fernandosegrr/fsi_proyect/docs/imagenes/foto_04_carro_perspectiva.jpg

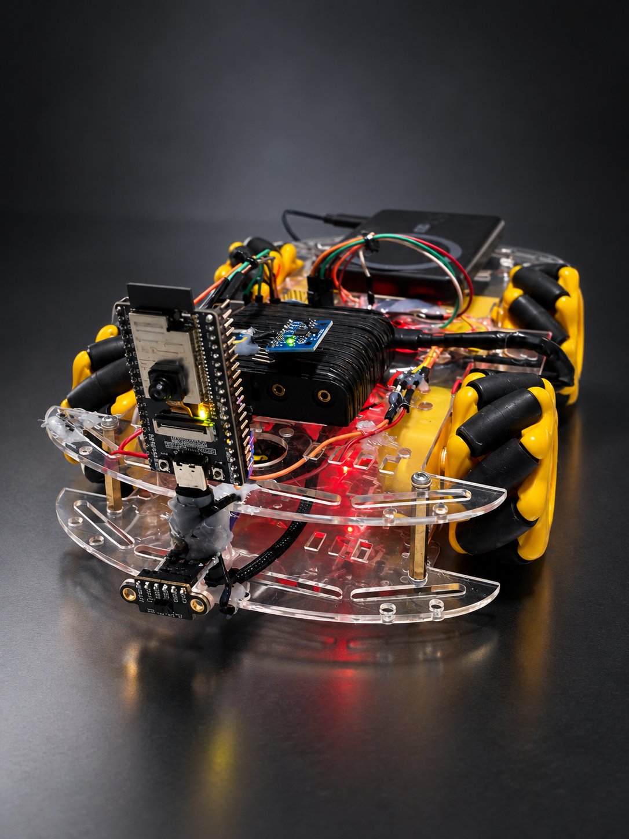
docs/imagenes/foto_04_carro_perspectiva.jpg
