fernandosegrr/fsi_proyect/docs/imagenes/foto_02_carro_lateral.jpg

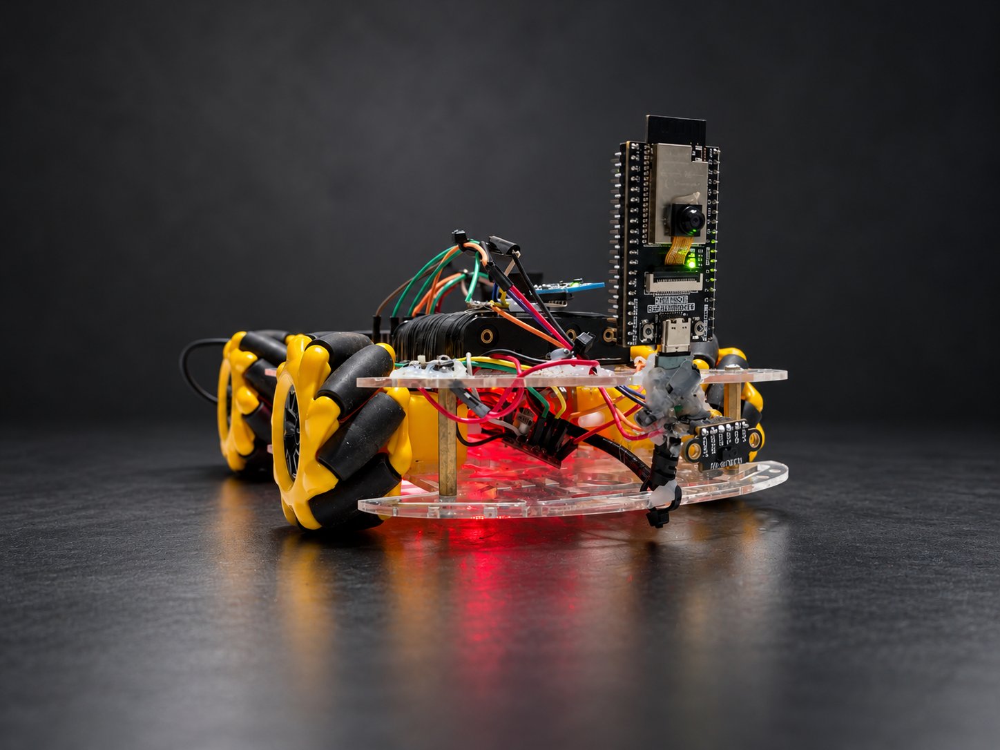
docs/imagenes/foto_02_carro_lateral.jpg
