fernandosegrr/fsi_proyect/docs/estado_20261113.md

# Estado al 14-nov-2026 — rama `feat/autonomo-v2`

**SIMULADO / NO MEDIDO en el carro.** El carro no se movió. No se instaló la APK ni se grabó firmware. `main` y el tag `v1.1` (`bd1727b`) no se tocaron. No es v1.2. (El archivo conserva el nombre del 13-nov, día en que se abrió; se actualizó el 14 con la revisión independiente.)

## Qué hay en la rama

| Commit | Contenido | Evidencia |
|---|---|---|
| `af3737b` | Banco con mundo sintético y compuertas | Pruebas en PC |
| `f959742` | Navegador v2: rodeo medido, mirada, vistazo, coincidencia con consenso | SIMULADO |
| `7323905` | Firmware del carro `SEG=2` | Compilado; pruebas en PC; **no grabado** |
| `afcc499` | Caja negra, telemetría numérica de visión, salud del detector | Compilado (APK); **no instalado** |
| `af786c7` | Firmware de la cámara `cam-v2` | Compilado; **no grabado** |
| `5d009e0` | Documentos, manual y protocolo de prueba física | — |
| `3bd9100` | Correcciones de la revisión independiente (2 altas, 3 medias, 3 bajas), dos escenarios nuevos y pruebas | SIMULADO (1000 corridas × 23 escenarios × 3 versiones) |
| siguiente | Estos documentos, tablas del banco y manual en PDF | — |

Documentos: [auditoría](auditoria_autonomo_v2.md), [diseño](autonomo_v2_diseno.md), [límites](limites_conocidos.md), [protocolo de prueba física](protocolo_prueba_fisica_autonomo_v2.md), [plantilla CSV](pruebas_fisicas_plantilla.csv).

## Verificación de software

| Comando | Resultado |
|---|---|
| `make -C nucleo_c test` | 24 ejecutables, 1884 casos, 0 fallos |
| `make -C pruebas_firmware test` | 564 casos, 0 fallos |
| `python probar_servidor_falso.py` (desde `pruebas_firmware/`) | 60 casos, 0 fallos |
| `python scripts/probar_version.py` | OK |
| `scripts/compilar_app.ps1` | COMPILACION OK |
| `arduino-cli compile --fqbn esp32:esp32:esp32 firmware_carro` | 1 034 526 bytes (78 %) |
| `arduino-cli compile --fqbn esp32:esp32:esp32wrover camara_prueba` | 1 084 349 bytes (82 %) |
| `python scripts/compuertas_autonomo.py --corridas 1000` | **19 compuertas en rojo** (abajo) |
| `python scripts/comparar_esquives.py --corridas 1000` | **4 de 6 en rojo** por 1 mm de media |

## Banco: antes y después (SIMULADO)

Tabla completa por escenario en el [diseño](autonomo_v2_diseno.md#5-resultados-riesgos-y-límites) y en [precision/autonomo_v2_comparacion.txt](precision/autonomo_v2_comparacion.txt).

- **Pasan con 1000 de 1000 y cero contactos (16 escenarios):** piso limpio, juntas, cambio de exposición y cajas inventadas por la red (sin una sola parada); manchas de sol, sombras y reflejos (sin esquives ni ayudas, con paradas momentáneas); caja 20 × 20, objeto de 90 cm, pared tras el final, **dos obstáculos**, pasillo, objeto que aparece, caja con sol, batería baja y **caja antes de una esquina**. Además, pared al frente: se detiene y pide ayuda con causa 16 en las 1000.
- **Mejoran pero no pasan:** caja corrida de lado (998, 2 contactos; partida 663 y 337), objeto bajo (997, 1 contacto; partida 990 y 4), banquito (765; partida 17), silla (316; partida 39).
- **Peor que la partida en algo:** contactos de la silla (34 contra 12); ayudas del banquito y de la silla (58 y 64 contra 0); caja con pared pegada a un lado (615 ok y 385 ayudas contra 632 y 210, pero 2 contactos contra 216); error lateral final del Monte Carlo heredado (18/44 contra 17/40 mm).

## Qué falta

- **VALIDAR EN EL CARRO**: todo. Empezar por el bloque A y B1 del protocolo.
- **PENDIENTE de diseño a código**: bloqueo de exposición de la cámara, aprendizaje continuo del piso, calibración fila–distancia, odometría fusionada, acelerómetro, giro fino por pulsos, mapa local. Razones en el diseño.
- **PENDIENTE en la app**: exponer las banderas de precaución y de vistazo; avisar cuando el umbral o las celdas de Visión dejan ciego al detector de color; mostrar el motivo cuando una ruta se cancela a mitad.
- **APAGADO tras probarlo**: deshacer el giro y rodear por el otro lado cuando el láser descubre una pared al empezar a girar (`NAV_DESHACER_GIRO_MAX`).
- **NO MEDIDO**: pivote izquierdo; campo, altura e inclinación de la cámara; alcance del láser contra una pared de lado; respuesta del control de rumbo a un cambio de 10–16°; si el láser ve el banquito y la silla reales; recall del detector con muebles vistos desde 11 cm de altura; deriva de la exposición de la cámara; si la cámara distingue una pared del piso; cuánto tarda en detenerse un giro cuando la guardia lo corta.
