fernandosegrr/fsi_proyect/docs/estado_20261110.md

# Diagnóstico de Estado del Repositorio — 10 de noviembre de 2026

## 1. Ubicación física, worktrees, ramas, tags y cambios sin confirmar

- **Directorio del repositorio:** `E:\Dev\fsi_proyecto` (la unidad indicada como `D:` en el encargo corresponde a `E:` en esta PC; `D:\Dev\fsi_proyecto` no existe).
- **Worktrees (`git worktree list`):** Único worktree activo en `E:/Dev/fsi_proyecto`.
- **Árbol de trabajo y stashes:** Árbol limpio (`nothing to commit, working tree clean`), cero stashes (`git stash list` vacío).
- **Estado de `HEAD` al iniciar la sesión:** Estaba en la rama local `main` (`c6ee161`), porque justo antes de iniciar (`HEAD@{0}` en reflog) se ejecutó `git checkout main` desde `j16-precision`. Para trabajar sobre el código auditado y modificado en J16 sin fusionar a `main`, se cambió a `j16-precision` (`6d1b213`).
- **Archivos locales excluidos en `.git/info/exclude`:**
  - `dist/firmware_carro_453ed20-20261027.bin` (1,031,712 bytes)
  - `dist/firmware_carro_873bfb9-20261031.bin` (1,034,112 bytes)
  - `firmware_carro/secretos.h` y `original_backup/` están en `.gitignore` y no se leen ni se tocan.
- **Etiquetas (`git tag`):**
  - `v1.0` → `eb88151` ("Entrega J14 - Carro FSI - 27 de octubre de 2026"). Intacta.
- **Ramas locales y remotas (`git branch -a -vv`):**
  - `j16-precision` (`6d1b213`, sincronizada con `origin/j16-precision`): contiene las 3 rondas de J16 (9 commits sobre `5d5c628`).
  - `main` local (`c6ee161`, 9 commits detrás de `origin/main` en `5d5c628`): contiene J15 (`deae8b6`) más fusiones de documentación e imágenes hasta `c6ee161`.
  - `origin/main` (`5d5c628`): contiene `c6ee161` más 9 commits adicionales de documentación (`docs/manual/*` y `docs/figuras/v2/*`).
  - Ramas de documentación (`docs/documentacion-completa` `1784804`, `docs/imagenes-manual` `c7ac702`, `docs/revision-imagenes` `4849fd7`, `origin/docs/manual-v2` `8cb1522`, `origin/docs/manual-referencia-archivos` `00e1415`): ya integradas en `origin/main` (`5d5c628`).
  - Ramas históricas previas a `v1.0`: `j14-seguridad-b2` (`8af8d08`), `j14-wip-20261027` (`af0bfb5`), `investigacion/comparativa-detectores` (`d638ed4`), `origin/copilot/fsi-proyect` (`7316383`).

### Historial de commits de J16 (`origin/main` `5d5c628` .. `j16-precision` `6d1b213`)

1. `d823a63` — J16: precisión de navegación (`RUMBO` en firmware, núcleo, app y simulador) [Ronda 1, código]
2. `3c9ebcf` — J16: entrega del candidato (APK `d823a63` en `dist`), plan de pruebas y documentación [Ronda 1, docs/dist]
3. `79ef808` — J16: registrar sanitizadores en verde y límite del objetivo de `RUMBO` [Ronda 1, cierre]
4. `097008d` — J16: segunda ronda (rumbo con décimas, aviso `WD`, enlace mudo, `TOF_PARO`, candado) [Ronda 2, código]
5. `0d1d4c1` — J16: entrega de la segunda ronda (APK `097008d` en `dist`, reporte y plan) [Ronda 2, docs/dist]
6. `b774c17` — J16: registrar el CI en verde de la segunda ronda [Ronda 2, cierre]
7. `873bfb9` — J16: corrección de escala del giroscopio (`IMU_ESCALA`) [Ronda 3, código]
8. `70fa4a5` — J16: entrega de la tercera ronda (APK `873bfb9` en `dist`, reporte y plan) [Ronda 3, docs/dist]
9. `6d1b213` — J16: registrar el CI en verde de la tercera ronda [Ronda 3, cierre]

---

## 2. Diff de lo cambiado contra J15 (`074c9fd`) y contra `main` (`c6ee161` / `origin/main` `5d5c628`)

Entre `074c9fd` (código de J15) y `origin/main` (`5d5c628`) **no hubo ningún cambio de código** en `nucleo_c/`, `firmware_carro/`, `app_android/`, `pruebas_firmware/` ni `scripts/`: solo se empaquetó la APK de J15 (`carro_fsi_0.4-074c9fd.apk`) y se agregaron manuales, figuras y documentos temáticos en `docs/` y `README.md`.
Entre `main` local (`c6ee161`) y `origin/main` (`5d5c628`) solo cambiaron 46 archivos de documentación (`docs/manual/*`, `docs/figuras/v2/*`, `LICENSE`, `README.md`, `docs/README.md`).

Todos los cambios funcionales de J16 están entre `origin/main` (`5d5c628`) y `j16-precision` (`6d1b213`), abarcando **64 archivos (+4086 / -136 líneas)**. Resumen archivo por archivo por subsistema:

### 2.1 Núcleo en C (`nucleo_c/`)
- `nucleo_c/navegador.h` (+45/-1):
  - Sube `NAV_PASO_MARGEN_MM` de 100 a 150 mm (conserva `NAV_PASO_MARGEN_J15_MM = 100` bajo bandera `sin_margen_paso_j16`).
  - Define constantes para `RUMBO` del firmware (`NAV_RUMBO_MIRA_MM = 400`, `NAV_RUMBO_MIRA_MIN_MM = 150`, `NAV_RUMBO_CORR_MAX = 12`, `NAV_RUMBO_FW_SIN_GIRO = 8`, `NAV_RUMBO_FW_CAMBIO_X10 = 3`, `NAV_RUMBO_FW_MIN_MS = 100`, `NAV_RUMBO_PUNTO_MIN_MM = 150`, `NAV_OVERRIDE_TOL_MM = 30`).
  - Añade campos a `Navegador`: `rumbo_x10`, `base_rumbo_x10`, estado y objetivos de `rumbo_fw`, geometría de línea del paso actual (`paso_en_linea`, `linea_ax_mm`, `linea_ay_mm`, `linea_rumbo`, `linea_fin_s_mm`, `paso_apunta`, `paso_fin_x_mm`, `paso_fin_y_mm`), banderas de prueba/reversión (`sin_volver_a_linea`, `rumbo_en_vuelta`, `sin_margen_paso_j16`, `sin_trig_fino`, `sin_arreglo_dt_giro`) y `descartar_dt`.
  - Declara `navegador_poner_rumbo_fw` y `navegador_tomar_rumbo_fw`.
- `nucleo_c/navegador.c` (+367/-15):
  - Trigonometría e inversa con décimas de grado (`seno_mil_x10`, `dir_x_mil_x10`, `dir_y_mil_x10`, `grados_de_cociente_x10`, `rumbo_del_vector_x10`).
  - `calcular_avance_medido`: proyecta incrementos con décimas de grado (`dir_*_mil_x10`) salvo `sin_trig_fino = 1`, y actualiza `rumbo_x10`.
  - `respetar_grados`, `sincronizar_rumbo`, `rumbo_tras_giro_x10`: con `RUMBO` activo conserva `rumbo_x10` (décimas, 0..3599) entre comandos y redondea `rumbo_grados`; sin `RUMBO` mantiene grados enteros como en J15.
  - `planificar`: corrige recta con `override_largo_mm > 0` para que no termine prematuramente al replanificar con `indice_objetivo > 1` tras un esquive, suma `cal.frenado_mm` si viene avanzando, salta puntos de ruta ya pasados, recorta `avance_mm` al largo fijo restante y con rumbo medido planifica celda por celda. Con `RUMBO` activo suprime giros parados de corrección menores o iguales a `NAV_RUMBO_FW_SIN_GIRO` (8°).
  - `calcular_fin_obstaculo`: usa `NAV_PASO_MARGEN_MM` (150 mm) salvo `sin_margen_paso_j16`.
  - `rumbo_deseado_x10` y `rumbo_fw_actualizar`: calcula el objetivo `RUMBO:<n>` (apuntando 400 mm adelante sobre la línea con tope de ±12°, o al punto final en diagonal, o paralelo a la línea en `NAV_FASE_PARALELO`) y lo convierte a la convención del firmware (`+` izquierda).
  - `navegador_aporte_giro` y `navegador_aporte_imu`: activan `descartar_dt = 1` cuando un giro por ángulo cae a giro por tiempo entre dos ticks, evitando sumar un `dt` en que el carro estuvo quieto.
- `nucleo_c/calgiro.h` (+16) y `nucleo_c/calgiro.c` (+28):
  - Añaden `calgiro_escala(medido_x10, escala_ppm, &vueltas, &error_ppm, &nueva_ppm)` para calcular la corrección de escala del giroscopio en ppm a partir de vueltas completas alineadas con una línea, compuesta con la escala previa y acotada a ±50,000 ppm (±5 %).
- `nucleo_c/simulador_navegador.h` (+50) y `nucleo_c/simulador_navegador.c` (+299/-14):
  - Añaden el modelo físico J16 (`sim_j16_activar`): arranque a plena potencia 255/255 por 250 ms, zona muerta de PWM, constante de tiempo de motor (`j16_tau_motor_ms`), integración en pasos de 10 ms con centésimas de grado, réplica exacta de `rumbo.c`, escala del giroscopio en `%` y `ppm`, sesgo residual en mdps, latencia de `SENS` y cola de latencia de comandos.
  - Corrigen reinicio de desplazamiento de pivote entre dos `GIRAR` seguidos y retención de `LEFT`/`RIGHT` en el tick en que `IMU?` cae a giro por tiempo.
- `nucleo_c/Makefile` (+15/-3):
  - Agrega el ejecutable `pruebas_precision_j16` a `all` y `test` (150 corridas) y el target `make precision` (1000 corridas).

### 2.2 Firmware del carro (`firmware_carro/`)
- `firmware_carro/rumbo.h` (+68, nuevo) y `firmware_carro/rumbo.c` (+172, nuevo):
  - Controlador PI en enteros de 32/64 bits para sostener el rumbo al avanzar (`rumbo_iniciar`, `rumbo_empezar`, `rumbo_terminar`, `rumbo_poner_objetivo`, `rumbo_corregir`, `rumbo_repartir`, `rumbo_leer_numero`).
  - Recorta objetivo a ±20.0° del ángulo inicial del avance, se inhibe si `|error| > 30.0°`, aplica anti-windup al término integral y conserva el término integral aprendido (`aprendido_mil`) entre avances en RAM.
- `firmware_carro/config.h` (+21):
  - Define `IMU_ESCALA_MAX_PPM = 50000`, constantes `RUMBO_KP_MIL_GRADO = 10`, `RUMBO_TI_MS = 1500`, `RUMBO_MAX_MIL = 150`, `RUMBO_MAX_OBJETIVO_X10 = 200`, `RUMBO_ERROR_MAX_X10 = 300`, `RUMBO_DT_MAX_MS = 50` y `GIRO_LARGO_POR_GRADO = 1`.
- `firmware_carro/carro.h` (+2) y `firmware_carro/carro.c` (+125/-2):
  - Integra `rumbo` en `avanzar`, `retroceder`, `girar_izquierda`, `girar_derecha`, `carro_pivote`, `carro_detener` y `carro_vigilar_comunicacion`.
  - Procesa `RUMBO:ON` (`ACK_RUMBO:1`), `RUMBO:OFF` (`ACK_RUMBO:0`), `RUMBO:<n>` (sin respuesta) y `RUMBO?` (`RUMBO:<enc>,<marcha>,<obj>,<corr>,<apr>`), sin renovar el watchdog ni alterar `comando_actual`.
  - Apaga `RUMBO` al arrancar y al conectar/desconectar cliente (`rumbo_apagar_al_conectar`), pero no cuando el láser frena con `__STOP_AUTO`.
  - Lleva cuenta de frenadas por watchdog en `frenos_watchdog` (`carro_frenos_watchdog()`).
- `firmware_carro/giro.c` (+19/-7):
  - Con `GIRO_LARGO_POR_GRADO = 1`, normaliza la duración del giro en ms por cada 100° y solo evalúa/guarda en el historial de `giro_largo` los giros de al menos `GIRO_ANT_MIN_GRADOS` (30°).
- `firmware_carro/imu.h` (+5) y `firmware_carro/imu.c` (+31/-1):
  - Añaden `escala_ppm` (`imu_poner_escala_ppm`, `imu_escala_ppm`) y escalan la velocidad angular sin sesgo ni zona muerta por `(1000000 + escala_ppm) / 1000000` con redondeo al entero más cercano antes de integrar el ángulo y calcular `velocidad_x10`.
- `firmware_carro/hw_sensores.h` (+4) y `firmware_carro/firmware_carro.ino` (+19):
  - Declaran e implementan `hw_imu_escala_leer` y `hw_imu_escala_guardar` en NVS (`Preferences` namespace `"carro"`, clave `"imuEscala"`).
- `firmware_carro/sensores.h` (+3) y `firmware_carro/sensores.c` (+52/-3):
  - `CAPS` incluye `RUMBO=1,IMUS=<ppm>`.
  - `sensores_iniciar` lee `imuEscala` de NVS y la aplica si está en `[-50000, 50000]`.
  - `revisar_watchdog` envía `WD:<n>` por WebSocket y serie cada vez que `carro_frenos_watchdog()` incrementa.
  - Atiende `IMU_ESCALA?` (`IMU_ESCALA:<ppm>`) e `IMU_ESCALA:<ppm>` (`ACK_IMU_ESCALA:<ppm>` y reenvío de `CAPS`, o `NAK_IMU_ESCALA` si está fuera de rango, en marcha o girando).

### 2.3 App Android y puente JNI (`app_android/`)
- `app_android/app/src/main/cpp/puente.c` (+77/-5):
  - Protege `ultimo_*`, `ultimo_no_piso`, `mascara_vision_global` y `mascara_vision_activa` con `pthread_mutex_t candado_vision`.
  - Guarda `largo_recta_global` y `rumbo_fw_global` y los reaplica en `cargarRuta` después de `navegador_iniciar` (corrige pérdida del largo de 1500 mm en «Recta 150 cm»).
  - Añade funciones JNI `CalGiroNativa.escala`, `NavegadorNativa.ponerRumboFw` y `NavegadorNativa.tomarRumboFw`.
- `app_android/app/src/main/java/com/fsi/carro/Ajustes.kt` (+7/-1) y `SesionCarro.kt` (+1):
  - Añaden preferencia `usarRumbo` (`"usar_rumbo_fw"`, `true` por defecto) y la sincronizan con `ControlLogica`.
- `app_android/app/src/main/java/com/fsi/carro/CalGiroNativa.kt` (+14) y `NavegadorNativa.kt` (+8):
  - Declaraciones `external` de `escala`, `ponerRumboFw` y `tomarRumboFw`.
- `app_android/app/src/main/java/com/fsi/carro/CalibracionGuardada.kt` (+6/-2), `EjecutarRutaFragment.kt` (+9/-2) y `Mensajes.kt` (+6):
  - `aplicarAlNavegador()` devuelve `Boolean`; si el navegador rechaza la calibración guardada, `EjecutarRutaFragment` muestra el aviso `Mensajes.calibracionRechazada()` al pasar a `CONFIRMAR`.
- `app_android/app/src/main/java/com/fsi/carro/ControlLogica.kt` (+126/-5):
  - Lee `RUMBO=1` e `IMUS=<ppm>` de `CAPS:`.
  - Añade `rumbo()`, `rumboObjetivo()`, `pedirRumbo()` y `enviarEscalaImu()` (con timeout y confirmación por `ACK_IMU_ESCALA:<ppm>`).
  - En `TOF_PARO:`, si `CORTAR_HEARTBEAT_EN_TOF_PARO` es `true` y `comandoActivo == "FORWARD"`, detiene el heartbeat y limpia `comandoActivo`.
  - Procesa `WD:<n>`, `ACK_RUMBO:`, `RUMBO:`, `ACK_IMU_ESCALA:`, `IMU_ESCALA:` y `NAK_IMU_ESCALA`.
  - En `IMU:`, solo invoca `alImu` si el estado del giroscopio (campo 2) es `null` o `2` (listo).
- `app_android/app/src/main/java/com/fsi/carro/ModoSemiautonomo.kt` (+73/-8):
  - Reconoce rutas predefinidas verificando `it.celdas.contentEquals(ruta)` además del nombre/id.
  - Activa `RUMBO:ON` al iniciar ruta si `logica.rumboActivo` y envía objetivos `RUMBO:<n>` tras cada comando; al terminar o cancelar pide `RUMBO?` y envía `RUMBO:OFF`.
  - Con `VIGILAR_CARRO_J16 = true`, cancela la ruta si pasan más de `SILENCIO_SENS_MS` (1500 ms) sin `SENS` (cuando `capsGiroscopio != null`), si llega `WD:<n>`, o si tras `TOF_PARO` el navegador sigue pidiendo `CMD_FORWARD`.
  - Mueve `registrarEsquive()` y `registrarDiagnostico()` para ejecutarse después de enviar el comando del tick.
- `app_android/app/src/main/java/com/fsi/carro/SensoresActivity.kt` (+169/-3), `res/layout/activity_sensores.xml` (+96) y `res/values/textos_sensores.xml` (+9):
  - Añaden interruptor «Sostener el rumbo al avanzar (firmware J16)», línea de estado de `RUMBO` y tarjeta «Escala del giroscopio (J16)» con flujo de 3 pasos (Empezar con verificación de carro quieto en 400 ms, Terminé tras vueltas completas en menos de 2 min, Guardar en el carro y Quitar la corrección).

### 2.4 Pruebas, scripts, CI y `dist/`
- `nucleo_c/pruebas_calgiro.c` (+39): 11 casos nuevos para `calgiro_escala` (incluyendo propiedad de 20,000 casos aleatorios).
- `nucleo_c/pruebas_precision_j16.c` (+782, nuevo): Parte A (réplica de `RUMBO` vs `firmware_carro/rumbo.c`, 3 casos), Parte B (8 propiedades de pose con 9 casos), Parte C (Monte Carlo en 10 escenarios × 5 configuraciones y 34 comprobaciones de no regresión / mejora; total 46 casos).
- `pruebas_firmware/pruebas_rumbo.c` (+479, nuevo) y `pruebas_firmware/Makefile` (+13/-4): 62 casos del controlador `rumbo.c`, su integración con `carro.c` y el filtro `giro_largo`.
- `pruebas_firmware/pruebas_sensores.c` (+144/-6), `sensores_falsos.c` (+6), `sensores_falsos.h` (+2): 6 casos del aviso `WD:<n>`, 25 casos de `IMU_ESCALA` y actualización de 3 casos de `CAPS?`.
- `pruebas_firmware/pruebas_carro.c` (+16/-5): corrige condición de carrera del arnés en `prueba_estres_dos_hilos` (espera 2 vueltas completas de `loop()` en `paso_a_paso` y `GIRO_ASENTAR_MS / 50 + 5` vueltas al cierre).
- `pruebas_firmware/servidor_falso.py` (+40/-5) y `probar_servidor_falso.py` (+24/-1): soporte para `WD:<n>`, `IMUS`, `IMU_ESCALA`, `IMU_ESCALA?` y `SIM_ANGULO` con `--sensores` (8 casos nuevos: de 46 a 54).
- `scripts/verificar_version.py` (+39) y `scripts/probar_version.py` (+53): modo `--solo-archivo` sin teléfono ni puerto serie y 5 pruebas unitarias nuevas (de 13 a 18).
- `.github/workflows/sanitizadores.yml` (+15/-2): añade `rumbo.c` a los pasos existentes y agrega pasos ASan+UBSan para `pruebas_rumbo` y `pruebas_precision_j16 300`.
- `dist/`: reemplaza `carro_fsi_0.4-074c9fd.apk` por `carro_fsi_0.4-873bfb9.apk` (14,520,520 bytes, SHA-256 `50179013BCB18029F6C1BCBFE737F59A9B14B49B7BE848E002D67C119433C15B`) y actualiza `SHA256SUMS.txt`, `LEEME.txt`, `README.md` y `FIRMWARE_LOCAL.txt`.

---

## 3. Qué se declaró hecho, qué evidencia hay y qué NO tiene evidencia

### 3.1 Declarado hecho CON evidencia documental/código en el repositorio (por re-ejecutar y verificar en Fase 2 y 3)
1. **Correcciones e implementaciones en código (`d823a63`, `097008d`, `873bfb9`):**
   - `RUMBO` en firmware y núcleo, `rumbo_x10` continuo con `RUMBO`, `IMU_ESCALA` en firmware/núcleo/app, arreglo de largo fijo de «Recta 150 cm» en JNI y `planificar`, holgura de paso de 150 mm, `descartar_dt` al caer a giro por tiempo, filtro `giro_largo` por grado, `WD:<n>`, corte de heartbeat en `TOF_PARO`, vigilancia de enlace mudo (`1.5 s` sin `SENS`), candado `candado_vision` en `puente.c`.
   - **Evidencia:** commits en `j16-precision`, pruebas unitarias en `nucleo_c/` (declarados 22 programas / 1655 casos) y `pruebas_firmware/` (declarados 540 casos), `probar_servidor_falso.py` (54 casos), `probar_version.py` (18 casos), registros en `docs/precision/monte_carlo_1000.txt` y `docs/precision/calibracion_j14.txt`.
2. **Compilación local de artefactos candidatos de la 3ª ronda (`873bfb9`):**
   - APK `dist/carro_fsi_0.4-873bfb9.apk` (14,520,520 bytes) y binario local no publicado `dist/firmware_carro_873bfb9-20261031.bin` (1,034,112 bytes).
   - **Evidencia:** archivos presentes en `dist/` (se verificará su compilación limpia y hashes en Fase 3).
3. **Corrección documental sobre la ruta en L de J14:**
   - La ruta en L predefinida (`RutasPredefinidas.kt`) termina en `(7,1)`, que corresponde a `y = 200 mm`, por lo que las poses estimadas de J14 B5 (`y = 209, 203, 244 mm`) tenían un error estimado respecto de su línea de `9, 3 y 44 mm`, no de `20 a 24 cm`.
   - **Evidencia:** verificado en el código de `RutasPredefinidas.kt` y `pruebas_precision_j16.c`.

### 3.2 Afirmaciones SIN evidencia física o NO probadas todavía
1. **Mejora real de precisión en el carro físico con `RUMBO`, `rumbo_x10`, `IMU_ESCALA` y holgura de 150 mm:**
   - **Sin evidencia física (`NO MEDIDO`):** Todos los números de precisión de J15 y J16 provienen exclusivamente del simulador en PC (`SIMULADO`). Las ganancias `RUMBO_KP_MIL_GRADO = 10` y `RUMBO_TI_MS = 1500` nunca se han probado con los motores reales ni en el piso real; no se sabe si zigzaguean o si el deslizamiento lateral mecanum domina.
2. **Calibración de escala del giroscopio (`IMU_ESCALA`) y su supuesto de ±0.3 % de residuo:**
   - **Sin evidencia física (`NO MEDIDO`):** El residuo de ±3000 ppm (±0.3 %) tras alinear el carro a mano antes y después de dos vueltas completas es un supuesto del simulador, no una medición en pista. Tampoco se ha probado la tarjeta «Escala del giroscopio» en el teléfono conectado al carro.
3. **Calibración del simulador J16 contra el carro real:**
   - **Evidencia parcial / limitada:** El desbalance del simulador (0.3 % a 2.1 %) se ajustó con solo 4 rectas medidas en J14 (B4: 5.5, 15, 18 y 20 cm) y 1 corrida de esquive medida a ojo (B6-4: ~40 cm, que cae en el percentil 99 del simulador). La dispersión del pivote (±15 %) y el error de escala inicial (±1 %) son supuestos no medidos.
4. **Error físico real de la ruta en L (B5):**
   - **Sin evidencia numérica (`NO MEDIDO`):** En J14 B5 no se midió con cinta la posición final del carro (solo hubo apreciación visual «relativamente bien» y registro de la pose estimada por el navegador).
5. **Validación en el teléfono y en la ESP32 del código J16 (`873bfb9`):**
   - **Sin evidencia en hardware (`NO MEDIDO`):** Ni el firmware `FW:873bfb9-20261031` se ha cargado en la ESP32 ni la APK `APP:0.4-873bfb9` se ha instalado o ejecutado en el teléfono. Tampoco existen pruebas instrumentadas de UI en Kotlin para las nuevas funciones de `SensoresActivity`, `EjecutarRutaFragment`, `ModoSemiautonomo` y `ControlLogica`.
6. **Pruebas físicas pendientes desde J14/J15/J16:**
   - Esquive B6 con criterio 5/6 sin tocar caja y error lateral < 25 cm: **NO MEDIDO** (en J15 y J16 se hicieron 0 corridas físicas).
   - B7 (comparación pareada de autoridad del láser a ~100 cm), B8 (caja lateral a 25 cm), B9 (corte de WiFi en marcha), B2 (calibración del giro con giroscopio en el carro), J10c con caja ancha real (40×20 cm), y el plan P0–P12 de J16 (`docs/precision/plan_pruebas.md`): **NO MEDIDOS**.

---

## 7. Lista consolidada de pruebas físicas pendientes (ordenadas de menor a mayor riesgo)

Consolidada a partir de `docs/precision/plan_pruebas.md`, `docs/reporte_J13.md`, `docs/reporte_J14.md`, `docs/reporte_J15.md`, `docs/reporte_J16.md`, `docs/bitacora.md` y `docs/limites_conocidos.md`:

1. **P0 / P2 / B0 — Verificación en `Sensores` con carro conectado por WiFi (Riesgo: Nulo, sin movimiento)**
   - **Qué se prueba:** Con la ESP32 alimentada por powerbank y el teléfono en la red `CarroFSI`, comprobar en `Sensores`: `FW:6d1b213-20261110`, `App 0.4 (6d1b213)`, `CAPS` con `RUMBO=1` e `IMUS=0`, giroscopio `LISTA`, láser `LISTO`, `Autoridad del láser` encendida, interruptor `Sostener el rumbo al avanzar` encendido y `Corrección en uso: +0 ppm`.
   - **Criterio:** Versiones coincidentes, ambos sensores listos y `RUMBO=1`.

2. **P6 — Escala del giroscopio a mano y bloques de 4 giros de 90° en el lugar (Riesgo: Muy bajo)**
   - **Qué se prueba:** (a) En la tarjeta `Escala del giroscopio` de `Sensores`, medir 3 veces sin guardar (2 vueltas completas a mano en el piso sin levantar el carro, alineando con la cinta al inicio y al final) y en la 4.ª guardar (`IMU_ESCALA`). (b) Ejecutar en `Sensores` un bloque de 4 giros de `90°` a la izquierda y otro de 4 giros de `90°` a la derecha (`360°` por bloque) antes y después de guardar la escala.
   - **Criterio:** Las 3 mediciones dentro de `±3000 ppm` entre sí; `CAPS` reporta `IMUS=<ppm>`; tras cada bloque de 4 giros el carro queda paralelo a la cinta dentro de `±2°` (o `±3°` por giro).

3. **P3 — Primera recta corta de 100 cm con `RUMBO` (Riesgo: Bajo)**
   - **Qué se prueba:** Ruta `Recta 100 cm` (`recta_100`) con `Sostener el rumbo al avanzar` encendido, 2 corridas en pista despejada.
   - **Criterio:** Sin zigzag visible ni tirones, y desvío lateral final `< 5 cm` (simulación: media `0.8 cm`, p95 `1.9 cm`, máx `2.7 cm`).

4. **P1 / P4 — Recta de 150 cm y comparación pareada con y sin `RUMBO` (Riesgo: Bajo)**
   - **Qué se prueba:** Ruta `Recta 150 cm` (`recta_150`), alternando `Sostener el rumbo al avanzar` APAGADO y ENCENDIDO (5 corridas apagado y 5 encendido con las mismas pilas; las corridas con `RUMBO` apagado cubren también P1).
   - **Criterio:** Largo medio entre `145` y `155 cm` (verifica que ya no recorre los `160 cm` de J14); con `RUMBO` encendido, desvío lateral medio `≤ 6 cm`, ninguno `> 10 cm`, y media con `RUMBO` a la mitad o menos que sin `RUMBO` (simulación: sin `RUMBO` `7.4 cm` media; con `RUMBO` `1.0 cm` media, p95 `2.6 cm`).

5. **P5 — Recta larga de 200 cm con `RUMBO` sin obstáculo (Riesgo: Bajo-medio)**
   - **Qué se prueba:** Ruta `Recta 200 cm` (`recta_200`) sin caja en pista despejada con `RUMBO` encendido, 3 corridas (sirve también como línea base previa de 200 cm de J15).
   - **Criterio:** Desvío lateral final `≤ 8 cm` (simulación: media `1.4 cm`, p95 `3.3 cm`, máx `4.9 cm`).

6. **P7 / B5 — Ruta en L (`100 cm` + giro `90°` derecha + `100 cm`) medida con cinta (Riesgo: Medio)**
   - **Qué se prueba:** Ruta `En L (derecha)` (`en_l`), 3 corridas con `RUMBO` encendido (y opcionalmente 3 sin `RUMBO`), midiendo con cinta la distancia real al segundo tramo (`y = 20 cm`) y al punto final `(80, 20) cm`.
   - **Criterio:** Con `RUMBO`, distancia del centro al punto final `≤ 8 cm` (simulación con escala calibrada: media `3.4 cm`, p95 `6.8 cm`).

7. **P8 — Cuadrado cerrado de 60 cm por lado (Riesgo: Medio)**
   - **Qué se prueba:** Ruta dibujada en el editor de `(2,6)` a `(2,3)`, `(5,3)`, `(5,6)` y regreso a `(2,6)` (4 tramos de `60 cm` y 3 giros de `90°`), 3 corridas con `RUMBO`.
   - **Criterio:** Distancia del centro al punto de salida `≤ 10 cm` (simulación con escala calibrada: media `2.1 cm`, p95 `4.3 cm`).

8. **B8 — Caja lateral a 25 cm fuera del carril (Riesgo: Medio)**
   - **Qué se prueba:** Recta con la caja colocada a `25 cm` a un lado del eje de la cinta (fuera del paso físico del chasis), con `Autoridad del láser` encendida y apagada.
   - **Criterio:** `0` toques, `0` falsos paros por láser y `0` esquivas innecesarias.

9. **P12 (opcional) — Freno del láser ante caja frontal a 60 cm (Riesgo: Medio-alto)**
   - **Qué se prueba:** Ruta `Recta 100 cm` con una caja centrada a `60 cm` de la salida y el láser activo.
   - **Criterio:** El carro frena o esquiva sin tirones; el registro muestra `TOF_PARO` seguido de la decisión del navegador y ningún `FORWARD` repetido tras el freno.

10. **B6 / P9 / B7 — Esquive con caja de 20×20 cm a ~100 cm en `Recta 200 cm` (Riesgo: Medio-alto)**
    - **Qué se prueba:** Ruta `Recta 200 cm` (`recta_200`) con caja de `20×20 cm` centrada en la cinta a `~100 cm` de la marca de salida:
      - **B6 (criterio mínimo de validación J15):** Al menos **5 de 6 corridas** sin tocar la caja y con error lateral final **menor a 25 cm**.
      - **P9 (criterio J16 con `RUMBO`):** 5 corridas con `RUMBO` encendido (más 2 sin `RUMBO` para comparar), buscando `0` toques, `0` ayudas y desvío lateral final `≤ 8 cm` (simulación: media `1.7 cm`, p95 `4.0 cm`, máx `6.3 cm`).
      - **B7 (comparación pareada de Autoridad del láser a ~100 cm):** Comparar 3 corridas con Autoridad del láser encendida frente a 3 con Autoridad apagada.

11. **J10c / P10 — Esquive con caja ancha de 40×20 cm a ~100 cm en `Recta 200 cm` (Riesgo: Alto)**
    - **Qué se prueba:** Ruta `Recta 200 cm` con caja ancha de `40×20 cm` colocada de `x = -10 cm` a `+30 cm` respecto de la cinta a `~100 cm` de la salida, 3 corridas con `RUMBO`. Evalúa tanto la regla de segundo color de piso de J10c (que no aprenda la caja ancha lejana como piso) como el rodeo de un obstáculo más ancho (P10).
    - **Criterio:** No se absorbe como piso en el aprendizaje; `0` toques y desvío lateral final `≤ 8 cm` (o `< 25 cm`).

12. **B9 / P11 — Corte de WiFi en plena recta con `RUMBO` (Riesgo: Alto)**
    - **Qué se prueba:** Iniciar una recta con `RUMBO` y cortar el WiFi del teléfono `1 s` después de empezar a avanzar (`svc wifi disable` durante `3 s` y luego `svc wifi enable`).
    - **Criterio:** El carro se detiene por el watchdog del firmware (`1000 ms`, `~20 cm`), la app cancela la ruta por falta de datos (`> 1.5 s`) o aviso `WD`, y al reconectar el WiFi el carro **no** vuelve a arrancar solo y `RUMBO` queda apagado.

13. **B2 — Calibración automática del giro con giroscopio en 8 giros (Riesgo: Muy alto)**
    - **Qué se prueba:** Secuencia automática de 8 giros alternados (`40°/40°/40°/40°/70°/70°/100°/100°`) en la pantalla de calibración con giroscopio (requiere área despejada de `2 m × 2 m` porque el desplazamiento acumulado del pivote mueve el centro hasta `~98 cm`).
    - **Criterio:** Ningún giro se desvía más de `±25°`, no sale del área y produce `ms/grado` dentro de `3..20` con puntos consistentes.

---

## 8. Resultados de las pruebas realizadas el 10 de noviembre de 2026 (MEDIDO EN EL CARRO)

Registro detallado en `docs/pruebas_fisicas_20261110.csv`:

1. **Verificación previa en `Sensores` y por USB serie (P0 / P2 / B0 — MEDIDO EN EL CARRO: PASA)**
   - **Firmware previo en la ESP32 (`COM6`):** `FW:453ed20-20261027` (`CAPS:IMU=1,TOF=1,TOFR=0,IMUR=0,IMUM=0,IMUE=2,FW:453ed20-20261027`).
   - **Firmware cargado desde `HEAD` (`6d1b213`):** `FW:6d1b213-20261110` (`1,034,112` bytes, SHA-256 `71D671A4E64E0F234015E8685D4E741B87471534E3E50869EE023C5A657B79FC`). Consultas serie en reposo: `CAPS:IMU=1,TOF=1,TOFR=1,IMUR=0,IMUM=0,IMUE=2,RUMBO=1,IMUS=0,FW:6d1b213-20261110`, `IMU:0,-44,2,104,0`, `TOF:1200,1`, `IMU_ESCALA:0`, `ANT:114,191,20,20`, `LOOP:12936,1`, `I2C:29 68`.
   - **APK previa en el teléfono (`K5J0220320019510`):** `APP:0.4-074c9fd` (`versionName=0.4`, `versionCode=3`).
   - **APK instalada con `adb install -r`:** `APP:0.4-6d1b213` (`14,881,402` bytes, SHA-256 `C5B36FEC74BFEDE9798B4BE7C992D7FEA8369F456DA4D4A10D61A4BBB25ED02F`), verificada bit a bit contra el teléfono (`APK idéntica al build=True`).
   - **Conexión WiFi carro-teléfono:** `SENS_DIAG` reportó `CAPS:IMU=1,TOF=1,TOFR=0,IMUR=1,IMUM=0,IMUE=2,RUMBO=1,IMUS=0,FW:6d1b213-20261110`, con los 4 interruptores encendidos (`usar_giroscopio=true`, `usar_sensor_distancia=true`, `autoridad_laser=true`, `usar_rumbo_fw=true`).

2. **Esquive B6 en `Recta 200 cm` con caja a ~100 cm y todo habilitado (VALIDADO EN EL CARRO: PASA 5/6)**
   - **Corrida 1 (21:31):** `16 s`, `Punto 10 de 10`, `1` esquiva limpia (`4/4` giros por giroscopio: der `90°→91°`, izq `90°→89°`, vuelta izq `71°→71°`, vuelta der `65°→64°`), `rumbo_objetivos_enviados=15`, `aprendido_mil=+28`. Pose estimada `(394, -4, 357°)`. **Físico:** sin tocar caja, `~10 cm` a la derecha (medida aproximada), alineado.
   - **Corrida 2 (21:33):** `18 s`, `Punto 10 de 10`, `1` esquiva limpia (`5` giros por giroscopio y `1` ajuste de `4°` por tiempo que giró `18°` y fue corregido por un giro izquierdo de `14°→17°` con giroscopio), `rumbo_objetivos_enviados=7`, `aprendido_mil=-13`. Pose estimada `(383, 8, 0°)`. **Físico:** sin tocar caja, `~10 cm` a la derecha (medida aproximada), alineado.
   - **Corrida 3 (21:35):** `16 s`, `Punto 10 de 10`, `1` esquiva limpia (`4` giros por giroscopio y `1` ajuste de `4°→5°` por tiempo), `rumbo_objetivos_enviados=16`, `aprendido_mil=-13`. Pose estimada `(401, 1, 2°)`. **Físico:** sin tocar caja, `~5 cm` a la derecha (medida aproximada) con leve inclinación a la derecha.
   - **Corrida 4 (21:38):** `18 s`, `Punto 10 de 10`, `1` esquiva limpia (`5/5` giros por giroscopio: `90°→90°`, `90°→90°`, `86°→85°`, `85°→90°`, `6°→8°`), `rumbo_objetivos_enviados=16`, `aprendido_mil=-8`. Pose estimada `(401, 10, 356°)`. **Físico:** sin tocar caja, `~0 cm` (medida aproximada, sobre la recta).
   - **Corrida 5 (21:41):** En `Punto 4 de 10` (`y≈110 cm`) entró en `AYUDA` («Necesito ayuda: toma el control») sin tocar la caja y sin causa identificada pese a tener espacio libre a los lados; tras usar la cruceta de ayuda y «Continuar la ruta», venció el tope de `60 s` del arnés de prueba (`rumbo_objetivos_enviados=5`, `aprendido_mil=+16`). **Físico:** sin tocar caja, no completó de forma autónoma.
   - **Corrida 6 (21:43):** `18 s`, `Punto 10 de 10`, `1` esquiva limpia (`5/5` giros por giroscopio: `90°→93°`, `90°→91°`, `89°→92°`, `85°→85°`, `5°→6°`), `rumbo_objetivos_enviados=6`, `aprendido_mil=+6`, `ANT` final `109,168,20,20`. Pose estimada `(386, -8, 1°)`. **Físico:** sin tocar caja, `~0 cm` (medida aproximada, sobre la recta).
   - **Balance global B6:** **6 de 6 sin tocar la caja** y **5 de 6 completadas de forma autónoma con error lateral aproximado de `~0 a 10 cm`** (`~10, ~10, ~5, ~0, ~0 cm`, medido aproximadamente respecto de la línea; media `~5.0 cm`, máximo `~10.0 cm`), cumpliendo el criterio de validación B6 (al menos `5 de 6` sin tocar la caja y con error lateral `< 25 cm`).
   - **Qué permanece SIMULADO o NO MEDIDO en el carro:** El resto de escenarios (rectas despejadas de 100, 150 y 200 cm con y sin control de rumbo, ruta en L B5/P7, cuadrado cerrado P8, corte de WiFi en marcha B9/P11, freno por láser aislado P12, caja ancha J10c/P10, calibración automática del giro B2, calibración manual de escala del giroscopio P6, comparación pareada de autoridad del láser B7 y caja lateral a 25 cm B8) queda **SIMULADO** o **NO MEDIDO** en el carro.
