fernandosegrr/fsi_proyect/docs/sensores.md

# Sensores: giroscopio MPU6050 y láser VL53L0X (J11)

## Estado (17 oct 2026)

- **Código y pruebas de PC: hechos** (Fase A). `imu.c`, `tof.c`, `giro.c`, `sensores.c` son C puro; el `.ino` solo pone el bus I2C.
- **Hardware: los dos módulos funcionan** (comprobado por USB con el DevKit en COM6, tras corregir el cableado):
  - Escaneo del bus: `0x29` (láser) y `0x68` (giroscopio).
  - **MPU6050:** WHO_AM_I = `0x68` (original, no clon), sesgo medido −0.44 a −0.46 °/s (igual en 5 arranques), deriva del ángulo con el carro quieto 60 s: **0.0°** (repetida sin tocar nada; dos medidas anteriores, 0.8° y 25°, eran manos moviendo el carro: el ángulo se quedaba en -0.1° y saltaba de golpe).
  - **VL53L0X:** 8 de 8 arranques iniciaron bien (con 5 reintentos de `init()`; sin reintentos fallaba 1 de cada 3 aunque aparecía en el escaneo). Lecturas con algo delante: 66 a 77 mm, estables (sin comparar todavía con una regla).
  - **Tiempo de `loop()`: cumple.** En arranques limpios `LOOP?` informa un máximo de **1.8 ms** y 0 vueltas sobre 5 ms (también durante 60 s transmitiendo `SENS` por USB: 1.7 ms). El 92 ms que se vio una vez fue en un arranque donde se había corrido `PRUEBAI2C?`, un comando de diagnóstico que escanea 4 veces las 126 direcciones (nunca se usa en una ruta).
- Causas del problema de cableado que hubo: el cable SCL del GY-521 no llegaba al DevKit (con el láser desconectado, SCL no subía). Sirvió el comando `PINES?` (nivel eléctrico de SDA/SCL) y `PRUEBAI2C?` (escaneo cruzado y a 100/400 kHz).

## Cableado y pines

| Señal | GPIO del DevKit | GY-521 (MPU6050) | VL53LXX-V2 |
|---|---|---|---|
| SDA | 21 | SDA | SDA |
| SCL | 22 | SCL | SCL |
| 3V3 | 3V3 | VCC | VIN |
| GND | GND | GND | GND |

Direcciones: MPU6050 = 0x68 (AD0 a GND; si AD0 va a 3V3 sería 0x69), VL53L0X = 0x29. Los dos módulos traen sus pull-ups. Pines ya usados: 27, 26, 25, 33 (motores) y 2 (keep-alive); 21 y 22 estaban libres.

## Montaje

Giroscopio plano sobre la caja de pilas, flecha X al frente, eje Z hacia arriba; **girar a la izquierda = ángulo positivo**. Si la prueba física da el signo contrario: `IMU_SIGNO` en `config.h`. Láser al frente, a 6-8 cm del piso, inclinado 5-8° hacia arriba.

## Parámetros (todos en `firmware_carro/config.h`)

MPU6050: ±500 °/s (65.5 cuentas por °/s), filtro de ~44 Hz, 100 muestras/s, solo el eje Z; zona muerta 0.15 °/s; sesgo = promedio de 250 muestras, aceptado con desviación ≤ 12 cuentas y sesgo ≤ 1000 cuentas, 3 intentos; corrección lenta del sesgo (ZUPT) con el carro quieto más de 400 ms. Acepta WHO_AM_I 0x68, 0x70 y 0x72 y registra cuál leyó.
Giro: `GIRAR:<grados>` de 5 a 200, tiempo máximo propio 500 ms + 15 ms por grado. Desde J13, AUTO sin historial inicia con 100 ms por sentido; MANUAL con 20 ms. Tope 250 ms; mediana de los últimos cinco giros y NVS conservados. Se esperan 750 ms con motores apagados para medir el ángulo final: 200 ms truncaban la cola de inercia y sesgaban el aprendizaje.
Láser: una lectura cada ~33 ms sin bloquear `loop()`; 8190, 65535 o más de 1200 mm = libre; parada de emergencia con 2 lecturas válidas seguidas menores de 120 mm, solo en perfil AUTO y solo avanzando.

## Mensajes (WebSocket y, los de consulta, también por USB)

`CAPS?`, `IMU?`, `TOF?`, `SENS:<ángulo x10>,<mm>,<banderas>` (cada 100 ms con cliente y perfil AUTO), `GIRAR:<grados>` → `GIRO_OK` / `GIRO_TIMEOUT` / `GIRO_ERROR`, `IMU_CAL`, `IMU_CERO`, `TOF_PARO:<mm>`, `LOOP?`, `ANT?`. Solo por USB: `SENS_SERIE:1`, `I2C?` (escaneo del bus), `REG:<dir>:<reg>` (lee un registro), `PINES?` y `PRUEBAI2C?` (diagnóstico de cableado). **Por USB nunca se mueven los motores** (`GIRAR` se rechaza con `NAK_SERIE`). Detalle de cada mensaje en `firmware_carro/sensores.h` y `giro.h`.

## Pruebas de PC (Fase A)

`pruebas_firmware`: `make test` = `pruebas_carro` 152 (149 de antes + 3 del estrés con GIRAR), `pruebas_escalonado` 15, `pruebas_camara` 34 y `pruebas_sensores` 187. Resultados con sensores y motor SIMULADOS (no son medidas del carro real):
- 90 °/s durante 1 s → 90° ±0.5; 60 s quieto con ruido → deriva menor de 1°; un sesgo mal estimado dentro de la zona muerta no deriva, uno de 0.46 °/s sin ZUPT sí (~27° en 60 s: por eso existe `IMU_CAL`).
- Giro por ángulo contra un modelo de motor (160 °/s, inercia 50 ms): el primer giro de 90° pasa unos 6°; con la anticipación aprendida queda a ±3° en 9 de 10 giros (carro que varía ±10 % velocidad y ±25 % inercia).
- Láser: pico suelto no frena, 2 lecturas seguidas menores de 120 mm frenan en ~50 ms, no frena en MANUAL, en reversa, parado ni en giro; con el sensor caído el carro sigue como antes.
- Una vuelta de `loop()` hace como mucho 3 transacciones del bus.
- Estrés de 100 000 comandos con 2 hilos y `GIRAR` mezclado con STOP: 0 STOP perdidos (cuenta exacta de paradas: STOP + giros terminados solos + watchdogs).
- **ThreadSanitizer**: esta PC (Windows, MinGW) no tiene `libtsan` ni WSL, así que se corre en Linux con GitHub Actions (`.github/workflows/sanitizadores.yml`): ThreadSanitizer sobre el estrés de 2 hilos con `GIRAR` mezclado con STOP (`carro.c` + `imu.c` + `tof.c` + `giro.c` + `sensores.c`) y AddressSanitizer + UBSan sobre `pruebas_sensores`, `pruebas_carro` y `pruebas_navegador`. Resultado del 18 oct: **sin errores en los tres** (https://github.com/fernandosegrr/fsi_proyect/actions/runs/39150275890).

## Errores típicos

- `0x68` no aparece: GY-521 sin VCC/GND, SDA/SCL cruzados o sin soldar; AD0 a 3V3 lo mueve a 0x69.
- El láser aparece a ratos: cable flojo, soldadura fría, o el otro módulo arrastrando el bus.
- `WHO_AM_I=0x00` en el arranque: el bus no contestó (ver arriba). Otro valor distinto de 0x68/0x70/0x72: chip distinto.
- `IMU: MAL (motivo 3)`: el clon no guarda los registros de configuración.
- `IMU: MAL (motivo 4)`: el carro se movió durante los 2.5 s de calibración del sesgo.
- Ángulo que crece solo con el carro quieto: recalibrar con `IMU_CAL` (carro quieto).

## Licencia

Láser: librería VL53L0X de Pololu 1.3.1 (MIT), copia de la licencia en `docs/licencias/VL53L0X-Pololu-MIT.txt`. El MPU6050 va con registros directos, sin librería.

## Fase B: app y navegador (J11, 18 oct)

- **Mensajes en la app** (`ControlLogica.kt`): al conectar manda `CAPS?` y `TOF_USO:<0|1>`; lee `CAPS`, `SENS`, `GIRO_OK / GIRO_TIMEOUT / GIRO_ERROR`, `TOF_PARO`, `IMU_CAL_OK / FALLO` e `IMU:` (J16: también `WD:<n>` del watchdog, `ACK_RUMBO`, la respuesta a `RUMBO?`, `IMUS=<ppm>` en CAPS y `ACK_IMU_ESCALA` / `NAK_IMU_ESCALA`). Un firmware viejo no contesta `CAPS?`: la app lo toma como «sin sensores» y todo queda como antes. `girar(grados)` manda `GIRAR` una sola vez (no hay heartbeat; el watchdog de 1 s no corre durante el giro).
- **Pantalla Sensores** (Calibración → «Sensores (giroscopio y láser)»): interruptores «Usar giroscopio» y «Usar sensor de distancia» (guardados en `Ajustes`), estado en vivo, «Recalibrar giroscopio», «Poner el ángulo en cero» y prueba de giro de 90° por ángulo o por tiempo que registra en el log `SENS_DIAG prueba_giro ... medido_x10 ... ms`.
- **Navegador** (`nucleo_c/navegador.c`): giros por ángulo, `TOF_PARO` y confirmación de la cámara, con respaldos; ver `docs/navegador.md` («Giroscopio y sensor láser»).
- **Firmware:** se agregó `TOF_USO:<0|1>` (apaga/enciende el freno de emergencia con el interruptor de la app).
- **Servidor falso de la app:** `pruebas_firmware/servidor_falso.py` entiende `CAPS?`, `SENS`, `GIRAR`, `GIRO_*`, `TOF_PARO`, `IMU_CAL`, `IMU_CERO` y `TOF_USO` para probar las pantallas sin el carro.
- **Instalada y revisada en el Huawei (18 oct, con el servidor falso `--sensores` por `adb reverse`; sin cámara ni carro real):** `probar_pantallas.py` abre todas las pantallas sin errores (incluida `sensores`). En la pantalla Sensores se comprobó: chip «Los dos funcionan», giroscopio y láser en vivo, interruptores, y la prueba de giro de 90° (por ángulo: `GIRAR:90` → `GIRO_OK:90:909:735` → «medido 90.9° en 735 ms» en pantalla y en el log `SENS_DIAG prueba_giro`; por tiempo: 918 ms de LEFT y STOP). Se corrigieron dos textos que se cortaban (título y botones). El servidor falso no mueve el ángulo con LEFT, así que la prueba por tiempo muestra 0° ahí (con el carro real sí lo mide). Lo que falta es probarla con el carro.
- **Monte Carlo (simulación, no el carro real):** 400 rutas en L, sin giroscopio error medio 153 mm / p95 378 mm; con giroscopio 45 mm / p95 116 mm. Detalle y límites en `docs/limites_conocidos.md` §11.

## J12: ajustes después de la primera prueba real (18 oct)

Después de probar los giros con el carro real salieron cuatro ajustes. Aquí van por fase.

### 1. Anticipación del giro: por sentido, por perfil, con mediana y en memoria

- **Problema:** el giro a la derecha se pasaba ~2.7° y la anticipación no convergía (una sola, corregida a medias con cada giro y con ruido).
- **Ahora** (`firmware_carro/giro.c`): hay **4 anticipaciones**, una por sentido (izquierda/derecha) y por perfil (AUTO/MANUAL). Cada una es la **mediana de las últimas 5 lecturas** de «cuántos ms de anticipación habrían dado justo el ángulo»: la que se usó en ese giro más el error final (con signo) dividido entre la velocidad. Solo aprenden los giros bien terminados (`GIRO_OK`) de **30° o más** (con uno chico la velocidad no llega a su valor normal) y con más de 15 °/s. El primer giro ya corrige casi todo (con 1 lectura la mediana es esa lectura) y un giro raro (un resbalón) no la mueve (mediana).
- **Memoria no volátil:** se guardan cuando cambian **3 ms o más** y se leen al arrancar. J13 amplía el tope a 250 ms y conserva los valores existentes; no se borra el aprendizaje al cargar.
- **Mensajes:** `ANT?` → `ANT:<AUTO izq>,<AUTO der>,<MANUAL izq>,<MANUAL der>` en ms; `ANT_BORRAR` → `ACK_ANT_BORRAR` (AUTO vuelve a 100 ms por lado, MANUAL a 20 ms; se borra solo esa memoria).
- **Pruebas** (`pruebas_sensores.c`, modelo de motor ASIMÉTRICO: izquierda 160 °/s con inercia de 50 ms; derecha 130 °/s con inercia de 95 ms, y ruido de ±5 % en la velocidad y ±15 % en la inercia): tras 4 giros por lado aprende 52 ms a la izquierda y 91 ms a la derecha; después **10 de 10 giros a ±3° a la izquierda y 9 de 10 a la derecha** (objetivo: 9 de 10 por sentido). También: MANUAL no se toca con giros en AUTO y al revés, sobrevive a un reinicio, `ANT_BORRAR` deja todo en 20 ms y vacía la memoria, un giro disparatado casi no la mueve, y un giro de menos de 30° no la cambia.
- **Límite honesto:** el giroscopio informa el ángulo 200 ms después de frenar; si el carro todavía sigue girando después de eso (mucha inercia) esa parte final no se ve y el ángulo real queda un poco por encima (≈1.5° en la simulación con inercia de 95 ms). Con el carro real la prueba del dueño no vio diferencia entre el giroscopio y la cinta.

### 2. Giro duplicado: qué hace el navegador si se pierde el mensaje de un giro

- **Problema (J11):** si el firmware giraba pero su `GIRO_OK` no llegaba, el navegador repetía el giro por tiempo y el carro giraba dos veces.
- **Ahora** (`nucleo_c/navegador.c`): al empezar un giro por ángulo guarda el ángulo del giroscopio (lo último que dijo `SENS`, que ahora también lleva el ángulo al navegador). Si pasa la espera máxima (500 ms + 15 ms por grado + 1.5 s) sin `GIRO_OK` ni `GIRO_TIMEOUT`, **pide `IMU?`** (la app lo manda con `navegador_tomar_consulta_imu`) y compara el ángulo actual con el del inicio:
  - si ya giró **al menos el 80 %** de lo pedido, **NO repite**: usa lo medido como ángulo real (`SENS_DIAG giro mensaje_perdido fuente=IMU? ... NO se repite`);
  - si giró menos, la pose parte de lo que ya giró y repite **por tiempo solo lo que falta**;
  - si `IMU?` no contesta en 1 s se usa el último `SENS` si es reciente (`fuente=ultimo_SENS`);
  - si no hay ángulo del inicio (no llegaba `SENS`) o no hay ninguna respuesta, cae al método por tiempo como antes (`motivo=sin_respuesta_ni_angulo_inicial` o `sin_respuesta_ni_IMU`); esa es la única forma de que se duplique, y solo cuando no hay ningún dato del giroscopio.
- **Arreglo de un fallo mío de J11 que apareció al revisarlo:** al caer a tiempo en medio de una esquivada se ponía en cero el contador del paso de la ruta interrumpido (`ms_paso`). Ahora solo se toca el contador del movimiento en curso.
- **Pruebas del simulador** (`pruebas_navegador.c`, mensaje perdido): (a) el carro giró completo y el mensaje se perdió: pregunta `IMU?`, no repite, el cuadrado termina a 9 mm del inicio (19 mm sin perder el mensaje); (b) el carro giró solo el 40 %: repite solo lo que falta y termina a 71 mm; (c) `IMU?` sin respuesta pero con `SENS`: usa el último `SENS`; (d) sin `SENS` ni `IMU?`: cae a tiempo y la ruta termina.

### 3. Láser: reintentos cada 5 s, contados y recordados

- **Antes (J11):** si el láser no iniciaba al encender (pasaba 1 de cada 3 veces), quedaba sin funcionar hasta reiniciar el carro, y si se caía a mitad de camino tampoco volvía.
- **Ahora** (`firmware_carro/tof.c`):
  - **Al arrancar:** hasta 5 intentos con 100 ms entre uno y otro; los reintentos (el primer intento no cuenta) se **cuentan**.
  - **Después, cada `TOF_REINTENTO_MS` = 5 s** mientras no esté vivo (no inició o se cayó): se pregunta si contesta en 0x29 (una sola transacción del bus; si no contesta no pasa nada más) y solo si contesta se llama a la inicialización de la librería. **Esa inicialización espera al sensor unas decenas de ms, así que se hace solo con el carro detenido** (300 ms sin motores y sin giro); con el carro en marcha se pospone medio segundo. Es la única parte que puede tardar más de 5 ms en `loop()` y solo ocurre con el láser roto y el carro quieto. **El tiempo real de esa inicialización en el carro todavía no se ha medido** (necesita cargar el firmware por USB y mirar `LOOP?`).
  - **CAPS:** `CAPS:IMU=<0|1>,TOF=<0|1>,TOFR=<reintentos de inicio desde el arranque>`; la app lo muestra en la pantalla Sensores («Láser: N reintento(s) de inicio…»).
  - **Historial:** se recuerdan los reintentos de los **últimos 5 arranques** en la memoria no volátil. `ARR?` → `ARR:<anotados>,<con reintentos>,<reintentos de cada uno en hexadecimal, el más nuevo a la derecha>,<de este arranque>`. La pantalla Sensores muestra «Últimos arranques con reintentos del láser: k de n» y, si **más de 1 de cada 5 arranques necesita reintentos** (con al menos 3 anotados), un aviso con las causas probables.
- **Causas probables de que el láser necesite reintentos:** (1) cableado o soldadura floja en SDA, SCL, VIN o GND (el 18 oct un contacto flojo daba exactamente este síntoma); (2) pin **XSHUT** del módulo sin definir (flotando) o tocando otra señal: debe quedar libre con su resistencia o a 3V3, y si se controla desde un GPIO el sensor arranca en reinicio hasta que se sube; (3) **pull-ups** de SDA/SCL débiles o ausentes en el bus compartido con el GY-521 (cada módulo trae las suyas; con cables largos o varios módulos a veces hacen falta 4.7 kΩ); (4) alimentación que se levanta lenta al encender (el sensor necesita unos ms estable antes del primer intento); (5) el cable de SDA/SCL largo o junto a los de los motores.
- **Pruebas** (`pruebas_sensores.c`, láser falso): arranque limpio = 0 reintentos; un arranque con 2 fallos de inicio vive con `TOFR=2`; con los 5 intentos fallando queda caído (4 reintentos) y NO reintenta antes de 5 s, y al repararse se recupera solo y avisa `TOFR=5`; con el carro avanzando no intenta nada que espere y al detenerse lo hace; si el cable no contesta solo se pregunta (nunca se inicializa); se cae a mitad de ruta y se recupera a los 5 s; el historial (`02010`), `ARR?`, el 6.º arranque desplaza al más viejo.

### 4. Calibración del giro con el giroscopio (botón que inicia el usuario)

- **Para qué:** medir los ms por grado y el frenado de cada lado sin cinta ni transportador: el ángulo REAL lo da el giroscopio. Es la calibración «de respaldo» por tiempo (la que se usa cuando el giroscopio falla o está apagado), pero medida con el giroscopio. El desplazamiento del pivote **sigue siendo manual**.
- **Dónde:** Calibración → tarjeta «Calibrar el giro con el giroscopio» → pantalla propia (`CalibrarGiroActivity.kt`). **El carro nunca se mueve solo:** solo empieza cuando el usuario toca «Empezar los 6 giros», con el carro quieto y ~1 m libre. Necesita el giroscopio funcionando (`CAPS`) y el perfil AUTO confirmado.
- **Qué hace** (`nucleo_c/calgiro.c`, todo en C con pruebas de PC): 6 giros alternados (izquierda, derecha, ...) de unos 40°, 70° y 100° **por tiempo** (como los giros normales; los tiempos salen de la calibración guardada y el primer giro de cada lado reescala los siguientes). Para cada uno: espera 800 ms con el ángulo quieto, manda `LEFT` o `RIGHT` el tiempo planeado, frena, espera 1.5 s (y 400 ms quieto) y anota el ángulo REAL que giró. Con los 3 puntos de cada lado ajusta una recta (el mismo `cal_ajustar_giro` de la calibración manual): ms por grado y frenado.
- **Seguridad:** `PARO`, salir de la pantalla, perder la conexión o cualquier error mandan `STOP` y **no guardan nada**. Errores: el giroscopio deja de dar el ángulo (1.5 s), el carro no gira (menos de 8°; ¿sin pilas de motores?), gira al revés, un giro pasa de 190°, tarda más de 90 s en total, los puntos de un lado no siguen una recta (patinó o lo movieron) o el ajuste da un valor fuera de rango.
- **Al terminar bien:** guarda antes una copia (el botón «Deshacer» vuelve a lo de antes), guarda la calibración nueva (solo ms por grado y frenado de los giros; arranque, avance y desplazamiento no cambian), anota la fecha de giro izquierda y derecha y vuelve a 1000 el ajuste fino del giro de 90° de esos lados (ya no aplica). Muestra por lado «ms por grado antes → después (cambio %)», frenado antes → después y los 3 ángulos medidos. **Si un valor cambió más de 10 % contra lo guardado se avisa** (se guarda de todos modos; «Deshacer» lo revierte).
- **Pruebas de PC** (`nucleo_c/pruebas_calgiro.c`, 32 casos): carro con el ms por grado 20 % desajustado (queda a menos de 5 %); alternancia; ruido y error de escala del giroscopio; carro movido a mano al inicio; giroscopio mudo; carro que no gira; signo invertido; carro 3 veces más rápido (se adapta) y 6 veces (error por exceso de grados); cancelar; giro que patina (inconsistente); y **Monte Carlo de 200 carros distintos: 200 terminan, ms por grado a menos de 6 % de lo real y frenado a menos de 3°**. El carro simulado es un modelo mío, no el carro real.
- **App:** compila (APK debug) con la parte nativa nueva. **Límite honesto:** el giroscopio informa el ángulo unos ms después de frenar; si el carro siguiera girando más de 1.5 s (nunca visto) la medida saldría corta. Con 3 puntos por lado el frenado sale con menos precisión que los ms por grado. **Falta probarlo con el carro real** (`docs/validacion_sensores.md`, paso 9).
# J13: recuperación del sesgo

Si el arranque falla por motivo 4 (movimiento o ruido durante el promedio), el firmware reintenta cada 5 s de estado fallido, solo con motores detenidos al menos 300 ms. Reinicia el promedio del chip ya configurado, sin espera de I2C. Otros motivos requieren diagnóstico; no se ocultan reiniciando indefinidamente el chip.

CAPS agrega IMUR (reintentos desde encender), IMUM (motivo) e IMUE (estado). IMU? agrega el motivo como quinto campo. ARR? conserva sus cuatro campos TOF y agrega: arranques IMU anotados, arranques con reintentos, cinco dígitos hex con los reintentos (nuevo a la derecha, saturados a 15), contador actual. Los últimos cinco arranques viven en NVS, clave imuHist.

Mientras falta el sesgo, GIRAR responde GIRO_ERROR:sin_sesgo, sin energizar motores. La app muestra el motivo y el navegador pasa al giro por tiempo con su aviso SENS_DIAG. Reintento automático, arranque quieto/movido, bloqueo con motores activos y respaldo por tiempo están probados en PC; falta validar encendiendo el carro real.

# J13: versiones verificables

cargar.ps1 nuevo compila una copia temporal y genera FW:<hash de 7 caracteres>-<aaaammdd>. La cadena sale al arrancar y dentro de CAPS. Sensores muestra esa cadena y App 0.4 (hash). El APK contiene assets/version_app.txt; no depende de un log de una sesión anterior para identificarse.

Verificar sin instalar ni modificar preferencias:
pruebas_firmware\.venv\Scripts\python.exe scripts\verificar_version.py --puerto COM6 --apk app_android\app\build\outputs\apk\debug\app-debug.apk

Solo consulta CAPS? y lee el paquete com.fsi.carro. Compara hashes con HEAD, versión declarada y opcionalmente SHA-256 del APK instalado contra el build. Tolera commits posteriores exclusivamente de docs/ para poder guardar el reporte después de cargar; no tolera cambios de producto. No envía movimiento ni escribe NVS.

El extra video_url ya no se guarda en preferencias. Mientras existe hay aviso CÁMARA DE PRUEBA. Una apertura normal vuelve a http://192.168.4.2/stream y limpia la dirección antigua de pruebas.

# J16: escala del giroscopio

El MPU6050 promete la escala con ±3 %: un giroscopio que lee 1 % de más deja cada giro de 180° 1.8° corto y el rumbo estimado mal en lo que sigue. El firmware J16 multiplica la velocidad medida por una corrección en partes por millón (`IMU_ESCALA:<ppm>`, guardada en la memoria no volátil; `IMUS=<ppm>` en CAPS). La mide la tarjeta «Escala del giroscopio» de la pantalla Sensores: con el carro alineado con una línea del piso se toca Empezar, se gira dos vueltas completas al mismo lado (a mano y sin levantarlo, o con los botones de 90°), se vuelve a alinear y se toca Terminé; nucleo_c/calgiro.c (calgiro_escala) calcula la corrección compuesta con la que ya había y «Guardar en el carro» la manda. Un error de alineación de 1° en dos vueltas son 0.14 %. NO MEDIDO en el carro: la simulación supone que queda un residuo de ±0.3 %.
