fernandosegrr/fsi_proyect/docs/progreso_J13.md

J13 — Progreso del trabajo desatendido

Inicio: 20 de octubre de 2026 (hora de Ciudad de México). Base: c6b4fc5.
Repositorio limpio; identidad Git noreply ya configurada.

Condiciones: el dueño declara motores sin pilas ni powerbank y autoriza carga e instalación. No se enviarán movimientos al hardware. Solo se instalará con adb install -r y se cargará con cargar.ps1 nuevo conservando NVS. No se consultan imágenes de cámara ni otras apps.

Fase 1: terminada. Ocho giros alternados, calentamiento excluido del ajuste y de la adaptación de tiempos, descarte del peor válido con comprobación física del par restante. CALGIRO registra todos los pares (planeado, real, grados o sin medida) al terminar, fallar o cancelar; pantalla identifica calentamiento, descarte y pares ante error. Commit: J13 fase 1, el que contiene esta entrada.
Pruebas fase 1: núcleo 20 programas / 1545 casos (calgiro 37, antes 32), firmware 152 + 224 + 15 + 34, estrés de 100000 comandos sin STOP perdido, hash de página y servidor falso 42. App y firmware compilan. Estado: verde, sin tocar dispositivos.
Commit fase 1: b0d118b.
Fase 2: terminada. Tope 250 ms; AUTO sin historial 100 por lado, MANUAL conserva 20. Mediana de cinco, NVS, ANT? y ANT_BORRAR conservados. Asentamiento ampliado a 750 ms para medir la inercia completa (motores ya apagados). Pruebas: núcleo 1545; firmware 152+229+15+34, estrés sin STOP perdido. Inercia simulada de 200 ms aprende más de 150 y queda a ±3°. Ruido asimétrico: izquierda 10/10, derecha 9/10. Firmware compilado. Estado verde. Commit: J13 fase 2.
Commit fase 2: 7be39df.
Fase 3: terminada. Reintento del sesgo tras motivo 4 cada 5 s mientras falla, solo con motores detenidos y asentados. Reinicia el promedio sin resetear el chip ni esperar al bus. IMUR, IMUM e IMUE en CAPS; historial NVS de cinco arranques agregado a ARR; estado y motivo en Sensores. Sin sesgo, GIRAR se niega y las rutas caen al tiempo. Pruebas: núcleo 1546 (navegador +1); firmware 152+239+15+34, estrés sin STOP perdido. App y firmware compilan. Commit: J13 fase 3. Estado verde.
Commit fase 3: 5085c6d.
Fase 4: terminada. Firmware imprime FW:<git>-<aaaammdd> al arrancar y en CAPS; cargar.ps1 genera la versión en copia temporal. App 0.4 (versionCode 3) incluye hash en BuildConfig y metadatos verificables del APK; Sensores muestra ambas versiones. verificar_version.py consulta USB y APK instalado y compara con Git, opcionalmente bytes del build. URL de adb solo en memoria, aviso CÁMARA DE PRUEBA en pantallas de video, apertura normal limpia la URL antigua y usa la real. cargar.ps1 nuevo exige una sola placa serie y MAC conocida de DevKit; no usa sonda. Pruebas: núcleo 1546, firmware 152+240+15+34, hash/estrés, siete pruebas del verificador. Firmware y APK compilan; APK contiene APP:0.4-5085c6d en este build de desarrollo. Commit: J13 fase 4. Estado verde.
Commit fase 4: e60ec35.
Fase 5: terminada solo en PC. Interruptor Autoridad del láser, apagado por defecto. Con el interruptor de distancia activo y lectura válida/fresca, decide presencia a 400 mm en columnas 3..6; conserva obstáculos fuera del carril y datos laterales de la cámara. Cámara elige el lado. Caído, inválido o más viejo de 400 ms devuelve la decisión a la cámara. Log CONTRADICCION_LASER_CAMARA. Se conserva la opción al reiniciar el navegador por JNI para cada ruta. Pruebas: núcleo 20 programas / 1570 casos (calgiro 37; navegador 375); firmware 152+241+15+34 = 442, estrés 100000 sin STOP perdido, hash, servidor falso 42 y verificador siete pruebas; app compila. Firmware lógico idéntico al compilado en fase 4. Commit: J13 fase 5. Estado verde.
Nota: el freno de emergencia del firmware es 120 mm (no 400); se conserva para no modificar el comportamiento con el interruptor nuevo apagado. Los 400 mm son la decisión opcional de navegación. Pendiente de validar físicamente por el dueño.
Commit fase 5 y revisión compilada/cargada: 4233201, push correcto a origin/main. Sanitizadores de GitHub Actions: success, ejecución 39548476207 (https://github.com/fernandosegrr/fsi_proyect/actions/runs/39548476207).

Fase 6, primer intento: parcial por bloqueo externo del teléfono. 21 oct 2026, 07:28 a 07:38, hora de Ciudad de México. Ver reanudación al final para el estado actual.
- Estado del teléfono guardado antes de tocarlo: stay_on_while_plugged_in=2, pantalla encendida. Se mantuvo despierto con svc power stayon usb.
- HEAD 4233201 compilado: FW:4233201-20261021 y APP:0.4-4233201. Se verificó el metadato del APK; FW y APK compilado corresponden a esa revisión. Los commits posteriores de cierre solo contienen documentación.
- Una sola placa serie, COM6; la identidad conocida del DevKit se comprobó con esptool y cargar.ps1. Carga por cargar.ps1 nuevo a 921600, sin borrar flash completa ni NVS. verify-flash pasó para bootloader, particiones, boot_app0 y aplicación.
- ANT antes/después: 121,150,20,20. No se ejecutó ANT_BORRAR ni calibración. USB a las 07:35:11: CAPS:IMU=1,TOF=1,TOFR=1,IMUR=0,IMUM=0,IMUE=2,FW:4233201-20261021; IMU:0,-48,2,104,0; TOF:253,3; ARR:5,4,11101,1,3,0,00000,0; LOOP:12858,1. Sensores ok; sesgo -0.48 grados/s. Pico del loop 12.858 ms supera 5 ms: causa no determinada, pendiente repetir la medida en reposo y en marcha por el dueño. El historial TOF cambió durante los reinicios de diagnóstico/carga; no equivale a cinco arranques normales con powerbank.
- Se lanzó solo adb install -r. El teléfono quedó detrás de un bloqueo por PIN y no hubo un botón de instalación accesible. No se introdujo ningún código ni se intentó resolverlo. Se canceló el cliente de instalación por PID exacto 17368. Sigue instalada la app 0.3, versionCode 2; la APK 0.4 nueva está compilada pero NO instalada. La excepción expresa de no resolver contraseñas/PIN impide continuar los cinco intentos de toques; no se hicieron toques ciegos.
- No se pudo verificar la pantalla Sensores de la app nueva ni tomar capturas de ella. No se vio ni guardó video. Verificación del paquete instalado contra HEAD: pendiente; el paquete anterior no corresponde a la versión nueva.

Cierre anterior (sustituido por la nueva solicitud de reactivación):
- Teléfono: am force-stop com.fsi.carro; stay-on restaurado y comprobado en 2; archivo temporal de UI retirado; reboot -p aceptado. Después no aparece ningún teléfono en adb devices. Servidor adb cerrado. No se crearon wake-locks adicionales.
- DevKit: NO se pudo cortar VBUS. uhubctl no está disponible y su documentación declara la limitación de Windows; el DevKit está en el puerto 2 del concentrador raíz. pnputil dirigido solo al DevKit devolvió Acceso denegado (sin cambios). No se deshabilitó el concentrador ni otros dispositivos.
- Alternativa comprobada: reset sostenido por RTS afirmada (bajo físico), DTR desactivada. Primero silencio al consultar CAPS, después arranque FW:4233201-20261021 al soltar RTS, y silencio final al afirmarla de nuevo. Proceso Python PID 19532, lanzador PID 14244; ambos pertenecen al único helper de reset. Estado en %TEMP%\j13_reset_estado.json, script %TEMP%\j13_mantener_reset.py. El USB conserva tensión, pero el chip queda detenido en reset mientras el helper mantiene la línea.
- Para reanimar: Stop-Process -Id 19532,14244 -ErrorAction SilentlyContinue; desconectar y reconectar USB. Hacerlo antes de cargar/consultar COM6. Gradle detenido; no quedaron servidores de prueba.

Reanudación, 21 oct 2026, 07:49 a 08:05; fase 6 terminada sin movimiento:
- El dueño autorizó reactivar, recargar, desbloquear e instalar. El dato de desbloqueo no se registra en archivos. La nueva solicitud sustituye el cierre previo: DevKit encendido y disponible, sin helper de reset.
- Se verificaron los procesos exactos 14244/19532; detener el lanzador terminó ambos. RTS liberada, CAPS respondió. Estado temporal del helper marcado como detenido.
- Firmware y APK compilados desde HEAD adbdd13: FW:adbdd13-20261021 y APP:0.4-adbdd13 (0.4/código 3). Solo había COM6; DevKit conocida, cargar.ps1 nuevo a 921600 y verify-flash de los cuatro archivos pasan. Sin borrar NVS. ANT permanece 121,150,20,20.
- USB 07:52:46: CAPS:IMU=1,TOF=1,TOFR=1,IMUR=0,IMUM=0,IMUE=2,FW:adbdd13-20261021; IMU:0,-47,2,104,0; TOF:254,3; ARR:5,5,11111,1,5,0,00000,0. Sin movimientos ni imágenes de cámara.
- LOOP inicial 12935,1. Tras LOOP_CERO, 60 s en reposo: máximo 1690 us, cero excesos de 5 ms. Dos pasadas de consultas individuales CAPS/IMU/TOF/ANT/ARR dieron 1401 a 1764 us, cero excesos. No se reprodujo el pico inicial; su causa sigue pendiente.
- APK instalada con adb install -r: Success, de 0.3/código 2 a 0.4/código 3, sin borrar datos. SHA-256 D8C0577D0E744B173220709B8A526C4F086B4FE01BA2D54FD041DC6576495903. El dueño encendió/desbloqueó el teléfono y habilitó USB; ADB disponible a las 08:01. No hizo falta introducir ni guardar el PIN. Estado inicial guardado: stay-on 2, pantalla encendida. No se requirieron toques de instalación.
- verificar_version.py --puerto COM6 --apk app_android/app/build/outputs/apk/debug/app-debug.apk: PASA, FW/APK adbdd13 iguales a la revisión compilada, versionName=0.4, APK instalada idéntica al build y fuentes limpias. Solo se agregan documentos después de esa revisión.
- Sensores revisada con capturas autorizadas: FW y app correctos, giroscopio ok (0.2 grados, sesgo -0.47 grados/s, IMUR=0 e historial 0 de 5), láser ok (254 mm, TOFR=1 e historial 5 de 5); aviso de reintentos visible. Historial afectado por carga/verificación, no prueba de arranque con powerbank. Uso de ambos sensores encendido y Autoridad del láser apagada. Teléfono 192.168.4.10 alcanza DevKit, ping 3.607 ms; PC fuera de esa red. Sin cámara.
- USB con la app conectada 08:03:43: CAPS:IMU=1,TOF=1,TOFR=1,IMUR=0,IMUM=0,IMUE=2,FW:adbdd13-20261021; IMU:2,-47,2,104,0; TOF:253,3; ANT:121,150,20,20; ARR:5,5,11111,1,5,0,00000,0; LOOP:8000,4. Cuatro excesos de 5 ms, máximo 8 ms: el límite global sigue pendiente aunque la ventana previa en reposo pasó.
- Cierre: app force-stop, stay-on restaurado y comprobado en 2, pantalla encendida como al inicio; UI temporal retirada. Gradle, pruebas y helper de reset terminados. Ambos dispositivos quedan encendidos por la solicitud nueva. Mantener Autoridad del láser apagada; quedan las validaciones físicas y los picos del loop, detallados en reporte_J13.md.

Decisiones: cuatro giros por lado significan ocho mediciones totales, dos de calentamiento y seis válidas. Se conservarán y registrarán las ocho, identificando las seis usadas para el ajuste. Un par de puntos siempre define una recta: se exigirá además pendiente y frenado físicamente admisibles para aceptar el descarte.
