fernandosegrr/fsi_proyect/docs/trabajos/ajustes_1.md

AJUSTES 1 DE 3 - REGLAS Y REINCORPORACION. Reglas de siempre: no tocar original_backup/; sin secretos ni archivos de más de 15 MB en git; push sin --force; identidad noreply; no tocar Python/PATH/JAVA_HOME globales; no matar procesos por búsqueda amplia; no ver ni guardar imágenes reales de la cámara (solo números); una placa por USB a la vez; pruebas del PC antes de cada commit; sin pruebas con el carro (el usuario las hace al final). Trabaja sin preguntar y al final da un resumen corto. Código C simple con comentarios en español, sin hardware nuevo, sin encoders ni IMU.

Contexto: prueba real en loseta con tijeras de obstáculo y mucho espacio libre. Hallazgos: (a) tras esquivar no vuelve a la línea de la ruta: gira y se va derecho hacia ese lado; (b) aborta con "otro obstáculo muy cerca mientras esquivaba" sin necesidad; (c) giros de ~110° por 90°; (d) en recta se va ~6 cm a la derecha en 2000 ms; (e) demasiados pasos para lanzar una ruta; (f) en el simulador, un obstáculo de una celda en una recta suele terminar en "No llegó". Los puntos b, c, d, e están en ajustes_2 y ajustes_3.

1. REINCORPORACION A LA LINEA (log REINC_DIAG). Lleva una pose estimada (x, y, rumbo) por cálculo de tiempos de la calibración, actualizada con cada avance y giro, incluido el esquive. Al terminar el esquive: calcula el punto de la línea original ~30 cm por delante del punto de salida, gira hacia él con el giro mínimo, avanza la distancia estimada y al llegar gira al rumbo original. Si el obstáculo bloquea ese tramo, repite el esquive con el reintento ya definido. Nunca avanza recto sin reorientarse. Si la desviación estimada es menor a 8 cm, solo corrige el rumbo y sigue. Usa el perfil AUTO y las pausas de 300 ms de siempre. Log: pose antes y después, punto objetivo, distancia y ángulos calculados. Pruebas en C: obstáculo a la izquierda, a la derecha, al centro, en curva y con reintento; la pose final debe quedar a 10 cm o menos de la línea.

2. SIMULADOR. Investiga si el "No llegó" con obstáculo de una celda es el modelo de la cámara virtual o el navegador. El obstáculo virtual por defecto debe ser una caja de ~20 cm (varias celdas). Los casos simples (obstáculo de 20 a 30 cm en una recta con espacio a los lados) deben llegar en la simulación; si no, es un bug del navegador: corrígelo con prueba. Cuando no llegue, la pantalla debe decir por qué (ej: "el obstáculo bloqueó el camino y se agotaron los reintentos"). Documenta en docs/navegador.md.
