fernandosegrr/fsi_proyect/docs/trabajos/ajustes_3.md

AJUSTES 3 DE 3 - RECTA Y FLUJO RAPIDO. Mismas reglas que ajustes_1.md.

5. EQUILIBRIO DE LADOS (RECTA). Medido: en AUTO (210) en recta el carro se desvía a la derecha ~6 cm en 2000 ms (~38 cm recorridos), una diferencia de ~5-10 % entre lados; la tabla actual (207 izq / 210 der) corrige solo ~1.5 %. Haz el equilibrio un parámetro (factor del lado izquierdo en por mil, de 800 a 1000) guardado por perfil (AUTO y MANUAL) en memoria no volátil del carro. La app lo envía al conectar o al cambiarlo con un mensaje nuevo con ACK, sin romper el protocolo actual (actualiza el test de hash de pagina.h si hace falta). El factor reduce el PWM del lado más rápido; nunca sube el otro por encima del tope del perfil. En Calibración agrega "Recta" (una prueba por pantalla): carro sobre una línea de cinta, "Avanzar 2 s", el usuario indica hacia dónde se desvió (izq, der, recto) y cuántos cm (stepper de 1 cm). La app calcula el factor con la geometría (ángulo ≈ 2·desvío/recorrido, ancho de ejes configurable, por defecto 12 cm), lo aplica y repite hasta 1 cm o menos de desvío, máximo 4 iteraciones, con "Restaurar valor por defecto". El simulador usa el mismo factor; prueba: con factor equivocado se desvía, con el calibrado llega. Documenta en docs/perfiles_velocidad.md. Aviso en pantalla: "recalibra con las pilas que usarás en la demo". Agrega ARRANQUE_ESCALONADO_MS en config.h (por defecto 0 = apagado): si es mayor que 0, arranca primero un lado y el otro ese tiempo después, para repartir el pico de corriente; con prueba de firmware.

6. FLUJO RAPIDO. Cuenta los toques desde abrir la app hasta que el carro arranca una ruta. Meta: máximo 3 (elegir ruta, Iniciar, confirmar). Iniciar hace solo: comprobar conexión y modo AUTO, aprender el piso con la franja de referencia (si hay mucha variación, avisar "despeja el frente del carro" en vez de aprender mal), cuenta 3-2-1 y salir. "Aprender piso" manual queda en Avanzado. Agrega 3 rutas plantilla (recta de 1 m, L, ida y vuelta) y "Repetir la última ruta". Usa el sistema de diseño de docs/diseno.md. Revisa lo que ya existe en Ejecutar ruta y Prueba final y complétalo en vez de duplicarlo.
