fernandosegrr/fsi_proyect/docs/figuras/v2/camara_modos.pdf

Cámara Freenove
ESP32-WROVER
Sensor GC0308
- HQVGA 240×176
- RGB565 @ 20 MHz
- Buzón de último
cuadro (sin cola)
- IP 192.168.4.2

Modo 1 — MJPEG (/stream en puerto 81 y /capture en puerto 80) JPEG por software (JPEGENC calidad 50) · 12.4 fps · Edad media 137 ms · Vista humana y TFLite.

Modo 2 — Cuadro crudo RGB565 (/raw en puerto 80) 84,480 bytes por cuadro sin compresión JPEG · Verificación cromática exacta en laboratorio.

Modo 3 — Rejilla compacta de celdas (UDP puerto 4210) Paquete CEL1 de 1,244 bytes (cabecera 20 B + 24×17 celdas RGB) · Mínima latencia para piso.
