fernandosegrr/fsi_proyect/docs/figuras/v2/desarrollo.pdf

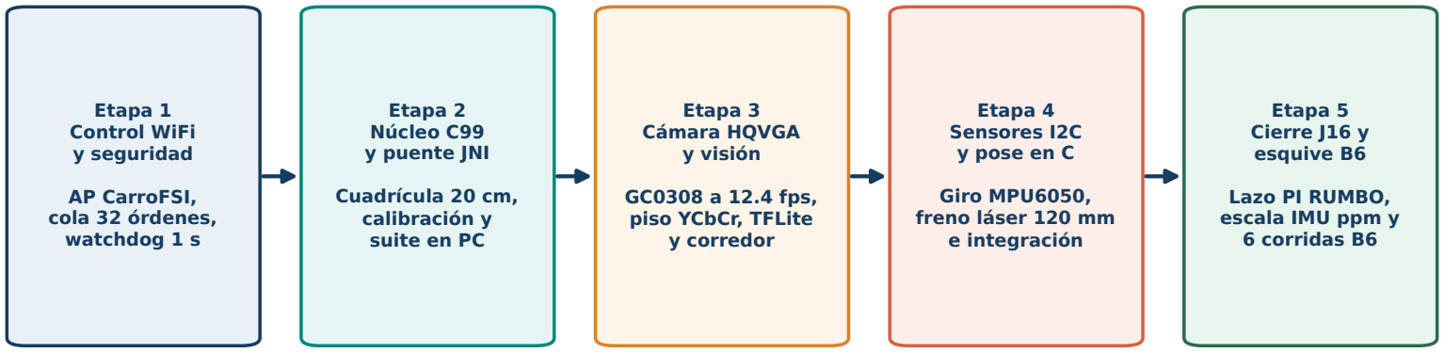
[picture p5: figure]
Etapa 1 Control WiFi y seguridad; AP CarroFSI, cola 32 órdenes, watchdog 1 s; Etapa 2 Núcleo C99 y puente JNI; Cuadrícula 20 cm, calibración y suite en PC; Etapa 3 Cámara HQVGA y visión; GC0308 a 12.4 fps, piso YCbCr, TFLite y corredor; Etapa 4 Sensores I2C y pose en C; Giro MPU6050, freno láser 120 mm e integración; Etapa 5 Cierre J16 y esquive B6; Lazo PI RUMBO, escala IMU ppm y 6 corridas B6

Resultado acumulado en v1.1: 22 programas / 1,655 casos en nucleo_c + 5 programas / 540 casos en pruebas_firmware + 50,000 corridas Monte Carlo + validación física en el carro del esquive B6 (5/6 autónomas, 0/6 toques).
