fernandosegrr/fsi_proyect/docs/figuras/v2/esquive.pdf

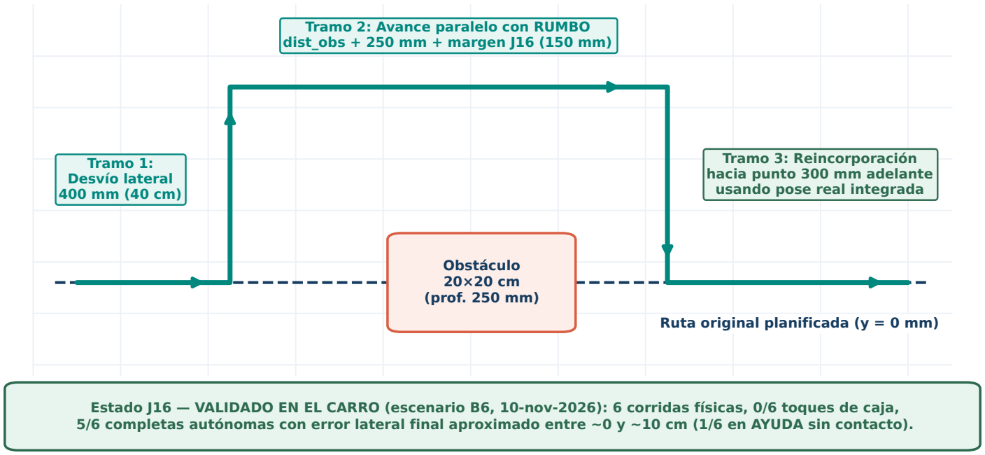
[picture p6: figure]
Obstáculo 20×20 cm (prof. 250 mm); Ruta original planificada (y = 0 mm); Tramo 1: Desvío lateral 400 mm (40 cm); Tramo 2: Avance paralelo con RUMBO dist_obs + 250 mm + margen J16 (150 mm); Tramo 3: Reincorporación hacia punto 300 mm adelante usando pose real integrada

Estado J16 — VALIDADO EN EL CARRO (escenario B6, 10-nov-2026): 6 corridas físicas, 0/6 toques de caja, 5/6 completas autónomas con error lateral final aproximado entre ~0 y ~10 cm (1/6 en AYUDA sin contacto).
