fernandosegrr/fsi_proyect/docs/figuras/v2/pantallas.pdf

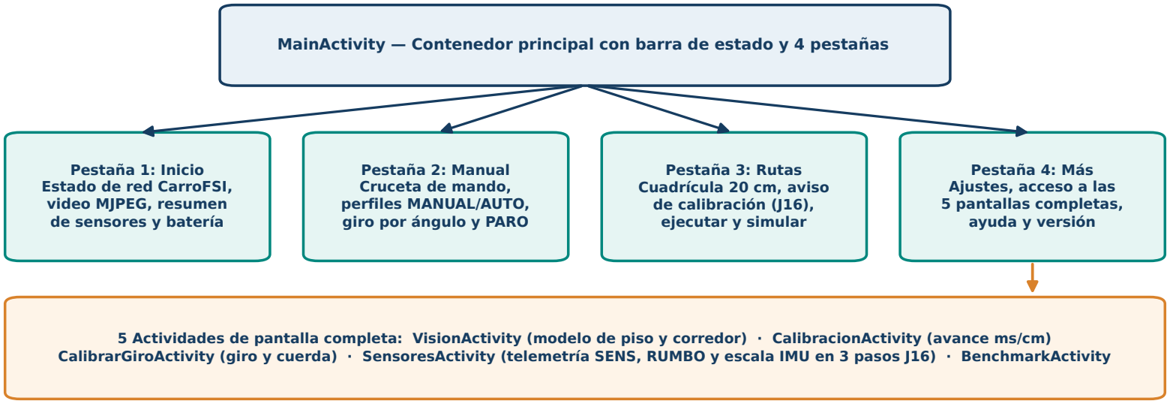
[picture p8: figure]
Pestaña 1: Inicio Estado de red CarroFSI, video MJPEG, resumen de sensores y batería; Pestaña 2: Manual Cruceta de mando, perfiles MANUAL/AUTO, giro por ángulo y PARO; Pestaña 3: Rutas Cuadrícula 20 cm, aviso de calibración (J16), ejecutar y simular; Pestaña 4: Más Ajustes, acceso a las 5 pantallas completas, ayuda y versión

MainActivity — Contenedor principal con barra de estado y 4 pestañas

5 Actividades de pantalla completa: VisionActivity (modelo de piso y corredor) · CalibracionActivity (avance ms/cm) CalibrarGiroActivity (giro y cuerda) · SensoresActivity (telemetría SENS, RUMBO y escala IMU en 3 pasos J16) · BenchmarkActivity

Sesiones únicas compartidas (SesionCarro y SesionVideo): conservan vivo el WebSocket /ws y el flujo de cámara entre pantallas.
