fernandosegrr/fsi_proyect/docs/figuras/fig_01_sistema.png

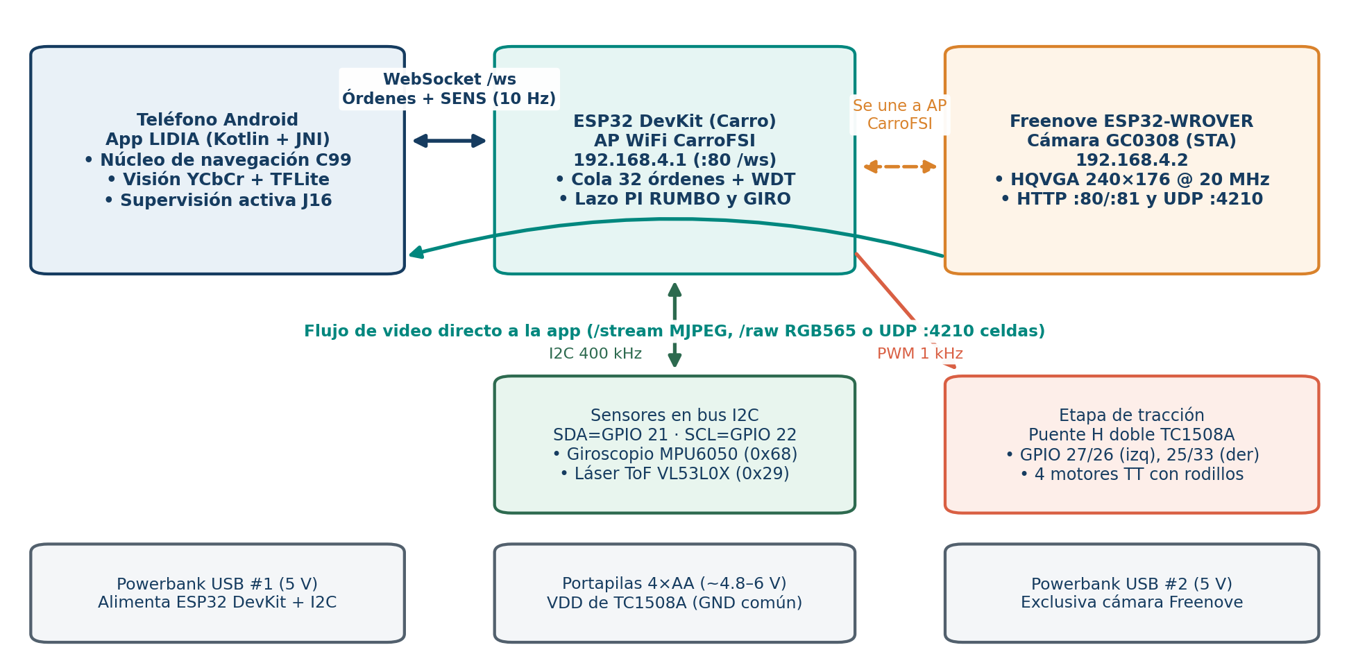
docs/figuras/fig_01_sistema.png
