fernandosegrr/fsi_proyect/docs/figuras/fig_02_capas_firmware.png

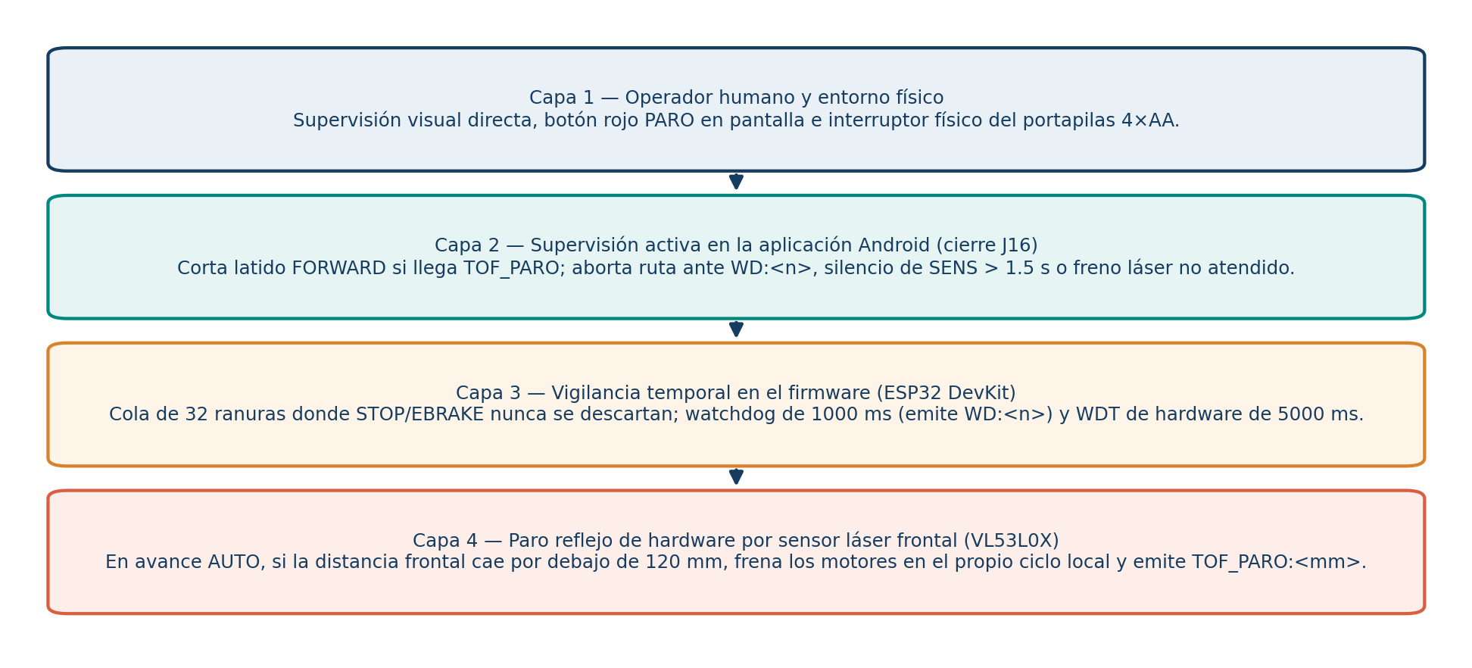
docs/figuras/fig_02_capas_firmware.png
