fernandosegrr/fsi_proyect/docs/figuras/fig_03_flujo_comando.png

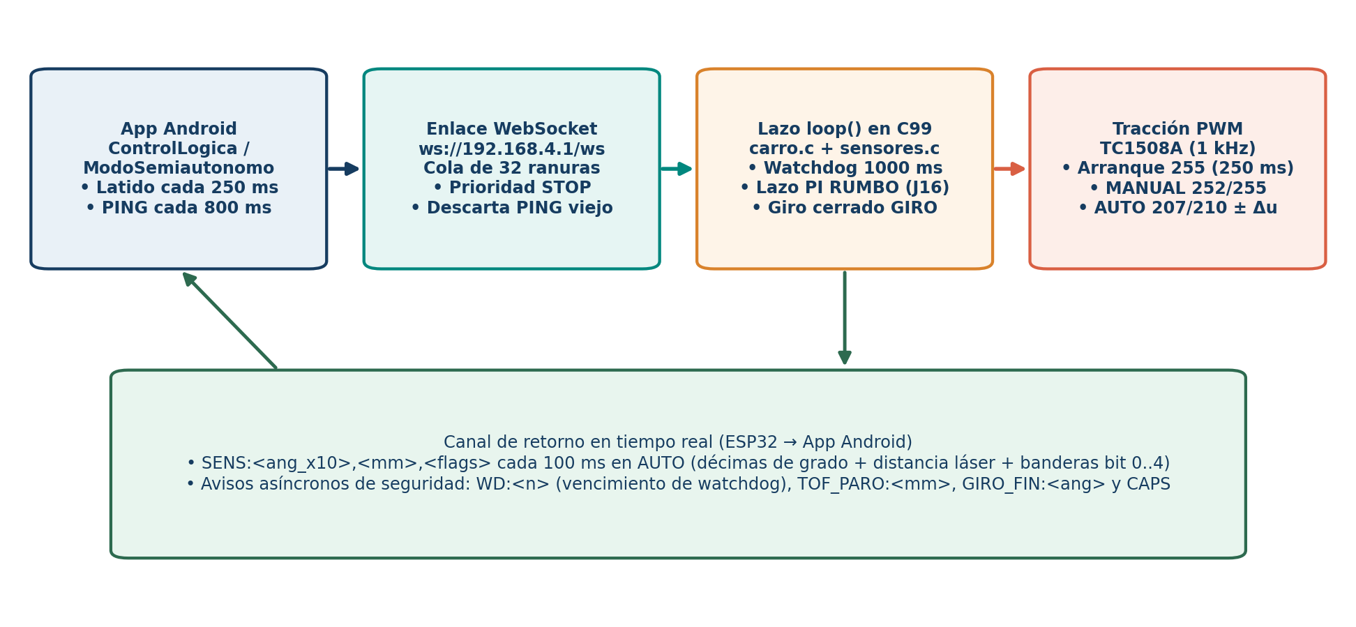
docs/figuras/fig_03_flujo_comando.png
