fernandosegrr/fsi_proyect/docs/figuras/fig_04_estados_navegador.png

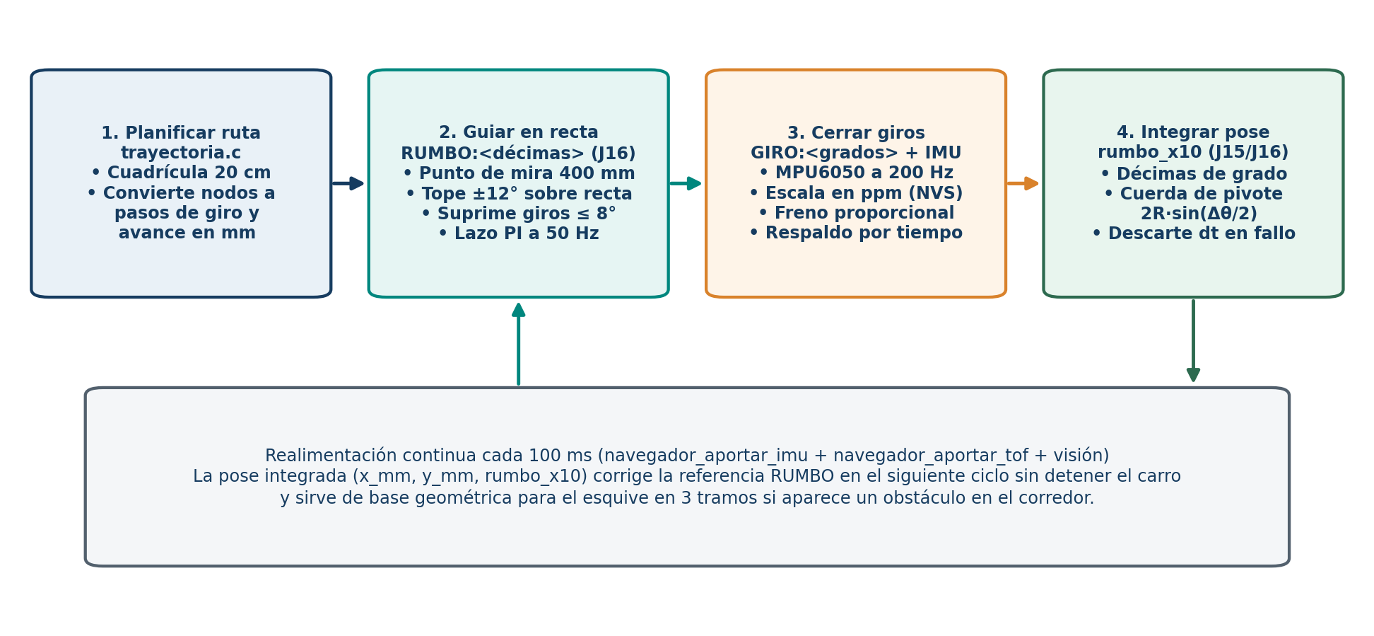
docs/figuras/fig_04_estados_navegador.png
