fernandosegrr/fsi_proyect/docs/figuras/fig_06_esquive.png

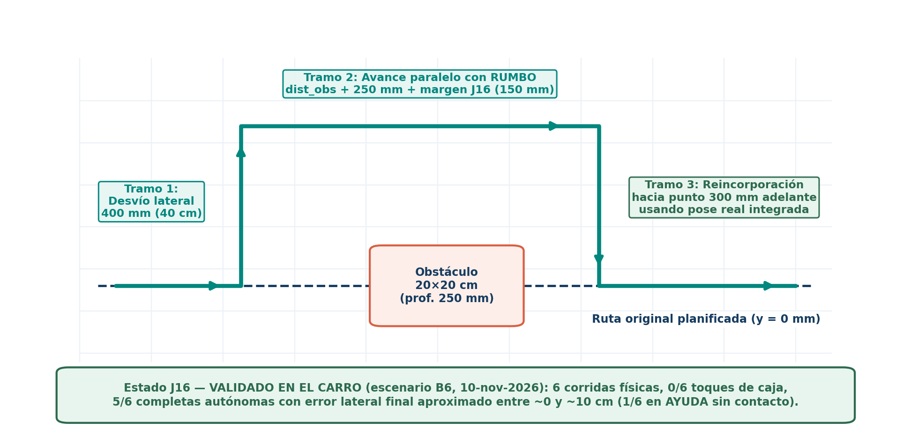
docs/figuras/fig_06_esquive.png
