fernandosegrr/fsi_proyect/docs/figuras/fig_07_corredor.png

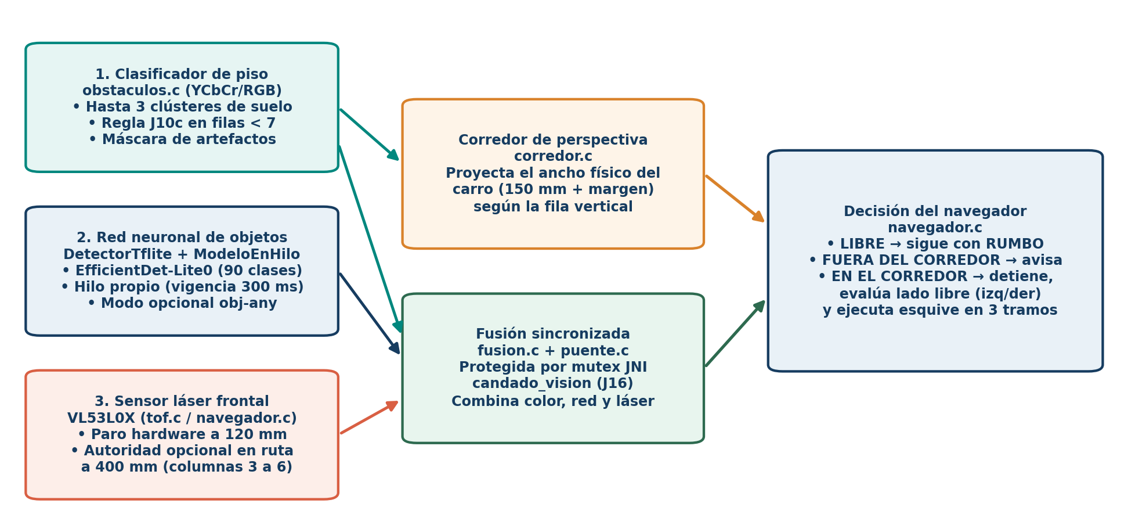
docs/figuras/fig_07_corredor.png
