fernandosegrr/fsi_proyect/docs/figuras/fig_08_pantallas_app.png

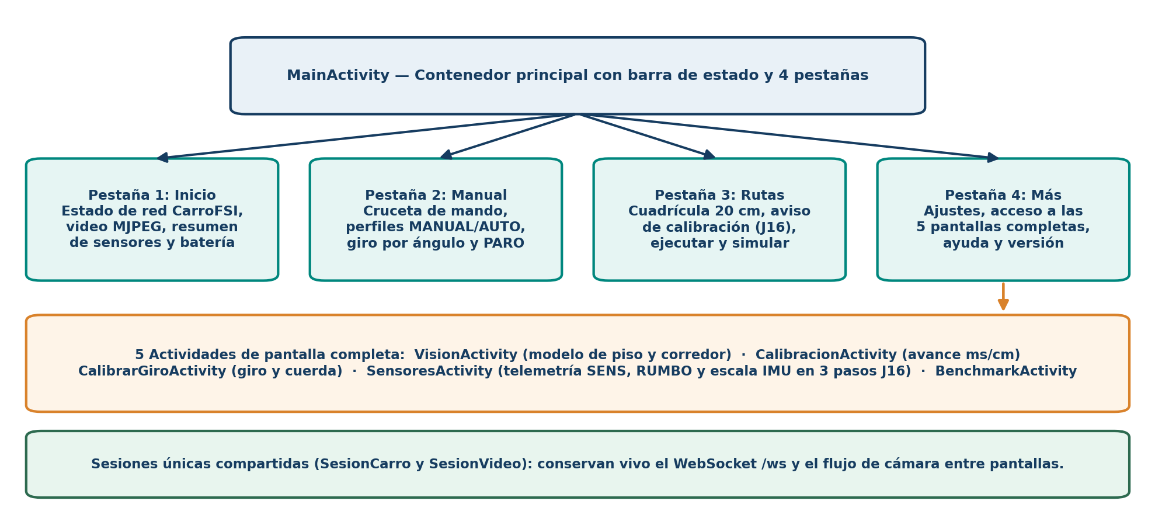
docs/figuras/fig_08_pantallas_app.png
