fernandosegrr/fsi_proyect/docs/figuras/fig_09_camara_modos.png

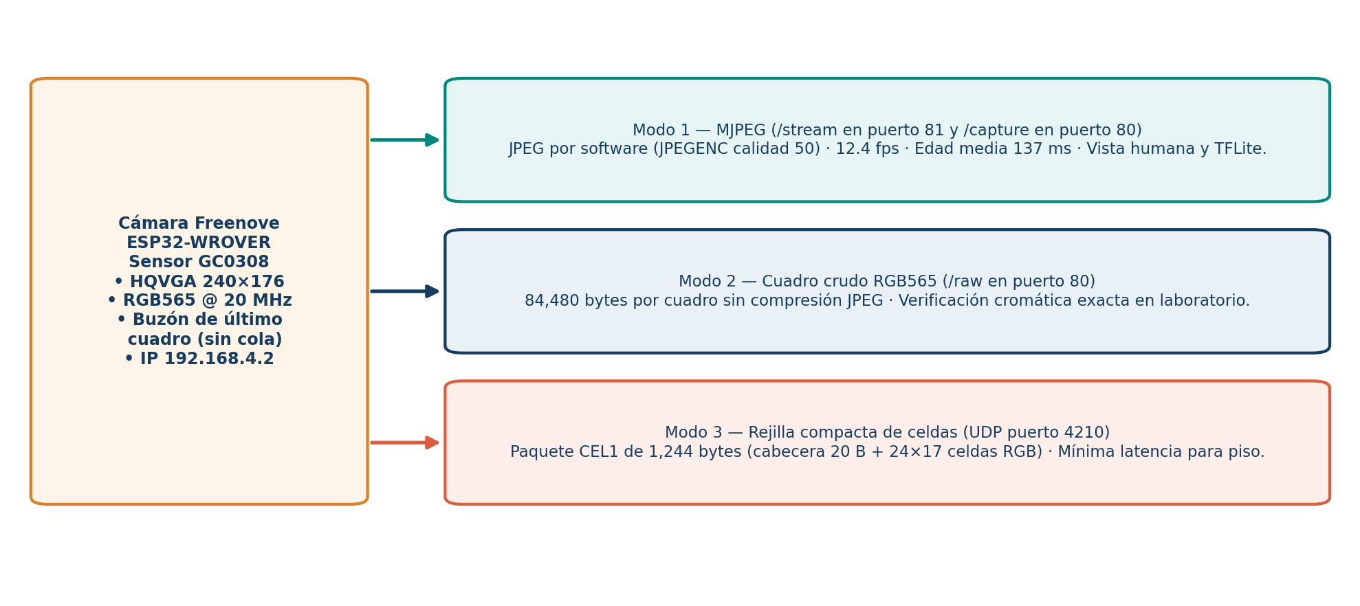
docs/figuras/fig_09_camara_modos.png
