fernandosegrr/fsi_proyect/docs/figuras/fig_10_alimentacion.png

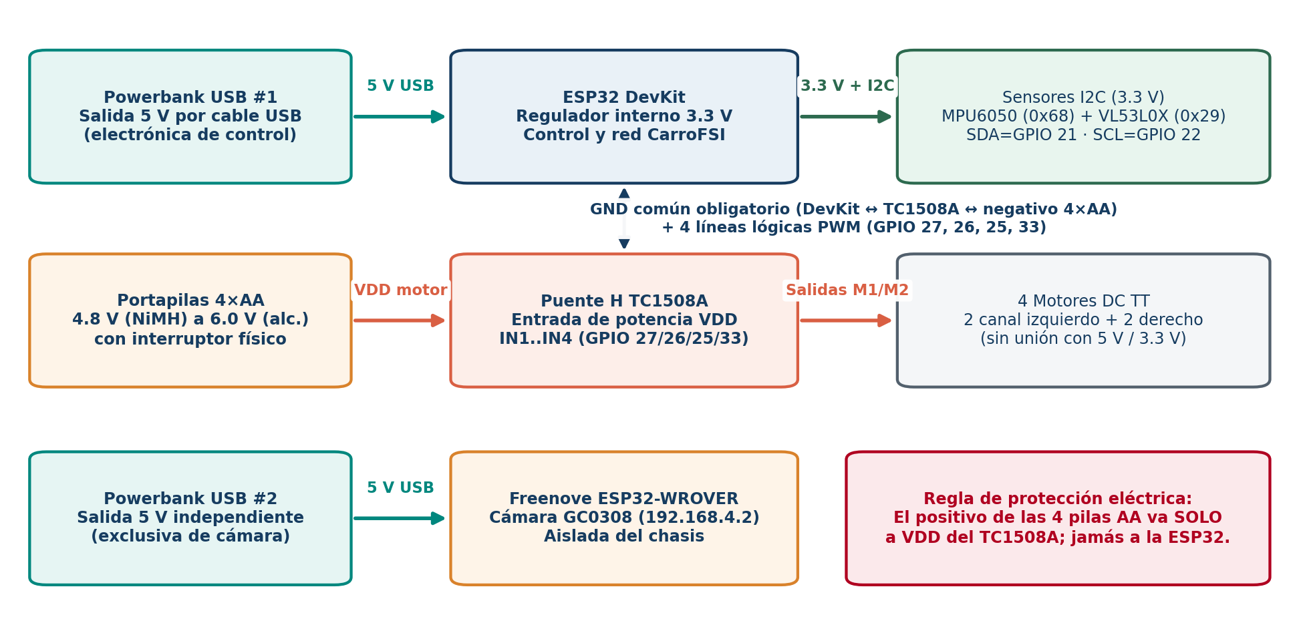
docs/figuras/fig_10_alimentacion.png
