fernandosegrr/fsi_proyect/docs/figuras/v2/desarrollo.png

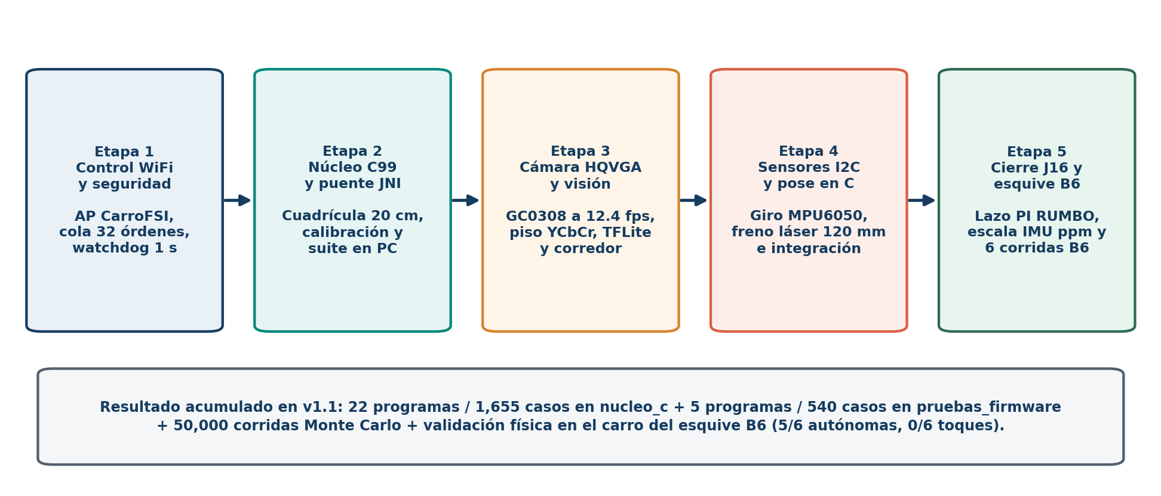
docs/figuras/v2/desarrollo.png
