fernandosegrr/fsi_proyect/docs/figuras/v2/lamina_app.png

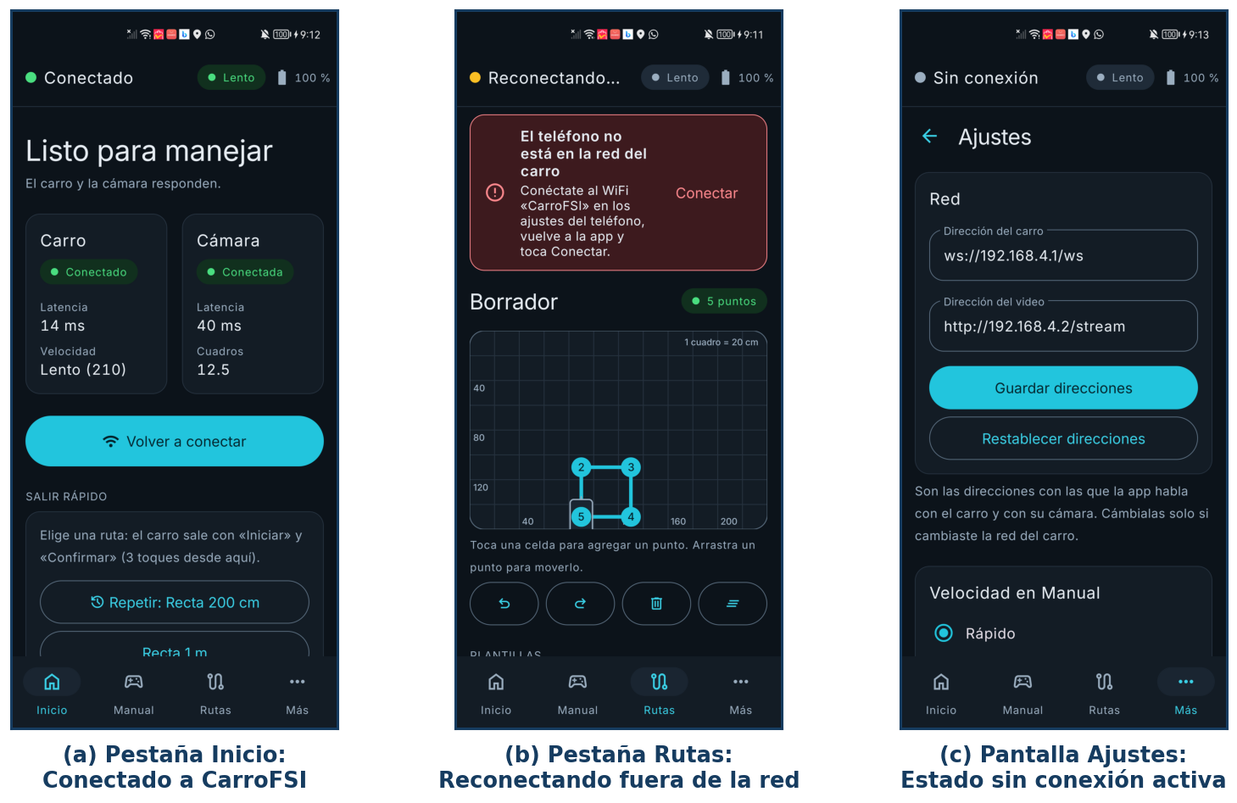
docs/figuras/v2/lamina_app.png
