fernandosegrr/fsi_proyect/docs/figuras/v2/lamina_carro.png

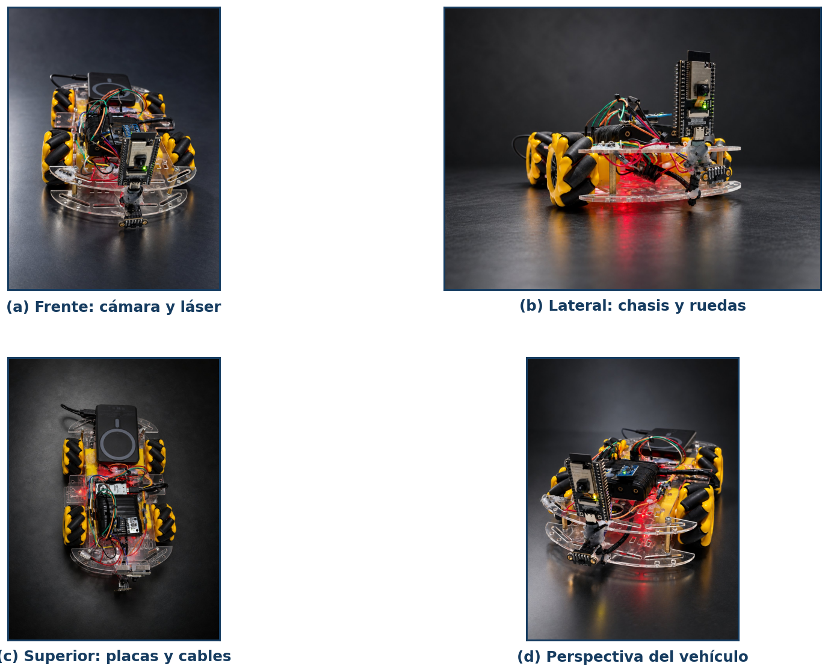
docs/figuras/v2/lamina_carro.png
