fernandosegrr/fsi_proyect/docs/imagenes/foto_01_carro_frontal.jpg

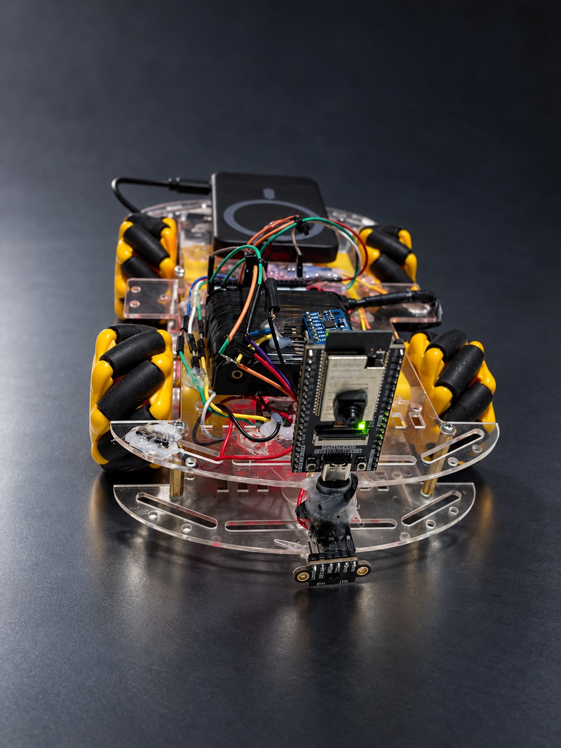
docs/imagenes/foto_01_carro_frontal.jpg
