fernandosegrr/fsi_proyect/docs/imagenes/foto_03_carro_superior.jpg

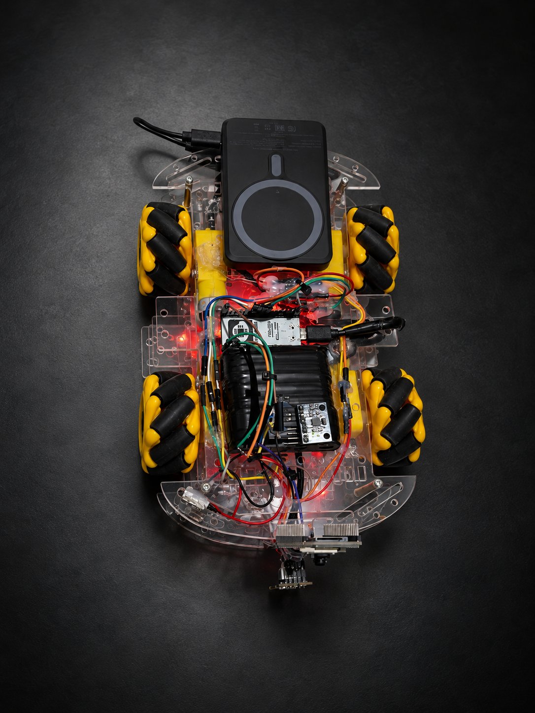
docs/imagenes/foto_03_carro_superior.jpg
