fernandosegrr/fsi_proyect/docs/imagenes/foto_10_app_conexion.png

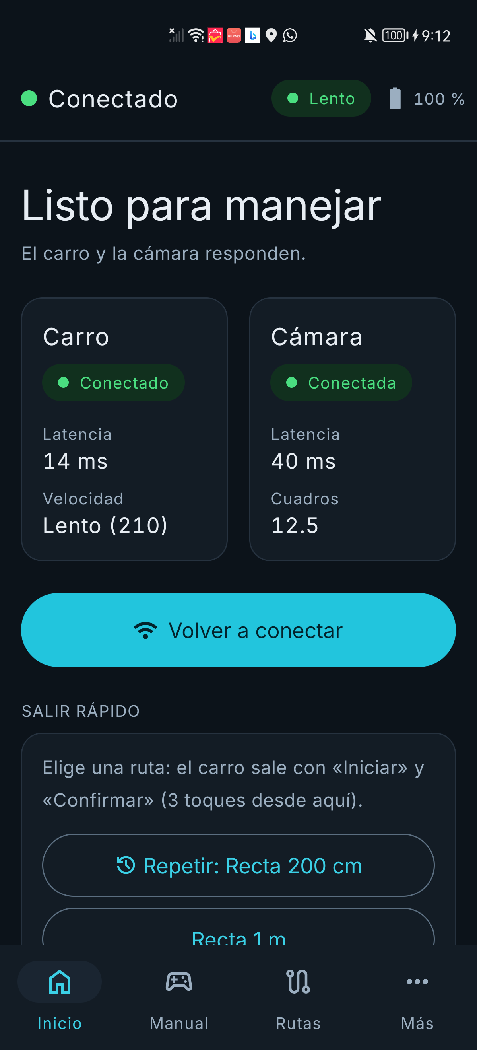
docs/imagenes/foto_10_app_conexion.png
