fernandosegrr/fsi_proyect/docs/imagenes/foto_12_app_editor_rutas.png

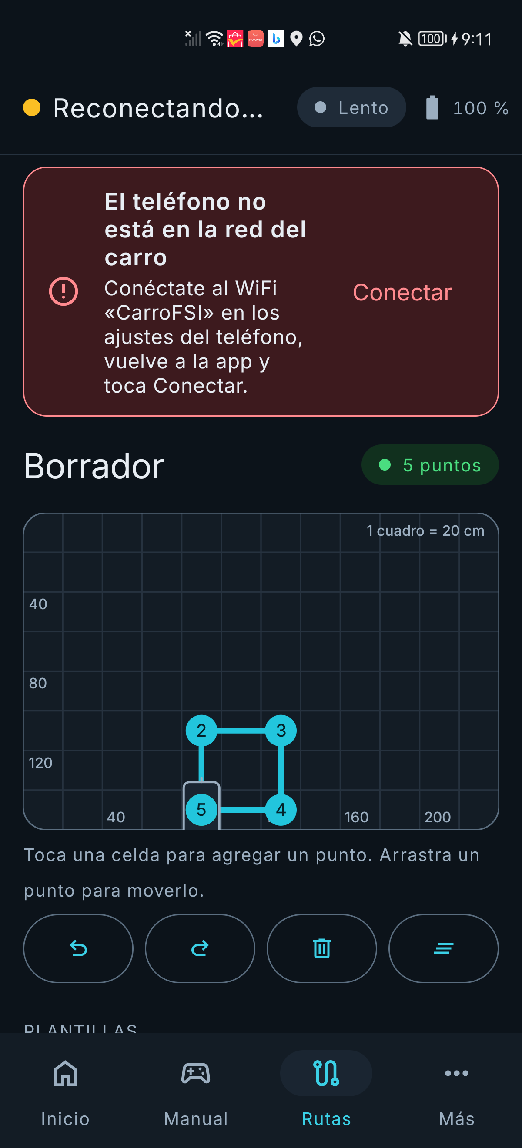
docs/imagenes/foto_12_app_editor_rutas.png
