fernandosegrr/fsi_proyect/docs/imagenes/foto_17_app_ajustes_red.png

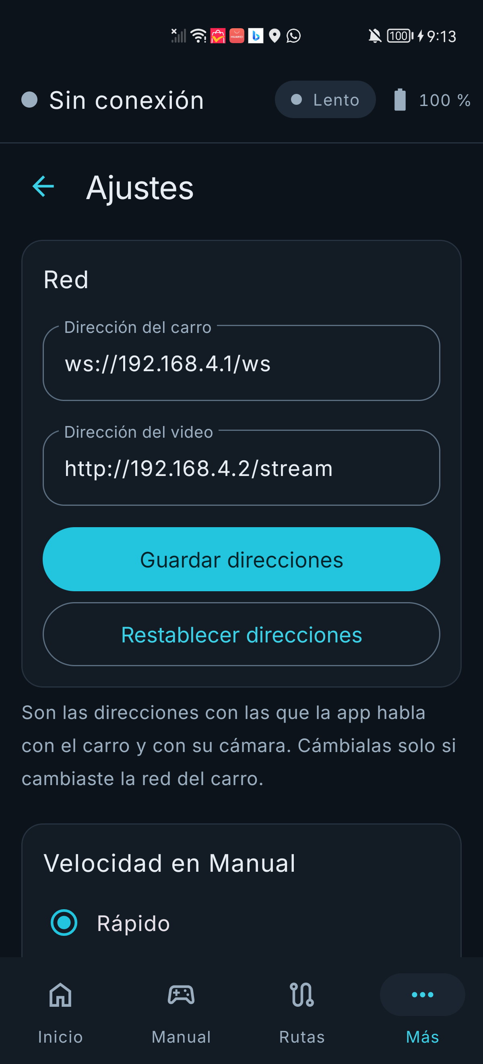
docs/imagenes/foto_17_app_ajustes_red.png
