fernandosegrr/fsi_proyect/docs/manual/plan_final.md

# Plan editorial y estructural del Manual Técnico — Versión final 1.1

Fecha: `2026-11-10`  
Rama: `docs/manual-final`  
Archivo de salida versionado: `docs/manual/Manual_Proyecto_Carro_FSI.pdf`  
Copia de entrega para release: `Manual_Proyecto_Carro_FSI_v1.1.pdf` (no versionada en Git)  
Extensión objetivo: **40 a 60 páginas** (tamaño A4, márgenes de ~2.2 cm, fuente `DejaVu` incrustada de 10 pt, cada capítulo en página nueva y ninguna página intermedia con más de la mitad en blanco).

---

## 1. Principios rectores de la Versión final 1.1

1. **Trazabilidad y honestidad experimental:**
   - En el Capítulo 1 se define **una sola vez** la convención de cuatro etiquetas de estado de evidencia que rige todo el documento:
     - **`VALIDADO EN EL CARRO` (o `VERIFICADO`):** comportamiento o cifra comprobada mediante pruebas ejecutadas en el vehículo físico o en las suites de pruebas automatizadas del repositorio, con registro trazable (`docs/pruebas_fisicas_20261110.csv`, `docs/estado_20261110.csv`, `docs/precision/calibracion_j14.txt`). En las pruebas de cierre J16 sobre el carro físico, **únicamente el esquive con reincorporación B6** (6 corridas el 10 de noviembre de 2026: 0 toques, 5 corridas completas autónomas con error lateral aproximado entre `~0` y `~10 cm` [`~10, ~10, ~5, ~0, ~0 cm`] y 1 corrida en `AYUDA` sin contacto y sin causa identificada) está validado en el carro con el firmware `FW:6d1b213-20261110` y la aplicación `APP:0.4-6d1b213`.
     - **`SIMULADO`:** comportamiento evaluado en el simulador físico-matemático del núcleo en C (`simulador_navegador.c`, `docs/precision/monte_carlo_1000.txt`, 1,000 corridas por escenario con semilla fija), sin atribuir esas cifras al desempeño en piso real.
     - **`NO MEDIDO`:** función implementada y probada en software o en banco lógico, pero sin corridas físicas registradas en el carro en este cierre (rectas con y sin control de rumbo `RUMBO`, ruta en L, cuadrado de 60 cm, corte de WiFi en marcha, freno autónomo aislado por láser, caja ancha de 40×20 cm, calibración en piso de `IMU_ESCALA`, pulso de mantenimiento en `GPIO 2`, consumo eléctrico de motores y placas).
     - **`PENDIENTE`:** mejora o trabajo futuro identificado en `docs/limites_conocidos.md` que aún no está implementado o medido.
2. **Integración completa de J16:**
   - Se documentan con detalle algorítmico, ejemplos numéricos y tablas todos los componentes del cierre J16: lazo PI de rumbo en rectas (`RUMBO:ON/OFF`, `RUMBO:<décimas>`, `RUMBO?`, `aprendido_mil`), escala del giroscopio en partes por millón (`IMU_ESCALA:<ppm>`, `IMU_ESCALA?`, persistencia en NVS y campo `IMUS` en `CAPS`), aviso `WD:<n>` del *watchdog* de comunicación, vigilancia activa en Android (`SILENCIO_SENS_MS = 1500 ms`, `WD`, `TOF_PARO` no atendido y corte del latido `FORWARD`), integración de pose en décimas de grado (`rumbo_x10`), margen longitudinal de esquive de `150 mm` (`NAV_PASO_MARGEN_MM`), corrección de `override_largo_mm` en `Recta 150 cm`, bandera `descartar_dt`, candado mutex `candado_vision` en JNI, validación de calibración guardada al abrir `Rutas`, resultados Monte Carlo (`1,000` corridas × 5 configuraciones) y resultados físicos B6 (6 corridas).
3. **Separación limpia entre explicación y rutas de código:**
   - En el cuerpo de los capítulos no se escriben rutas de carpetas ni números de línea (`config.h:66-76`).
   - Al final de cada capítulo del 1 al 15 aparece una sola línea `Dónde está en el código:` con los nombres de archivo relevantes (sin ruta ni líneas).
   - El **Anexo 16.3** concentra la tabla de correspondencia completa entre capítulos y rutas del repositorio.
4. **Exclusiones expresas:**
   - Queda fuera del manual el banco de preguntas de defensa oral ante el sínodo (conservado únicamente en `docs/exposicion.md`).
   - Quedan fuera todos los metadatos de proceso interno (`"Rama:"`, `"Estado: documento de referencia"`, `"Fuentes principales"`, `"por indicación del dueño"`, `"deae8b6"`, etc.) y el relleno repetitivo del antiguo Capítulo 17.

---

## 2. Estructura de capítulos y fuentes de información

| Cap. | Título del capítulo | Fuentes principales en `docs/` y código | Contenido clave y elementos visuales |
|---|---|---|---|
| **Portada + Índice** | Portada institucional e Índice general automático (2 pasadas) | Metadatos de Git y proyecto | Universidad de Guanajuato (DICIS), título, subtítulo, **Versión final 1.1**, fecha `10 de noviembre de 2026`, materia FSI, Dr. Horacio Rostro González, 4 integrantes, revisión Git. |
| **1** | **Introducción y cómo leer el manual** | `docs/README.md`, `docs/entrega.md`, `docs/estado_20261110.md` | Propósito del sistema LIDIA, alcance del prototipo, organización del manual y definición única de las etiquetas `VALIDADO EN EL CARRO`, `SIMULADO`, `NO MEDIDO` y `PENDIENTE` (Tabla 1). |
| **2** | **Arquitectura general** | `docs/arquitectura.md`, `docs/seguridad_fisica.md` | Diseño distribuido en 3 nodos (ESP32 DevKit, Freenove ESP32-WROVER, Android), por qué el teléfono ejecuta el cálculo pesado, separación eléctrica con 2 *powerbanks* + 4×AA, y defensa en profundidad de 4 capas. Incluye **Figura 1** (arquitectura), **Figura 2** (alimentación) y **Figura 3** (seguridad), más Tabla 2 (nodos y enlaces). |
| **3** | **Hardware y conexiones** | `docs/hardware.md`, `docs/inventario_hardware.md`, `firmware_carro/config.h` | Chasis omnidireccional de 4 motores TT, puente H TC1508A, ESP32 DevKit, cámara Freenove GC0308, giroscopio MPU6050 y láser VL53L0X en bus I2C (`GPIO 21/22`), tierra común, pulso `GPIO 2` (`NO MEDIDO`). Incluye **Figura 4** (lámina 2×2 de fotos del carro) y Tabla 3 (especificaciones y conexiones). |
| **4** | **Firmware del carro** | `docs/firmware_carro.md`, `docs/reporte_J16.md`, `firmware_carro/*.c/*.h` | Abstracción C99 (`hw_*`), cola de 32 comandos con prioridad `STOP`/`EBRAKE`, perfiles PWM `MANUAL` (`252/255`) y `AUTO` (`207/210`), arranque a potencia plena (`250 ms`), lazo PI de rumbo en rectas J16 (`rumbo.c`), giro cerrado por giroscopio (`giro.c`) y escala en ppm (`imu.c`), freno láser `TOF_PARO` (`120 mm`), *watchdog* de `1000 ms` (`WD:<n>`) y WDT de `5000 ms`, métricas `LOOP?`. Incluye **Figura 5** y Tablas 4 y 5. |
| **5** | **Cámara** | `docs/camara.md`, `camara_prueba/camara_prueba.ino`, `recuperacion.c` | Sensor GC0308 en HQVGA (`240×176`, RGB565 a 20 MHz), por qué HQVGA supera a QVGA en edad de cuadro, compresión JPEG por software (`JPEGENC` calidad 50), buzón de último cuadro, endpoints `/stream`, `/capture`, `/raw`, `/stats`, paquetes UDP `4210` de `1,244 B`, *benchmark* de 100 cuadros y máquina de recuperación (`recuperacion.c`). Incluye **Figura 6** y Tabla 6. |
| **6** | **Protocolo de comunicación** | `docs/protocolo.md`, `docs/reporte_J16.md`, `firmware_carro/carro.c` | Enlace WebSocket `ws://192.168.4.1/ws`, formato de órdenes de tracción, latido de `250 ms`, `PING`/`PONG` cada `800 ms`, telemetría `SENS:<ang_x10>,<mm>,<flags>` cada `100 ms`, cadena `CAPS` ampliada (`RUMBO=1,IMUS=<ppm>,FW:<ver>`), comandos J16 (`RUMBO`, `IMU_ESCALA`, `WD:<n>`) y ejemplo numérico de sesión. Incluye Tabla 7. |
| **7** | **Núcleo de navegación en C** | `docs/nucleo_c.md`, `docs/reporte_J16.md`, `nucleo_c/navegador.c`, `trayectoria.c`, `calibracion.c`, `calgiro.c` | Cuadrícula de `20 cm`, conversión de ruta a pasos, geometría de cuerda $c = 2R\sin(\theta/2)$ y escala `calgiro_escala`, máquina de estados del navegador, por qué se navega por tiempo con giroscopio, integración de pose en décimas de grado (`rumbo_x10`), guía `RUMBO` con punto de mira a `400 mm` y supresión de giros $\le 8^\circ$, esquive en 3 tramos con margen J16 de `150 mm`, corrección `override_largo_mm` y `descartar_dt`. Incluye **Figura 7**, **Figura 8** y Tabla 8. |
| **8** | **Visión y percepción** | `docs/vision_percepcion.md`, `nucleo_c/obstaculos.c`, `corredor.c`, `fusion.c`, `DetectorTflite.kt`, `puente.c` | Modelo de piso multiclúster en YCbCr/RGB, regla J10c de segundo color de piso en filas $<7$, máscara de artefactos fijos (`mascara_vision.c`), red EfficientDet-Lite0 en hilo dedicado (`300 ms`), corredor de perspectiva, reglas de fusión multimodal, autoridad opcional del láser a `400 mm` y candado mutex `candado_vision` en JNI. Incluye **Figura 9** y Tabla 9. |
| **9** | **Aplicación Android** | `docs/app_android.md`, `docs/reporte_J16.md`, `app_android/app/src/main/java/com/example/carro_ilib/*.kt` | Arquitectura de 4 pestañas (`Inicio`, `Manual`, `Rutas`, `Más`) y 5 actividades completas, sesiones compartidas `SesionCarro` y `SesionVideo`, corte de latido `FORWARD` ante `TOF_PARO` en `ControlLogica`, supervisión activa J16 en `ModoSemiautonomo` (`1.5 s` de silencio `SENS`, `WD:<n>`, `TOF_PARO`), validación de calibración al abrir `Rutas` y controles J16 en `SensoresActivity`. Incluye **Figura 10**, **Figura 11** y Tabla 10. |
| **10** | **Compilación, instalación y verificación de versión** | `docs/compilacion_instalacion.md`, `dist/SHA256SUMS.txt`, `dist/FIRMWARE_LOCAL.txt`, `scripts/verificar_version.py` | Herramientas requeridas, compilación del núcleo C y pruebas de firmware, `scripts/cargar.ps1` (`-SoloCompilar` y advertencia sobre sonda de puertos), compilación de APK, uso de `verificar_version.py`, artefactos validados (`APP:0.4-6d1b213` y `FW:6d1b213-20261110` con hashes SHA-256) y por qué no se publica el `.bin`. Incluye Tabla 11. |
| **11** | **Operación y seguridad física** | `docs/operacion.md`, `docs/seguridad_fisica.md` | Lista de verificación previa al encendido, secuencia de energización de las 3 fuentes, comprobación de sensores en `Sensores`, conducción manual, aprendizaje de piso y ejecución supervisada de rutas, jerarquía de paro de emergencia y regla operativa de cambio/recarga de pilas AA cada 20 corridas o 90 minutos. Incluye Tabla 12. |
| **12** | **Pruebas y resultados** | `docs/pruebas_fisicas_20261110.csv`, `docs/estado_20261110.md`, `docs/precision/monte_carlo_1000.txt`, `docs/precision/calibracion_j14.txt`, `docs/pruebas.md` | Separación estricta en 4 bloques: **12.1 Validado en el carro** (las 6 corridas B6 del 10 de noviembre de 2026 con todos sus matices + mediciones físicas J13/J14), **12.2 Pruebas de software en PC** (`1,655` + `540` + `54` + `18` casos y sanitizadores), **12.3 Simulación Monte Carlo J16** (`1,000` corridas × 5 configuraciones), **12.4 Escenarios no medidos en el carro**. Incluye Tablas 13, 14, 15 y 16. |
| **13** | **Límites y trabajo futuro** | `docs/limites_conocidos.md`, `docs/reporte_J16.md` | Límites estructurales del prototipo (avance por tiempo sin odometría de rueda, deslizamiento lateral mecanum invisible al giroscopio, profundidad supuesta de `250 mm`, giros residuales $<5^\circ$ por tiempo observados en la Corrida 2, obstáculos del color del piso, límite de 6 dígitos en `RUMBO`), desglose de elementos `NO MEDIDOS` y hoja de ruta de trabajo futuro (`PENDIENTE`). Incluye Tabla 17. |
| **14** | **Proceso de desarrollo** | `docs/bitacora_desarrollo.md`, `docs/decisiones_diseno.md` | Evolución técnica en 5 etapas (de 2 a 3 páginas, sin códigos de jornada en los títulos): prototipo monolítico, separación del núcleo en C y puente JNI, integración de cámara y visión multimodal, incorporación de giroscopio y láser, y cierre de precisión con control de rumbo y validación física del esquive. Incluye **Figura 12**. |
| **15** | **Solución de problemas** | `docs/solucion_problemas.md`, `docs/operacion.md` | Método sistemático de diagnóstico (aislar una variable por vez con el carro elevado) y guía práctica por síntoma para red WiFi, flujo de cámara, tracción y puente H, sensores I2C (`MPU6050`/`VL53L0X`), desviación en rutas y errores de versión. Incluye Tabla 18. |
| **16** | **Anexos** | Todos los módulos del repositorio | **16.1** Glosario técnico; **16.2** Referencia rápida de comandos del protocolo y mapa completo de pines GPIO (Tablas 19 y 20); **16.3** Correspondencia entre capítulos y rutas de archivos del repositorio (Tabla 21); **16.4** Lista consolidada de mediciones físicas y tareas pendientes (Tabla 22). |

---

## 3. Lista de figuras y láminas (numeradas en orden de aparición)

Todas las figuras se generan mediante `python docs/figuras/generar_figuras.py` con paleta unificada (`#163c60` azul marino, `#00877e` verde azulado, `#e76f51` coral, `#2d6a4f` verde bosque, `#f4f7f9` fondo suave), tipografía `DejaVu Sans` legible ($\ge 8.5$ pt al tamaño impreso) y sin metadatos internos (`"Fuente: docs/..."`) ni nombres de archivo dentro de la imagen:

1. **Figura 1 (`fig_01_arquitectura.png`, Cap. 2):** Arquitectura distribuida de tres nodos (ESP32 DevKit `192.168.4.1`, cámara Freenove `192.168.4.2` y teléfono Android) con sus enlaces WiFi/I2C/PWM y sus tres fuentes de energía independientes.
2. **Figura 2 (`fig_02_alimentacion.png`, Cap. 2):** Esquema de alimentación eléctrica y tierra común (`GND` compartido entre portapilas 4×AA, driver TC1508A y ESP32 DevKit; *powerbank* USB 1 dedicada a la DevKit; *powerbank* USB 2 dedicada a la cámara Freenove).
3. **Figura 3 (`fig_03_seguridad.png`, Cap. 2):** Defensa en profundidad de cuatro capas de seguridad física y lógica (Operador, Supervisión Android J16, *Watchdog* de firmware `1000 ms` + `WD:<n>`, y paro frontal láser `TOF_PARO` a `120 mm`).
4. **Figura 4 (`lamina_carro.png`, Cap. 3):** Lámina 2×2 de cuatro fotografías del vehículo físico (vista frontal con cámara y láser, vista superior de la electrónica, vista tres cuartos y detalle del cableado sobre la protoboard).
5. **Figura 5 (`fig_05_flujo_comandos.png`, Cap. 4):** Flujo de comandos y telemetría entre la aplicación y el firmware (`WebSocket /ws`, cola de 32 ranuras con prioridad `STOP`, lazo `loop()`, controlador PI `RUMBO`, giro `GIRO` y envío de `SENS` / `WD`).
6. **Figura 6 (`fig_06_modos_camara.png`, Cap. 5):** Modos de transmisión de la cámara Freenove (`/stream` MJPEG para vista humana, `/raw` RGB565 y paquetes UDP `:4210` de `1,244` bytes para rejilla `24×17` en tiempo real).
7. **Figura 7 (`fig_07_ciclo_navegacion.png`, Cap. 7):** Ciclo de control del navegador en C (`trayectoria.c` → avance con referencia `RUMBO` y punto de mira a `400 mm` → giro cerrado con `MPU6050` → integración de pose en décimas de grado `rumbo_x10`).
8. **Figura 8 (`fig_08_maniobra_esquive.png`, Cap. 7):** Geometría de la maniobra de esquive y reincorporación en tres tramos (desvío lateral de `40 cm`, avance paralelo con margen J16 de `150 mm` y regreso a la línea original `30 cm` adelante; validada físicamente en el escenario B6 con 5/6 corridas autónomas y 0/6 toques).
9. **Figura 9 (`fig_09_tuberia_vision.png`, Cap. 8):** Tubería multimodal de visión y percepción (clasificador de piso YCbCr/RGB + red neuronal EfficientDet-Lite0 + corredor de perspectiva + láser VL53L0X → fusión bajo `candado_vision`).
10. **Figura 10 (`fig_10_mapa_app.png`, Cap. 9):** Mapa de navegación de la aplicación Android (4 pestañas principales, 5 actividades de pantalla completa y sesiones compartidas `SesionCarro` y `SesionVideo`).
11. **Figura 11 (`lamina_app.png`, Cap. 9):** Lámina comparativa de tres capturas de la aplicación Android ilustrando los tres estados de enlace: (a) conectado a `CarroFSI` en pestaña `Inicio`, (b) reconectando fuera de la red en pestaña `Rutas`, y (c) sin conexión activa en `Ajustes`.
12. **Figura 12 (`fig_12_linea_tiempo.png`, Cap. 14):** Evolución arquitectónica del sistema en cinco etapas técnicas (desde el control básico por WiFi hasta el cierre de precisión J16 y la validación física del esquive).
