fernandosegrr/fsi_proyect/docs/pruebas_fisicas_20261110.csv

corrida | hora | prueba | ruta | rumbo_on | autoridad_laser | escala_ppm | x_medido_cm | y_medido_cm | angulo_medido_grados | toco_caja | ayuda | esquivadas | x_est_mm | y_est_mm | rumbo_est_grados | rumbo_aprendido_fw | observaciones
0 | 21:11 | P0_P2_B0 | Sensores | true | true | 0 | 0 | 0 | 0 | no | no | 0 | 0 | 0 | 0 | 0 | CAPS:IMU=1,TOF=1,TOFR=0,IMUR=1,IMUM=0,IMUE=2,RUMBO=1,IMUS=0,FW:6d1b213-20261110; ANT:114,191,20,20; bateria 78%
1 | 21:31 | B6_P9 | recta_200 | true | true | 0 | 10 | 200 | 0 | no | no | 1 | 394 | -4 | 357 | 28 | 16 s; 1 esquiva limpia (giros 90->91, 90->89, 71->71, 65->64); rumbo_objetivos_enviados=15; ~10 cm a la derecha (medida aproximada), sin tocar caja
2 | 21:33 | B6_P9 | recta_200 | true | true | 0 | 10 | 200 | 0 | no | no | 1 | 383 | 8 | 0 | -13 | 18 s; 1 esquiva limpia (giros 90->87, 90->90, 77->80, 75->73, 4->18 tiempo, 14->17 giro); rumbo_objetivos_enviados=7; ~10 cm a la derecha (medida aproximada), sin tocar caja
3 | 21:35 | B6_P9 | recta_200 | true | true | 0 | 5 | 200 | 5 | no | no | 1 | 401 | 1 | 2 | -13 | 16 s; 1 esquiva limpia (giros 90->88, 90->90, 77->77, 78->83, 4->5 tiempo); rumbo_objetivos_enviados=16; ~5 cm a la derecha (medida aproximada) con leve inclinacion a la derecha, sin tocar caja
4 | 21:38 | B6_P9 | recta_200 | true | true | 0 | 0 | 200 | 0 | no | no | 1 | 401 | 10 | 356 | -8 | 18 s; 1 esquiva limpia (giros 90->90, 90->90, 86->85, 85->90, 6->8 giro); rumbo_objetivos_enviados=16; ~0 cm (medida aproximada, quedo sobre la recta), sin tocar caja
5 | 21:41 | B6_P9 | recta_200 | true | true | 0 | 80 | 100 | 69 | no | si | 0 | 1203 | 876 | 0 | 16 | Entro en AYUDA en punto 4/10 (sin tocar caja y sin causa identificada) pese a tener espacio libre; se uso cruceta de ayuda y Continuar la ruta cuando vencio espera_ruta_s=60s
6 | 21:43 | B6_P9 | recta_200 | true | true | 0 | 0 | 200 | 0 | no | no | 1 | 386 | -8 | 1 | 6 | 18 s; 1 esquiva limpia (giros 90->93, 90->91, 89->92, 85->85, 5->6 giro); rumbo_objetivos_enviados=6; ANT=109,168,20,20; ~0 cm (medida aproximada, quedo sobre la recta), sin tocar caja
