fernandosegrr/fsi_proyect/docs/precision/calibracion_j14.txt

-- Parte C: Monte Carlo (SIMULADO), 1000 corridas por escenario y configuracion --
J16 escenario=recta_100 config="J14 (lo que corrio en B4-B6)" n=1000 error_mm media=55 p50=56 p95=95 max=121 | lateral p95=95 | longitudinal media=21 p95=42 | rumbo_x10 media=60 p95=99 | real_vs_estimado p95=95 | llegan=1000 toques=0 ayuda=0 esquivas=0
J16 escenario=recta_150 config="J14 (lo que corrio en B4-B6)" n=1000 error_mm media=137 p50=137 p95=232 max=279 | lateral p95=232 | longitudinal media=96 p95=160 | rumbo_x10 media=94 p95=157 | real_vs_estimado p95=232 | llegan=1000 toques=0 ayuda=0 esquivas=0
CALIBRACION B4 recta (160 cm en J14): medido 55 mm -> percentil 9 medido 150 mm -> percentil 57 medido 180 mm -> percentil 73 medido 200 mm -> percentil 82
J16 escenario=recta_200 config="J14 (lo que corrio en B4-B6)" n=1000 error_mm media=210 p50=213 p95=347 max=410 | lateral p95=347 | longitudinal media=43 p95=97 | rumbo_x10 media=117 p95=195 | real_vs_estimado p95=347 | llegan=1000 toques=0 ayuda=0 esquivas=0
J16 escenario=giro_45 config="J14 (lo que corrio en B4-B6)" n=1000 error_mm media=91 p50=88 p95=168 max=223 | lateral p95=163 | longitudinal media=28 p95=62 | rumbo_x10 media=68 p95=126 | real_vs_estimado p95=155 | llegan=1000 toques=0 ayuda=0 esquivas=0
J16 escenario=giro_90 config="J14 (lo que corrio en B4-B6)" n=1000 error_mm media=78 p50=78 p95=131 max=168 | lateral p95=128 | longitudinal media=24 p95=59 | rumbo_x10 media=79 p95=130 | real_vs_estimado p95=120 | llegan=1000 toques=0 ayuda=0 esquivas=0
J16 escenario=giro_180 config="J14 (lo que corrio en B4-B6)" n=1000 error_mm media=101 p50=100 p95=180 max=233 | lateral p95=178 | longitudinal media=21 p95=55 | rumbo_x10 media=64 p95=128 | real_vs_estimado p95=168 | llegan=1000 toques=0 ayuda=0 esquivas=0
J16 escenario=ruta_L config="J14 (lo que corrio en B4-B6)" n=1000 error_mm media=146 p50=145 p95=233 max=284 | lateral p95=224 | longitudinal media=48 p95=104 | rumbo_x10 media=112 p95=178 | real_vs_estimado p95=223 | llegan=1000 toques=0 ayuda=0 esquivas=0
J16 escenario=cuadrado config="J14 (lo que corrio en B4-B6)" n=1000 error_mm media=67 p50=65 p95=125 max=195 | lateral p95=102 | longitudinal media=43 p95=82 | rumbo_x10 media=108 p95=194 | real_vs_estimado p95=114 | llegan=1000 toques=0 ayuda=0 esquivas=0
J16 escenario=esquive_20x20 config="J14 (lo que corrio en B4-B6)" n=1000 error_mm media=200 p50=200 p95=324 max=408 | lateral p95=324 | longitudinal media=51 p95=121 | rumbo_x10 media=119 p95=189 | real_vs_estimado p95=307 | llegan=1000 toques=49 ayuda=0 esquivas=1000
CALIBRACION B6-4 esquive: medido 400 mm -> percentil 99
J16 escenario=esquive_ancha config="J14 (lo que corrio en B4-B6)" n=1000 error_mm media=202 p50=203 p95=320 max=797 | lateral p95=320 | longitudinal media=51 p95=120 | rumbo_x10 media=120 p95=189 | real_vs_estimado p95=306 | llegan=998 toques=46 ayuda=2 esquivas=1022
0 casos, 0 fallos
