fernandosegrr/fsi_proyect/docs/pruebas_fisicas_plantilla.csv

corrida | fecha | hora | prueba | ruta | obstaculo | posicion_obstaculo_cm | luz | firmware_carro_caps | firmware_camara | umbral_color | min_celdas | fila_minima_pct | detector_objetos | autoridad_laser | rumbo_on | bateria_carro | resultado | causa_ayuda | contacto | con_que_toco | esquivadas | hizo_vistazo | retrocedio | paradas_sin_motivo | error_largo_cm | error_lateral_cm | angulo_final_grados | duracion_s | caja_negra_archivo | foto_resultado | observaciones
1 | 2026-11- |  | A1 | recta_150 | ninguno |  |  |  |  | 40 | 7 | 44 | si | si | si |  |  |  | no |  | 0 | no | no | 0
2 | 2026-11- |  | A1 | recta_150 | ninguno |  |  |  |  | 40 | 7 | 44 | si | si | si |  |  |  | no |  | 0 | no | no | 0
3 | 2026-11- |  | A1 | recta_150 | ninguno |  |  |  |  | 40 | 7 | 44 | si | si | si |  |  |  | no |  | 0 | no | no | 0
4 | 2026-11- |  | A2 | recta_150 | pared_tras_destino | 60 despues del destino |  |  |  | 40 | 7 | 44 | si | si | si
5 | 2026-11- |  | B1 | recta_150 | caja_20x20 | 90 centrada |  |  |  | 40 | 7 | 44 | si | si | si
6 | 2026-11- |  | B2 | recta_150 | caja_20x20 | 90 corrida 15 a un lado |  |  |  | 40 | 7 | 44 | si | si | si
7 | 2026-11- |  | B3 | recta_200 | banquito_35x45 | 90 centrado |  |  |  | 40 | 7 | 44 | si | si | si
8 | 2026-11- |  | B4 | recta_250 | objeto_largo_90 | 90 centrado |  |  |  | 40 | 7 | 44 | si | si | si
9 | 2026-11- |  | B5 | recta_150 | pared_al_frente | 90 |  |  |  | 40 | 7 | 44 | si | si | si
10 | 2026-11- |  | C1 | recta_150 | sombra | 50 delante del carro |  |  |  | 40 | 7 | 44 | si | si | si
11 | 2026-11- |  | C2 | recta_150 | mancha_de_luz_a_un_lado |  |  |  |  | 40 | 7 | 44 | si | si | si
12 | 2026-11- |  | C3 | recta_150 | mancha_de_luz_en_la_linea |  |  |  |  | 40 | 7 | 44 | si | si | si
13 | 2026-11- |  | C4 | recta_150 | cambio_de_luz_tras_aprender |  |  |  |  | 40 | 7 | 44 | si | si | si
14 | 2026-11- |  | D1 | recta_200 | corte_de_wifi |  |  |  |  | 40 | 7 | 44 | si | si | si
15 | 2026-11- |  | D2 | recta_200 | camara_tapada_2s |  |  |  |  | 40 | 7 | 44 | si | si | si
16 | 2026-11- |  | D3 | recta_150 | detector_apagado |  |  |  |  | 40 | 7 | 44 | no | si | si
17 | 2026-11- |  | D4 | ruta_L | ninguno |  |  |  |  | 40 | 7 | 44 | si | si | si
18 | 2026-11- |  | D5 | cuadrado_100 | ninguno |  |  |  |  | 40 | 7 | 44 | si | si | si
19 | 2026-11- |  | D6 | recta_300 | dos_cajas | 90 y 170 |  |  |  | 40 | 7 | 44 | si | si | si
20 | 2026-11- |  | D7 | ninguna | pared_a_10_cm | 10 |  |  |  | 40 | 7 | 44 | si | si | si
21 | 2026-11- |  | B6 | recta_150 | caja_20x20_y_pared_a_un_lado | 90 centrada; pared a 30-40 de la linea |  |  |  | 40 | 7 | 44 | si | si | si |  |  |  |  |  |  |  |  |  |  |  |  |  |  |  | lado del primer giro:
22 | 2026-11- |  | D8 | ruta_L | caja_20x20 | 50 antes de la esquina |  |  |  | 40 | 7 | 44 | si | si | si
