fernandosegrr/fsi_proyect/docs/imagenes/foto_15_app_calibracion_giro.png

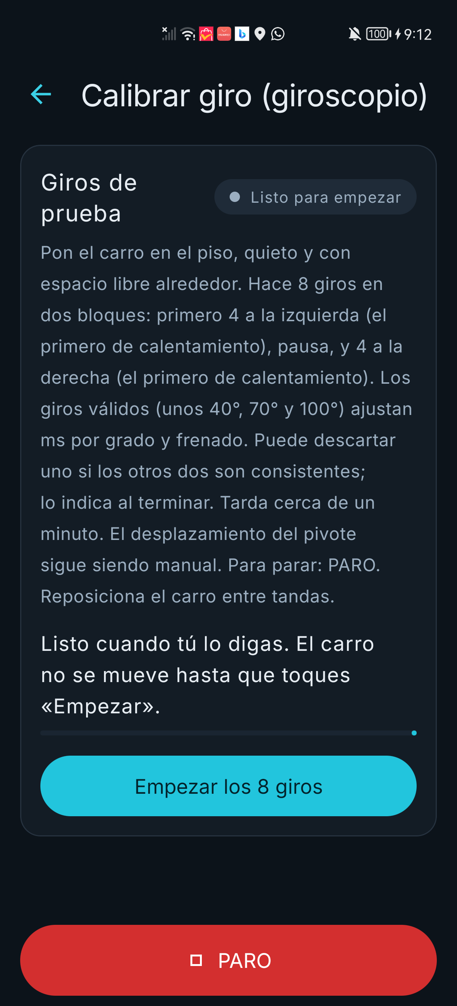
docs/imagenes/foto_15_app_calibracion_giro.png
