fernandosegrr/fsi_proyect/docs/solucion_problemas.md

# Guía de solución de problemas (Troubleshooting)

**Materia:** Fundamentos de los Sistemas de Información (FSI)  
**Propósito:** Matriz de diagnóstico rápido de fallas comunes en hardware, red, firmware y aplicación móvil.  
**Fecha:** 27 de octubre de 2026  

---

## 1. Matriz de síntomas y acciones correctivas

| Síntoma observado | Causa más probable | Procedimiento de comprobación y solución |
|---|---|---|
| **La red WiFi del carro no aparece en el teléfono.** | La placa ESP32 DevKit no recibe energía o se encuentra en bucle de arranque. | 1. Verificar que el LED rojo de la placa DevKit esté encendido.<br>2. Probar con otro cable micro-USB (algunos cables comerciales solo transmiten carga y no datos o tienen hilos partidos).<br>3. Confirmar que la powerbank esté encendida y entregue 5 V.<br>4. Si el LED parpadea erráticamente, conectar el ESP32 a la PC y abrir el monitor serie a 115200 baudios para inspeccionar mensajes de pánico. |
| **La app conecta pero el video de la cámara aparece en negro o no carga.** | La placa de la cámara no logró asociarse al WiFi o tiene asignada otra IP. | 1. Comprobar que la placa Freenove tenga su LED encendido.<br>2. Asegurarse de encender el DevKit antes o casi al mismo tiempo que la cámara.<br>3. Abrir el navegador del teléfono e ingresar a `http://192.168.4.2/stream`. Si abre en el navegador pero no en la app, verificar en `Ajustes → Red` que la URL de video apunte exactamente a esa dirección.<br>4. Si no responde en el navegador, reiniciar la placa de la cámara (el vigilante interno de `recuperacion.c` se reiniciará solo tras 60 s). |
| **Los motores no se mueven aunque la app indique comando activo.** | El portapilas de motores está apagado, las pilas están agotadas o falta la tierra común. | 1. Verificar que el interruptor físico del portapilas esté en **ON**.<br>2. Medir con multímetro el voltaje del portapilas (debe ser $\ge 4.8\text{ V}$). Reemplazar las pilas AA si están descargadas.<br>3. **Verificar el cable de tierra común (GND):** Comprobar con multímetro en modo continuidad que el pin GND del driver TC1508A esté unido al pin GND de la placa ESP32. |
| **El carro gira sobre su propio eje o va hacia atrás al pulsar Adelante.** | Polaridad invertida en los cables de los motores. | Los motores TT se cablean por pares en paralelo. Verificar contra `firmware_carro/config.h`: el motor izquierdo avanza con GPIO 26 (`PIN_MOTOR_IZQ_B`) y el derecho con GPIO 25 (`PIN_MOTOR_DER_A`). Intercambiar los cables rojo y negro del canal invertido en la bornera del driver. |
| **El carro se desvía fuertemente hacia un lado al avanzar en línea recta.** | Asimetría mecánica en las reductoras o balance descalibrado. | 1. Revisar que las ruedas de hule estén bien encajadas en el eje y que ningún cable esté rozando los neumáticos.<br>2. Acceder a `CalibracionActivity` en la app o consultar el factor con `BAL?`.<br>3. Si se desvía a la derecha, reducir el factor de balance izquierdo con `BAL_AUTO:NNN` (ej. bajar de 986 a 920). Si se desvía a la izquierda, aumentarlo hacia 1000. |
| **El carro avanza durante 1 segundo exacto y se frena solo.** | Disparo del Watchdog de comunicación (1000 ms). | Esto es un comportamiento normal de protección cuando se pierde el flujo de comandos. Ocurre si: (a) el usuario soltó el botón de la app, (b) el teléfono saltó automáticamente a otra red WiFi con internet (desactivar «Asistente WiFi» en Android), o (c) hay alta congestión de radio. |
| **El ángulo del giroscopio cambia rápidamente sin que el carro se mueva.** | Sesgo (*bias*) mal calibrado por vibración durante el arranque. | El MPU6050 calibra su sesgo al encender. Si el chasis se movió o vibró durante esos primeros 2.5 segundos, el sesgo queda corrupto. **Solución:** Colocar el carro completamente inmóvil sobre el suelo y pulsar el botón **Calibrar IMU** en la pantalla `SensoresActivity` (comando `IMU_CAL`). |
| **El sensor ToF reporta distancia errática o 0 mm.** | Suciedad en el lente óptico o cable I2C flojo. | 1. Limpiar suavemente con un paño seco la superficie del sensor VL53L0X.<br>2. Enviar el comando `CAPS?` desde la app. Si responde `TOF=0`, el microcontrolador no detectó el sensor en el bus (revisar conexiones físicas de SDA en GPIO 21 y SCL en GPIO 22). |
| **La powerbank se apaga sola cada 30 a 60 segundos.** | El circuito de bajo consumo de la powerbank interpreta que no hay carga. | La electrónica de control consume poca corriente en reposo. Comprobar que el pin keep-alive (GPIO 2) esté configurado y emitiendo pulsos periódicos de 50 ms cada 2 s (`KEEPALIVE_PERIODO_MS`), o utilizar una batería portátil con modo continuo (*low current mode*). |
