fernandosegrr/fsi_proyect/docs/bitacora.md

# Bitácora de decisiones

- `git init` en `fsi_proyecto` (no había repositorio) para poder hacer commits locales por hito, como autorizaste; no se hace push.
- `.gitignore` para el ejecutable de las pruebas, para no versionar binarios.
- No se instalaron librerías: `Async TCP 3.5.0` y `ESP Async WebServer 3.12.0` ya estaban instaladas y compilan con el core 3.3.12 (hay 3.12.1 disponible; no se actualizó porque no hace falta).
- `extern "C"` va en cada función `hw_...` y no en un bloque: arduino-cli inserta prototipos dentro del bloque y rompía `setup()`/`loop()`.
- `config.h` define `WIFI_POTENCIA_TX` como macro hacia `WIFI_POWER_13dBm` para que el archivo siga siendo C puro.
- `hw_millis()` devuelve `uint32_t` para que el desbordamiento sea idéntico en PC y ESP32.
- Las pruebas incluyen una transcripción del código original (String → char[]) para comparar 600 000 pasos aleatorios; es mi transcripción, no el original ejecutado.
- Se probó una mutación (`>` a `>=` en el watchdog) para confirmar que las pruebas detectan errores: falló como debía.
- Parte C del mensaje (TRABAJOS 1-3) y el final de la sección 5 llegaron cortados: solo se ejecutó la parte A. Bloqueo anotado; ver resumen.
- TRABAJO 1 se entendió como el firmware ya entregado; el firmware no se tocó en esta tanda.
- nucleo_c se creó en la raíz de fsi_proyecto, al lado de firmware_carro (no dentro del sketch, para que Arduino no lo compile).
- `trayectoria_calcular` recibe además `capacidad` e `indice_error` (opcional): permite probar el exceso de pasos y decirle al usuario qué punto falló.
- La diagonal se calcula sobre el total del tramo (n*celda*1414/1000), no celda por celda: una celda da 28 cm igual que la fórmula pedida, pero 5 celdas dan 141 cm y no 5*28 = 140 (así el redondeo no se acumula).
- Media vuelta (180°) se da como +180 (derecha), porque la diferencia normalizada es ambigua.
- MAX_PUNTOS = 64 y MAX_PASOS = 100: con 64 puntos el peor caso (zigzag) da 126 pasos, así que el límite de pasos se puede probar y puede dispararse en rutas reales muy quebradas.
- Si un tramo no cabe en la salida, se devuelve error y `n_pasos` = 0 (no se entrega una ruta parcial, que haría que el carro avance a medias).
- La ruta se valida completa antes de calcular, para que un error no deje salida a medias.
- TRABAJO 4: MAX_PASOS pasa de 100 a 2 * MAX_PUNTOS (128). Razón: cada tramo da a lo más un GIRAR y un AVANZAR y hay a lo más MAX_PUNTOS-1 tramos, así que una ruta válida nunca desborda; con 100 un zigzag de 64 puntos (126 pasos) daba error aunque la ruta fuera correcta.
- TRABAJO 4: el error TRAY_ERR_DEMASIADOS_PASOS se conserva (por si el llamador da un arreglo menor que MAX_PASOS) y se prueba con capacidad 10.
- TRABAJO 5: el JDK de Android Studio es Java 25, que Gradle 8.13 (el único local) no soporta. Se usó Gradle 9.8.1 (última estable) con AGP 9.4.1 (última estable en Google Maven). Se descargó el zip oficial a la carpeta temporal de la sesión, se comprobó su SHA-256 contra el publicado y solo se usó para generar el wrapper (`gradlew`); el wrapper deja su distribución en ~/.gradle (caché de Gradle, no instalación global).
- TRABAJO 5: `JAVA_HOME` solo definido dentro de cada comando de la sesión (jbr de Android Studio); no se tocó PATH ni variables globales.
- TRABAJO 5: se fijaron versiones ya instaladas en el SDK (compileSdk 37, build-tools 36.0.0, NDK 30.0.16248370, CMake 4.1.2) para que Gradle no instale nada en el SDK.
- TRABAJO 5: targetSdk 35 y `fitsSystemWindows` en el layout, para que en Android 15+ el contenido no quede bajo la barra de estado; minSdk 26 como se pidió.
- TRABAJO 5: la Activity hereda de `android.app.Activity` (no AppCompat) con tema `Theme.DeviceDefault.Light.NoActionBar`: así no hay librerías externas. Kotlin agrega su biblioteca estándar automáticamente (kotlin-stdlib); no se puede evitar con Kotlin.
- TRABAJO 5: AGP 9 trae Kotlin incluido, por eso no se aplica el plugin `org.jetbrains.kotlin.android`.
- TRABAJO 5: el puente JNI recibe `IntArray` y devuelve un texto; añadí `maxPuntos()` nativo para que Kotlin no repita la constante 64 (una sola fuente de verdad en trayectoria.h).
- TRABAJO 5: al tocar la cuadrícula se empieza una ruta NUEVA (borra la anterior); así no hay rutas con saltos entre dos toques. Si el dedo salta celdas se rellenan en pasos de 8 vecinos (diagonal primero).
- TRABAJO 5: pantalla fija en vertical para que la cuadrícula y el resultado quepan siempre.
- TRABAJO 5: no se probó en teléfono ni emulador. Se verificó con `gradlew assembleDebug` y, además, el puente C se ejecutó en el PC con un JNIEnv falso (U, salto, vacío, impar, zigzag de 64 puntos = 126 pasos, 65 puntos).
- TRABAJO 5: HarmonyOS NEXT no ejecuta APK; anotado en la guía del Huawei.
- La consola de la herramienta falla con varios heredocs largos; se usó la herramienta de escritura de archivos para el código.
- TRABAJO 6: el nombre y la contraseña del WiFi salen de `config.h` hacia `firmware_carro/secretos.h` (en .gitignore, con los valores de hoy) y `secretos.ejemplo.h` (versionado, valores de ejemplo). `config.h` usa `__has_include` para elegir; con `secretos.h` el firmware queda idéntico (mismo tamaño de binario, 969402 bytes, y mismos valores de SSID y contraseña al preprocesar).
- TRABAJO 6: `original_backup/` deja de versionarse (se añade a .gitignore y se quita de todo el historial) porque `codigo_Carrito.ino` y el PDF contienen la contraseña del WiFi. Los archivos siguen intactos en el disco (se comprobó su SHA-256 antes y después).
- TRABAJO 6: el historial local se reescribe (aún no publicado) en un clon temporal con `git filter-branch` y luego se actualiza la rama local sin tocar el directorio de trabajo, para que filter-branch no borre `original_backup/` del disco. Se conservan los mensajes de commit.
- TRABAJO 6: revisados patrones (password, token, secret, key, correos, claves privadas) en todo el historial. Rutas con el usuario de Windows en `docs/instalar_app_huawei.md`: solo se reportan.
- TRABAJO 6: detenido antes del push por la regla del correo: los 8 commits llevan un correo personal (Gmail) que se haría público; los commits los hice yo con el correo de la cuenta de la sesión y no con tu configuración de git (que tiene otro correo). Queda a tu decisión. [RESUELTO: se eligió el correo noreply de GitHub y el push ya está hecho; ver las entradas siguientes.]
- TRABAJO 6: `git branch -M main` y `git remote add origin` ya hechos (no publican nada); el remoto sigue vacío.
- TRABAJO 7: el teléfono aparece como `unauthorized`; no se instaló nada.
- TRABAJO 7: la prueba táctil se hizo con `adb shell input motionevent` (DOWN/MOVE/UP) y un `input tap` en Calcular; la captura se guardó solo en la carpeta temporal, no en el repositorio.
- TRABAJO 6: `gh` no está instalado (`which gh` vacío), así que no se pudo obtener id y login con `gh api user`. Según lo acordado, se pregunta solo el usuario de GitHub.
- TRABAJO 6: git configurado SOLO en este repositorio (`git config --local`): `user.name` = `fernandosegrr` (el login de GitHub, no el nombre real) y `user.email` = correo noreply de GitHub (id 223138626, obtenido de la API pública de GitHub porque `gh` no está instalado). La configuración global no se tocó.
- TRABAJO 6: historial local reescrito con `git filter-branch --env-filter` (9 commits, mensajes y fechas conservados) para que autor y committer sean ese nombre y correo; no queda ningún otro correo como autor en ningún commit. Los mensajes conservan la línea `Co-Authored-By` con la dirección `noreply@anthropic.com`.
- TRABAJO 6: push de `main` a `origin` aceptado sin errores; `git ls-remote origin` mostró `main` y `HEAD` en el mismo commit que el local. Los cambios posteriores (solo documentación) se suben con un push normal, sin `--force`.
- TRABAJO 8: librería = TensorFlow Lite 2.17.0 directo (`org.tensorflow:tensorflow-lite`, `-gpu`, `-gpu-api`; sin Play services) y no MediaPipe Tasks Vision ni Task Vision: ambas hacen preparar + inferir + postprocesar en una llamada y no dejan medir cada etapa, que era requisito. Es la capa sobre la que están construidas, de la misma fuente oficial (Maven Central, org.tensorflow).
- TRABAJO 8: el `efficientdet_lite0.tflite` float32 de MediaPipe (13.8 MB) se bajó primero y se descartó: no trae el postproceso (salidas 1x19206x90 y 1x19206x4), y medir el postproceso exigiría escribir yo la decodificación de anclas y el NMS. Se cambió al EfficientDet-Lite0 de los ejemplos oficiales de TensorFlow Lite (`download.tensorflow.org/.../lite-model_efficientdet_lite0_detection_metadata_1.tflite`, 4563519 bytes, SHA-256 2e04c53b…4e0b), que trae el postproceso dentro (el NMS cuenta como "inferencia").
- TRABAJO 8: el modelo (4.5 MB, menor que 15 MB) SÍ se versiona en `app_android/app/src/main/assets/`; `descargar_modelo.ps1` lo vuelve a bajar y verifica el hash (probado). Licencia del modelo: Apache 2.0 según su origen (TensorFlow); no se comprobó el archivo de licencia dentro del .tflite.
- TRABAJO 8: imagen = foto CC0 de Wikimedia Commons (personas sentadas; no hay botellas), copiada al teléfono con adb; no se sube a git. Búsqueda hecha con la API pública de Commons; las descargas con curl porque Python falla con el certificado SSL de este equipo (no se desactivó la verificación).
- TRABAJO 8: umbral de confianza para contar detecciones = 0.4; JPEG calidad 70 (calidad media); NNAPI con 5 calentamientos y 20 mediciones (solo para anotar si funciona).
- TRABAJO 8: `abiFilters` = solo arm64-v8a para no empaquetar TensorFlow Lite en 4 arquitecturas; el APK pesa 20 MB. Para un equipo no arm64 hay que cambiarlo.
- TRABAJO 8: Git Bash convierte rutas como `/sdcard/...` al llamar a adb; se usó `MSYS_NO_PATHCONV=1` y rutas de Windows para los archivos locales.
- TRABAJO 8: se hicieron dos corridas completas para comprobar la repetición; el reporte usa la corrida 1 y compara con la 2 (datos crudos en `docs/datos_benchmark/`).
- TRABAJO 9: servidor falso con `websockets` 15.0.1 en un venv local (`pruebas_firmware/.venv`, ignorado por git; Python 3.9.13 de la Tienda de Windows); versión fijada en `pruebas_firmware/requirements.txt`. No se tocó Python global. Se añadió `probar_servidor_falso.py` (9 casos) para que el servidor tenga su propia prueba.
- TRABAJO 9: el watchdog del servidor falso imita al firmware: solo corre con motores en marcha y el PING NO renueva el reloj (leída literal, la frase "ningún comando válido" habría hecho que el PING lo renovara y el watchdog nunca saltara). Diferencia deliberada con el firmware: un comando desconocido se ignora sin renovar el watchdog (el firmware sí lo renueva; está anotado como pendiente).
- TRABAJO 9: el PONG solo existe en el servidor falso; el firmware real no contesta. Se anotó en `docs/pendientes_firmware.md`.
- TRABAJO 9: OkHttp 4.12.0 (la última 4.x) y no la 5.5.0: más simple y probada; el WebSocket funciona igual. `readTimeout` = 0 para que el silencio del carro real no cierre la conexión; `connectTimeout` = 3 s para que los reintentos fallen rápido.
- TRABAJO 9: el botón STOP central envía `STOP` (no `EBRAKE`, a diferencia de la página web); en el firmware son idénticos. Si se cae la conexión se deja de repetir el comando (hay que soltar y presionar de nuevo): más seguro que reanudar solo.
- TRABAJO 9: la pantalla de control conecta sola en `onResume` y se cierra en `onPause` (STOP antes de cerrar); el botón "Conectar" aplica una dirección nueva. `ControlActivity` acepta el extra `direccion` solo para pruebas por adb.
- TRABAJO 9: la lógica (`ControlLogica`) no conoce OkHttp: usa la interfaz `Enlace` (implementada por `EnlaceOkHttp`), así se podría probar o cambiar la conexión sin tocarla. Permiso INTERNET y `network_security_config` con tráfico sin cifrar permitido para toda la app (se puede limitar a 192.168.4.1 más adelante).
- TRABAJO 9: toques simulados con `adb shell input swipe x y x y <ms>` (toque largo en el mismo punto). El túnel `adb reverse tcp:8080 tcp:8080` se quitó al terminar.
- TRABAJO 9 (incidente): para detener el servidor falso usé una búsqueda de procesos por texto de la línea de comandos que también encontró a las consolas de mis propios comandos (todas contenían "servidor_falso") y cerró 7 procesos. No eran procesos tuyos que yo sepa; después filtré por nombre `python.exe` y por `servidor_falso.py`. Quedó un comando abortado (código 255) y se repitió.
- TRABAJO 10: umbrales de partida elegidos sobre imágenes sintéticas, no sobre la cámara real: `UMBRAL_COLOR` 60, `UMBRAL_CROMA` 30, `UMBRAL_BRILLO` 150, `SUMA_MIN_CROMA` 90, `MAX_VARIACION_REF` 40, `MIN_CELDAS` 6 (ver `docs/obstaculos.md`). Se nombran como pediste (`UMBRAL_COLOR`, `MIN_CELDAS`); la geometría lleva el prefijo `OBS_`.
- TRABAJO 10: tolerancia a la luz = "piso" si la suma de diferencias por canal es pequeña (A) O si el color normalizado por brillo (cada canal / (R+G+B)) es parecido y el brillo no difiere más de `UMBRAL_BRILLO` (B). El color de referencia sale del mismo cuadro, así un cambio de luz global no afecta; B cubre los degradados dentro del cuadro. Costo: un objeto del mismo tono y brillo similar (±50 por canal) no se detecta.
- TRABAJO 10: cercanía por filas de la mitad inferior: 12-15 = 1, 16-19 = 2, 20-23 = 3; la zona se reparte en tercios con `columna * 3 / 32` (11, 11 y 10 columnas). Con un error el resultado queda en ceros. El resultado incluye la máscara de celdas "no piso" para depurar.
- TRABAJO 10: añadí una prueba de "celdas sueltas dispersas" porque la de "una celda aislada" no demostraba el filtro (1 celda < MIN_CELDAS aunque no hubiera filtro); con una mutación (quitar el filtro) la nueva sí falla.
- TRABAJO 10: JNI: `ObstaculosNativa.analizar(ByteArray, ancho, alto)` devuelve 10 enteros; usa `GetPrimitiveArrayCritical` para no copiar los 230 KB de la imagen. `puente.c` y el CMake existente compilan `../nucleo_c/obstaculos.c` sin copiarlo.
- TRABAJO 10: benchmark de obstáculos dentro de `BenchmarkActivity` (`--es bench_modo obstaculos` o botón nuevo), con 4 imágenes generadas por código (JPEG calidad 70) y la opción de una foto real `bench_pasillo.jpg`. NO busqué ni abrí fotos personales del teléfono para encontrar un pasillo (es información privada y no puedo distinguir "pasillo" sin mirarlas); queda documentado cómo copiar una foto con adb.
- TRABAJO 10: los resultados se agregaron al final de `docs/benchmark_ELS-NX9.md` (sección nueva); no se regeneró el reporte anterior. Datos crudos en `docs/datos_benchmark/ELS-NX9_obstaculos_corrida*.txt`.
- TRABAJO 10: no se mató ningún proceso con búsquedas amplias; solo se cerró la app que yo instalé, con `am force-stop com.fsi.carro`.
- TRABAJO 11: el navegador va punto por punto: para cada punto de la ruta planifica con `trayectoria.c` desde la celda más cercana a la posición ESTIMADA hasta el punto objetivo. Así "reincorporarse" es la misma función que seguir la ruta (solo se vuelve a planificar hacia el mismo punto) y no hace falta saber qué puntos del paso fusionado ya se pasaron.
- TRABAJO 11: para planificar desde el rumbo actual añadí `trayectoria_calcular_desde(orientacion, ...)` a `trayectoria.c/.h` (la función anterior sigue igual y llama a la nueva con `ORIENTACION_INICIAL`); 5 pruebas nuevas.
- TRABAJO 11: la posición se estima integrando el tiempo REAL entre ticks bajo el comando que estaba activo (no el tiempo planeado), calculada desde el total del tramo (sin acumular redondeos). Un paso se da por terminado cuando su tiempo ejecutado, redondeado a medio tick (25 ms), alcanza lo planeado. El rumbo se ajusta al múltiplo de 45° más cercano en cada replanificación. Posición en mm, rumbo en grados.
- TRABAJO 11: `navegador_tick` recibe `obs` = NULL cuando no hay cuadro nuevo (los contadores de cuadros no cambian); los cuadros son los que cuentan para el antirrebote, no los ticks. Constantes de partida: `NAV_FRAMES_ANTIRREBOTE` 3, cercanía mínima 2, pausa 500 ms, timeout 4000 ms, giro de esquivar 90°, tramo 40 cm, máximo 3 esquivadas.
- TRABAJO 11: el navegador solo vigila obstáculos mientras AVANZA (no al girar) y la esquiva es "a ciegas" salvo un obstáculo MUY cerca (cercanía 3) mientras avanza de lado, que da ERROR. Se prefiere esquivar por la izquierda si ambos lados están libres.
- TRABAJO 11: con ambos lados bloqueados espera hasta `NAV_TIMEOUT_ESQUIVAR_MS` antes del ERROR (por si algo se libera) en lugar de fallar de inmediato.
- TRABAJO 11: REINCORPORANDO dura un tick y devuelve STOP (un parón de 50 ms entre el último giro y la nueva ruta), para tener el estado visible y simple.
- TRABAJO 11: el simulador de PC usa una tabla de senos por grado (sin `math.h`) y rumbo continuo: con direcciones de solo 45° ocultaba el error de un giro corto del 5 % (la prueba lo reveló).
- TRABAJO 11: en la app el ciclo de 50 ms está en `ModoSemiautonomo.kt` y le pasa un cuadro NUEVO en cada tick (la cámara es simulada con botones, cercanía fija 3); `ControlLogica.ordenAutomatica` envía el cambio de comando al instante y deja el heartbeat de 250 ms existente. Si se pierde la conexión se cancela la ruta. Los tramos por tiempo viven solo en `navegador.c`.
- TRABAJO 11: el retraso obstáculo → STOP se midió en el teléfono: del registro del botón simulado al registro de `enviado=STOP` (mismo reloj) y, para el servidor, sumando el desfase de relojes estimado con 38 PING (mediana 2,14 s) y la mitad de la latencia (2 ms). 8 repeticiones.
- TRABAJO 11: para detener el servidor falso usé el PID exacto que escucha en el puerto 8080, comprobando que su línea de comandos contiene `servidor_falso.py`; no se tocó ningún otro proceso.
- TRABAJO 12: `ConfigObstaculos` agrupa umbral_color, min_celdas y la franja de referencia (4 números). Las constantes `UMBRAL_COLOR`, `MIN_CELDAS` y `OBS_REF_*` se quedan como valores POR DEFECTO (`obstaculos_config_defecto`); `obstaculos_analizar` se mantiene y llama a `obstaculos_analizar_con`, así las pruebas anteriores no cambiaron. Nuevo código de error `OBS_ERR_CONFIG`. UMBRAL_CROMA, UMBRAL_BRILLO y MAX_VARIACION_REF siguen constantes (no se pidió moverlos). 19 pruebas nuevas; con cambios deliberados (ignorar umbral o min_celdas) fallan como deben. Aviso: bajar UMBRAL_COLOR no genera falsas alarmas en celdas del mismo tono (la condición B del detector las acepta como piso por tono y brillo), solo afecta a diferencias de color sutiles.
- TRABAJO 12: Camera2 directo (sin CameraX): CameraX necesita `LifecycleOwner` (AndroidX) y mis pantallas son `android.app.Activity` sin librerías; Camera2 no necesita servicios de Google ni dependencias. La "vista previa" es el propio cuadro de 320x240 que analiza el detector, dibujado en una vista propia con la superposición: así se ve exactamente lo que ve el detector y no hay que lidiar con la rotación de un TextureView.
- TRABAJO 12: la orientación se supone con el teléfono en HORIZONTAL (el sensor entrega la imagen derecha; se gira 180° si el sensor reporta 270). VisionActivity queda fija en horizontal. En ControlActivity (vertical) la cámara se usa solo como fuente de datos; el teléfono debe sostenerse en horizontal para que el piso quede abajo en la imagen.
- TRABAJO 12: el cuadro se elige 4:3 y ≥ 320x240 (en este teléfono 320x240 directo); si fuera mayor se reduce por muestreo. Conversión YUV→RGB en Kotlin con enteros (2 a 10 ms por cuadro) en el hilo de la cámara; los cuadros que llegan mientras se procesa se descartan (`acquireLatestImage`).
- TRABAJO 12: ante un error del detector (`codigo` ≠ 0, por ejemplo piso de referencia no uniforme) el modo semiautónomo recibe "las tres zonas bloqueadas, cercanía 3": ante la duda se detiene y termina en ERROR (lados bloqueados) en vez de esquivar. Si la cámara no entrega cuadros nuevos durante 1 s, la ruta se cancela; no se inicia una ruta si la cámara aún no entrega imágenes.
- TRABAJO 12: la configuración (umbral, min_celdas) se guarda en SharedPreferences ("vision") y la usan tanto VisionActivity como ControlActivity; la franja de referencia queda con el valor por defecto (no hay control en pantalla). Los valores por defecto salen del C (`ObstaculosNativa.configDefecto`), una sola fuente.
- TRABAJO 12: privacidad: la cámara apuntaba al escritorio, así que NO miré imágenes de la cámara; verifiqué por registro y por los textos de la pantalla, y para comprobar el dibujo de la superposición solo vi una captura muy pixelada (160 px de ancho) de la zona de la cámara. El JPEG de prueba que guardé en el teléfono se borró sin abrirlo. Los archivos `cuadro_*.jpg` quedan en `.gitignore`.
- TRABAJO 12: antes de la prueba noté que UMBRAL_COLOR valía 72 en el teléfono (alguien movió la barra, no fui yo); lo borré al empezar la prueba de barras y al terminar dejé la configuración en blanco (valores por defecto). El registro de Huawei descarta líneas viejas muy rápido, por eso los 60 s se midieron capturando el registro en vivo (`timeout 66 adb logcat`).
- TRABAJO 12: para la prueba de integración puse los umbrales muy sensibles (0 y 1) escribiendo el archivo de preferencias de MI app debug con `run-as`; luego lo borré. Servidor falso detenido por PID exacto (comprobando su línea de comandos).
- TRABAJO 13: `fila_minima` es el último campo de `ConfigObstaculos` (por defecto `OBS_FILA_INICIAL_ZONAS` = 12, así nada cambia). Solo afecta al conteo por zonas: el filtro de celdas aisladas y la máscara `no_piso` siguen usando toda la imagen (así la pantalla puede mostrar en rojo, bajo el gris, lo que hay en las filas ignoradas). Rango válido 0 a 23; fuera de él, `OBS_ERR_CONFIG`.
- TRABAJO 13: la cercanía se sigue calculando con la fila más baja del obstáculo, independiente de `fila_minima` (probado con objetos altos y límites distintos).
- TRABAJO 13: en JNI la configuración pasa de 6 a 7 enteros (`CFG_FILA_MINIMA` = 6); sin configuración se manda `fila_minima` = -1 (no válida). En la pantalla las zonas empiezan en la línea blanca; la etiqueta se limita para no salirse por abajo si la zona es muy baja.
- TRABAJO 13: al empezar la prueba había un `vision.xml` con umbral 97 en el teléfono (no lo puse yo); lo borré para medir con valores por defecto y lo borré de nuevo al terminar. La captura del panel de controles no incluye imagen de cámara; la superposición solo se vio pixelada (160 px). Los 30 s se midieron con el registro en vivo (la primera captura se cortó con "unexpected EOF" a los 18 s y se repitió).
- TRABAJO H1: al empezar no había ninguna placa visible por USB; después apareció una (la DevKit, chip CP2102) con el estado "Error" de Windows por falta de driver. Silicon Labs bloquea la descarga por curl y PowerShell (403), así que bajé el zip oficial `CP210x_Universal_Windows_Driver.zip` desde su página con el navegador integrado y lo pasé a una carpeta temporal por un receptor local de un solo uso (127.0.0.1, PID exacto, cerrado). Comprobé las firmas (silabser.sys firmado por Silicon Laboratories, el .cat por Microsoft) y lo instalé con `pnputil /add-driver silabser.inf /install` elevado (el usuario tuvo que aceptar el aviso de Windows). El driver no se guarda en el repositorio.
- TRABAJO H1: esptool (v5.3.1 del core) no puede ver la PSRAM externa de una WROVER, así que la detección de "Freenove con PSRAM / DevKit sin PSRAM" carga una sonda mínima (`scripts/sonda_placa`) la primera vez que ve una MAC y guarda el resultado en `scripts/placas.local.json` (ignorado por git). Es destructivo una sola vez por placa (sobrescribe su programa); se documenta y se puede evitar con `-Puerto`. Lo más seguro y sencillo que encontré; alternativa descartada: adivinar por el chip USB-serie (CP210x/CH340), que no es fiable.
- TRABAJO H1: el core de ESP32 no ofrece 460800 baudios en su menú de velocidad; el script reintenta a 921600, 512000 y 115200.
- TRABAJO H1: `baseline` compila una copia temporal de `original_backup` en `%TEMP%\fsi_cargar`; `original_backup/` solo se leyó. El script oculta de toda su salida cualquier contraseña conocida (las lee de `secretos.h` y del .ino original solo en memoria).
- TRABAJO H1: pines de motores del firmware original comprobados: 27, 26, 25 y 33 (y keep-alive en 2), iguales a `firmware_carro/config.h`. El firmware original imprime `E (19) task_wdt: esp_task_wdt_init(517): TWDT already initialized` en el core 3.3.12 (el core ya inicia el vigilante); el nuevo tiene la misma llamada. No lo cambié (la DevKit debe quedarse con el original); queda como pendiente a revisar.
- TRABAJO H1: la DevKit quedó con el firmware ORIGINAL (con el nombre de red anterior, IP 192.168.4.1). La Freenove no estaba conectada; `camara` y su detección no se probaron. La carpeta `camara_prueba/` aún no existe (H2).
- TRABAJO H1: el usuario avisó que el proyecto ya no usa su nombre anterior sino "carrito". Los documentos nuevos dicen "carrito". No cambié el nombre de la red: el firmware original sigue con el nombre de red anterior y en el nuevo se cambia en `firmware_carro/secretos.h` (`WIFI_SSID`, archivo local sin versionar). Quedaban menciones del nombre anterior en `README.md`, `docs/pendientes_firmware.md` y `firmware_carro/pagina.h`; no las toqué.
- TRABAJO H1b: la guía `docs/conexiones.md` sale de `config.h`, del firmware original, de su PDF y de la hoja de datos del TC1508A (Fine Made, S&CIC2159 v1.0, leída con el visor de PDF; la descargué de iarduino.ru y no se guarda en el repositorio). Los nombres reales del chip son INA/INB/INC/IND y OUTA..OUTD; el rotulado del módulo (IN1..IN4 o INT1..INT4) y lo que va en GPIO 2 quedan marcados "sin confirmar". Los cálculos de corriente (1.0 a 1.3 A continuos por canal por potencia) son míos y están rotulados así.
- TRABAJO H2: la Freenove apareció en COM8 (CH340, driver ya instalado en Windows); el script la identificó como placa con PSRAM (MAC f0:16:1d:8b:cf:e8) cargando la sonda una vez. Se usó `-Puerto COM8` en las cargas siguientes para no repetir la detección.
- TRABAJO H2: pines: la documentación oficial de Freenove (repositorio Freenove_ESP32_WROVER_Board, Sketch_06.1_CameraWebServer) usa `CAMERA_MODEL_WROVER_KIT`, igual que el core, y ese mapa funcionó; AI_THINKER se probó después y falló (0x106). Solo se prueba cada mapa una vez, sin bucles.
- TRABAJO H2: el sensor es un GC0308 y no soporta JPEG. Como el mapa SÍ funcionaba (el sensor contestó) y el objetivo es ver video, en vez de detenerme usé RGB565 + JPEG por software (`frame2jpg`, calidad 80/100: equivalencia con la "calidad 12" del sensor aproximada, sin medir). Eso cambia lo que significan los fps/tamaños pedidos: se reportan también los fps de captura sola. Para cambiar de tamaño con RGB565 hay que reiniciar la cámara (si no, `cam_hal: FB-SIZE: 153600 != 614400` en bucle: lo comprobé y lo corregí).
- TRABAJO H2: la medida de 100 cuadros por tamaño se hace antes de conectar el WiFi y de arrancar el servidor (sin cliente), así que el arranque tarda unos 90 s hasta que hay video. Se descartan 5 cuadros tras cada cambio de tamaño.
- TRABAJO H2: `/stream` corre en su propia tarea (`httpd_req_async_handler_begin`) para que `/`, `/capture` y `/control` sigan respondiendo; un solo stream a la vez (otro recibe 503) y un candado para que `/control` no cambie el tamaño mientras se toma un cuadro.
- TRABAJO H2: IP fija 192.168.4.2 pedida por el usuario. Riesgo conocido: la DevKit reparte por DHCP desde 192.168.4.2, y un teléfono que entre puede recibir la misma IP (choque). No toqué la DevKit; queda en `docs/camara_prueba.md` el paso para fijar una IP manual en el teléfono.
- TRABAJO H2: el servidor HTTP no se probó con ningún cliente: la PC no se conecta al WiFi del carro (regla). Antes de conectar vi que la DevKit estaba desconectada (la cámara no encontraba la red del carro y reintentó 10 veces); cuando el usuario la volvió a conectar, la cámara conectó sola. Para diagnosticar añadí al programa un escaneo (¿se ve la red? canal y RSSI) y el código de razón de desconexión; no imprimen contraseñas.
- TRABAJO H2: `scripts/cargar.ps1` ahora resume las líneas repetidas del monitor serie (un error en bucle imprimía miles de líneas). `camara_prueba/secretos.h` (copia de la de firmware_carro) está en `.gitignore`; se versiona `secretos.ejemplo.h`.
- TRABAJO H3: tubería en dos núcleos con casilla única. Captura (núcleo 0, prioridad 4) y compresión+envío (núcleo 1, tarea del stream); sin demanda la captura se detiene. Un solo cuadro en la casilla: si llega otro, el viejo se devuelve a la cámara y se cuenta como descartado. Con 3 búferes de cámara (uno comprimiéndose, uno en la casilla, uno llenándose) en modo "latest".
- TRABAJO H3: dos fallos encontrados y corregidos en la tubería: (1) la casilla conservaba el último cuadro al terminar la demanda y el primer cliente recibía un cuadro de hace 7 a 9 s: ahora se vacía al quedar sin demanda y se tiran los cuadros que salen de la cámara con más de 450 ms; (2) los reinicios de la cámara (cambio de tamaño) los hace solo la tarea de captura, con un candado que espera a que nadie tenga un cuadro en la mano (si no, se devolvería un búfer a un driver ya cerrado).
- TRABAJO H3: la "edad del cuadro" usa la marca de tiempo del primer bloque DMA del cuadro, así que incluye la lectura del sensor (~100 ms). Se reporta hasta fin de compresión (barrido) y hasta fin de envío (con cliente).
- TRABAJO H3: barrido de 36 combinaciones (3 relojes, 2 formatos, 3 tamaños, 2 calidades; 100 cuadros por combinación; se descartan 5 al cambiar) con `MODO_BARRIDO 1` (tarda ~7 min); lo dejé en 0 por defecto. Luz medida con el brillo medio Y de un cuadro YUV422 (solo un número): 127 al inicio y 124 al final (luz intermedia; no sé si el usuario la considera "buena").
- TRABAJO H3: elegido por defecto 20 MHz, RGB565, QVGA, calidad 50. RGB565 comprime más rápido que YUV422 (107 contra 125 ms); calidad 50 reduce ~23 % el JPEG y casi no cambia el tiempo; 16 MHz no mejora QVGA. HQVGA mejoraría fps +41 % y edad -46 %, pero el detector de obstáculos usa 320x240 (32x24 celdas de 10 px), así que no se cambió; sigue disponible con /control?size=hqvga.
- TRABAJO H3: no escribí registros del GC0308 (límite de exposición, fps automático): no hay hoja de datos en el proyecto y no es seguro a ciegas. Los fps salieron estables entre bloques de 10 cuadros, sin caída por luz.
- TRABAJO H3: reloj máximo probado 20 MHz (lo pedido). La relación fps/XCLK (5, 8, 10 fps a 10, 16, 20 MHz en QVGA) sugiere que más reloj subiría los fps de captura, pero el ESP32 con LEDC no da 24 MHz y no se probó nada por encima; la compresión (~107 ms) ya es casi igual al periodo del sensor, así que el beneficio sería pequeño.
- TRABAJO H3: autoprueba local (la placa se pide a sí misma /stats, /capture, /control y /stream por 127.0.0.1) porque la PC no puede conectarse a la red de las placas. Es un cliente en la misma placa (comparte procesador), no mide WiFi; se puede quitar con `#define AUTOPRUEBA 0`. Mi primer intento de autoprueba por la IP propia (192.168.4.2) no conectó; por 127.0.0.1 sí.
- TRABAJO H3: para no enviar dos veces por cuadro, `/stream` escribe directo en el socket (`send`) con su propia cabecera HTTP (sin "chunked") y una sola escritura por cuadro; también `TCP_NODELAY`, `SO_SNDBUF` de 2920 bytes (no se comprobó si lwIP lo acepta) y `SO_SNDTIMEO` de 1,5 s.
- TRABAJO H3: no se vio ni guardó ninguna imagen; el script `scripts/cargar.ps1` no cambió. El WiFi real (envío y retraso en el teléfono) queda para la prueba del usuario.
- PARTE 1: la franja de referencia y la fila mínima pasan a ser proporciones en MILÉSIMAS (enteros; 500 = 0.5) porque las reglas piden solo enteros en C. La fila mínima se convierte con `filas * mil / 1000` (500 en 24 filas = fila 12, igual que antes). La franja: ancho 188‰ y alto 84‰ (6x2 celdas en 32x24), centro en 500‰ y borde inferior en 1000‰; mínimo 1 celda; si se sale se corre hacia adentro. Los límites de cercanía también son proporciones (667‰ y 834‰: en 24 filas dan 16 y 20 como antes).
- PARTE 1: tamaños. Rejilla máxima 64x48 celdas (640x480) y mínima 3x3 (30x30); fuera de eso `OBS_ERR_TAMANO` (el límite máximo se comprueba en píxeles para no leer más allá de la imagen: una prueba lo encontró con 641x481). 160x120 (16x12) NO da error: funciona y marca `rejilla_chica` (menos de 20 columnas o 15 filas); decisión mía porque dejar de detectar sería peor que detectar más tosco.
- PARTE 1: pruebas viejas del detector: se conservan 71 casos; 3 se reescribieron (franja fuera de la imagen por la derecha / por abajo / alto cero, ahora con proporciones) y una se adaptó (valores por defecto). Los casos con tamaños 100x100, 200 de alto o 640 de ancho cambiaron a tamaños que siguen siendo inválidos (20x20, 20 de alto, 660 de ancho), porque 100x100 y 640x240 ahora son válidos. Total del detector: 144 casos.
- PARTE 1: antirrebote del navegador en ms. Interpretación mía de una frase ambigua ("cercanía 3, o 2 en la zona central"): solo la zona CENTRO decide detenerse (las laterales siguen sin detener, como antes); dentro del centro, cercanía 2 o 3 confirma con un cuadro y cercanía 1 (lejos) necesita `MS_CONFIRMAR_LEJOS` = 150 ms y al menos 2 cuadros. Para que el parámetro tenga efecto subí `NAV_CERCANIA_MIN_DETENER` de 2 a 1: AHORA un obstáculo lejano en el centro también detiene el carro (antes no); si se prefiere lo anterior, poner 2. Para reanudar elegí `MS_CONFIRMAR_LIBRE` = 250 ms (no estaba pedido).
- PARTE 1: el simulador de PC acepta cuadros cada 80 o 120 ms (no múltiplos del tick de 50 ms): el cuadro llega al primer tick posterior a su hora. Prueba del obstáculo que desaparece: ahora desaparece a los 1700 ms (antes 2000) porque con confirmación inmediata la detención empieza antes y la pausa de 500 ms termina a los 2000.
- PARTE 1: en la app el tamaño del cuadro viaja con cada `CuadroAnalizado` (ancho, alto, columnas, filas) y la máscara usa como ancho de fila las columnas de ese análisis. Por defecto la cámara del teléfono se reduce a 240x176 (nuevo botón para 320x240 y 160x120). La barra de fila mínima ahora es un por ciento del alto; la preferencia nueva es `fila_minima_mil` (la anterior `fila_minima` ya no se lee: vuelve al valor por defecto, 50 %).
- PARTE 1: la cámara Freenove arranca en HQVGA por defecto (calidad 50, 20 MHz, RGB565). Solo se compiló/probó en PC; la carga a la placa queda para el usuario. La app compila (`assembleDebug`) pero no se probó en el teléfono (no estaba conectado).
- PARTE 1: `docs/latencia.md`: la etapa "cámara 320 ms" es del usuario (una medida); el resto sale de medidas anteriores (7 ms, 28 ms de tick+USB) y suposiciones marcadas. Conclusión: con esta cámara la meta de 300 ms no se alcanza, solo la cámara ya son 320 ms.
- PARTE 2: la calibración usa enteros con factor 10 (`_x10`) porque las reglas piden solo enteros: 420 = 42.0 ms por cm. Los mm y los grados por 10 permiten décimas. `calibracion.h` mantiene `MS_POR_CM` y `MS_POR_GRADO` como valores POR DEFECTO, así que las 28 pruebas de trayectoria y las 55 del navegador siguieron pasando sin cambiarlas.
- PARTE 2: cómo se miden el arranque y el frenado sin encoders (ambigüedad del mensaje): el ARRANQUE lo mide el usuario tocando «YA SE MOVIÓ» al ver las ruedas, y se le descuenta su tiempo de reacción medido en un paso previo (3 toques; 180 ms si no se midió). Es una medida humana (±50 ms); queda anotado como límite. El FRENADO no se mide con un botón: sale de la recta de las pruebas de avance (lo que sobra en t = arranque), por eso depende del arranque medido. Los mensajes dicen que el usuario "escribe cuántos cm avanzó" tras cada prueba, como se pidió.
- PARTE 2: en vez de la pendiente entre solo dos tiempos (1000 y 2000 ms) uso 3 tiempos (1000, 2000, 3000 ms; 500, 1000, 1500 ms para giros) con 3 repeticiones cada uno y mínimos cuadrados: con dos puntos y ruido de ±10 % el error de la pendiente llega a ±40 %; con tres tiempos el error medio fue 3 % y el peor 15 % en 400 simulaciones. El promedio por tiempo descarta atípicos (más de 30 % de la mediana).
- PARTE 2: giros por lado: `ms_por_grado` y frenado de giro separados para izquierda y derecha. El arranque se supone igual para avanzar y girar (límite anotado).
- PARTE 2: el navegador planifica de punto en punto de la ruta, y con arranque y frenado eso falló la primera vez (el carro simulado calibrado se pasaba 209 mm del destino en una recta de 1 m): cada tramo de 20 cm volvía a sumar arranque y descontar frenado aunque el carro no se detenía. Corregido: un tramo que continúa el movimiento no suma arranque, y un tramo cuyo siguiente tramo sigue recto no descuenta frenado; la posición estimada suma el frenado solo al soltar un comando y al reanudar tras una detención por obstáculo se compensa (frenado − arranque). Resultado: 6 mm de error contra 185 mm sin calibrar; una detención a mitad de ruta también llega.
- PARTE 2: el simulador de PC ahora puede tener un carro "real" distinto (arranque, frenado y velocidad por lado) con `sim.real`; por defecto es el de ejemplo.
- PARTE 2: la app guarda la calibración como el TEXTO "clave=valor" (SharedPreferences y archivo `calibracion.txt`), que es lo que se exporta; se copia al portapapeles con un botón. `NavegadorNativa.ponerCalibracion` la deja en una variable estática de `puente.c` que se aplica en cada `cargarRuta` (porque `navegador_iniciar` la reinicia). Sin calibración completa, `ControlActivity` muestra un aviso con lo que falta y se usan valores por defecto.
- PARTE 2: la app compila (`assembleDebug`) pero el asistente no se probó con el carro ni en el teléfono (nada estaba conectado): PENDIENTE HARDWARE (ver `docs/calibracion.md`).
- PARTE 3 (revisa una decisión de la PARTE 1): al leer en la parte 3 "escalera lejana (no debe disparar STOP si está lejos)" cambié mi interpretación de la regla de frenado del navegador, porque la anterior (NAV_CERCANIA_MIN_DETENER = 1, el obstáculo lejano frena tras 150 ms) la contradecía. Interpretación final, que explica las dos frases a la vez: frena un obstáculo con cercanía >= 2 en CUALQUIER zona (un obstáculo de cercanía 1, "lejos" de verdad, solo se informa); es inmediato (un cuadro) con cercanía 3 en cualquier zona o cercanía 2 en el centro; un obstáculo de cercanía 2 en una zona de los lados necesita MS_CONFIRMAR_LEJOS (150 ms, 2 cuadros). Efecto: ahora un obstáculo muy cerca a un lado SI frena el carro (antes solo frenaba el centro). Se actualizaron pruebas del navegador (72 casos) y docs/navegador.md y docs/latencia.md. Si se prefiere que los lados no frenen, hay que ajustar `registrar_cuadro`.
- PARTE 3: el modelo del piso vive en `ModeloPiso` (el llamador lo guarda) y `obstaculos_analizar_con` sigue sin memoria; así las 144 pruebas anteriores no cambiaron. K por defecto = 4 porque con un piso liso el k-medias da 1 solo grupo (solo se crea otro grupo si hay una celda a más de 24 de distancia de color), así que el comportamiento anterior se conserva. Colores del modelo en x256 para que el aprendizaje lento (2 % por cuadro) no se pierda en redondeos enteros.
- PARTE 3: "compatible" (para decidir si dos grupos de la franja pueden ser piso o es un objeto encima) = distancia de color <= 150 o el mismo tono (color normalizado, ver UMBRAL_CROMA) con distinta luz. Con ello una caja roja sobre piso café no se aprende como piso y unas baldosas clara/oscura grises sí. Límite conocido: baldosas de tonos muy distintos (azul y blanco) darán error de franja.
- PARTE 3: la franja a 240x176 tiene solo 4 celdas (1 fila), así que k-medias ahí ve poco; es el motivo de que el modelo conserve los grupos entre cuadros y aprenda del resto del piso. Se podría subir `ref_alto_mil` con la cámara real.
- PARTE 3: aprendizaje continuo = solo con el carro avanzando y sin obstáculo en ninguna zona; el modelo no usa celdas candidatas ni sus vecinas ni celdas a más de la mitad del umbral de su grupo ni las de arriba de la fila mínima. Probé una mutación (aprender las dudosas) y una prueba falla; la mutación de "aprender las candidatas" NO la detecta ninguna prueba porque esas celdas ya las descarta la regla de la mitad del umbral (la protección es redundante a propósito).
- PARTE 3: cambio de piso: si en la zona de avance queda como máximo el 2 % de celdas de piso durante 1000 ms seguidos y la franja es válida, se reaprende desde la franja. Aviso: una pared que lo llena todo (franja incluida) también se reaprende como piso (riesgo conocido, probado y documentado); en ese segundo el navegador ya se había detenido. El 2 % es mío (la frase pedía "todas las celdas": con ruido real una sola celda suelta impediría reaprender).
- PARTE 3: señal de bordes: implementada como interruptor (`usar_bordes`) y APAGADA por defecto. Medido: detecta la libreta (24 celdas contra 0) pero produce 115 celdas falsas en 5 escenas sin objetos (sombra suave 10, baldosas de 25 px 105). Decisión según lo pedido: apagada y documentada (docs/obstaculos.md).
- PARTE 3: limpieza: `pruebas_calibracion.exe` se había subido a git por error en la parte 2 (`git add -A`); se quitó del índice y se agregaron `pruebas_calibracion`, `pruebas_piso` y `pruebas_trayectoria` (y sus .exe) a `.gitignore`.
- PARTE 3: JNI: la configuración pasa a 10 enteros (K, aprendizaje, bordes), `analizarConfig` recibe `avanzando` y el reloj, y el detalle pasa a 35 enteros de encabezado (grupos y sus colores, avisos). El modelo es único (variable estática) y solo lo usa el hilo de la cámara; `reiniciarModelo()` (botón "Valores por defecto") se atiende en el siguiente cuadro. `ModoSemiautonomo.avanzando` (volátil) le dice a la cámara si el último comando fue FORWARD. La app compila; no se probó en el teléfono (PENDIENTE HARDWARE).
- PARTE 4: la fusión (`fusion.c`) devuelve zonas en el MISMO formato que el detector (hay y cercanía por zona), así el navegador no cambia: solo recibe las zonas fusionadas. Se agregó la severidad (0 a 3), la fuente (detector, modelo, ambos) y los avisos como salidas aparte.
- PARTE 4: interpretación de "el detector duda": el detector ve algo en el camino pero menos cerca que el modelo, o tiene celdas "no piso" confirmadas que no llegan a `MIN_CELDAS`. Para eso el puente pasa las celdas de cada zona (3 enteros nuevos en el encabezado; el detalle pasa a 38 enteros). Agregué un caso no pedido: si el detector no ve NADA y el modelo ve algo cercano (cercanía 2 o 3) con confianza de 0.6 o más, frena solo por el modelo (el texto pedido solo decía qué hacer con objetos lejanos); con menos confianza, solo avisa.
- PARTE 4: "en el camino" = la caja cruza la zona central al menos 60 milésimas del ancho (6 % de la imagen). La cercanía de la caja usa los mismos límites de borde de abajo que el detector (667 y 834) y sube una si la caja ocupa 20 % o más del cuadro. Son números míos de partida, sin datos reales: a ajustar con el teléfono.
- PARTE 4: la marca de tiempo del resultado del modelo es la hora del CUADRO que analizó (no la de cuando terminó), así la vigencia de 300 ms ya incluye los ~45 ms de inferencia y la espera; es más conservador. El hilo del modelo corre como máximo cada 100 ms (10 por segundo) y toma siempre el cuadro más reciente.
- PARTE 4: el modelo viene APAGADO por defecto en la app (interruptor en la pantalla de visión) porque no se pudo probar en el teléfono (nada conectado); si el hilo fallara al abrir el modelo, solo se anota el error y sigue el detector de color. Las clases de interés se buscan por nombre en las etiquetas del modelo (los números por defecto del C son el id de COCO menos 1: persona 0, gato 16, perro 17, botella 43, silla 61, mesa 66; sin verificar con el modelo real).
- PARTE 4: `DetectorTflite.postprocesarCajas()` es nuevo; las cajas se leen como [ymin, xmin, ymax, xmax] normalizadas (el formato de los modelos de detección de TensorFlow Lite), también sin verificar con el modelo real. El benchmark usa el `postprocesar()` anterior, sin cambios.
- PARTE 5: método: proyección de columnas de la MITAD DE ARRIBA, pasada a "bordes" (diferencia entre columnas vecinas: así un cambio de luz general no importa), búsqueda del corrimiento por suma de diferencias absolutas y subpíxel por parábola. La confianza usa tres pruebas mías (energía de bordes >= 60, el mejor costo < 55 % del costo medio y < 80 % del segundo mínimo lejano) elegidas con imágenes sintéticas: con cámaras y cuartos reales habrá que reajustarlas (PENDIENTE HARDWARE).
- PARTE 5: el rango de búsqueda es de 2/5 del ancho en `mv_procesar` (96 px en 240), no justo 1/3, porque con exactamente un tercio un corrimiento de 80 px quedaba en el borde del rango (`FUERA_DE_RANGO`) y se rechazaba. Con ~12 cuadros por segundo un giro rápido corre unos 30 px por cuadro.
- PARTE 5: la aproximación lineal píxel-ángulo (giro = corrimiento x FOV / ancho) da -9 % al centro y +21 % en el borde con FOV 60, y -0.7 % en promedio sobre todas las columnas (calculado con la geometría de agujero); por eso y por no conocer el FOV real de la cámara, el FOV se calibra (`cal_ajustar_fov`, bit 16, clave opcional `fov_grados_x10` en el texto: los textos viejos de 8 claves se siguen leyendo; si hubiera sido obligatoria, la calibración guardada en el teléfono se habría descartado en silencio).
- PARTE 5: reglas del navegador (mías, a ajustar con datos reales): se fía de la cámara si cubrió al menos 50 % del tiempo de giro y 200 ms; el giro no se corta antes del 50 % del tiempo planeado aunque la cámara diga que ya llegó (protege de una cámara que se equivoca); el respaldo es 150 % del tiempo planeado (la frase pedida era "con el tiempo como respaldo"; lo interpreté como un tope más largo que el planeado para que la cámara pueda alargar un giro corto; sin cámara confiable el tiempo planeado manda).
- PARTE 5: encontré que el RETRASO de la cámara del carro (~0.3 s) arruina el giro con cámara si no se compensa (en PC: pidiendo 90°, un carro 20 % lento llega a 108° sin compensar y a 84° compensando; uno 25 % rápido, 137° contra 100°). Agregué `navegador_poner_latencia_visual(ms)`: los cuadros que llegan antes de arranque + latencia no cuentan y el pedazo que la cámara aún no ve se completa por tiempo. Por defecto es 0 (cámara del teléfono); hay que ponerle ~320 cuando la app reciba el video de la Freenove (la app todavía no lo recibe).
- PARTE 5: `CamaraObstaculos.tomarGiroNuevo()` SUMA los giros de todos los cuadros que llegaron desde la última lectura (la cámara del teléfono da ~25 cuadros por segundo y el ciclo del navegador lee cada 50 ms): la primera versión devolvía solo el último y perdía cuadros (y ángulo).
- PARTE 5: la pantalla de visión muestra el giro visual y un ángulo acumulado con un botón para ponerlo en 0: sirve para probar sin carro girando el teléfono a mano 90°. En `CalibracionActivity` el paso 6 (opcional) usa la cámara del teléfono (CamaraObstaculos); la cámara de la Freenove no se puede usar aún porque la app no recibe su video. Compila; no se probó en el teléfono.
- EXTRA (pedido con las 5 partes): en el firmware NUEVO (`firmware_carro/`, NO el original) se arregló "TWDT already initialized": el núcleo de Arduino-ESP32 3.x ya inicia el vigilante, así que ahora se llama a `esp_task_wdt_reconfigure` y solo si falla con "no iniciado" a `esp_task_wdt_init`; suscribir `loop()` que ya estuviera suscrito no se trata como error. Además esto significa que antes el reinicio por watchdog usaba el tiempo del núcleo y no los 5000 ms de `WATCHDOG_HW_MS`: ahora se aplican. El firmware imprime `Watchdog de hardware: 5000 ms` (o el error). Solo se compiló (`scripts/cargar.ps1 nuevo -SoloCompilar`, 74 % de flash): PENDIENTE HARDWARE comprobar en la placa que el aviso desaparece y que el reinicio por watchdog sigue funcionando.
- EXTRA: el firmware nuevo contesta `PONG` a `PING` (`carro_respuesta` en `carro.c`, C puro con 5 pruebas nuevas: `pruebas_firmware` pasa de 44 a 49 casos; el `.ino` solo manda la respuesta por el WebSocket con `client->text`). PING sigue sin renovar el watchdog ni mover motores (probado). La página web de control ignora los mensajes que recibe (su `onmessage` es nulo), así que el PONG no la afecta.
- PRUEBA EN EL HUAWEI (primera): la pantalla de visión se cerraba al abrirla (`lateinit property botonTamano has not been initialized`): `mostrarValoresDeBarras()` se llamaba antes de buscar los botones nuevos (modelo y tamaño). Corregido moviendo las búsquedas de vistas antes. Con la corrección: 240x176, 15 a 18 cuadros por segundo, 3.5 ms por cuadro (conversión + análisis), sin errores. El teléfono se apagó durante la prueba (sin causa conocida de la app); falta probar el modelo de objetos, el giro visual a mano y la calibración. Las pruebas de PC y la compilación no detectaron el fallo (es de orden de inicialización en Android): por eso hay que probar siempre en el teléfono.
- PRUEBA EN EL HUAWEI (segunda): pantalla de visión con "un color liso, blanco" (la vista previa no mostraba nada y el giro nunca era confiable): las tablas de muestreo del convertidor de cuadros no se rellenaban cuando el tamaño de salida no cambiaba (`tablasListas`), así que el cuadro salía plano. Corregido (bandera `tablasListas`, se pone en falso al cambiar de cámara); es un error de orden de inicialización que las pruebas de PC no pueden ver.
- PRUEBA EN EL HUAWEI (giro visual, datos reales): quieto el ángulo acumulado se queda en 0 ± 0.5°. Girando a mano ~90° de una pared a la pared perpendicular (unos 2 s) el estimador solo sumó 35.6°: a la velocidad pico el contenido se corre ~15 px por cuadro y ~20 % de los cuadros se rechazaban como AMBIGUOS (segundo mínimo casi igual de bueno, la confianza seguía en 500 a 700) y el giro de esos cuadros se perdía. Arreglo en `movimiento_visual.c`: (1) si un cuadro se rechaza se CONSERVA el cuadro de referencia y el siguiente se compara con él (`cuadros` dice cuántos cuadros abarca el corrimiento; la app calcula el tiempo con una cola de marcas de hora para que el `dt` cubra el hueco; después de `MV_MAX_SALTO` = 4 rechazos seguidos se empieza de nuevo); (2) una coincidencia ambigua se acepta si un mínimo local bueno (costo hasta el doble del mejor y que pasa la prueba de coincidencia débil) cae cerca del movimiento que se venía llevando (predicción: 4 px o 40 % de lo esperado); (3) `MV_SEGUNDO_MAX_PCT` pasa de 80 a 88. PC: 66 pruebas (antes 60): con un cuadro tapado ahora se recupera el giro completo (90.0°, antes se perdían 2 intervalos), rayas repetidas sin predicción siguen siendo ambiguas, 40 de 40 escenas sin relación siguen dando "sin confianza". Falta repetir la prueba de 90° en el teléfono con el estimador nuevo.
- PRUEBA EN EL HUAWEI (giro visual, campo de visión): la cámara trasera del ELS-NX9 tiene focal 4.4 mm y sensor de 7.3 mm de ancho (`dumpsys media.camera`): FOV horizontal = 2·atan(7.3/(2·4.4)) = 79°, no los 60° supuestos. Con 60° el giro lento salía 48.7° (sin cuadros rechazados) para un giro que el usuario estimó en ~90°. Ahora `CamaraObstaculos.calcularFovX10` calcula el FOV de la cámara con su focal y su sensor (recortado a la forma de la imagen pedida) y lo usa si la calibración no tiene FOV propio (`CalibracionGuardada.fovCalibradoX10()` devuelve 0 si no se calibró; `fovEfectivoX10` es el que se usa). El paso 6 de la calibración ajusta a partir del FOV con el que se midió. Con 79°: giro rápido −60° y vuelta +52° (neto −8°, consistente), 75 intervalos recuperados por conservar la referencia y 12 aceptados por predicción. El ángulo real de las pruebas a mano es solo una estimación del usuario (marcas a ojo): la escala fina la da el paso 6 de la calibración.
- HERRAMIENTAS: las capturas de logcat desde un proceso del PC mueren a los ~25 s; funciona agrandar el búfer del teléfono (`adb logcat -G 16M`, `logcat -c`) y bajar el log DESPUÉS de la prueba con `logcat -d`.
- PRUEBA EN LA PLACA (DevKit, firmware nuevo, COM6, `cargar.ps1 nuevo`): carga correcta (74 % de flash). El arranque ya NO imprime "TWDT already initialized" y muestra `Watchdog de hardware: 5000 ms`, luego `AP Iniciado. IP: 192.168.4.1` y `Servidor listo`. Falta (necesita el teléfono conectado a la red del carro): comprobar el PONG y su latencia desde la pantalla de control, y que el reinicio por watchdog sigue funcionando.
- PRUEBA EN LA PLACA (Freenove, `cargar.ps1 camara`, COM8, MAC reconocida): carga correcta (80 % de flash). Sensor GC0308 (PID 0x9B, sin JPEG de sensor: JPEG por software), HQVGA 240x176 por defecto: 12.4 fps, JPEG medio 2752 B, compresión 54.7 ms, 0 cuadros descartados, edad hasta fin de compresión 135 ms. En esa prueba el DevKit estaba apagado, así que no encontró la red del carro (esperado). Falta con las dos placas encendidas: que la cámara se una a la red del carro (192.168.4.2), medir el retraso real hasta el teléfono con cronómetro (docs/latencia.md) y fijar `ponerLatenciaVisual`.
- PRUEBA CON EL CARRO (primera calibración real, asistente de la app, Huawei + DevKit, 20:0x): control manual OK (botones mueven los lados correctos y se detiene al soltar) y PING/PONG medido por la app: 30 ms. Calibración guardada (`calibracion.txt`, medidos=15): arranque 0 ms (la reacción descontada lo dejó en 0; error de ±50 ms por medirse con el reflejo), 26.3 ms/cm (≈38 cm/s, el doble de rápido que el valor por defecto de 50), frenado de avance 0.9 cm, giro izquierda 7.8 ms/° y derecha 7.4 ms/° (90° ≈ 700 y 670 ms), frenado de giro 0° en ambos lados. El paso 6 (giro con la cámara) no pudo ajustar el campo de visión porque usa la cámara del teléfono y el teléfono no va montado en el carro: es opcional y queda para cuando la app reciba el video de la Freenove. La distancia de 1.5 m disponible alcanzó (3 s de avance ≈ 1.1 m).
- PRUEBA CON EL CARRO (desvío en línea recta): el usuario observa que el carro NO avanza recto: se va hacia la derecha (a ojo, mucho). Es de hardware (llantas/motores), no de software. Los dos motores van al 100 % (PWM 255), así que solo se puede BAJAR el lado que empuja más. Agregado en el firmware nuevo `VELOCIDAD_IZQ` y `VELOCIDAD_DER` (config.h; por defecto = VELOCIDAD, sin cambio) usados al avanzar y retroceder; los pivotes no se tocan. Si se desvía a la derecha se baja VELOCIDAD_IZQ. Probado en PC: 49 casos con 255/255; compilado con IZQ=235 pasan los casos de avance/retroceso y solo fallan las 2 comparaciones contra el firmware original (suponen 255/255). Falta medir el desvío (cm laterales a una distancia conocida), calcular el ajuste, cargar el firmware y repetir hasta que quede recto. La calibración de ms/cm hecha con el carro desviándose hay que repetirla cuando quede recto.
- PRUEBA CON EL CARRO (cuadrado de 40 cm, 3 corridas): el navegador mandó prácticamente los MISMOS comandos las tres veces (avances de 993 a 1042 ms, giros de 642 a 675 ms), pero el usuario vio que la primera salió bien y las siguientes no formaron un cuadrado: el carro responde distinto cada vez (piso, agarre, batería, pivote de un solo motor). Es el límite de navegar solo por tiempo y el motivo del giro visual. También se midió el desvío en recta: 66.3 cm en 2 s con 1.5 cm a la derecha y 150 cm con 14.5 cm (≈11° de giro acumulado): el desvío crece más que proporcional a la distancia (arco). Se dejó `VELOCIDAD_IZQ`/`DER` en 255/255; si hace falta para tramos largos, bajar IZQ ~2 a 3 % (≈248).
- NUEVO: la app ahora lee el VIDEO DE LA CÁMARA DEL CARRO (`VideoCarro.kt`, MJPEG de `http://192.168.4.2/stream`) y lo mete a la misma cadena que la cámara del teléfono (detector, giro visual, modelo, fusión). Botón «Fuente del video» en la pantalla de visión (`ConfigVision.fuenteCarro`); al abrir pide `/control?size=hqvga` porque la cámara estaba en QVGA (320x240, ~7.5 cuadros/s). Con el video del carro `CamaraObstaculos.latenciaVisualMs` = 320 y `ModoSemiautonomo.iniciar` lo pasa al navegador (`ponerLatenciaVisual`). Primera prueba en el Huawei: llegan cuadros derechos (imagen del carro), a 12 a 13 cuadros/s al inicio pero con tropiezos de 1 a 2 s (bajó a 4.6 y a 1.6): por revisar (WiFi compartido entre el WebSocket del carro y el video, o la cámara).
- PRUEBA CON EL CARRO (giro visual con la cámara del carro): girando el carro A MANO (despacio, 5 s, escena con detalles) el estimador midió +60.3° (la pantalla marcó 61.9°), consistente. Pero con el giro POR MOTOR (paso 6 de la calibración, 3 pruebas de ~90° reales: 92°, 90° y 110°) la cámara vio solo 1.1°, 0.1° y 5.5°: la app rechazó el FOV (fuera de 20° a 150°). Causa (en el registro): el pivote del carro es muy rápido (90° en ~0.67 s ≈ 135°/s) y el video llega a ~12 cuadros por segundo con ~320 ms de retraso: solo caben ~8 cuadros en todo el giro, con mucho desenfoque de movimiento (36 cuadros 'coincidencia débil', 84 'escena uniforme' en la sesión) y el retraso de 320 ms es casi la mitad del giro, así que corregirlo mientras gira no es posible. Opciones: (1) girar más despacio (bajar `VELOCIDAD_GIRO`, hoy 255) para que la cámara alcance a verlo, recalibrando solo los giros; (2) usar la cámara solo para MEDIR el giro ya hecho y corregir la posición estimada, no para cortar el giro; (3) más cuadros por segundo. Además: el campo de visión de la Freenove sigue sin medir (60° por defecto). Agregado en la calibración el botón «Solo calibrar el giro con la cámara» (salta al paso 6 y conserva el resto guardado; antes el resumen partía de valores por defecto).
- PRUEBA CON EL CARRO (cuadrado de 40 cm, 3 corridas seguidas con la calibración guardada): terminaron MUY distinto (la 1.ª ~30° atrasada de rumbo; la 2.ª 15 cm adelante de la 1.ª y con 60° de error; la 3.ª muy atrás de la marca y formó un triángulo). Los giros aislados de la calibración (92°, 90°, 110°) sí eran buenos. Diferencia: en el cuadrado el carro pasa de avanzar a pivotar SIN detenerse (en el registro: FORWARD→RIGHT→FORWARD seguidos), con la inercia de ~38 cm/s, mientras que en la calibración cada giro arranca desde cero. Cambio en `navegador.c`: entre dos movimientos distintos (avanzar↔girar) el navegador manda STOP durante `NAV_PAUSA_ASENTAR_MS` = 300 ms antes del siguiente, para que cada movimiento arranque desde cero como en la calibración; entre tramos rectos seguidos no se detiene. 99 pruebas del navegador (3 nuevas/ajustadas: pausa medida 300 ms exactos, una recta no se detiene a la mitad; la tolerancia del caso de la cámara retrasada con carro 25 % rápido sube de ±12° a ±16° porque la pausa retrasa un poco el giro, 106° contra 131° sin compensar). Falta repetir el cuadrado 3 veces y comparar dónde termina cada una.
- PRUEBA CON EL CARRO (cuadrado con la pausa de 300 ms, 3 corridas): los comandos fueron idénticos (avance ≈1.03 s, pausa ≈0.31 s, giro ≈0.68 s) y el carro terminó prácticamente en el mismo lugar las tres veces: el resultado es repetible. La primera L (avance y giro a la derecha) sale bien; el tercer lado se desvía mucho. El usuario atribuye el desvío al que ya tiene el carro a la derecha al avanzar. Se fija `VELOCIDAD_IZQ` = 248 (≈ −2.7 % al avanzar y retroceder; de la medición: 14.5 cm de lado en 150 cm → radio ≈ 7.8 m → razón de velocidades 1 + ancho_de_vía / radio ≈ 1.022 con ancho de vía ≈ 17 cm). Los giros (pivotes) no cambian. Pruebas del firmware: 49 casos; el modelo del firmware original en las pruebas usa el mismo ajuste (única diferencia deliberada). Falta cargar el firmware (`cargar.ps1 nuevo`), medir otra vez el desvío en 150 cm y afinar (si se pasa a la izquierda, subir el valor).
- PRUEBA CON EL CARRO (recta de 150 cm con `VELOCIDAD_IZQ` = 248): se pasó 16 cm a la IZQUIERDA (muy fuerte al inicio y luego se estabilizó). Con 255 eran 14.5 cm a la derecha. Interpolando linealmente (de +14.5 a −16 cm en 7 puntos de PWM) la recta queda en ≈ 252 (255 − 7 × 14.5/30.5 = 251.7). El "tirón" inicial a la izquierda sugiere que el motor izquierdo con menos potencia arranca más tarde (zona muerta del PWM); si con 252 se nota el tirón, probar un arranque corto a 255 en ambos y luego bajar.
- PRUEBA CON EL CARRO (recta de 150 cm con `VELOCIDAD_IZQ` = 252): se desvió 15 cm a la IZQUIERDA, "igual, fue en el arranque" (con 248: 16 cm; con 255: +14.5 cm a la derecha y creciendo con la distancia). Que 248 y 252 den casi lo mismo y que el desvío ocurra al salir apunta a un tirón de arranque, no a un desvío continuo: el motor izquierdo, con un pelín menos potencia, arranca más tarde que el derecho y el carro gira ≈6° a la izquierda al salir (6° en 150 cm ≈ 15 cm). Cambio en el firmware: al empezar FORWARD o REVERSE los dos motores van al 100 % durante `ARRANQUE_PLENO_MS` = 250 ms y después se aplica `VELOCIDAD_IZQ`/`DER` (`carro.c`, `carro_vigilar_comunicacion`). STOP o un giro dentro de esos 250 ms cancelan el cambio (no revive los motores); un comando desconocido no impide el ajuste. 56 pruebas (7 nuevas) y la comparación con el modelo del original (que ahora incluye el arranque) sin diferencias. Falta cargar y repetir los 150 cm.
- PRUEBA CON EL CARRO (recta de 150 cm con arranque a plena potencia de 250 ms y `VELOCIDAD_IZQ` = 252): desvío de 3 cm a la IZQUIERDA en 150 cm (≈1°, contra 14.5 cm a la derecha sin ajuste). El usuario lo da por bueno ("perfecto"). Quedan fijos `VELOCIDAD_IZQ` = 252, `VELOCIDAD_DER` = 255 y `ARRANQUE_PLENO_MS` = 250. Pendiente: repetir el cuadrado de 40 cm (3 corridas) con este firmware y la pausa de 300 ms del navegador.
- TRABAJO: estabilidad del video del carro y preparación de la prueba de obstáculos con la cámara del carro.
  1a) El DevKit crea su punto de acceso con canal FIJO (`WIFI_CANAL` = 1, el que ya usaba) y ahora con `WiFi.setSleep(false)`; la cámara ya lo tenía y se vuelve a poner una vez conectada (algunas versiones lo reactivan al asociarse). Los dos firmwares compilan (74 % y 80 % de flash); NO se cargaron: PENDIENTE HARDWARE.
  1b) `/stats` de la cámara agrega `reconexiones` (veces que se cayó su WiFi) y `rssi_min_10s` (señal más baja de los últimos 10 s, una muestra por segundo). Con el video abierto la cámara no atiende otra petición, así que la app lee `/stats` justo antes de abrir el video y en cada reintento.
  1c) `nucleo_c/video_stats.c` (14 pruebas): ventana de 10 s con un cubo por segundo (cuadros, hueco más largo, huecos de más de 500 ms) y el hueco que está pasando ahora. `VideoCarro.kt` anota cada cuadro, escribe la línea `VIDEO_STATS` cada 5 s y la pantalla de visión la muestra.
  1d) `VideoCarro` busca entre las redes del teléfono una WiFi en la misma subred que la cámara (192.168.4.x) y abre el video POR ESA red (así no se va por datos móviles aunque Android prefiera esos); anota `red_video=...` y avisa en pantalla (⚠) si no hay una WiFi así. Comprobado en el teléfono: con el carro apagado y el teléfono en otra WiFi (192.168.1.x) sale «NO es la red del carro (red activa: WiFi)». Mismo protocolo (HTTP/MJPEG). Permiso nuevo ACCESS_NETWORK_STATE.
  2) Fail-safe: `navegador_tick` vigila el video: si ya llegaban cuadros y pasan más de `NAV_MAX_HUECO_VIDEO_MS` = 500 ms sin uno, STOP y ERROR (`NAV_MOTIVO_SIN_VIDEO`); ERROR no se sale solo, así que al volver el video el carro NO reanuda. 6 pruebas nuevas: hueco de 300 ms no frena, de ~800 ms sí, 5 s después del regreso del video sigue en STOP y sin moverse, una ruta nueva sí avanza, y sin ningún cuadro (fuente de botones) no se vigila. La app muestra el motivo y conserva su respaldo de 1000 ms.
  3) `OBST_PRUEBA`: `ModoSemiautonomo` toma el PRIMER cuadro de la racha con un obstáculo cerca (cercanía 2 o más) y mide `ms_detectar` (llegada del cuadro → resultado), `ms_stop` (llegada → STOP enviado) y `ms_respuesta` (STOP → PONG de un PING mandado justo después, contando los PING en camino: `ControlLogica.pararConRespuesta`), con cercanía, zona y fuente (detector, modelo o ambos). `nucleo_c/prueba_obstaculo.c` (16 pruebas): retraso = video + ms_stop + ms_respuesta/2; cm = retraso/26.3 + 0.9. Ruta nueva «Prueba de obstáculo (1 m)»: al frenar por un obstáculo la pasada se mide y la ruta se cancela (queda detenido); botón para borrar las cuentas; resumen (`RESUMEN`) al terminar cada ruta.
  4) `docs/latencia.md` reescrito con 38 cm/s y 0.9 cm de frenado: obstáculo cerca 367 ms → 14.9 cm (peor caso del tick 392 ms → 15.8 cm); lado con cuadros cada 80 ms 527 ms → 20.9 cm; cada 120 ms 607 ms → 24.0 cm. La meta de 300 ms sigue sin cumplirse (el video solo son 320 ms).
  5) Modelo de objetos: apagado por defecto (ya lo estaba; en el teléfono de pruebas estaba en SÍ por mis pruebas y se puso en NO). Confianza mínima por defecto de la fusión 400 → 600 milésimas, y las cajas del modelo en la app se filtran a 0.6 (`DetectorTflite.UMBRAL_CAJAS`). Prueba nueva: pared lisa + «refrigerator 43 %» grande y cerca en el camino → se IGNORA aunque todas las clases sean de interés; con 59.9 % también; con 65 % sí cuenta (control). Un caso viejo de la fusión que dependía de 0.4 baja la mínima a propósito.
  Pruebas de PC: calibración 110, trayectoria 28, obstáculos 144, piso 57, fusión 72, movimiento 66, navegador 105, video 14, prueba de obstáculo 16, firmware 56. La app compila y está instalada en el Huawei (modelo en NO). Regla 6: se borraron de la carpeta temporal las capturas de pantalla que mostraban la imagen de la cámara (se tomaron al revisar la pantalla de visión); de aquí en adelante solo se leen logs. Regla 13: lo nuevo dice «la red del carro».
- PRUEBA CON EL CARRO (video y falsos obstáculos, tras cargar los dos firmwares nuevos): el video ya no tropieza: 11 a 12 fps, hueco máximo 92 a 333 ms, ningún hueco de más de 500 ms, la cámara reporta `reconexiones=0`, señal mínima −27 a −31 dBm y envía a 6 a 12 fps. El usuario reportó «sale que hay obstáculos cuando el piso está vacío»: con una línea de diagnóstico nueva (`deteccion|` cada segundo en el log: hay/cercanía/celdas por zona, piso aprendido, grupos, franja y un perfil de brillo central en 8 bandas, solo números) el detector con el carro quieto en el piso vacío da 0 celdas en las tres zonas y piso 133,109,103; en 3 pasadas de la ruta de 1 m sin objeto (≈2.6 s cada una) no frenó ni una vez (0 de 270 muestras con `hay=1`). Antes, el piso aprendido pasó por 89,64,47 y 52,42,35 mientras el carro se movía a mano (el brillo real de la banda de abajo era ~108 de verde, es decir ~133,109,103): mientras el modelo estaba mal, todo lo distinto de ese color se veía como obstáculo. No se reprodujo con el carro en movimiento sobre el piso normal. El usuario pide aproximaciones, no mediciones exactas.
- PRUEBA CON EL CARRO (obstáculos con la cámara del carro: termo parado a ~80 cm; el usuario pidió solo aproximaciones): con la configuración que traía (fila mínima 720–750, 6 celdas mínimas) el termo se marcaba a ~10 cm y el carro, que avanza 14 a 19 cm después del primer cuadro con obstáculo (retraso medido 352 a 482 ms: video 320 + 12 a 134 ms hasta enviar el STOP + mitad del ida y vuelta de 31 a 205 ms), lo golpeaba siempre. La causa principal: la "fila mínima" (qué parte de la imagen cuenta como zona de avance) estaba demasiado abajo; con ella en 500 la cercanía 2 aparecía ~20 cm antes del objeto y aún así chocaba a ~1 cm. Cambios: (1) opción nueva del navegador `navegador_poner_frenar_lejos_centro` (4 pruebas): con el video del carro un obstáculo LEJANO (cercanía 1) en el CENTRO también frena, tras 2 cuadros y 60 ms (los lados siguen igual); la app la activa solo con el video del carro (`ModoSemiautonomo.iniciar`); (2) el diagnóstico `celdas|` en el log (cada cambio de celdas por zona). Navegador: 109 pruebas, todas pasan. Con eso y los controles de la pantalla de visión que el usuario ajustó (fila mínima 440, celdas mínimas 8, umbral de color 40, modelo de objetos encendido) el carro «frena bien» según el usuario (aproximado, sin medir). Notas: un termo angosto crece en el detector de 1 a 8 celdas en un cuadro (~80 ms), y de cercanía 1 a 3 en ~160 ms, así que lo que da margen es la fila mínima baja y el frenado desde lejos, no la sensibilidad. Pendiente: la cartera (plana y baja, probablemente se vea tarde) y repetir en otra escena; el modelo quedó ENCENDIDO en el teléfono de pruebas por decisión del usuario (el valor por defecto del código sigue apagado). Los ajustes viven en las preferencias del teléfono (`vision.xml`), no en el código.
- PRUEBA CON EL CARRO (mochila grande, obstáculos con la cámara): las primeras pasadas «no frenaban» porque la pantalla de control volvía sola a «Obstáculos: botones» al reabrirse (sin obstáculos reales; el registro no tenía ninguna línea de video después de que se salió de la pantalla de visión). Ahora la fuente se RECUERDA (`ConfigVision.obstaculosCamara`) y el panel muestra un ⚠ cuando está en botones. Con la fuente en cámara: la mochila se ve desde ~80 cm desde el primer cuadro (con la opción de frenar desde lejos en el centro): 5 de 6 pasadas ya estaban en ESQUIVANDO 0.5 s después de iniciar (se detiene, espera NAV_PAUSA_MS y gira para rodearla) y terminaron en ERROR a los 1 a 3 s: con un obstáculo tan grande, al girar sigue muy cerca en la imagen y el navegador se rinde («apareció un obstáculo muy cerca mientras esquivaba»), que es lo diseñado. La pasada no se mide si el obstáculo ya está bloqueando al iniciar (no hay un cambio a STOP que medir): para medir el frenado el objeto debe aparecer mientras el carro avanza (por ejemplo, el termo). Resumen de lo medido con el termo: se ve a ~19 cm; el carro avanza 14 a 19 cm después del primer cuadro (retraso 352 a 482 ms): límite físico con 38 cm/s y 320 ms de video; para objetos angostos hace falta bajar la velocidad.
- PRUEBA CON EL CARRO (modelo de objetos con el termo, carro quieto, cámara del carro): se agregó el registro `MODELO` (una línea por segundo: la mejor clase, su porcentaje y su caja aunque no pase el umbral; solo texto). Con el termo parado a ~80 cm el modelo dijo «person» 24 a 39 % con una caja pegada a la esquina izquierda; con el termo más cerca, «refrigerator» 35 a 65 % con una caja que cubre casi toda la imagen (llegó a pasar el 60 % dos veces); NUNCA «bottle». Sin termo, otra vez «person» 24 a 46 % en la esquina. Conclusión: con la cámara del carro (240x176, borrosa, escalada a 320x320) el modelo EfficientDet-Lite0 no reconoce un termo ni es confiable (inventa objetos), así que NO sirve para frenar con objetos angostos; se deja apagado (en el teléfono se puso en NO). Para objetos angostos el límite sigue siendo físico (video 320 ms + 38 cm/s): opciones pendientes: avance a pulsos (potencia siempre al 100 %: bajar la potencia hace que el motor solo zumbe), o aceptar que no se ven objetos de menos de ~15 cm de ancho.
- TRABAJO: esquivar objetos grandes sin rendirse y dejar los ajustes validados como valores por defecto.
  1) Estudio del ERROR con la mochila (`docs/navegador.md`, «Objetos grandes»): dos causas, el cuadro viejo por el retraso del video (llega ~320 ms tarde y todavía muestra el carro girando; con cercanía 3 un solo cuadro bastaba para el ERROR) y el objeto que de verdad sigue al frente tras girar 90° (ancho o muy cerca).
  2) Maniobra de reintento en `navegador.c`: tras cada giro de apartarse el carro queda en STOP y MIRA (espera 300 ms + el retraso del video y usa un cuadro posterior); si el centro sigue en cercanía 3, retrocede 15 cm por tiempo, gira del mismo lado 45° extra (1.er reintento) o 90° extra (2.º) y vuelve a mirar; máximo 2 reintentos, si no, STOP y ERROR (`NAV_MOTIVO_ESQUIVANDO`, como antes). Al terminar deshace el giro acumulado (hasta 180° al lado contrario; con 225° sigue girando los 135° que faltan). Constantes visibles en `navegador.h`: `NAV_MAX_REINTENTOS`, `NAV_ANGULO_REINTENTO_1/2`, `NAV_RETROCESO_CM` (15), `NAV_RETROCESO_MAX_MS` (2000), `NAV_MIRAR_MAX_ESPERA_MS`. RIESGO documentado: el retroceso es ciego (sin cámara ni sensor atrás).
  3) Calibración del retroceso: `CalibracionCarro.ms_por_cm_atras_x10` (bit opcional `CAL_MEDIDO_ATRAS` = 32; texto con la clave opcional `ms_por_cm_atras_x10`), `cal_ajustar_retroceso`, `cal_cm_a_ms_atras`, `cal_ms_a_mm_atras`; paso 6 «Retroceso (opcional)» en `CalibracionActivity` (se mide igual que el avance, con aviso de dejar ~80 cm libres detrás). Sin calibrar usa el valor del avance y la app avisa al iniciar la ruta y en la calibración. La posición estimada usa el retroceso calibrado. La calibración pasó de 9 a 10 enteros en el puente.
  4) Elección del lado: con los dos lados libres, el de menos celdas de obstáculo (`zona_celdas`; la app las manda desde el detector con `NavegadorNativa.ponerCeldas`); empate → izquierda como siempre; un solo lado libre → ese; ninguno → espera y ERROR como antes.
  5) Valores por defecto en el código (`obstaculos.h`): fila mínima 500 → 440, celdas mínimas 6 → 7, umbral de color 60 → 40; modelo de objetos ya estaba en NO; «frenar desde lejos en el centro» ya se activa solo con el video del carro. Documentado en `docs/obstaculos.md` («Valores por defecto validados en el carro real»). Las 5 pruebas de PC que dependían de los defectos viejos usan ahora una configuración explícita (`config_clasica`) y una prueba nueva comprueba los defectos. OJO: el teléfono de pruebas tiene guardados umbral 119 y aprendizaje 100 (las preferencias mandan sobre los defectos); «Restablecer» en la pantalla de visión los vuelve a los del código.
  6) Pruebas de PC: calibración 132, trayectoria 28, obstáculos 144, piso 57, fusión 72, movimiento 66, navegador 134 (25 nuevos: lado, objeto grande, pared, esquina, desaparece tras el giro, 1 y 2 reintentos, reintentos agotados, retroceso calibrado y tope, cuadro viejo por retraso, cancelar al retroceder), video 14, prueba de obstáculo 16, firmware 56. Todas sin fallos. El simulador ahora admite celdas por zona (`sim_agregar_obstaculo_celdas`) y retroceso con otros ms por cm.
  7) App: ruta nueva «Esquivar objeto grande (1.4 m)» (recta de 7 celdas; NO se cancela al frenar pero igual anota `OBST_PRUEBA` en el primer frenado) y registro `NAV esquivar fase=... reintentos=...` en cada cambio de fase. Compila (`gradlew assembleDebug` con `JAVA_HOME` solo en la sesión), instalada por adb y abre sin fallos. PENDIENTE HARDWARE: la prueba con la mochila a mitad de camino (`docs/prueba_obstaculos.md`).
- EXPERIMENTO DE FIRMWARE (pedido por el usuario): velocidad de crucero 210 en vez de 255 (`VELOCIDAD_CRUCERO` en `firmware_carro/config.h`; el lado izquierdo a 252/255 del crucero → 207). El arranque sigue a plena potencia 250 ms y SOLO después baja a 210, para que no vuelva a pasar que desde parado «solo se escucha un pitido» (con menos de 255 desde parado los motores no arrancaban). Los pivotes siguen a 255. Pruebas de PC del firmware: 56 casos sin fallos. Cargado en el DevKit (COM6) con `cargar.ps1 nuevo -Puerto COM6`: arranca, watchdog 5000 ms, AP 192.168.4.1. PENDIENTE HARDWARE: ver si avanza y retrocede sin zumbar ni detenerse tras el arranque y si va recto; si funciona hay que volver a calibrar avance y frenado (ya no valen 26.3 ms/cm ni 0.9 cm) y la latencia de `docs/latencia.md` mejora (menos cm recorridos al frenar); si no, poner `VELOCIDAD_CRUCERO` en 255 y volver a cargar.
- PRUEBA CON EL CARRO (velocidad de crucero 210, un termo): el usuario confirma que SÍ arranca (el arranque a plena potencia de 250 ms funciona), va más lento y frena bien. En el log: el primer cuadro con el termo (cercanía 1 al centro) y el STOP salió ~120 ms después; la ruta terminó en ERROR a los 4 s porque la pasada no se anotó (la racha de `OBST_PRUEBA` solo contaba cercanía 2 o más, y «frenar desde lejos» frena con cercanía 1). Corregido: con el video del carro la racha también cuenta cercanía 1 al centro. PENDIENTE: recalibrar el avance y el frenado a 210 (los 26.3 ms/cm y 0.9 cm eran de 255) y repetir la serie de pasadas para actualizar `docs/latencia.md`.
- LOTE 4, TRABAJO «CALIBRACIÓN A 210» (pedido en EMPIEZA): leído `calibracion.txt` del teléfono por adb (14 oct 09:10): arranque 0 ms, avance 51.7 ms/cm (19.3 cm/s), frenado 1.4 cm, giro izq 12.0 ms/° y der 8.2 ms/°, frenado de giro 38.9° / 0°, retroceso 44.4 ms/cm. `docs/latencia.md` recalculado (obstáculo cerca 367 ms → 8.5 cm; peor tick 9.0 cm; cercanía 2 a un lado 11.6 y 13.1 cm; antes 14.9, 15.8, 20.9 y 24.0 cm a 255) y `docs/calibracion.md` con la tabla 255 contra 210. Los valores de respaldo de la app (si no puede leer la calibración) pasaron de 26.3 ms/cm y 0.9 cm a 51.7 y 1.4. AVISO: los giros no deberían haber cambiado (pivotes a 255) y cambiaron; el giro izquierdo con 38.9° de frenado parece ruido de la medición: se recomienda repetirlo.
- LOTE 4, TRABAJO A (perfiles de velocidad): `config.h` con `PERFIL_MANUAL_*` (252/255, arranque 250 ms, validado a 255) y `PERFIL_AUTO_*` (207/210, arranque 250 ms); `carro.c` con la tabla `PERFILES`, comandos `MODO_MANUAL`/`MODO_AUTO` → `ACK_MANUAL`/`ACK_AUTO`, STOP primero si el perfil cambia en movimiento, perfil AUTO al arrancar, al conectar/desconectar el cliente (`carro_poner_perfil_auto` desde el .ino) y tras el watchdog. Decisiones: el mismo perfil repetido NO frena (la app lo repite cada 3.2 s); MODO_* no se guarda como comando actual y renueva el watchdog como un comando real; la página web del carro (`pagina.h`) pide MODO_MANUAL al abrir y cada 4 PING porque es un control manual. App: `ControlLogica` con `perfilDeseado`/`perfilConfirmado`/`confirmarPerfil`; ControlActivity abre en MANUAL y muestra el perfil, Semiautónomo pide AUTO; las rutas y la prueba de obstáculo esperan `ACK_AUTO` 1 s y si no llega NO arrancan (ERROR claro; con el firmware viejo pasa lo mismo, a propósito); CalibracionActivity siempre en AUTO y no deja probar sin el ACK. Ambigüedad: «EBRAKE disponible» se entendió como que el botón STOP y el comando EBRAKE siguen frenando y que en manual la detección no frena (la cámara ni se usa en manual): documentado en `docs/perfiles_velocidad.md`, sin opción nueva. Pruebas: firmware 87 casos (31 nuevos con la comparación aleatoria al modelo ya con perfiles), servidor falso 14, y el teléfono contra el servidor falso por `adb reverse` (MODO_MANUAL al abrir, ACK, repetición a los 3.2 s). El carro se cargará al final del lote. PENDIENTE HARDWARE: rectas de 150 cm en los dos perfiles anotando el desvío (`docs/perfiles_velocidad.md`).
- LOTE 4, TRABAJO B (corredor de trayectoria): nuevo `nucleo_c/corredor.c/.h` (C puro, enteros, sin math.h): la huella del carro (`ANCHO_CARRO_CM`, `ALTURA_CAMARA_CM`, `INCLINACION_GRADOS`, `FOV_GRADOS`, `MARGEN_LATERAL_CM` configurables) proyectada en la imagen por perspectiva; una caja es DENTRO, BORDE (en la duda frena) o FUERA (solo avisa) según su borde de abajo; interfaz común `CajaImagen` (detector = una caja por celda, modelo de objetos = una por objeto, flujo = una por bloque) y `corredor_aplicar_zonas`. `ZonaObstaculo` ganó `celdas_corredor`, `fuera_corredor` y `cercania_corredor` (en 0 = nada cambia). El navegador distingue `zona_hay` (para elegir lado: un obstáculo fuera del corredor sigue contando como ocupado) de `zona_frena`/`zona_cerc_frena` (lo que frena). App: `CorredorNativa`, `ConfigVision.corredor*`, el cálculo por cuadro en `CamaraObstaculos`, `NavegadorNativa.ponerCorredor` y controles en la pantalla de visión (botón y campo de medidas; los controles se agregan por código para no tocar el diseño). APAGADO por defecto. Decisiones: los valores de partida (carro 18 cm, cámara a 10 cm, 20°, 60°, margen 3 cm) NO están medidos; si el modelo de objetos subió una zona (fusión) esa zona cuenta entera; sobre el horizonte = FUERA; los anchos se redondean hacia arriba (más prudente); una zona cuenta si lo que cae dentro pesa al menos 2 celdas. Pruebas: `pruebas_corredor` 59 casos (geometría contra una referencia independiente con decimales, 45 clasificaciones dentro/borde/fuera a 20 a 120 cm, detector con imágenes sintéticas, 100 000 cajas al azar) y 9 casos nuevos en `pruebas_navegador` (143 en total); el resto de las suites igual. Documentado en `docs/obstaculos.md` («Corredor de trayectoria»). PENDIENTE HARDWARE: medir ancho, altura, inclinación y campo de visión y comprobar dentro/borde/fuera con una caja.
- LOTE 4, TRABAJO C (esquive de objetos grandes): REVISADO, no hacía falta repetir nada: ya estaba completo desde el lote anterior (commits `c11f324`, `a6fca1a` y los de calibración). Comprobado punto por punto contra `lote4_2.md`: (1) estudio del ERROR y la maniobra en `docs/navegador.md` («Objetos grandes»); (2) reintentos con retroceso ciego de 15 cm (`NAV_RETROCESO_CM`, tope `NAV_RETROCESO_MAX_MS`), giros extra de 45° y 90° y máximo 2 reintentos, si no ERROR y STOP; (3) `ms_por_cm_atras_x10` en `CalibracionCarro` y el paso 6 «Retroceso» de `CalibracionActivity` (sin calibrar usa el del avance y avisa; ya medido en el teléfono: 44.4 ms/cm a 210); (4) lado con menos celdas; (5) valores por defecto (fila mínima 440, celdas 7, umbral 40, modelo NO, frenar desde lejos con el video del carro) documentados con unidades en `docs/obstaculos.md`; (6) pruebas del simulador (objeto grande, pared, esquina, desaparece, reintentos agotados). Lo que sí cambió en este lote: con los perfiles el retroceso corre en AUTO (la calibración se mide en AUTO) y con el corredor el reintento mira solo lo que está dentro del corredor (`zona_frena`). PENDIENTE HARDWARE: ruta «Esquivar objeto grande (1.4 m)» con la mochila a mitad de camino, 5 corridas (`docs/prueba_obstaculos.md`).
- LOTE 4, TRABAJO E (pisos negros y de 2 colores): reproducido en PC con cuadros sintéticos (`pisos_sinteticos.c`, `pruebas_pisos_dificiles.c`, solo números). Hechos medidos: (a) el ruido por píxel (3 a 8), el viñeteo, el degradado y el error de color por bloque NO reproducen el falso obstáculo del piso negro (0 de 60 cuadros); lo que sí lo reproduce es un reflejo de luz de +40 niveles o más sobre la tira de referencia (60 de 60 cuadros falsos; el umbral de color bajado a 40 lo hace más sensible); (b) la referencia sobre una sola baldosa deja el otro color como obstáculo (12 de 16 posiciones, 30 de 30 cuadros); (c) la exposición automática solo rompe el detector en una ruta (piso fijo, 4 de 8 escenas), porque en el modo normal la tira agrega el color nuevo. Arreglos (`mejoras_piso`, 1 por defecto): `BRILLO_OSCURO` 150 (solo luminancia, tolerancia mínima 90), tira de referencia de 188 a 800 milésimas con apoyo mínimo del 15 % por grupo (K hasta 4; el color intermedio entre dos grupos ya contaba), reajuste de brillo cuando TODO el piso cambia (con guardas: 70 % de consistencia, 60 % por zona y la tira de abajo cambia igual; una pared del mismo tono que llena la zona no se absorbe, una prueba existente lo atrapó), `piso_fijo` en rutas (no se agregan colores ni se reaprende). Botón «Aprender piso» (Visión y Control): ~1 s con el carro quieto, agrupa los colores de TODA la zona de avance en C (`obstaculos_aprender_*`), muestra colores, brillo medio y avisos «muy oscuro»/«muy variado»; la ruta exige haberlo aprendido desde la ruta anterior o un segundo toque en Iniciar (10 s) que confirma el último. Registro `PISO_DIAG` por cuadro (brillo, ganancia, grupos, celdas marcadas, zonas, motivo, piso_fijo). Resultado: 0 falsos obstáculos con el detector nuevo en todas las escenas vacías; objetos (mano, libreta, caja, mochila) en 5 pisos: 19 de 20 combinaciones 30 de 30 cuadros, peor la mano sobre baldosas beige (22 de 30, máximo 3 seguidos sin verla); sombra suave 0 falsos. Cambios de comportamiento a tener presentes: una celda rara que respalda menos del 15 % de la tira ya no da OBS_ERR_REFERENCIA (se descarta como intruso): 4 pruebas viejas pasaron a usar `mejoras_piso = 0` y tira angosta explícitas y se agregaron las pruebas de la conducta nueva. La configuración del detector pasó de 10 a 12 enteros (opcionales) y el detalle de 38 a 42 enteros (+4 de diagnóstico). Pruebas: obstáculos 146, piso 58, pisos difíciles 24, el resto igual. No se pudo instalar la app en el teléfono: el Huawei pide aceptar la instalación en pantalla (`INSTALL_FAILED_ABORTED: User rejected permissions`). PENDIENTE HARDWARE: pisos de 2 colores y negro en casa y en la universidad (`docs/obstaculos.md`).
- LOTE 4, TRABAJO F (modo «cualquier objeto»): nuevo `nucleo_c/cualquiera.c/.h` (filtros de caja por confianza > 0.15 por defecto, área ≤ 60 %, borde de abajo en la mitad inferior, área y ancho mínimos; persistencia en 2 cuadros del modelo con IoU > 50 %, cercanía 3 basta con 1) y `fusion_decidir_cualquiera` (el color manda: coincidir sube, dudar sube, solo «cualquier objeto» = aviso que nunca frena, desmiente solo un falso positivo de color de cercanía 1). Decisión ambigua: el modo reutiliza la confianza del modelo bajada a 0.01 (`DetectorTflite.umbralCajas`) y filtra en C, así el registro `OBJ_ANY` barre 6 umbrales (0.01 a 0.30) a la vez. Benchmark Lite0/1/2 con `BenchmarkActivity` modo `termico` (60 s por configuración): en CPU de un hilo los tres modelos se degradan ~20 % en 60 s; GPU y NNAPI son estables pero más lentas; Lite1 = 1.8x y Lite2 = 2.7x el costo de Lite0. Lite1 y Lite2 NO se guardan en el repositorio (script `app_android/descargar_modelos_extra.ps1` con hashes); la licencia se anota según la ficha pública y se pide verificarla antes de redistribuir. Pruebas de PC: `pruebas_cualquiera` 64 casos. `scripts/analizar_obj_any.py` calcula falsos por minuto y % detectado antes de 40 cm por umbral. Detalle en `docs/modelo_objetos.md`.
- LOTE 4, TRABAJO G (flujo del piso): nuevo `nucleo_c/movimiento_piso.c/.h` (C puro, enteros): bloques de 16x16, búsqueda en ventana contra el desplazamiento ESPERADO del piso (altura, inclinación y campo de visión del corredor + velocidad AUTO 193 mm/s + ms entre cuadros), afinado de un cuarto de píxel, estados SIN_DATO/PISO/CERCA/DUDOSO (sin textura = sin dato, nunca obstáculo), solo se evalúa con el carro avanzando y cuadros entre 40 y 300 ms. Las pruebas usan un trazador de rayos (cámara + piso + caja) en vez de comprobar la fórmula contra sí misma. HALLAZGO HONESTO (sale de la geometría): con cuadros separados 100 ms el piso y una caja a 20 a 30 cm se mueven casi igual (1 a 2 px de diferencia): el flujo no las distingue; con ~200 ms sí, pero solo hasta ~30 cm (a 36 cm ya no). Por eso la app compara con un cuadro de al menos 180 ms de edad y el flujo es un apoyo de CERCA y para CONFIRMAR pisos con dibujo, no un detector de lejos; casi todo el piso liso o de baldosas grandes queda «sin dato». Entrada opcional en `fusion.c` (`fusion_aplicar_flujo`): el color manda; solo baja un falso positivo de color de cercanía 1 en una zona de «piso con textura consistente» cuando nadie más lo confirma (queda un aviso), nunca baja cercanía 2 o 3 y el flujo solo avisa, nunca frena. Decisión ambigua: cuadros del flujo guardados en un anillo de 8 en la app; velocidad fija en `ConfigVision.flujoVelocidadMmS` (193). Registro `FLUJO_DIAG`. Detalle en `docs/flujo_piso.md`.
- LOTE 4, TRABAJOS D e I (video; van en UN solo commit porque tocan los mismos archivos: `camara_prueba.ino`, `VideoCarro.kt`, `CamaraObstaculos.kt`, `EstadisticaModo.kt`). D: (1) registro `JPEG_MS` y comparación al arrancar de `frame2jpg` contra JPEGENC (Apache-2.0; la copia en `camara_prueba/src/JPEGENC` solo cambia el nombre de `jpegenc.inl` a `jpegenc_inl.h` porque el compilador de Arduino no copia archivos `.inl`); `frame2jpg` SIGUE siendo el predeterminado hasta medir (regla de los 5 ms) y las medidas de la cámara real quedan PENDIENTE HARDWARE; (2) la casilla única y `edad_ms` de `/stats` ya existían: no había nada que cambiar; (3) `TCP_NODELAY` nuevo en el WebSocket del carro (`setNoDelay(true)` al conectar); `setSleep(false)` y canal fijo ya estaban; (4) cadena de 3 hilos con cola de 1 y objetos reutilizados en la app, y registro `MODO_STATS`. I: modos `jpeg|raw|celdas` en la cámara (`/control?modo=`, `/raw`, UDP 4210 con `HOLA`/`PING`), `obstaculos_promediar` y `obstaculos_analizar_modelo_celdas` en `nucleo_c/obstaculos.c` (la entrada por celdas da el MISMO resultado que la imagen: `pruebas_celdas`, 40 casos), formato de paquete en `nucleo_c/paquete_celdas.c`, `scripts/cargar.ps1 camara` copia `obstaculos.c` y `paquete_celdas.c` junto al sketch (la cámara usa el MISMO código C del detector, sin duplicarlo en el repositorio), app con botón de modo y vuelta automática a jpeg si un modo falla, `OBST_PRUEBA` anota `modo_video`. Decisiones ambiguas: (a) en celdas el JPEG paralelo solo se cuenta (fps), no se decodifica, y no hay giro visual, modelo de objetos ni «Aprender piso» (sin imagen); (b) la latencia de video de `OBST_PRUEBA` en raw y celdas es una ESTIMACIÓN (ms de la cámara + mitad del ida y vuelta); (c) el PING/PONG por UDP mide el ida y vuelta de la red en cualquier modo (en vez de un eco por paquete de celdas); (d) orden de bytes del RGB565 supuesto «byte alto primero» (a verificar con el color del piso, `docs/latencia_modos.md` punto 5). PROBADO SIN EL CARRO en el teléfono con una cámara falsa (`scripts/probar_modos_video.py`: HTTP en la PC por `adb reverse` y UDP en el teléfono con un programa compilado con el NDK): los tres modos y los tres fallos (la cámara no acepta el modo, `/raw` mudo, sin UDP) funcionan; así apareció y se corrigió un fallo real de la pantalla de visión (usaba `camara` antes de crearla). Detalle y tabla vacía de las 9 pasadas en `docs/latencia_modos.md`. También `scripts/instalar_app_adb.py`: instala el APK y acepta con el teclado los avisos del Huawei.
- LOTE 4, TRABAJO H: hecho en la rama `investigacion/comparativa-detectores` (no se fusiona a main: trae ONNX Runtime). Resultado y mediciones en `docs/comparativa_detectores.md` de ESA rama (`git show investigacion/comparativa-detectores:docs/comparativa_detectores.md`). Resumen: SSD MobileNetV2 cuantizado por el acelerador NNAPI `liteadaptor` del P40 Pro corre en 11.9 ms (Lite0 en CPU: 39 a 45 ms) pero no se sabe si detecta tan bien: la comparación con el protocolo «cualquier objeto» es PENDIENTE HARDWARE; no se afirma que `liteadaptor` sea la NPU.
- PRUEBA DEL USUARIO (14 oct, 3 pasadas con un obstáculo, retraso total 504 a 542 ms ≈ 11 a 12 cm tras el STOP; una pasada terminó sin ver nada): la app seguía con la configuración GUARDADA del teléfono (umbral de color 198, celdas mínimas 9), que ANULA los valores por defecto validados (umbral 40, celdas mínimas 7, fila mínima 440): los valores por defecto del código solo valen si la preferencia no existe. Con 198 y 9 el detector de color veía el obstáculo con 0 a 3 celdas al centro (necesita 9) y solo frenaba por el modo «cualquier objeto» (fuente detector+modelo) y con parpadeo (0/1) que reinicia la confirmación. Se borraron del teléfono las preferencias umbral_color, min_celdas, fila_minima_mil, aprendizaje_mil y grupos_piso (copia de lo que había en `%TEMP%\vision_usuario_14oct.xml`): con los valores por defecto, 420 cuadros del piso vacío dieron 0 falsos obstáculos (3 celdas marcadas de 7 necesarias). Para volver a los valores por defecto sin adb: botón «Restablecer» de la pantalla de visión. Pendiente repetir las pasadas con el obstáculo.
- DECISIÓN DEL USUARIO (14 oct, tras 3 pasadas con el termo con los valores por defecto: retraso total 393, 532 y 572 ms, 9.0 a 12.5 cm calculados, el carro quedó a 30 a 50 cm del obstáculo): se saltan las pasadas de 150 cm (confirmado a ojo: MANUAL a velocidad normal, AUTO más lento), la calibración del retroceso (el usuario dice que es igual que la de ida: sin calibrar, la app usa el ms por cm del avance con un aviso) y el resto de pruebas de hardware; se prueba todo junto al final. Siguen PENDIENTE HARDWARE: pisos negro y de 2 colores, ruta con mochila, modelo sin reconocer, las 9 pasadas de modos de video, flujo del piso y comparación de compresores JPEG.

## REDISEÑO DE LA APP (mensajes `docs/trabajos/rediseno_1.md` a `rediseno_3.md`, 14 oct)
- REDISEÑO 1.1 (sistema de diseño): `docs/diseno.md` (tokens, tipografía, forma, componentes, movimiento, iconos, lista de revisión), `res/values` (colores, dimens, estilos, tema Material 3 con Inter), `values-night` (tema oscuro, el predeterminado), `scripts/contraste.py` (todas las parejas texto/fondo ≥ 4.5:1 en los dos temas). Se agregó la dependencia Material Components 1.12.0 (no estaba: la app usaba el tema del sistema) con AppCompat, Fragment y ConstraintLayout; todas las pantallas pasan a `AppCompatActivity`. Tipografía Inter variable (OFL 1.1, bajada de `google/fonts`, 856 KB) en 3 familias (400/500/600); iconos Material Symbols outlined (Apache 2.0) como vectores. Componentes nuevos en `Diseno.kt` (`ChipEstado`, `PuntoConexion`, `AvisoBanda`, `Haptica`, `Dialogos`, `Movimiento`) y preferencias nuevas en `Ajustes.kt`. Permiso VIBRATE.
- DECISIÓN (ambigua): «tema oscuro por defecto y claro opcional (sigue al sistema)» se implementó como tres opciones en Ajustes: Oscuro (predeterminado), Claro y Sistema.
- DECISIÓN: botones primarios de 48 dp con radio de 28 dp (queda como píldora) y botones de manejo de 56 dp o más con esquinas de 16 dp (la cruceta de 80 dp), para no tener un botón de 56 dp «principal» en cada pantalla.
- REDISEÑO 1.2 (quitar el nombre anterior): `scripts/buscar_nombre_anterior.py` busca sin distinguir mayúsculas en todo lo que git conoce (código, recursos, cadenas, comentarios, documentos, firmware y scripts; excluye `original_backup/`, la opción del compilador `-W` + `all` y los mensajes originales `docs/trabajos/rediseno_*.md`, que se guardan tal cual). Resultado: 0 referencias. `firmware_carro/pagina.h`: solo se reescribió la capa visual (HTML y CSS, con los colores de la app); el bloque `<script>` quedó IDÉNTICO (SHA-256 `864c4e0a…`). La prueba de hash nueva `scripts/verificar_pagina.py` (se corre con `make test` en `pruebas_firmware/`) comprueba el hash del script, el hash del archivo completo (`firmware_carro/pagina.sha256`) y que no queden referencias. SSID por defecto en las dos `secretos.ejemplo.h`: `CarroFSI`; en los `secretos.h` locales (ignorados por git) se cambió SOLO la línea del SSID, la contraseña no se tocó. El firmware (DevKit y cámara) compila con el nombre nuevo; PENDIENTE HARDWARE: recargar las dos placas, una por USB, y reconectar el teléfono a la red `CarroFSI`.
- REDISEÑO 2.4 (sesión de video compartida): `nucleo_c/sesion_compartida.c/.h` (cuenta usuarios por bit, gracia de 1.5 s al salir el último, FALLO con reintento solo cada 3 s, «Reintentar» inmediato; 43 casos) y `latencia_video.c/.h` (regla: PONG con video más de 30 ms mayor que sin video = video de Manual apagado por defecto; 12 casos). `SesionNativa/SesionVideo/SesionCarro` en Kotlin: UN `VideoCarro` y UNA `ControlLogica` para toda la app; `CamaraObstaculos` ya no crea su `VideoCarro`, entra a la sesión (usuario Visión, Ruta o Detección). El cambio de modo de video de Visión pasa por `SesionVideo.cambiarModo`. Probado en el teléfono con la cámara falsa: Inicio → Manual → Inicio → Manual → Rutas abre el video UNA vez y lo cierra 1.5 s después de entrar a Rutas. `docs/manual_video.md`.
- REDISEÑO 2.1 a 2.3 y 2.5 (navegación, Inicio, Manual, asistente): `MainActivity` pasa a ser el armazón (cabecera fija, barra inferior/lateral, `Fragment` por pantalla); `InicioFragment`, `ManualFragment` (video con `VisorJpeg`, «Ver detección» con `VistaNumerosDeteccion`, cruceta, registro `MANUAL_VIDEO` cada 5 s), `MasFragment`, `AsistenteFragment` (3 pantallas, se puede saltar), `RutasFragment` provisional (se completa en la parte 3). Mensajes de error en `Mensajes.kt` (qué pasó + qué hacer). Extras de prueba de `MainActivity` para adb: `pantalla`, `tema`, `orientacion`, `video_url`, `ws_url`, `asistente_visto`, `video_en_manual`.
- DECISIÓN (ambigua): «Prueba final» (menú Más) se interpreta como la **lista guiada de las pruebas pendientes con el carro real** (modelo sin reconocer, modos de video, pisos, ruta con mochila...), con las casillas guardadas en el teléfono y la medida de latencia con y sin video; se arma en la parte 3.
- DECISIÓN: la fuente variable de Inter no aplicaba los pesos en el Huawei; se generan tres archivos estáticos (`scripts/generar_fuentes_inter.py`, fonttools en un entorno virtual aparte).
- HALLAZGO: la biblioteca de GPU de TensorFlow Lite agregaba a la app los permisos `READ_PHONE_STATE` y de almacenamiento (por su manifiesto viejo); se quitaron en `AndroidManifest.xml` porque la app no los usa y alarman a los antivirus (el usuario reportó una alerta «Evo-gen», casi seguro falso positivo por ser un APK de depuración instalado a mano).
- MANUAL_VIDEO con la cámara y el carro falsos (cable USB): PONG medio 14 a 20 ms con video y 15 ms sin video. PENDIENTE HARDWARE medirlo con el WiFi real (`docs/manual_video.md`, sección 3).
- REDISEÑO 3.1 y 3.2 (editor y simulador de rutas, en C): `nucleo_c/ruta_editor.c/.h` (cuadrícula de 12 x 8 celdas de 20 cm, hasta 32 puntos y 64 celdas; agregar, mover —un arrastre es un solo paso de deshacer—, borrar, limpiar, deshacer/rehacer de 32 pasos, 4 plantillas, resumen con la calibración, guardar/abrir como texto `RUTA1;12x8;...` y validación de nombres; 77 casos) y `nucleo_c/sim_ruta.c/.h` (el navegador REAL con el carro virtual de `simulador_navegador.c`; obstáculos virtuales con un modelo aproximado de la cámara; ruido de giro de ±N grados y dispersión de 8 corridas; 40 casos). Puente `RutaEditorNativa` y `SimRutaNativa`. Detalle y límites en `docs/rutas.md`.
- HALLAZGO del simulador: con un obstáculo de UNA celda en medio de una recta de 1.4 m el navegador esquiva 3 veces y termina en ERROR (al volver a la ruta en diagonal vuelve a ver el obstáculo). Es lo que haría el algoritmo con esa cámara; la pantalla lo muestra como «No llegó» con el motivo y no se maquilló. DECISIÓN: la zona de la cámara virtual solo se marca si al menos 80 mm de la celda (de 200) caen dentro de la zona (como MIN_CELDAS del detector real); sin eso cualquier celda de frente marcaba también las dos zonas laterales y el navegador no podía elegir lado.
- REDISEÑO 3.3 (pantalla Rutas y Ejecutar ruta): `EditorRutaView` (cuadrícula con escala en cm, puntos numerados, huella del carro, obstáculos, animación del carro virtual y puntos finales), `RutasFragment` (herramientas, plantillas, resumen, simular, guardar/abrir, historial), `AlmacenRutas` (rutas con nombre, borrador automático e historial en archivos de texto), `EjecutarRutaFragment` (video compartido, estado en palabras, progreso por puntos, PARO, aprender piso, resumen y detalles técnicos). Se quitó `ControlActivity` y su layout: Manual y Ejecutar ruta la reemplazan (misma lógica de `ModoSemiautonomo`, sin cambios). Extra de prueba nuevo: `--ei ruta_plantilla 0..3` y `--es pantalla ejecutar`.
- REDISEÑO 3.4 (Más, Visión, Calibración) con dos agentes en paralelo (uno hizo Ajustes, Ayuda, Acerca de y Prueba final; otro Visión y Calibración) y revisión mía: la app compila sin avisos nuevos (solo quedan el de `allNetworks` de `VideoCarro` que ya existía y los 3 avisos informativos del manifiesto por los permisos quitados), `scripts/probar_pantallas.py` da OK en las 11 pantallas, vertical y horizontal (22 aperturas) y las pruebas en PC pasan (18 programas de `nucleo_c`, 1088 casos; 87 del firmware; hash de la página web; contraste 4.5:1; sin referencias al nombre anterior).
- DECISIÓN: `MainActivity` mantiene la conexión con el carro mientras la app está a la vista (usuario `USUARIO_MAS`): así la cabecera no dice «Sin conexión» al pasar por Ajustes, Ayuda o Prueba final.
- CIERRE: el teléfono quedó con la configuración REAL (carro `ws://192.168.4.1/ws`, video `http://192.168.4.2/stream`, tema oscuro, video en Manual encendido, asistente de primera vez pendiente); se borraron el borrador y el historial de las pruebas, las capturas de revisión, los archivos temporales del teléfono, los servidores falsos y el `adb reverse`. Se pidió al sistema de instalación aceptar los avisos del Huawei con `scripts/instalar_app_adb.py` (autorizado por el usuario). Las pruebas de diseño usaron SOLO la cámara y el carro falsos; no se miró el video real. PENDIENTE HARDWARE (lo único que debe hacer el usuario): recargar las dos placas por USB una por una (`scripts\cargar.ps1 nuevo -Puerto COM6` y `scripts\cargar.ps1 camara -Puerto COM8`) para que usen el SSID `CarroFSI`, conectar el teléfono a esa red con la misma contraseña, y la prueba final de la app (Más → Prueba final).

## Ajustes (15 oct): reincorporación, falso obstáculo, giros, recta y flujo rápido
- PRUEBA REAL (loseta, tijeras): hallazgos a) no volvía a la línea tras esquivar, b) abortaba con «otro obstáculo muy cerca mientras esquivaba», c) giros de ~110° por 90°, d) en recta se iba ~6 cm a la derecha en 2 s, e) demasiados toques para lanzar una ruta, f) en el simulador un obstáculo de una celda en una recta terminaba en «No llegó».
- (a) y (f) tenían la MISMA causa, en el navegador y no en la cámara virtual ni la pantalla: replanificaba desde la celda más cercana con el rumbo redondeado a 45° y volvía en diagonal a un punto de la ruta que quedaba ANTES del obstáculo, así que lo volvía a ver y esquivaba otra vez hasta agotar las 3. Ahora: pose estimada en cualquier rumbo (tabla de senos; antes solo múltiplos de 45°), tramo en paralelo hasta pasar el obstáculo, punto de la línea 30 cm por delante, giro mínimo, avance, giro al rumbo de la ruta, pausas de 300 ms (log `REINC_DIAG`). Simulador: la caja de 20 cm llega en todas las filas 1 a 5 (15 casos) y la de 40 cm de ancho; ya dice por qué no llegó. DESVIACIÓN de lo pedido: el punto de 30 cm se mide desde donde ya pasó el obstáculo (si no, el camino de vuelta lo cruzaba).
- (b): sin el log de esa prueba no se sabe cuál de las tres hipótesis fue; se corrigieron las tres (ignorar detecciones al girar y 2 cuadros o 150 ms después; solo bloquea el centro con cercanía 2 o 3 confirmada; mismo reintento y error con la causa concreta) y se agregó `ESQUIVE_DIAG`. Cambio de comportamiento: un obstáculo central permanente de cercanía 2 ahora agota los 2 reintentos y da ERROR (antes esquivaba sin verlo).
- (c): el camino del tiempo de giro está bien (perfil AUTO, frenado una sola vez, pausa de 300 ms igual); lo que envejece es la medida (pilas y contactos nuevos). Se agregó «Ajuste fino: giro de 90°» (factor por lado y perfil, «Restaurar valor por defecto»); navegador y simulador usan la calibración con el factor. La causa exacta no se pudo comprobar sin el carro.
- (d): balance del lado izquierdo por perfil (800 a 1000) en la memoria no volátil del carro, mensajes `BAL_AUTO:NNN`, `BAL_MANUAL:NNN`, `BAL?` con ACK, geometría de la recta en C, paso «Ajuste fino: recta», simulador con desbalance, `ARRANQUE_ESCALONADO_MS` (apagado). La página web del carro no cambió (hash igual).
- (e): flujo en 3 toques (Inicio → plantilla o última ruta, Iniciar, Confirmar; Iniciar comprueba conexión, AUTO y aprende el piso, con aviso «Despeja el frente del carro»), «Aprender piso» en Avanzado, plantillas En L e Ida y vuelta, Prueba final con 9 pasos.
- PRUEBAS EN PC: 18 programas de `nucleo_c` (navegador 180, calibración 154, simulador 59, editor 84...), firmware 118 + 15 del arranque escalonado, servidor falso 26, hash de la página, sin referencias al nombre anterior. App y firmware compilan sin avisos nuevos. App instalada en el Huawei (adb) y las 11 pantallas abren sin errores en vertical y horizontal; capturas de Inicio, Ejecutar, Rutas y Calibración revisadas (cámara falsa) y borradas.
- NO SE HIZO: cargar el firmware ni usar el carro. PENDIENTE HARDWARE: ver `docs/progreso.md` (sesión final de pruebas reales).
- «TOMA EL CONTROL» (idea del usuario tras el bolso de 55 cm: las tres zonas veían obstáculo y dio «los dos lados ocupados»): estado AYUDA en el navegador (apagado por defecto en C, encendido en las rutas de la app), cruceta en Ejecutar ruta y «Continuar la ruta» que vuelve a la línea con la pose estimada. 15 casos nuevos en `pruebas_navegador.c`. Detalle en `docs/navegador.md`. PENDIENTE HARDWARE: probarlo con el bolso (la cruceta, el continuar y cuánto queda de la línea).
- PRUEBA REAL de «toma el control» (bolso en el DESTINO de la recta de 1 m): rodeó el bolso, pero al continuar giraba a la izquierda (giro1 = -144°) porque el punto final de la ruta quedó detrás del carro (pose y=343, final y=400) y regresaba hacia él, de frente al bolso otra vez. Corregido: si tras la ayuda ya pasó del final, la ruta termina (`reinc_ya_paso_el_final`, con prueba en C). Recomendado: ruta de 2 m con el obstáculo a la mitad.
- CAIDA de la app (SIGSEGV en navegador_tick durante «paralelo», prueba real 21:56): el puente JNI armaba el ResultadoObstaculos sin ponerlo en cero (filas, columnas y fila_minima_usada con basura) y registrar_cuadro, que anota filas y columnas para ESQUIVE_DIAG, leia fuera del arreglo. Corregido: memset en el puente y se ignora un tamano de cuadricula no creible; prueba en C con basura. Con la app caida el carro quedo a medias de la maniobra (el watchdog lo detuvo al segundo).
- AUDITORÍA (15 oct, noche) con los logs reales del teléfono: cercanía de salida leída del último cuadro (`cercania_salida=1`, paralelo de 878 mm), paralelo que
  seguía de frente fuera de la ruta en «Ida y vuelta», vuelta sin pausa tras avanzar de lado, vuelta del mismo lado tras dos reintentos, ruta a ciegas si no
  llegaba ningún cuadro, y tras «toma el control» una vuelta en diagonal contra el obstáculo (5 ayudas seguidas hasta el ERROR). Todo corregido con pruebas
  (`pruebas_auditoria`, navegador 208 casos). Ver `docs/navegador.md`, «Correcciones de la auditoría».
- CALIBRACIÓN DEL TELÉFONO: `frenado_grados_izq_x10=389` y `der=0` (un giro de 45° a la izquierda dura 82 ms). Es la causa más probable de la «L». Ahora
  `cal_ajustar_giro` rechaza más de 20° de frenado de giro. PENDIENTE: repetir la calibración del giro izquierdo con el carro.
- «Confirmar y salir» caduca a los 60 s (vuelve a comprobar todo). El watchdog del firmware NO se cambió (las pruebas exigen el comportamiento del original).

## Ajustes (16 oct): desplazamiento del centro al girar (J4) y calibración por partes con diagnóstico de ruta (J5)
- HALLAZGO (prueba real, J4): el carro (mecanum, giro con un solo lado: LEFT usa solo el motor derecho y RIGHT solo el izquierdo, ver `pruebas_carro.c`) no gira sobre un punto fijo; en un giro de 1500 ms a la derecha (~200°) todo el chasis se desplaza varios cm y las ruedas traseras tampoco quedan fijas. El navegador estimaba la pose suponiendo giro en el sitio, así que cada giro metía error de POSICIÓN; un esquive tiene 3 o 4.
- J4, modelo: `CalibracionCarro` pasa de 10 a 14 enteros (los 4 nuevos: `desp_adelante_izq_um`, `desp_derecha_izq_um`, `desp_adelante_der_um`, `desp_derecha_der_um`, en µm por grado, por defecto 0). DECISIÓN de unidades y marco: µm por grado (enteros) y en el marco del carro **a mitad del giro** (rumbo inicial + θ/2), que es como lo pidió el trabajo; la medida con cinta se hace en el marco de la posición INICIAL y `cal_desplazamiento_de_medida` la pasa al marco de mitad de giro, de modo que aplicarla al mismo giro devuelve lo medido (±1 mm). Es una aproximación lineal. DECISIÓN: el desplazamiento NO va en `calibracion.txt` (ni en `cal_a_texto`): es por perfil y vive en las preferencias de la app, como el factor del giro; `leerAjustada(perfil)` lo pone en la calibración del navegador, el simulador y las pruebas.
- J4, dónde se aplica: `calcular_pose` (cada tick, desde el total del giro) y `sumar_frenado` (los grados que sigue girando al soltar también mueven el centro). AMBIGUO: «aplica lo mismo al retroceso» se entendió como «a todos los giros del retroceso y de la vuelta» (apartarse, reintentos tras RETROCEDER, enderezarse y los dos giros de la vuelta pasan todos por esas dos funciones); el retroceso en línea recta no gira y no cambia. Simulador: el carro real se desplaza con los mismos valores (`sim->real`) y completa en cada pedacito el total `θ × desplazamiento` en el marco de mitad de giro; así la pose estimada coincide con la real (±3 mm).
- J4, pruebas en C: (a) giro de 90° a la derecha con 1 mm/° hacia adelante deja la pose 64 mm a la derecha y 64 mm arriba (cuenta a mano 90 × 0.707) y el simulador en el mismo lugar; también a la izquierda con atrás y lateral; (b) esquive completo (obstáculo al centro, 0.4 y 0.7 mm/° hacia adelante con un poco de lado): **con el modelo termina a 82 mm de la línea (10 cm o menos) y la estimada coincide con la real (±2 mm); con desplazamiento 0 en el navegador, a 124 mm**; (c) los casos anteriores siguen pasando con 0 (navegador 234 casos, calibración 212). Un primer intento con valores simétricos (izquierda y derecha opuestos) dio 2 mm con y sin modelo porque los giros de apartarse y de volver se cancelan exactamente; se cambiaron a valores asimétricos (adelante en los dos lados, como en un pivote real).
- LÍMITE (J4): el modelo corrige la pose ESTIMADA, no lo que el navegador planea (el giro1, el avance y el giro2 de la vuelta se siguen calculando como si cada giro fuera en el sitio); en el simulador, con 4 a 6 cm por giro, la vuelta queda a unos 8 cm de la línea, que es lo que el propio navegador tolera (a menos de 8 cm solo corrige el rumbo). Pre-compensarlo en `reinc_calcular` queda como siguiente paso si la medida real lo pide. El desplazamiento depende del piso y de las pilas y varía entre giros: es un promedio (documentado en `docs/calibracion.md` y `docs/navegador.md`).
- J4, prueba guiada: una pantalla («Desplazamiento al girar») con perfil, lado y giro de prueba; contadores de 0.5 cm para adelante/atrás e izquierda/derecha y de 45° para el ángulo; 2 repeticiones por lado que se promedian y se rechazan si difieren más de 30 % (distancia entre los dos vectores contra el mayor; con valores casi cero no se rechaza por menos de 60 µm/°, que son 5 mm en un giro de 90°, menos de lo que se mide con cinta); guarda por lado y perfil; «Restaurar valor por defecto». `TURN_DIAG` anota por giro los µm/°, el desplazamiento aplicado en el mapa y en el marco del carro, los grados pedidos y hechos y las duraciones planeada y real.
- J5, calibración por partes: Más → Calibración es ahora una lista de partes independientes (arranque, velocidad de avance, frenado de avance, giro izquierda, giro derecha, retroceso, giro con la cámara, desplazamiento al girar, ajuste fino del giro de 90° y de la recta) con valor actual, fecha y hora de la última calibración, aviso de pilas y «Calibrar solo esto»; «Calibrar todo, en orden» es opcional. DECISIÓN: el trabajo listaba 7 partes; se mantuvieron también arranque, retroceso y giro con la cámara porque ya existían (no se duplicó nada ni se quitó función). Velocidad y frenado se separaron: la velocidad (varios tiempos) guarda solo los ms por cm y conserva el frenado y el arranque; el frenado se mide aparte con UN tiempo (2000 ms, 3 veces) sobre la velocidad y el arranque guardados (`cal_ajustar_velocidad`, `cal_ajustar_frenado`). Cada parte no exige otra, no borra las demás y guarda al terminar; cancelar no cambia nada. Se quitó el requisito de «calibración completa» del ajuste fino del giro de 90° y de la recta.
- J5, giro de prueba: giros y desplazamiento aceptan «Giro de 90° real» (por defecto: el comando que usa el navegador, con el ajuste fino guardado), 180° o duración libre de 500 a 1500 ms; el giro también conserva la prueba de tres tiempos de siempre (es la única que mide el frenado del giro). Con un solo giro de prueba: 3 repeticiones y `ms por grado = (ms − arranque) / (grados − frenado)` con los grados que dice el usuario (`cal_ajustar_giro_fijo`); un frenado de giro guardado de más de 20° (el 38.9° del teléfono) se descarta al volver a medir ese lado. La app anota con qué giro de prueba se midió cada lado y avisa si se mezclan dos distintos; cambiar el giro de prueba a mitad de una medición borra las repeticiones de ese lado.
- J5, rechazo al guardar: `cal_validar_para_guardar` rechaza ms por grado fuera de 3 a 20 (`CAL_ERR_GIRO_FUERA`, dice el lado) y la app no guarda nada y avisa; `cal_es_valida` (1 a 200) NO cambió, para no invalidar lo ya guardado al leerlo. También se revisa antes de guardar el factor del ajuste fino del giro de 90°.
- J5, ruta que no giró «una vez de tres» (40 cm a la derecha, 1 giro): no se rediseñó el navegador. (a) Simulación en C: el primer comando es RIGHT en t = 0, durante 900 ms (738 ms con 8.2 ms/°), después pausa de 300 ms y FORWARD; un solo giro; nunca FORWARD antes del giro. (b) Log `RUTA_DIAG` (envío y fin de cada comando de movimiento con lo pedido, la duración planeada y la real y lo hecho) y, en el resultado de Ejecutar ruta, «Giro pedido / Giro hecho (estimado)». Al probarlo apareció que un avance que seguía de un punto de la ruta al siguiente dejaba un solo registro con los números del último tramo; ahora cada tramo tiene su inicio y su fin. (c) ms por grado de 3 a 20 al guardar (arriba).
- **NO SOFTWARE (J5, d), por simulación:** la parte de software de esa ruta está bien: el comando de giro sale primero, en el primer tick y con el tiempo esperado. Eso apunta a contacto eléctrico intermitente (hardware). Falta confirmarlo con un `RUTA_DIAG` REAL de una corrida que no giró (PENDIENTE HARDWARE): si dice `envia cmd=RIGHT ... pedido=90 plan_ms=...` y el carro no giró, queda como «no software» definitivo.
- PRUEBAS EN PC: 18 programas de `nucleo_c` sin fallos (calibración 212, navegador 234, el resto igual que antes), firmware 118 + 15 (arranque escalonado) y hash de la página, sin referencias al nombre anterior. La app compila sin avisos (`scripts\compilar_app.ps1`) y el firmware compila (`scripts\cargar.ps1 nuevo -SoloCompilar`, 74 % de flash).
- NO SE HIZO: cargar firmware ni usar el carro. **No hubo cambio de firmware: no hay que conectar ninguna placa ni correr `scripts\cargar.ps1`.** El teléfono estaba bloqueado y dormido (pantalla apagada), así que NO se instaló la app nueva ni se revisaron las pantallas de Calibración con `scripts/qa_captura.py` (la lista de revisión de `docs/diseno.md`, sección 7, queda pendiente); las pantallas nuevas usan solo los estilos y componentes del sistema de diseño (Tarjeta, ChipEstado, Boton.*, Texto.*, contadores de 56 dp) y no se escribió ningún hexadecimal suelto.
- REVISIÓN DE CÓDIGO (un agente aparte leyó `CalibracionActivity.kt`, `CalibracionGuardada.kt` y los layouts buscando fallos de ejecución y estados atascados, sin poder probar en el teléfono) y LINT (`gradlew lintDebug`: 9 errores, 8 de ellos de `lineHeight` en `styles.xml` que ya existían, y 1 mío, un `%` suelto en un texto, ya corregido). Corregido: (1) en el resultado no había «Atrás» y el único modo de corregir un dato era salir (descartando todo sin avisar): ahora el resultado tiene «Atrás» y salir pide confirmación; (2) en el desplazamiento «Borrar el último dato / repetir» salía siempre deshabilitado; (3) en el giro con la cámara «Probar» podía quedarse deshabilitado cuando la cámara terminaba de abrir (ahora la pantalla se redibuja); (4) cambiar el giro de prueba del desplazamiento solo borraba el lado actual y podía promediar dos repeticiones de pruebas distintas (ahora borra los dos lados); (5) un doble toque en «Listo» se saltaba también la parte siguiente de «Calibrar todo» (se ignoran los toques en los primeros 700 ms) y «Listo» con una repetición a medias del desplazamiento ahora pregunta; (6) la lista seguía diciendo «Calibrado» tras «Restaurar valor por defecto» (se borra también la fecha); (7) el aviso de «ms por grado fuera de 3 a 20» ahora distingue si el valor malo es de esta prueba o ya estaba guardado de antes. El resto de lo revisado (ids, índices, unidades, signos izquierda/derecha, que una prueba cancelada no escriba nada) quedó bien.
- INCIDENTE: un reemplazo de texto con Python dejó un byte nulo dentro de `puente.c` (una comilla escapada mal); `grep` lo mostró como «Binary file matches», se corrigió con un script que reemplaza el byte antes de cualquier commit y la app compiló después. Desde entonces los cambios al código se hicieron con la herramienta de edición.
- REVISIÓN EN EL TELÉFONO (16 oct, Huawei P40 Pro, `adb` con la ruta completa de platform-tools, carro FALSO por `adb reverse tcp:8080`; no se usó el carro ni se cargó firmware): la app se instaló con `scripts/instalar_app_adb.py` y `scripts/probar_pantallas.py calibracion` dio «abierta=CALIBRACION ok» sin errores. Calibración está fijada en vertical por el manifiesto (`screenOrientation="portrait"`, igual que dice `docs/diseno.md`), así que «horizontal» no aplica a esta pantalla. Se capturaron (solo la app, sin imágenes de la cámara) la lista, arranque, velocidad, frenado, giro izquierdo, retroceso, desplazamiento, giro de 90° y recta, y se recorrió con toques de adb: una prueba de giro con tres datos hasta el resultado («Guardar esta calibración» NO se tocó: los datos eran de prueba; las preferencias del teléfono no recibieron ninguna fecha ni desplazamiento nuevos) y el desplazamiento hasta los contadores. Se encontró y corrigió: (1) «MANUAL (255)» y «90° real» partidos en dos líneas y cortados dentro de su botón de 48 dp, y el botón de tres tiempos cortado → textos más cortos («AUTO 210», «MANUAL 255»), «Giro de 90° real» a todo el ancho y «180°» y «Libre» debajo; (2) el giro de prueba y el perfil quedaban escondidos bajo la tarjeta de notas y había que desplazar para verlos → la tarjeta de notas pasó debajo de los selectores y la ilustración bajó de 144 a 120 dp; (3) la etiqueta «Paso X de N» se partía en dos líneas junto al chip («Giro a la izquierda · Paso 1 de 2») → solo «Paso 1 de 2» (el nombre ya es el título) y «Una sola pantalla» en las partes de una pantalla; (4) la lista empezaba con un título repetido y 3 avisos largos que dejaban las tarjetas fuera de vista → se quitó el título, la introducción es de una frase y solo se avisa si falta algo indispensable; (5) «Guardar esta repetición» y el campo del resultado quedaban tapados por el panel de abajo (el desplazamiento automático usaba la posición del botón dentro de su contenedor, no del scroll) → ahora baja hasta el final; (6) en la ilustración del frenado la palabra STOP tocaba la rueda. Al terminar se restauró la dirección real del carro (`ws://192.168.4.1/ws`, `video_url` real) que las pruebas habían cambiado, se detuvo el servidor falso por su PID exacto (comprobando que era `servidor_falso.py`), se quitó el `adb reverse` y se borraron las capturas.

- TRABAJO ROBUSTEZ DE LA CÁMARA Y DEL WIFI (16 oct). Problema real: la cámara (IP fija 192.168.4.2) dejó de responder en CarroFSI y solo volvió al reconectarla; no se sabe si fue un cuelgue o un choque de IP (el DHCP del DevKit repartía desde la .2, riesgo ya anotado en el trabajo H2). (1) DevKit: `WiFi.softAPConfig(192.168.4.1, 192.168.4.1, 255.255.255.0, 192.168.4.10)` antes de `softAP`; el core 3.3.12 reparte inicio..inicio+10 = **.10 a .20** (leído en `NetworkInterface.cpp`), así que la .2 queda libre. Direcciones en `config.h`; 7 casos nuevos en `pruebas_carro.c` (el rango no contiene la .2 ni la .1). El DevKit escribe `DHCP: configurado ...` al arrancar y `DHCP: entrego 192.168.4.x` por cada teléfono (con aviso si fuera la .2). (2) Cámara: nuevo `camara_prueba/recuperacion.c/.h` (C puro; 34 casos en `pruebas_camara.c`, incluida la vuelta de `millis()`): reintento de `WiFi.begin` con espera 1, 2, 4, 8, 10 s; reinicio a los 60 s sin conectar; vigilante (tarea del núcleo 0) que reinicia si `loop` no da señal en 8 s, si hay demanda de video y la captura lleva 5 s sin cuadro, o si `/salud` (que la placa se pide a sí misma cada 10 s) falla 3 veces seguidas. El motivo del reinicio propio se guarda en memoria RTC. `/stats` suma `ultima_desconexion` (razón de ESP-IDF, texto y hace cuántos s), `reintentos_wifi` y `ultimo_reinicio` (causa: brownout, watchdog_tareas, reinicio_propio..., y motivo); `uptime_s` y `reconexiones` ya estaban. IP fija, canal, `setSleep(false)` y el resto del comportamiento no cambian. (3) App: «La cámara no responde» con la IP intentada («Se intentó con 192.168.4.2 y se reintenta sola cada 3 s...») en Inicio, Manual, Visión, Ejecutar ruta y Prueba final; la sesión de video reabre sola cada 3 s (`SES_REINTENTO_MS` 5000 → 3000, pruebas de sesión siguen en 43 casos, 0 fallos). Pruebas: `pruebas_firmware` 125 + 15 + 34 casos y la página sin cambios, 18 programas de `nucleo_c` sin fallos, la app compila, los dos firmwares compilan (DevKit 74 %, cámara 83 %). NO se cargó nada ni se usó el carro. PARA CARGAR (una placa por USB a la vez): DevKit (COM6) `.\scripts\cargar.ps1 nuevo -Puerto COM6`; cámara (COM8) `.\scripts\cargar.ps1 camara -Puerto COM8`. Para verificar: ver «Robustez del WiFi y de la cámara» en `docs/camara_prueba.md`. NO cubierto: la cámara no se reinicia sola si el sensor no inicia al arrancar, ni detecta una radio colgada que siga marcando «conectado».
- ROBUSTEZ, CARGADO EN LAS PLACAS (16 oct, a pedido): DevKit (COM6) y cámara (COM8) cargados por separado. DevKit: serial con `DHCP: configurado (reparte .10 a .20...)`, `AP Iniciado. IP: 192.168.4.1`. Cámara con el DevKit apagado: no ve la red y reintenta a los 5, 7, 11, 19 y 29 s (5 s de gracia al arrancar y luego 2, 4, 8, 10 s, como en las pruebas). Se vio que los `WiFi.disconnect()` de cada reintento generan razón 36 (STA_LEAVING) y tapaban la razón real (201 NO_AP_FOUND) en `ultima_desconexion`: ahora esas desconexiones voluntarias (36 y 8) no se anotan ni cuentan en `reconexiones`; cámara recargada con ese cambio. PENDIENTE: encender el DevKit, ver que la cámara entra sola con la .2, conectar el teléfono y ver `DHCP: entrego 192.168.4.1x` en el serial del DevKit.
- DESPLAZAMIENTO AL GIRAR: «guardar» devolvía a «repetir intento 1» (16 oct). Investigado en el teléfono con el carro FALSO (`adb reverse`, servidor falso detenido por su PID exacto; sin carro real). RESULTADO: NO era un bug de estado. La repetición 1 se guarda y la pantalla pasa a «Girar (repetición 2 de 2)» (probado). Al guardar la repetición 2, si las dos medidas diferían más de 30 % (con el mínimo de 60 µm por grado, ~5 mm), la app borraba las dos repeticiones y volvía a «repetición 1 de 2» con un texto genérico al fondo de la tarjeta: con 1.5 cm y 3.5 cm (2 cm de diferencia) pasaba justo eso. Arreglo: (1) tolerancia nueva, en C (`cal_desplazamiento_promediar`): se aceptan si la diferencia es de 30 % o menos del mayor O de 1 cm o menos (la mayor de las dos), comparando en cm al ángulo medio de las dos repeticiones; (2) si aun así no coinciden NO se borra nada: cuadro con el motivo exacto («repetición 1: 1.5 cm, repetición 2: 3.5 cm, difieren 2.0 cm (se acepta hasta 1.1 cm...)») y tres opciones: «Repetir la medición», «Guardar el promedio de todos modos» (avisa que será menos confiable; `cal_desplazamiento_promedio`) y «Cancelar»; (3) lo guardado de todos modos marca el ítem de la lista con «Poca precisión» y el texto «Calibrado con poca precisión», y la marca se quita al calibrar bien o restaurar; (4) una medida de una repetición que no sirve ya no se pierde (se corrige con los contadores); (5) cada paso queda en `TURN_DIAG` con `origen=calibracion` (`resultado=guardada|rechazada|repetir|cancelado|promedio_guardado`, `motivo`, cm de cada repetición, diferencia y tolerancia). Pruebas en C: `pruebas_calibracion` pasó de 212 a 233 casos (1.0 y 2.0 cm aceptadas, 1.0 y 2.1 rechazadas, 10.0 y 12.5 aceptadas, 10.0 y 14.5 rechazadas, 1.5 y 3.5 con el detalle exacto, ángulos distintos, tres repeticiones, promedio de todos modos y el flujo de dos repeticiones); los 18 programas de `nucleo_c` y las pruebas del firmware pasan, la app compila. En el teléfono (Huawei, carro falso) se recorrió completo: 1.5 y 3.5 cm → cuadro de tres opciones; «Repetir» (vuelve a la repetición 1 con el motivo), «Cancelar» (no guarda), «Guardar de todos modos» (guarda 197 µm/°, chip «Poca precisión» en la lista) y 1.5 y 2.0 cm (se acepta sin preguntar y el chip vuelve a «Calibrado»); `probar_pantallas.py calibracion`: ok. Las preferencias del teléfono (calibración, ajustes y visión) se respaldaron antes y se devolvieron byte por byte iguales (mismo hash) al terminar; no quedaron datos de prueba. No se usó el carro ni se cargó firmware.
- GIRO DE PIVOTE: LA MEDIDA REAL ERA RECHAZADA POR EL LÍMITE (16 oct). Hallazgo del carro real: LEFT/RIGHT mueven solo un lado (pivote; el giro sobre el eje no mueve el carro por falta de par); medido 6 veces, derecha, AUTO 210, 90° real: el centro se corre 15 cm adelante y 16.5 cm al lado. `adb logcat -d -s TURN_DIAG:I` del teléfono (dos intentos del usuario a las 13:50 y 13:53): `resultado=medida_rechazada motivo=medida_no_valida codigo=-3 medida_mm=(150,165) grados=90`. Código −3 = `CAL_ERR_RANGO`; el límite superado: `CAL_DESP_UM_MAX` = 2000 µm por grado por componente, y esa medida da **2474 µm/° hacia adelante** en el marco de mitad de giro (22.3 cm entre 90°, la cuerda va hacia el rumbo medio). Cambios: (1) `CAL_DESP_UM_MAX` 2000 → 5000 y nuevo `CAL_DESP_TOTAL_UM_MAX` 5000 µm/° para el vector entero (≈45 cm de desplazamiento total en un giro de 90°; 40 cm se aceptan, 46 no); (2) aviso NO bloqueante desde 15 cm (`CAL_DESP_AVISO_MM`): «Desplazamiento grande: confirma que mediste del centro inicial al centro final. El carro avanza X cm mientras gira (arco de unos R cm de radio), no pivota sobre sí mismo.», debajo de los contadores (sin moverlos), en el resumen de la repetición y en `TURN_DIAG` (`total_mm`, `radio_arco_mm`, `aviso=desplazamiento_grande`); el radio sale de la cuerda (`cal_desplazamiento_arco`: 15 y 16.5 cm → 22.3 cm y 15.8 cm); un rechazo por rango ahora dice el motivo y deja corregir sin perder lo anotado; los textos de la pantalla dicen que se mide hacia donde miraba el carro AL EMPEZAR; (3) MARCO: revisado, la app y el modelo ya usaban el marco INICIAL (no hubo que corregir nada) y quedó probado en C con los cuatro rumbos iniciales (0, 90, 180, 270) y contra el marco final; (4) pruebas en C: `pruebas_calibracion` 233 → 253 casos y `pruebas_navegador` 234 → 240: con 15 y 16.5 cm en 90° a la derecha la pose final del navegador queda 16.5 cm a la derecha y 15 cm arriba (±3 mm; el simulador igual, y el `TURN_DIAG` anota `mm=(165,-150)` y `carro_mm=(150,165)`); esquive completo con el pivote real (derecha medida; izquierda espejo, hipótesis): con el modelo termina a 267 mm de la línea contra 613 mm sin el (la pose estimada coincide con la real a 3 mm). HONESTO: la reincorporación MEJORA con el modelo, pero con giros de 22 cm no queda a menos de 10 cm de la línea (lo que sí lograba con los desplazamientos chicos de antes): el resto es geometría del navegador (termina la ruta 27 cm al lado), no de la pose; no se rediseñó el navegador. LÍMITE DEL MODELO: es lineal en el ángulo; un pivote real da cuerda 2R sen(θ/2): medido a 90°, subestima ~8 % a 45°, sobrestima ~15 % a 135° y ~41 % a 180° (≈13 cm de más); por eso se calibra con el giro de prueba parecido al que se usa. SIGUIENTE (si hace falta exactitud en otros ángulos): guardar el punto de pivote y rotar alrededor de él. En el teléfono (carro falso): 15 cm adelante, 16.5 de lado, 90° → aviso, repetición 1 guardada con `um_grado=(2475,118)`; `probar_pantallas.py calibracion` ok; preferencias respaldadas y devueltas con el mismo hash. No se usó el carro, no se tocó el firmware ni las calibraciones guardadas.
- J8 MODELO DE PIVOTE Y PLAN DE REINCORPORACIÓN CON PIVOTE (16 oct). El modelo lineal (µm por grado) fallaba ~8 % a 45°, ~15 % a 135° y ~41 % a 180° contra un pivote real. (1) `calibracion.c`: el desplazamiento se calcula girando el centro
  alrededor del punto fijo del chasis, sacado de la medida (desplazamiento y grados de la prueba): `(R(θ0) − I) v = D`; con 15 cm adelante y 16.5 de lado en 90°, punto fijo en (-7.5, 157.5) mm y R = 157.7 mm. Reproduce la medida a 90° y da las
  cuerdas 2R·sen(θ/2): 120.7 mm a 45°, 291.3 a 135°, 315.4 a 180° (probado ±2 mm). Casos límite (ángulo de la medida < 20° o > 340°, desplazamiento < 5 mm, punto fijo a más de 60 cm): modelo lineal, sin dividir entre cero. Calibraciones guardadas sin
  ángulo se suponen medidas a 90°. Públicas: `cal_pose_tras_giro` y su inversa `cal_pose_antes_del_giro`, `cal_pivote_punto`, `cal_desplazamiento_es_espejo`. El simulador usa el mismo modelo (antes usaba el lineal). (2) `navegador.c`: giro hacia el
  objetivo por punto fijo (5 pasos) o barrido de 1°; punto previo por la inversa para el giro final; punto de la línea pegado al centro de celda; tramo de lado del esquive que cuenta el desplazamiento de los giros (40 − 16.5 − 15 = 8.5 cm → mínimo 10 cm);
  si no cabe (el giro de salida mueve el centro 15 cm hacia adelante y no hay libre) prueba el otro lado o pide AYUDA; red de seguridad en lazo cerrado (error > 8 cm o rumbo a 4° o más → replanifica, máx. 4, luego AYUDA).
  (3) Izquierda sin medida = espejo de la derecha, avisado en la pantalla de Calibración («Izquierda: estimada como espejo de la derecha, mídela») y en el log. (4) App: JNI con 16 enteros (ángulo de la medida por lado), la lista de calibración muestra
  lo que da el modelo. **Distancia final a la línea:** ruta corta RECTA: **267 mm antes** (modelo lineal), 224 mm con el modelo de pivote y el plan viejo, **1 mm ahora**. Ruta LARGA (6 m), obstáculo al centro: 73 mm antes, **19 mm ahora**; izquierda 203 mm y
  rumbo 45° antes, 20 mm y rumbo 0 ahora; el doble de desplazamiento 450 mm y rumbo 90° antes, 23 mm ahora. **Con y sin red de seguridad:** sin perturbaciones las dos dan lo mismo (el plan solo ya llega); con un empujón de 12 cm a la pose en plena vuelta,
  **356 mm sin red y 7 mm con ella**. Pruebas: calibración 253 → 280 casos, navegador 240 → 259; los 18 programas de nucleo_c pasan. HONESTO: la red solo ve lo que ve la estimación (por tiempo y cámara): si el carro real patina y la estimación no se
  entera, no lo corrige; el punto fijo se supone constante (depende del piso y las pilas); los giros por tiempo salen de a 5° (a 5 m, 4° son 33 cm), por eso la red también corrige el rumbo; el giro a la izquierda es el espejo hasta que se mida. La app
  compila pero NO se instaló en el teléfono (el Huawei esperaba confirmar la instalación en pantalla y no se pudo ver para aceptarla; se canceló el `adb install` pendiente): el teléfono sigue con la versión anterior. No se usó el carro ni se tocó el firmware.
  PENDIENTE HARDWARE: medir el giro a la izquierda y verificar con el carro real que el punto fijo ((-7.5, 157.5) mm) predice bien giros de 45°, 135° y 180°.
- DIAGNÓSTICO DE LA PRUEBA REAL DEL 16 OCT (15:15 a 15:20; log en `docs/logs/prueba_2026-10-16.txt`, 148 KB, solo números). Sin usar el carro ni tocar firmware ni calibraciones. Cinco corridas de la misma ruta recta de 8 puntos (1.4 m, de (800,1400) a (800,0) mm), perfil AUTO 210:
  **LÍNEA DE TIEMPO.** A) 15:15:54: DETENIDO a los 0.02 s, esquiva a la derecha (giro 90, avance 253 mm, vuelta 88), pasa en paralelo 499 mm, vuelve (giro -56, avance 417, se detiene a los 103 mm por obstáculo), 2.ª esquivada, 3.er bloqueo, AYUDA «lados bloqueados» a las 15:16:19.0 (los tres lados en cercanía 3 con brillo ~31) y PARO del usuario a las 15:16:20.8. B) 15:17:15: tras el giro de 90, DETENIDO «se perdió el video (más de 500 ms sin cuadros)» a las 15:17:16.387: hubo un hueco real de 503 ms entre los cuadros de las 15:17:15.815 y 15:17:16.318. C) 15:17:35: esquiva y vuelve bien (`REINC fin pose=(814,393,2) desvio_mm=14`), PARO del usuario 2 s después. D) 15:18:07: esquiva y vuelve bien (`fin pose=(801,382,0) desvio_mm=1`, planeado (800,400)), pero 0.6 s después una 2.ª esquivada y, en su paralelo, una 3.ª (esquivadas=3 es el máximo) que lo deja en (800,-34) (3.4 cm pasado el final de la ruta); `REINC fin ... siguiente_punto=6` y la ruta manda RIGHT 180, FORWARD 200, RIGHT 135, FORWARD 280: TERMINADO a las 15:18:32.4 después de dar media vuelta y recorrer la ruta hacia atrás = «se volvió loco». E) 15:20:21: esquiva y vuelve bien (`fin pose=(787,407,358) desvio_mm=13`), 2.ª esquivada, PARALELO 216 mm, a los 0.33 s `BLOQUEA_se_detiene` con **los tres lados en cercanía 3 con 126 a 146 celdas (≈ la mitad de la imagen, brillo normal 156, capa de color 1/3,1/3,1/3 en el 100 % de los cuadros)** durante 4 s: AYUDA «lados bloqueados» a las 15:20:39.8 en pose (1186,158,359); el usuario maneja (LEFT 37, FORWARD, RIGHT 45+24+24, LEFT 11) y «continuar»: `ya_paso_el_final pose=(1141,-100,44)` → TERMINADO. Red de seguridad: **0 correcciones en las 5 corridas** (los 5 planes dieron `correcciones=0`; en los 3 que se completaron la pose estimada terminó a 15, 16 y 18 mm de la planeada); nunca se pasó de 4 ni se agotó. Giros: 30 giros automáticos (sin contar los 5 de «toma el control»), error medio |pedido − hecho| de 1.7° y máximo de 4°. Video: 11.0 a 12.7 fps, huecos máximos de 89 a 499 ms (uno de 503 ms en B), `huecos_mayores_500ms=0` en todos los informes de 5 s.
  **(a) POR QUÉ DETECTÓ OBSTÁCULO AL ARRANCAR.** Desde el primer cuadro del video (15:15:46.008, 3991 bytes) y en las cuatro salidas siguientes la zona **IZQUIERDA tiene obstáculo en el 100 % de los cuadros** (n = 7 a 23 por segundo, ~12 cuadros/s), **cercanía 3, 25 a 32 celdas** (57 en la última corrida, otra luz: brillo 153), mientras CENTRO y DERECHA valen 0 celdas (0 a 2). Decide el detector clásico de piso (`decidio=detector`, severidad 3 en los 13 a 25 cuadros de cada segundo); la capa de color confirma la izquierda (`color=1/3,0/0,0/0`) y el modelo de objetos NO ve nada (`f0,p0,z-1` en los seis umbrales: usar_modelo = true). Referencia de piso aprendida 207,166,142 con 2 grupos; **la franja de referencia (col 4, fila 22, 25x2) está tapada en el 40 a 60 % de los cuadros** (`motivo=obstaculo+franja_tapada`) y `piso_fijo=0` (el piso no se fijó) hasta que arranca la ruta. Con el corredor ACTIVO (18 cm de ancho + 3 de margen, cámara a 10 cm, inclinación 20°, FOV 60°) a menos de ~18 cm de distancia el corredor cubre todo el ancho de la imagen (en la fila de abajo mide 248 px de semiancho contra 160 de la imagen), así que un objeto cercano a la izquierda cuenta como DENTRO; la cercanía 3 en cualquier zona es «inmediata» (un solo cuadro): el navegador pasó a DETENIDO en el primer tick (0.02 s tras iniciar la ruta) y a los 0.54 s ya esquivaba. Al girar 90° a la derecha la zona izquierda sigue con obstáculo y más celdas (64 a 71, cercanía 2), y a los 15:15:54.4 el brillo baja de 156 a 141 (de 165 a 106 en 1.5 s) y CENTRO y DERECHA se encienden (78 celdas marcadas): el contenido de la imagen cambia con la cámara, así que parece escena y no el cuerpo del carro. HIPÓTESIS ordenadas: (1) ~55 %: un objeto o superficie real fija a la izquierda de la marca de salida, a menos de ~30 cm de la cámara (pared, mueble, borde de alfombra o cinta) que el modelo de objetos no reconoce porque no es un objeto; (2) ~30 %: el piso aprendido (207,166,142) no representa lo que hay a la izquierda (otro material, sombra o degradado de luz) y la franja de referencia queda tapada; (3) ~15 %: algo del propio carro en la esquina inferior izquierda de la vista (rueda, cable). **Dato que falta:** dónde (fila y columna) están esas 25 a 32 celdas (hoy `ESQUIVE_DIAG` imprime `filas=? cols=?` y solo se calcula durante la esquivada) y el brillo por zona; la prueba más barata: repetir la salida con el carro girado 90° en el mismo lugar (si la detección se queda en el mundo es escena; si se mueve con el carro es el carro) o con una hoja de color liso delante de la izquierda. No cambié nada de la detección.
  **(b) QUÉ PASÓ AL FINAL.** Causa encontrada y arreglada (local y reproducida): **índice del siguiente punto de la ruta vencido**. Cuando la vuelta a la línea solo corrige el rumbo (a menos de 8 cm de la línea) `indice_objetivo` no se toca, y quedaba en el punto al que iba al detenerse (aquí el 6, o el 1 en la reproducción); mientras esquivaba y pasaba el obstáculo en paralelo el carro había avanzado más allá de ese punto (y de otros), así que `planificar` lo mandaba de vuelta: media vuelta de 180°, avanzar hacia atrás por la ruta y dar la vuelta por los demás puntos. Ya existía antes de J8 (la vuelta vieja también dejaba el índice igual). No fue un bucle de correcciones (0), ni un plan imposible, ni giros que no convergen (30 giros automáticos con error medio de 1.7° y máximo de 4°), ni video (huecos máximos 499 ms salvo el de B), ni AYUDA no disparada (se disparó 2 veces, las dos por «lados bloqueados»). Lo de E (AYUDA a los 4 s con los tres lados en cercanía 3 y 126 a 146 celdas por zona) es otra cosa: o hay una pared o un objeto real adelante (el carro estimaba ir en (1186, 266 → 158), a 16 a 27 cm del final de la ruta, y el de verdad probablemente más adelante, ver (c)) o el detector se saturó; sin imagen no se puede separar.
  **(c) PIVOTE Y ESPEJO.** Sí influyeron, por el espejo, no por el pivote. Lo que muestra el log de calibración (15:00 a 15:13): a las 15:01:44 se guardó la DERECHA medida a 90° (150, 165 mm: R = 15.8 cm); a las 15:03:52 «Restaurar» **borró el desplazamiento de los DOS lados** (la derecha se perdió: en todas las corridas `aviso=derecha_estimada_como_espejo_de_la_izquierda`); la IZQUIERDA quedó medida a 180° con (-85 y -90 adelante, -145 y -150 de lado) → 820 y -486 µm/° → R = 8.7 cm (a 90° midió (65, -110), R = 9 cm: el modelo de pivote es coherente a 90° y 180°, ±3.5 cm). Resultado: **la izquierda y la derecha de este carro NO son espejo** (R = 8.7 cm contra 15.8 cm) y el navegador supuso que cada giro a la derecha movía el centro (3.1 adelante, 11.7 a la derecha) cuando lo real es (15, 16.5): 12 cm de más hacia adelante y 4.8 de lado por cada giro de 90° a la derecha (y 6.6 cm por uno de 56°). Con ese modelo del teléfono, en el simulador (real: derecha 150/165, izquierda -88/-148 a 180°) el carro REAL termina 18 cm pasado el final de la ruta con una esquivada (780, -177) y de 10 a 34 cm con dos (727,-103; 749,-244; 748,-345) mientras la pose estimada dice que llegó al final; con las dos calibraciones conocidas termina a 0.5 a 2.3 cm del final (a lo largo de la línea). Eso explica que el carro real quedara más adelante de lo estimado (puede tener una pared o la mesa del final delante, como en E) y que la red de seguridad no hiciera nada: solo compara la estimación con el plan, y la estimación era coherente con el modelo equivocado.
  **ARREGLO (b).** `reinc_saltar_puntos_pasados` (navegador.c): al terminar la vuelta se saltan los puntos de la ruta que el carro ya pasó por 10 cm o más (medido a lo largo de la ruta con `ubicar_en_linea`, solo si está a 30 cm o menos de la línea) y, si no queda ninguno, TERMINADO; se anota `REINC_DIAG saltados=N ... siguiente_punto=M`. Reproducción en el simulador (`pruebas_final_de_ruta`, ruta de 8 puntos, obstáculo falso a la izquierda al arrancar y otro a los 6 s, derecha sin medir como el teléfono): ANTES `esquivadas=2, siguiente_punto=1, RIGHT 180 y recorrido de 1 m hacia atrás, real (632,-319)` (la prueba falla sin el arreglo: 2 fallos); AHORA termina sin media vuelta con la pose estimada a 6.4 cm del final (la ruta se retoma desde la celda más cercana: hasta media celda de error a lo largo de la línea). 263 casos de navegador (4 nuevos), 18 programas de nucleo_c sin fallos.
  **LO QUE NO SE ARREGLÓ Y HAY QUE HACER.** (1) Medir de nuevo la DERECHA (a 90°, 2 repeticiones): es lo que más error mete; y no usar «Restaurar» para rehacer un solo lado (borra los dos). (2) Un hueco de video de 503 ms ya detiene la ruta (`NAV_MAX_HUECO_VIDEO_MS` = 500 con 11 a 12 fps y huecos normales de 250 a 330 ms): es un margen muy corto; subirlo a ~800 ms es una decisión de seguridad que no tomé. (3) Detener con UN cuadro en cercanía 3 de cualquier zona (`cuadro_es_inmediato`) frena con ruido de 12 a 23 celdas al 20 a 25 % de los cuadros (15:18:16 a 15:18:20): provocó la 2.ª y 3.ª esquivadas de D. (4) El final de la ruta con la vuelta «sin giro final» (J8) puede terminar con el carro girado (rumbo 120° a 160° en 2 de 6 escenarios del simulador) aunque llegue al punto. (5) Registrar fila y columna de las celdas por zona al detenerse en SIGUIENDO para poder separar las hipótesis de (a).
- J9 OBSTÁCULO FANTASMA Y FRENOS ANTI-LOCURA (16 oct). (1) **Calibrar visión** (`mascara_vision.c/h`, 25 casos): máscara 10 x 10 con 3 lugares (artefacto = marcada en 80 % o más en los tres), límites (20 %, nunca las 2 filas cercanas de las 2 columnas centrales,
  «visión sospechosa»), «depende del lugar», hexadecimal y cuadrícula de números sin imagen; el detector ignora las celdas enmascaradas; pruebas: un artefacto fijo se enmascara, un obstáculo de un solo lugar no, un obstáculo central cercano nunca. La franja de referencia tapada
  más del 30 % ya no reaprende. En la app: tarjeta «Visión (artefactos fijos de la imagen)» con fecha, captura de 20 cuadros por lugar, informe y «Restaurar». (2) **Registro `OBS_DIAG`** al arrancar y en cada decisión. (3) **Arranque** con 4 cuadros iguales y **sondeo de 4 cm**:
  en el simulador un fantasma fijo a la izquierda (cercanía 3, 40 celdas, desde el primer cuadro) ya NO hace esquivar (TERMINADO, 0 esquivadas) y el mismo obstáculo que crece al acercarse sí se esquiva; un cuadro suelto al arrancar no decide; el centro ocupado no se sondea.
  (4) **Frenos anti-locura** (giro de más de 150° fuera de la ruta, índice que retrocede, 2.5 veces la ruta, 1 m lejos) con una prueba que reproduce el bug del índice vencido (sin el arreglo el freno para en vez de dar la media vuelta). (5) **Pendientes:** «Restaurar» por parte con confirmación que
  nombra lo que borra (el desplazamiento ya es de UN lado), copia de las últimas 3 y «Deshacer» 10 s; `NAV_MAX_HUECO_VIDEO_MS` 700; cercanía 3 con 2 cuadros o 1 con 60 celdas o más. (6) App reinstalada por adb con `scripts/instalar_app_adb.py` (la primera vez a mitad de J9, a pedido del usuario, que
  se iba y no podía aprobar; la segunda con todo lo de la app); preferencias respaldadas y con el mismo hash antes y después; `probar_pantallas.py calibracion` abre sin errores y la lista muestra la tarjeta nueva. Pruebas: 19 programas de nucleo_c sin fallos (mascara 25, navegador 286,
  calibración 280) y firmware 125 + 15 + 34.
  **HONESTO / NO HECHO:** (a) no usé la cámara ni capturé nada en el teléfono (la captura de la visión y el «Deshacer» no se ejercitaron en el aparato: solo compilan y la pantalla abre); (b) la causa del fantasma sigue sin confirmarse (artefacto de imagen o del lugar): la calibración de 3 lugares es lo que lo decide;
  (c) el sondeo se aplica también a obstáculos solo laterales en cercanía 3 (la regla literal «cercanía 2 o menor» nunca habría sondeado el fantasma real); (d) el rumbo del final de ruta a 20° como máximo solo se logra si el plan lo permite: con el carro ya a pocos cm del final puede quedar torcido (en el simulador, 120°);
  (e) `franja_pct` no llega al `OBS_DIAG` de la app; (f) con el frenado de 2.5 veces la ruta una ruta con muchas esquivadas puede pasar a AYUDA donde antes seguía (es lo pedido).
- J10 CORRECCIONES DE LA AUDITORÍA EXTERNA (16 oct, sobre commit `5433134`):
  - **Punto 1 (Aprender piso al arrancar: color en filas 8-9, descartar grupos solo arriba, > 5 % descartado avisa «Hay algo frente al carro, despéjalo» y no pasa a «Listo para salir»; prueba caja a 40 y 60 cm):** `corregido` (`nucleo_c/obstaculos.c`, `obstaculos_aprender_terminar`; `EjecutarRutaFragment.kt`; `pruebas_pisos_dificiles.c`).
  - **Punto 2 (Reaprendizaje de 1 s: `CFG_PISO_FIJO = 1` desde que termina el aprendizaje en `CONFIRMAR` y `CUENTA` hasta que acaba o se cancela la ruta):** `corregido` (`EjecutarRutaFragment.kt`, `pisoFijoRuta`; `pruebas_pisos_dificiles.c`).
  - **Punto 3 (Fantasma fijo: (a) `zona_celdas[z] = 0` al ignorar por `sospechoso_fijo`; (b) `tick_sondeo` espera hasta 2 cuadros o 1500 ms y repite sin declarar real si `sondeo_n < 2`; (c) ignorar toda la corrida mientras la firma hex siga igual, tope de 12 celdas por zona y se cancela si crece > 30 %):** `corregido` (`nucleo_c/navegador.c`, `registrar_cuadro`, `tick_sondeo`, `sondeo_firma_coincide`; `pruebas_navegador.c`).
  - **Punto 4 (Máscara: si `sospechosa != 0` en `terminarCalibracionVision`, NO activarla, guardar el informe, avisar y pedir repetir):** `corregido` (`CalibracionActivity.kt`, `CalibracionGuardada.kt`, `nucleo_c/mascara_vision.c`, `pruebas_mascara.c`).
  - **Punto 5 (Hueco de video > 700 ms en `ESQUIVANDO` o `REINCORPORANDO`):** `no reproducido` (`navegador_tick` llama a `ir_a_error(nav, NAV_MOTIVO_SIN_VIDEO)`, pasa a `NAV_ERROR` con `NAV_CMD_STOP` permanente y retorna sin ejecutar la máquina de estados ni alternar `STOP`/`FORWARD`; verificado en `pruebas_navegador.c`).
  - **Punto 6 (Umbrales: cercanía 3 en un cuadro frena solo con 6 celdas o más; cercanía 2 al centro exige 2 cuadros; columnas 0 y 9 en filas 7 a 9 evaluadas solo en `ESQUIVANDO` y `REINCORPORANDO`):** `corregido` (`nucleo_c/navegador.h`, `nucleo_c/navegador.c`, `cuadro_es_inmediato`, `registrar_cuadro`, `zona_borde_cerca`; `pruebas_navegador.c`).
  - **Punto 7 (Ruta en L sin obstáculos `(0,0)-(0,600)-(600,600)` con pivote real derecha 15/16.5 cm a 90°, izquierda radio 9 cm y espejo; compensar desplazamiento del giro en toda la ruta y no sobrescribir rumbo real, corrigiendo si difiere > 4°):** `corregido` (`nucleo_c/navegador.c`, `planificar`; error final en simulador **antes / después**: L derecha **400 mm → 5 mm** [real vs estimado 0 mm], L izquierda radio 9 cm **127 mm → 0 mm**, L espejo **230 mm → 5 mm**; `pruebas_navegador.c`).
  - **Punto 8 (Pose tras parar: `ms_paso += frenado - arranque` acotado a 0 y contado una sola vez por parada; prueba de sondeo de 4 cm + ruta de 1 m a $\le$ 1 cm):** `corregido` (`nucleo_c/navegador.c`, `ajustar_paso_tras_parar`, `frenado_pendiente`; error final 0 mm $\le$ 10 mm en `pruebas_navegador.c`).
  - **Punto 9 (Lado sin medir: avisar «Izquierda/derecha sin medir: el esquive puede fallar» antes de ejecutar ruta y dejar continuar):** `corregido` (`nucleo_c/calibracion.c`, `cal_desplazamiento_sin_medir`; `CalibracionGuardada.kt`, `EjecutarRutaFragment.kt`, `ModoSemiautonomo.kt`, `RutasFragment.kt`; `pruebas_calibracion.c`).
  - **Punto 10 (Firmware: proteger estado compartido entre WebSocket `async_tcp` y `carro_vigilar_comunicacion` en `loop()` con cola y `portMUX`, ignorar `WS_EVT_DISCONNECT` de cliente no activo, mantener `PING` sin renovar watchdog):** `corregido` (`firmware_carro/carro.c`, `firmware_carro/carro.h`, `firmware_carro/config.h`, `firmware_carro/firmware_carro.ino`, `pruebas_firmware/pruebas_carro.c`).
  - **Punto 11 (Exportar calibración: `cal_a_texto` y `cal_de_texto` con los 6 campos `desp_*` por perfil y compatibilidad hacia atrás):** `corregido` (`nucleo_c/calibracion.c`, `CalibracionGuardada.kt`, `CalibracionActivity.kt`, `pruebas_calibracion.c`).
  - **Punto 12 (Crear `docs/limites_conocidos.md` con los 10 límites conocidos):** `corregido` (`docs/limites_conocidos.md`).
  - **Punto 13 (No tocar redondeo de `cal_ms_a_grados`, `cal_frenado_grados` ni modo UDP `"celdas"`):** `corregido` (verificado intacto).
  - **Punto 14 (Reinstalar app con `scripts/instalar_app_adb.py`, correr todas las pruebas de `nucleo_c`, firmware y app, `git push` y bitácora):** `corregido` (`nucleo_c` 19 suites / 0 fallos, `pruebas_firmware` 137 + 15 + 34 / 0 fallos, `cargar.ps1 nuevo -SoloCompilar` OK, app compilada y reinstalada por ADB conservando calibraciones guardadas).

- REVISIÓN INDEPENDIENTE DEL J10 (17 oct 2026, auditoría y corrección sobre commit `5433134..HEAD`):
  - **Firmware / Cola de comandos (`firmware_carro/carro.c`, `firmware_carro/carro.h`, `firmware_carro/config.h`, `firmware_carro/firmware_carro.ino`, `pruebas_firmware/pruebas_carro.c`):**
    - *Defectos detectados:*
      1. `firmware_carro/carro.c:319-331, 455, 491`: `carro_procesar_cola()` extraía elementos de la cola dentro de `carro_vigilar_comunicacion()` en `loop()` SIN protección de mutex mientras la tarea de WebSocket (`async_tcp`) encolaba con `portMUX`. Además `carro_recibir_comando()` también llamaba a `carro_procesar_cola()`, produciendo doble punto de extracción concurrente.
      2. Variables de estado compartidas entre hilos/tareas (`balance_mil`, `cola_inicio`, `cola_fin`, `cola_cantidad`, `en_vigilancia`, `procesando_cola`, `hay_cliente_activo`, `cliente_activo_id`) no estaban marcadas como `volatile`.
      3. Conexión y desconexión de clientes en WebSocket llamaban directamente a `carro_detener()` mutando PWM y estado de motores desde el hilo de red asíncrono en colisión con `loop()`.
    - *Solución implementada:*
      - Declaración de variables compartidas como `volatile`.
      - Abstracción de bloqueo portátil: ganchos `hw_bloquear()` y `hw_desbloquear()` con `carro_poner_bloqueo()` / `carro_bloquear()` / `carro_desbloquear()`. En ESP32 usan `portMUX` (`portENTER_CRITICAL` / `portEXIT_CRITICAL`), y en PC usan `pthread_mutex_t`.
      - Un solo punto de extracción: `loop()` en `firmware_carro.ino` vacía la cola bajo el cerrojo invocando `carro_procesar_cola()` y luego llama a `carro_vigilar_comunicacion()` sin que éste extraiga nada.
      - Ampliación de cola a 32 comandos con descarte inteligente: ante saturación descarta primero `PING`, luego el comando no-`STOP` más antiguo, garantizando que `STOP` nunca se pierda.
      - Desconexión y conexión encolan `__STOP_AUTO` en lugar de llamar a `carro_detener()` directamente.
      - Prueba de estrés con 2 hilos en PC (`pthread`, 100 000 comandos aleatorios: STOP, FORWARD, LEFT, PING): 24 914 STOPs enviados == 24 914 ejecutados (0 perdidos), coherencia estricta de `cola_cantidad` (rango 0..32, 0 al finalizar), y estado final de motores idéntico al último comando.
      - Casos de reconexión rápida: cliente anterior desconecta después de conectar el nuevo, sin pérdida de control ni desconexión espuria.
      - Pruebas firmware: 149 casos en `pruebas_carro`, 15 en `pruebas_escalonado`, 34 en `pruebas_camara` (100 % pasando). Compilación limpia con `scripts\cargar.ps1 nuevo -SoloCompilar` (74 % de flash).
  - **Navegador (`nucleo_c/navegador.c`, `nucleo_c/navegador.h`, `nucleo_c/pruebas_navegador.c`):**
    - *Defectos detectados:*
      1. `nucleo_c/navegador.c:900-944`: En tramos $\ge 3$ celdas con radios de giro grandes (6 a 20 cm) y error de giro ($\pm 10$ %), el desplazamiento de pivote provocaba desplazamiento lateral no compensado respecto a la celda objetivo (`lat_actual > MM_POR_CELDA`).
      2. No existía límite por vértice para correcciones de rumbo ($> 4^\circ$), lo que ante ruido sistemático podía causar oscilación/bucle de correcciones.
    - *Solución implementada:*
      - Límite estricto de máximo 2 correcciones de rumbo por vértice (`NAV_MAX_CORR_RUMBO_VERTICE 2`, `corr_rumbo_cuenta`), previniendo cualquier bucle.
      - Compensación de desviación lateral en planificación hacia el punto de parada del vértice.
      - Prueba Monte Carlo de 400 rutas en L (200 normales `(0,0)-(0,600)-(600,600)` y 200 espejo) con radios aleatorios izquierdo/derecho entre 6 y 20 cm y error de giro $\pm 10$ %: 400/400 rutas completadas sin error. Error final medio: 153 mm; percentil 95: 378 mm; máximo de correcciones de rumbo por vértice: 1 ($\le 2$).
      - Comportamiento de rectas y esquives verificado intacto con respecto a `5433134` (311 pruebas en `pruebas_navegador.c`).
  - **Visión / Pisos de dos colores (`nucleo_c/obstaculos.c`, `nucleo_c/pruebas_pisos_dificiles.c`):**
    - *Defectos detectados:*
      1. `nucleo_c/obstaculos.c:1463-1487`: `obstaculos_aprender_terminar` descartaba grupos de color del piso que no tuvieran presencia en las filas 8 y 9 (`en_abajo == 0`). En pisos reales con un segundo tono que solo aparece más adelante (tapete, loseta diferente en filas 4 a 7), el segundo color se descartaba con `descartado_pct > 5 %` y `muy_variado = 1`, marcando falsos obstáculos en toda la trayectoria.
    - *Solución implementada:*
      - Se permite el aprendizaje de un segundo color de piso si forma una franja horizontal continua que abarca el ancho de la imagen (`max_racha >= rejilla.columnas - 2 && col_primera <= 1 && col_ultima >= rejilla.columnas - 2`). Objetos reales aislados (como una caja a 40 o 60 cm) no cubren el ancho completo y siguen descartándose (`muy_variado = 1`).
      - Pruebas comparativas en `nucleo_c/pruebas_pisos_dificiles.c`: piso de dos colores con tapete lejano pasa de marcar falsos positivos a `0 %` falsos obstáculos (`inf_tapete.grupos >= 2`, `descartado_pct = 0 %`, `muy_variado = 0`). Las cajas a 40 cm y 60 cm siguen siendo rechazadas en aprendizaje (`descartado_pct > 5 %`, `muy_variado = 1`) y detectadas correctamente en navegación como obstáculo central.
      - 30 pruebas en `pruebas_pisos_dificiles.c` pasando al 100 %.
  - **Reglas y estado:**
    - `original_backup/` intacto.
    - Sin secretos expuestos.
    - Listo para cargar con `scripts\cargar.ps1 nuevo` en placa DevKit (sin flashear durante la auditoría).
- J11 FASE A (17 oct): giroscopio MPU6050 y láser VL53L0X en el firmware. **Código y pruebas de PC hechos; hardware NO verificado.** Núcleo en C puro (`imu.c`, `tof.c`, `giro.c`, `sensores.c`, `hw_sensores.h`), envoltura de Wire y de la librería de Pololu (MIT) en el `.ino`, constantes en `config.h`, comandos nuevos por la misma cola (`GIRAR`, `CAPS?`, `IMU?`, `TOF?`, `IMU_CAL`, `IMU_CERO`, `LOOP?`, `ANT?`, `SENS`, `TOF_PARO`) y diagnóstico por USB (`I2C?`, `REG:`, `SENS_SERIE`). Pruebas: `pruebas_carro` 152, `pruebas_escalonado` 15, `pruebas_camara` 34, `pruebas_sensores` 187, todas pasan; el estrés de 100 000 comandos con GIRAR mezclado no pierde ningún STOP. ThreadSanitizer no se pudo correr (esta PC no lo tiene). Cargado al DevKit (COM6): el escaneo I2C **no ve el MPU6050 (0x68) en ningún arranque** y el **VL53L0X (0x29) aparece a ratos** (2 de 6 arranques iniciaron bien): es un problema de cableado, ver `docs/sensores.md`. Por eso no se midieron sesgo, deriva, tiempo de loop() ni lecturas del láser, y la Fase B queda sin empezar a la espera de la foto del cableado.
- J11 FASE A, hardware (17 oct, tarde): tras corregir el cableado (SCL del GY-521 no llegaba al DevKit) **los dos módulos funcionan**: MPU6050 en 0x68 (WHO_AM_I 0x68, sesgo -0.46 grados/s, deriva 60 s ≤ 0.8 grados) y VL53L0X en 0x29 (8 de 8 arranques con reintentos de init). Pendiente: el tiempo de loop() dio un máximo de 92 ms (límite 5 ms), causa sin identificar. Se agregaron `PINES?` y `PRUEBAI2C?` por USB y 5 reintentos del init del láser.
- J11 FASE A cerrada + FASE B (18 oct). **Hardware:** corregido el cableado (SCL del GY-521 sin contacto, empalmes), los dos módulos funcionan: MPU6050 en 0x68 (WHO_AM_I 0x68, sesgo -0.47 grados/s, deriva 0.0 grados en 60 s con el carro quieto; las medidas de 0.8 y 25 grados eran manos moviendo el carro), VL53L0X en 0x29 (8 de 8 arranques con 5 reintentos de init). `loop()` máximo medido 1.8 ms en un arranque limpio (el 92 ms anterior se midió en un arranque donde se había corrido el comando de diagnóstico `PRUEBAI2C?`, que escanea 4 veces las 126 direcciones; no es parte del funcionamiento normal). **Firmware:** `TOF_USO`. **Navegador (`navegador.c`):** giros por ángulo (`GIRAR`) con la pose del ángulo REAL, respaldos a tiempo (GIRO_TIMEOUT, GIRO_ERROR, sin respuesta), TOF_PARO como obstáculo sin información lateral (espera hasta 700 ms a la cámara, última rejilla o izquierda), veto y confirmación del láser en cercanía 2 al centro, `SENS_DIAG`, `TURN_DIAG` con por=angulo|tiempo y resumen de giros. Cambio de comportamiento: el freno anti-locura de recorrido ya no cuenta el centro que se mueve al pivotar (con pivotes de 20 cm frenaba rutas buenas: 2 de 400 con giroscopio). **App:** pantalla Sensores (interruptores, estado, recalibrar, prueba de giro por ángulo o por tiempo), `ControlLogica` con los mensajes nuevos. **Pruebas:** 19 programas de nucleo_c sin fallos (navegador 345, 34 casos nuevos de J11), firmware 152 + 15 + 34 + 191. **Monte Carlo (simulación):** 400 rutas en L, sin giroscopio 153 mm medio / 378 p95, con giroscopio 45 mm / 116 p95. HONESTO: el simulador del firmware es mi modelo (escala, sesgo y ruido supuestos); ThreadSanitizer no corre en esta PC, así que se corre en Linux con GitHub Actions (`.github/workflows/sanitizadores.yml`): ThreadSanitizer sobre el estrés con GIRAR y AddressSanitizer+UBSan sobre sensores, carro y navegador, sin errores; la Fase C (`docs/validacion_sensores.md`) necesita el carro. App instalada por adb en el Huawei y pantalla Sensores revisada con el servidor falso (ver `docs/sensores.md`). Primera prueba con el carro real (18 oct): polaridad correcta (GIRAR:+90 giró a la izquierda, ángulo positivo, sin tocar IMU_SIGNO); 6 giros por ángulo medidos por el giroscopio (izquierda 99.2, 93.5, 99.0; derecha 91.0); la prueba se cortó porque el carro chocó. Después, con cinta: un giro suelto de 90° a la derecha midió 92.7° en el giroscopio y ~92° a ojo (centro movido 15 cm adelante y 16 a la derecha, como en la calibración del pivote); 4 giros a la izquierda alineados; 4 a la derecha seguidos sin resolver (a ojo ~60°, giroscopio 367°).
- J12 (18 oct): cuatro ajustes tras la primera prueba real. (1) `giro.c`: 4 anticipaciones (sentido x perfil), mediana de las últimas 5, solo giros de 30° o más, guardadas en NVS si cambian 3 ms o más, `ANT?` con las cuatro y `ANT_BORRAR`; simulación con motor asimétrico: 10/10 izquierda y 9/10 derecha a ±3°. (2) `navegador.c`: si no llega `GIRO_OK`/`GIRO_TIMEOUT` pregunta `IMU?` y compara el ángulo (80 % o más no repite; si no, repite solo lo que falta); se arregló de paso un fallo de J11 (al caer a tiempo en una esquivada se ponía en cero el contador del paso de la ruta). (3) `tof.c`: reintento cada 5 s (sondeo del bus y, solo con el carro quieto, inicialización), `TOFR` en `CAPS`, `ARR?` con los últimos 5 arranques y aviso en la pantalla Sensores si más de 1 de 5 necesita reintentos. (4) `calgiro.c` + pantalla `CalibrarGiroActivity`: 6 giros que inicia el usuario, ms por grado y frenado con el ángulo REAL del giroscopio, aviso si algo cambia más de 10 %, «Deshacer». Pruebas: nucleo_c 20 programas (`pruebas_calgiro` 32 casos nuevos), firmware 152 + 15 + 34 + 224, servidor falso 42. HONESTO: nada de J12 se ha probado en el carro (el DevKit no se recargó); regla nueva: Claude no mueve el carro ni toca por adb los botones de giro o ruta, las pruebas con motores las hace el dueño.
# J13 — Trabajo desatendido (20 oct 2026)

- Fase 6 resuelta, 21 oct 2026 08:01–08:05: el dueño encendió/desbloqueó y habilitó USB; ADB volvió a reconocer el Huawei. No hizo falta introducir ni guardar el PIN. Estado inicial de esta reanudación: stay-on 2 y pantalla encendida. adb install -r: Success, actualización conservando datos de 0.3/código 2 a APP:0.4-adbdd13/código 3. verificar_version.py con --apk pasa: FW/APK adbdd13, nombre 0.4, bytes instalados idénticos al build y fuentes limpias. Sensores revisada con dos capturas autorizadas: versiones correctas, IMU/TOF ok, IMUR=0/TOFR=1, historial IMU 0 de 5 y TOF 5 de 5; aviso de cableado visible, historial afectado por carga/verificación. Autoridad del láser apagada; uso de ambos sensores encendido. Teléfono alcanza DevKit por WiFi, PC no se une. USB 08:03:43: ANT 121,150,20,20 intacto, IMU:2,-47,2,104,0, TOF:253,3, ARR:5,5,11111,1,5,0,00000,0, LOOP:8000,4. El límite de 5 ms sigue pendiente con app conectada, aunque reposo aislado dio 1690 us/0 excesos. Cierre: force-stop app, stay-on 2 restaurado/comprobado, pantalla encendida, UI temporal retirada; Gradle, diagnósticos y helper reset terminados. DevKit y teléfono quedan encendidos por la petición nueva. Sin movimientos ni cámara. Solo cambia documentación; pruebas de producto verdes previas sin cambios de código.
- Reanudación autorizada, 21 oct 2026 07:49–07:55: el dueño pide reactivar, recargar e instalar y autoriza el desbloqueo. Se verifica identidad de PID 14244/19532 del reset; detener el lanzador termina ambos, se liberan RTS/DTR y vuelve CAPS. DevKit queda encendido por la solicitud nueva. FW:adbdd13-20261021 y APP:0.4-adbdd13 compilados desde el mismo HEAD; única placa COM6 conocida, cargar.ps1 nuevo a 921600 y verify-flash de cuatro archivos correctos. NVS sin borrar, ANT conserva 121,150,20,20. USB 07:52:46: IMU/TOF listos, sesgo -0.47 grados/s, TOF 254 mm, TOFR=1/IMUR=0, ARR:5,5,11111,1,5,0,00000,0. LOOP inicial 12935,1; tras LOOP_CERO, 60 s quieto dan 1690 us/0 excesos; dos pasadas de consultas individuales dan 1401–1764 us/0 excesos. Pico inicial no explicado. APK lista; Huawei detectado por Windows USB, pero no aparece en ADB ni fastboot: no hay canal para encender/desbloquear/instalar. Se solicita encendido físico; no se introduce ni registra el dato de desbloqueo. Instalación, versión instalada y Sensores siguen pendientes; última app comprobada era 0.3/código 2. Sin movimientos ni cámara. Gradle y diagnósticos cerrados, helper de reset detenido.
- Cierre físico, 21 oct 2026 07:28–07:40 (Ciudad de México): producto 4233201 publicado y sanitizadores success (39548476207). Se guardó estado del teléfono (stay-on 2, pantalla encendida). HEAD compilado como FW:4233201-20261021 y APP:0.4-4233201. Única placa COM6, DevKit conocida; cargar.ps1 nuevo y verify-flash de cuatro archivos pasan, sin borrar NVS. ANT antes/después 121,150,20,20. USB final: IMU/TOF ok, TOFR=1, IMUR=0, motivo 0, sesgo -0.48 grados/s, TOF 253 mm. LOOP 12858,1 supera 5 ms: no se conoce la causa; queda explícitamente pendiente, no se da por pasado. ARR incluye los reinicios de diagnóstico/carga, no una prueba normal de powerbank.
- APK: adb install -r quedó bloqueado por PIN. No se introdujeron códigos ni se actuó sobre cuentas; se canceló el cliente por PID exacto 17368 según la excepción expresa del dueño. La app instalada sigue en 0.3/código 2. No se verificó la pantalla nueva ni se hicieron capturas. APK 0.4 lista para instalar al desbloquear. Sin movimientos de hardware ni imágenes reales. Se cerró la app, se restauró stay-on 2 y reboot -p fue aceptado; después no hay dispositivo adb, servidor adb cerrado.
- Alimentación: Windows rechazó deshabilitar solo el DevKit con pnputil (Acceso denegado; el programa devolvió exit 0, se comprobó el texto y COM6 siguió presente). uhubctl no disponible y sin soporte efectivo de conmutación en Windows según su documentación; no se tocó el concentrador raíz ni otros puertos. No se cortaron los 5 V. Se dejó el reset sostenido autorizado, probado con silencio de CAPS, arranque FW al liberar RTS y silencio final al afirmarla. Python PID 19532, lanzador 14244, estado y script en %TEMP%\j13_reset_estado.json y %TEMP%\j13_mantener_reset.py. Solo ese helper queda activo; Gradle y servidores de prueba/adb cerrados. Para reanimar: terminar ambos PID y desconectar/reconectar USB. No se confunde reset con corte físico de alimentación.
- Fase 5: autoridad láser opcional a 400 mm en columnas 3..6 proyectadas a la rejilla 10x10, apagada por defecto; requiere el uso general del láser y una lectura válida de hasta 400 ms. Sin dato válido se conserva la cámara. Se conservan zona_hay/celdas laterales para elegir lado con la cámara; solo se suprime su freno si sus celdas están exclusivamente en el carril central. Fuera de él sigue la cámara. Log CONTRADICCION_LASER_CAMARA solo al cambiar la discrepancia. Se reaplica el ajuste tras el navegador_iniciar del puente JNI (la ruta reinicia el núcleo). Diferencia hallada: TOF_PARO_MM sigue siendo 120, no 400; no se cambia el freno existente porque la fase exige conservar el comportamiento apagado. Los 400 son la decisión de navegación. Validación física pendiente, no se activa en el teléfono durante J13.
- Fase 5: 24 casos nuevos de navegador (375), 1 nuevo de firmware que protege el umbral anterior (241 de sensores). Núcleo 1570, firmware total 442, servidor falso 42, verificador siete pruebas, hash y estrés sin pérdidas; APK compila. Primera prueba directa olvidó la espera de cuatro cuadros al arrancar y no recogía la cola de diagnóstico: se corrigió el montaje para simular un carro que ya avanzaba, sin relajar las protecciones del producto. Segundo intento verde; pasada completa posterior también verde.
- Fase 4: FW:<hash de 7 caracteres>-<aaaammdd>, inyectado por cargar.ps1 en copia temporal, impreso al arrancar y en CAPS. App 0.4 / código 3, hash en BuildConfig y assets/version_app.txt. verificar_version.py solo consulta CAPS y lee el APK instalado; --apk compara SHA-256 exacto. Si después de compilar solo se agregan commits en docs/, admite esa revisión antecesora y exige iguales los hashes FW/APK y fuentes versionadas limpias. Así se puede registrar la verificación sin invalidar los binarios por el propio reporte; cualquier cambio de código vuelve a exigir compilar. Siete pruebas del verificador y una nueva de CAPS (240 sensores); núcleo 1546 y compilaciones pasan. Intentos de app: 1 falló por pasar un Provider a SourceSet (la API instalada lo rechaza); 2 por un onNewIntent duplicado introducido al editar; 3 corregido, pasa. Se comprobó el metadato dentro del APK.
- Cámara: video_url de adb vive solo en memoria y fuerza la fuente del carro solo durante esa sesión. La apertura normal sin extra elimina url_video_carro anterior (incluye la URL falsa heredada) y vuelve a 192.168.4.2, como se pidió; cualquier dirección personalizada se puede usar dentro de la sesión de Ajustes, pero se restablece al abrir normalmente. Aviso visible en armazón vertical/horizontal y títulos de Visión/Calibración con varias líneas para no truncarlo. No se vio ni guardó video.
- Carga: en modo nuevo ya no se acepta una placa desconocida ni se sobrescribe para identificarla, incluso usando -Puerto. Debe haber exactamente un puerto serie y la MAC debe estar registrada como DevKit. No se borra NVS. El código anterior de identificación para otros modos se conserva, fuera del trabajo autorizado.
- Fase 3: motivo 4 significa chip configurado pero promedio rechazado; por eso se reinicia solo el promedio (sin los 130 ms bloqueantes de imu_iniciar) al vencer 5 s y con motores detenidos al menos 300 ms. No se recuperan automáticamente otros motivos de fallo. El contador IMUR es por arranque; el historial de cinco se guarda en una clave nueva imuHist, sin cambiar las de anticipación, balance o TOF. ARR agrega cuatro campos IMU al final y conserva los cuatro anteriores. La pantalla muestra motivo y uso de giros por tiempo; GIRAR devuelve GIRO_ERROR:sin_sesgo hasta tener sesgo. Pruebas: 10 nuevas de firmware (239 sensores) y una de navegador (1546 total núcleo). Primer intento solo falló en dos comparaciones exactas de los mensajes antiguos; se actualizaron al protocolo ampliado y el segundo pasa. App y firmware compilan.
- Fase 2: tope 250 ms, AUTO inicial 100 ms, MANUAL 20 ms. Se conserva NVS; no se ejecuta ANT_BORRAR en el carro. Intento 1: la derecha del modelo asimétrico quedó en 8/10 a ±3° (se exigía 9/10). Causa: lectura final a 200 ms truncaba la cola de inercia. Se amplía a 750 ms con motores apagados; el intento 2 recupera 9/10, pero nueve comprobaciones de mensajes aún esperaban 400 ms fijos. Intento 3: esas esperas usan GIRO_ASENTAR_MS, conservando las aserciones de paro inmediato; todo pasa, 229 casos de sensores (+5), 152+15+34 restantes y núcleo 1545. Caso nuevo con inercia de 200 ms supera el viejo tope y alcanza ±3°. Este aumento añade 550 ms de espera por giro por ángulo, dentro del margen del navegador (1500 ms).
- El dueño pide además apagar completamente el teléfono al terminar. Se restaurarán primero los ajustes temporales y luego se intentará apagar con adb; el DevKit, sin energía USB si el hub lo admite, o detenido en reset como alternativa documentada.
- Base c6b4fc5 limpia, remoto e identidad noreply comprobados. No se envían movimientos al hardware. El dueño declara pilas y powerbank desconectadas y autoriza carga e instalación conservando NVS y datos de la app.
- Fase 1: cuatro giros por lado = ocho totales, dos de calentamiento y seis válidos. Se registran los ocho pares para no perder información; un fallo temprano muestra explícitamente las mediciones pendientes. El calentamiento tampoco escala los tiempos siguientes. De los tres válidos se permite quitar solo el peor residuo; el par restante debe tener pendiente positiva, tiempos distintos y frenado admisible (tolerancia negativa máxima 6° por ruido, límite superior 20°), y pasar el ajuste existente. Dos puntos por sí solos siempre definen una recta: esto no demuestra estabilidad física y debe validarse en el carro.
- Fase 1 verde: 1545 casos del núcleo (37 de calgiro, +5); firmware 152+224+15+34, estrés 100000 sin STOP perdido, servidor falso 42, hash de página, APK y firmware compilados. Primer intento del servidor falso falló por ejecutarlo desde la raíz: su subproceso requiere pruebas_firmware como directorio; repetido con el comando documentado, pasa. No es un fallo del producto.

# J13 — Pruebas físicas con movimiento controlado por ADB (21 oct 2026, 20:03 a 20:25)

- Nota: los pasos 0, 1, 2/3 y 5 de abajo los dejó escritos una pasada anterior de esta misma sesión. Revisión posterior: reconfirmé en pantalla FW y APP iguales, giroscopio y láser ok, Autoridad apagada, los botones 90° izq. (346,2215), 90° der. (853,2215) y PARO (600,2521), y recalculé la secuencia de calibración (ver abajo).

- **Paso 0: Preparación sin movimiento.**
  - ADB conectado: teléfono Huawei K5J0220320019510 reconocido.
  - Estado inicial guardado: `stay_on_while_plugged_in=2`, pantalla encendida (`mWakefulness=Awake`), teléfono desbloqueado (`isStatusBarKeyguard=false`). Aplicado `stayon usb`.
  - Red WiFi: conectado a la red del carro (`192.168.4.10`), ping a DevKit `192.168.4.1` exitoso (3.5 a 7.9 ms, 0 % pérdida). PC fuera de la red.
  - Pantalla Sensores (`SensoresActivity`):
    - Versiones verificadas: `FW:adbdd13-20261021` y `App 0.4 (adbdd13)` (coinciden exactamente).
    - Giroscopio: ok (ángulo 4.1°, reintentos del sesgo 0, últimos arranques con reintentos 0 de 5). No requirió recalibrar. Sesgo no enviado en SENS periódicos (en arranque previo fue -0.47 °/s).
    - Láser: ok (libre más de 1.2 m, últimos arranques con reintentos 4 de 5).
    - Interruptores: Usar giroscopio ON, Usar sensor de distancia ON, Autoridad del láser OFF (conservada apagada).
- **Paso 1: Descubrimiento de pantallas y botones.**
  - Pantalla de Calibración de giro: `CalibrarGiroActivity`. Botón "Empezar los 8 giros" (cian) y botón "PARO" (rojo inferior).
  - Pantalla de Giro por ángulo: `SensoresActivity`. Selector de método "Por ángulo (giroscopio)" seleccionado por defecto.
    - Botón "90° izq.": coordenadas de centro `(341, 2204)`.
    - Botón "90° der.": coordenadas de centro `(853, 2213)`.
    - Botón "PARO": coordenadas de centro `(600, 2379)`.
    - Perfil confirmado: AUTO (210) pedido al reanudar `SensoresActivity`.
- **Paso 2 y 3: Análisis de seguridad de la Calibración de giros.**
  - Lectura de código en `nucleo_c/calgiro.c` y `CalibrarGiroActivity.kt`:
    - La secuencia de calibración consta de 8 giros estrictamente alternados (`lado_del_giro(k)` alterna izquierda y derecha):
      - Giro 1: Izquierda 40° (calentamiento)
      - Giro 2: Derecha 40° (calentamiento)
      - Giro 3: Izquierda 40°
      - Giro 4: Derecha 40°
      - Giro 5: Izquierda 70°
      - Giro 6: Derecha 70°
      - Giro 7: Izquierda 100°
      - Giro 8: Derecha 100°
  - Cálculo de desplazamiento acumulado según el modelo físico del pivote del carro:
    - Giro a la derecha de 90°: centro se mueve ~15 cm adelante y 16.5 cm a la derecha.
    - Giro a la izquierda de 90°: centro se mueve ~9 cm adelante y 9 cm a la izquierda.
    - Al alternar izquierda y derecha, el componente de avance hacia adelante se acumula en cada giro en lugar de cerrarse en ciclo:
      - Simulación lineal (µm/°): el carro se desplaza 54.1 cm tras el giro 6; 67.2 cm tras el giro 7 (> 60 cm); y 90.0 cm tras el giro 8 (> 60 cm). Longitud acumulada de trayectoria = 97.3 cm.
      - Simulación de arco de pivote: el carro se desplaza 61.8 cm tras el giro 6 (> 60 cm); 74.6 cm tras el giro 7 (> 60 cm); y 97.8 cm tras el giro 8 (> 60 cm).
    - El desplazamiento acumulado calculado supera holgadamente el límite de seguridad de 60 cm (llegando a ~90-98 cm del punto de partida). En un área libre de 1.5 m (radio ±75 cm desde el centro), esta secuencia provocaría colisión inminente contra obstáculos/paredes (idéntico al incidente documentado el 20 oct).
    - Decisión estricta de seguridad: según la instrucción ("Si la secuencia alterna sentidos y el desplazamiento acumulado calculado pasa de 60 cm, NO la ejecutes: anota el motivo y salta a la prueba 4"), **NO se ejecuta la calibración (ni corrida 1 ni corrida 2)** y se salta directamente a la prueba 4.
- **Paso 5: LOOP.**
  - Revisión del código Kotlin de `app_android`: ni `LOOP?` ni `LOOP:` son consultados ni procesados por la aplicación.
  - No se puede leer el loop desde el teléfono sin cable serie. Anotado como **NO MEDIDO desde teléfono (requiere USB)**. No se conecta ningún cable USB al DevKit.
- **Cálculo de seguridad de la calibración, repetido por mí.** Con los desplazamientos del pivote dados (90° der.: 15 cm adelante y 16.5 cm a la derecha; 90° izq.: 9 y 9) escalados al ángulo de cada giro, la secuencia alternada 40/40/40/40/70/70/100/100 deja el centro a 6.2, 16.9, 23.1, 33.9, 43.9, 61.8, 74.5 y 97.8 cm del inicio. Pasa de 60 cm desde el giro 6: **calibración NO ejecutada (corridas 1 y 2 y Deshacer: NO MEDIDO)**, según la regla de la sesión.
- **Paso 4: giros de 90° por ángulo (SensoresActivity, método «Por ángulo», perfil AUTO 210).** Desde 20:08 hasta 20:21. 24 giros, los 24 con estado OK. Reposo previo de 3 min en la izquierda (20:05 a 20:08) y pausa de 3 min entre lados (20:14:48 a 20:17:51).
  - Izquierda, grados: 91.5, 90.2, 88.5, 89.9 | 89.5, 90.6, 90.6, 89.6 | 91.8, 89.5, 91.4, 88.8. Sumas por bloque: 360.1, 360.3, 361.5.
  - Derecha, grados: 89.2, 90.7, 88.5, 89.2 | 89.3, 89.3, 91.3, 91.4 | 94.0, 90.0, 88.4, 92.5. Sumas por bloque: 357.6, 361.3, 364.9.
  - Tiempos (ms) izquierda: 718, 672, 667, 729, 638, 683, 686, 748, 747, 644, 726, 699. Derecha: 764, 806, 850, 793, 758, 820, 870, 828, 758, 808, 858, 812.
  - Desviaciones del plan: las pausas entre bloques de la izquierda no fueron de 20 s sino de unos 2 min (bloque 1 a 2) y 1 min (2 a 3) por las interrupciones de abajo; las de la derecha sí (26 s y 25 s). Entre giros de un mismo bloque pasaron 6 a 7 s. Nunca se mandó un giro con otro en curso.
- **Incidencias de la ejecución (ninguna movió el carro de más).**
  1. Mi guion de apoyo leyó mal el log: usé un filtro con dos niveles del mismo tag (el último pisa al primero), y el giro 1 (91.5°, terminado bien) se contó como «sin fin»; el guion mandó PARO con el carro ya quieto y cerró la app. Cierres de ese tipo: tras los giros 1, 4 y 5 (PARO más am force-stop, con el carro detenido); después reabrí Sensores y seguí. El giro 6 lo pulsé yo a mano.
  2. Toques que no se registraron (giros 5 en una pasada, 6): al terminar un giro el texto de resultado crece de una a dos líneas y los botones bajan unos 80 px en pantalla (el 90° izq. pasa de y≈2215 a y≈2297 y mi toque cae en su borde). El dueño confirmó que la pantalla se mueve. Solución en el guion: deslizar al fondo de la pantalla (margen derecho) antes de cada toque.
  3. Giro 17: el giro sí se envió y terminó (89.3°, 758 ms; lo leí en el logcat), pero el guion no vio la línea de «inicio» porque comparaba conteos de líneas del logcat, cuyo buffer circular se va vaciando. El guion se cayó por un error de ruta al guardar una captura de diagnóstico, antes de repetir el toque, así que no hubo un segundo giro. Corregí el guion (logcat -c antes de cada toque y búsqueda de «inicio» o «fin» sin contar) y seguí desde el giro 18. La numeración de los giros va de 1 a 24 sin repetidos.
  4. Conexión: el log de la app mostró PING con latencia de 6 a 30 ms durante toda la prueba, sin pérdidas.
- **Paso 5: LOOP** NO MEDIDO desde teléfono (la app no consulta LOOP?). La anticipación (ANT) tampoco aparece en el log de la app: NO MEDIDO.
- **Cierre:** PARO, am force-stop, stay_on_while_plugged_in=2 (valor original, comprobado), pantalla encendida como al inicio, sin wake-locks, app sin proceso. Sin video ni imágenes de cámara; capturas solo de Sensores.

Lectura por USB posterior a los giros, 21 de octubre de 2026, 20:36 a 20:38 (actualiza los puntos «ANT» y «LOOP» de arriba).
- El dueño conectó el DevKit a la PC con un cable corto; por eso el carro no se movió y solo hice consultas de lectura por COM6 (única placa serie), con DTR y RTS apagados. La placa sí se reinició al conectar el USB: ARR cambió y el LOOP volvió a mostrar el pico de arranque.
- 20:36:41: CAPS:IMU=1,TOF=1,TOFR=0,IMUR=0,IMUM=0,IMUE=2,FW:adbdd13-20261021; IMU:0,-47,2,104,0 (sesgo -0.47 grados/s, sin cambio); TOF:1200,1 (libre); ANT:126,189,20,20; ARR:5,2,11000,0,5,0,00000,0; LOOP:12856,1.
- ANT (AUTO izquierda, AUTO derecha, MANUAL izquierda, MANUAL derecha): antes de los giros 121,150,20,20; ahora 126,189,20,20. La izquierda subió 5 ms y la derecha 39 ms; MANUAL no cambió (no se usó) y ninguno llegó al tope de 250 ms. La derecha ya salió del tope anterior de 150 ms, lo que apoya (no demuestra) que el sobregiro derecho bajó de 1.8° a 0.3° por eso. No explica que las sumas por bloque a la derecha crecieran (357.6°, 361.3°, 364.9°): con más anticipación se esperaría menos sobregiro. Solo tengo el valor final guardado, no su trayectoria durante la prueba: esa anomalía sigue sin causa determinada.
- LOOP: el de los 24 giros NO se pudo leer, porque el reinicio al conectar el USB borró los contadores (viven en RAM). El pico inicial de 12.856 ms con un exceso de 5 ms aparece en los tres arranques observados (12.858, 12.935 y 12.856 ms): es del arranque, no de la marcha. Tras LOOP_CERO, en reposo, con la app cerrada y sin cliente WiFi: 1684 us a los 15 s, 1717 us a los 30 y 60 s, cero excesos. LOOP con el carro en marcha y la app conectada: NO MEDIDO; hace falta conectar el USB antes de mover el carro (cable largo, o carro con las ruedas en el aire) y no reiniciarlo.
- Sobre el ángulo real: el dueño indica que el giroscopio es muy exacto; los ángulos de arriba se toman como reales, sin que yo los haya comprobado con cinta.
- Sin cambios en firmware ni en NVS. LOOP_CERO solo pone a cero dos contadores en RAM. Sin movimiento.

LOOP con el carro en el aire y la app conectada, 21 de octubre de 2026, 20:48 a 20:51 (actualiza el punto «LOOP en marcha» de arriba). El dueño dejó el carro sobre un soporte con las ruedas en el aire y el USB conectado; solo se pulsaron 90° izq. y 90° der. de la pantalla Sensores (giro por ángulo).
- Fase A, app conectada y carro en reposo, 60 s tras LOOP_CERO: LOOP:8431,2 (máximo 8.431 ms, dos excesos de 5 ms). Antes, con la app conectada, ya se había visto 8.000 ms y cuatro excesos; sin cliente WiFi, en reposo: 1.717 ms y cero excesos.
- Fase B, 36 s con la app conectada y cinco giros (cuatro a la izquierda y uno a la derecha): LOOP:3251,0 (máximo 3.251 ms, cero excesos) con los motores encendidos unos 9 s en total. Lectura final: la misma, LOOP:3251,0.
- Giros 1 a 4 (izquierda): GIRO_TIMEOUT a 1850 ms, con 1.1, 0.3, 0.4 y 0.0 grados medidos, como se espera con las ruedas en el aire. Giro 5 (derecha): GIRO_TIMEOUT a 1850 ms pero con 71.3 grados medidos: el carro sí giró. Causa no determinada (puede haber rotado sobre su soporte o una rueda tocó algo; el giro izquierdo no lo hizo). Abortó el guion: PARO, am force-stop. Faltan los giros 6 a 8 y el movimiento real del soporte está por revisar por el dueño.
- ANT no cambió (126,189,20,20): GIRO_TIMEOUT no corrige la anticipación, solo GIRO_OK. IMU:211,-47,2,104,0 al final (ángulo 21.1 grados, el giroscopio sigue vivo). Las consultas ANT? y LOOP? del inicio de esta prueba no recibieron respuesta (None) y luego todo respondió; causa no determinada, no se repitió.
- Lectura: el pico de LOOP (8 ms, dos excesos por minuto) aparece con la app conectada y el carro en reposo, y en los 36 s con motores encendidos no apareció. Es una muestra corta, así que el límite de 5 ms NO se da por pasado con la app conectada. Causa más probable: el tráfico WebSocket de la app (PING y MODO_AUTO cada pocos segundos, flujo SENS), no los motores. Se confirmaría con ventanas largas (10 min) con la app conectada en reposo contra el mismo tiempo con motores, y con WiFi sin cliente (ya medido: 1.7 ms).
- Cierre: app cerrada con force-stop, stay_on_while_plugged_in=2 comprobado, sin cambios en firmware ni NVS.

LOOP con el carro en el piso y el cable USB de 1 m, 21 de octubre de 2026, 20:54 a 20:56 (actualiza el punto «LOOP en marcha» de arriba). Carro en el piso con 1 m despejado, DevKit por USB a la PC, app conectada en Sensores, LOOP_CERO antes de empezar. Bloque de cuatro giros a la izquierda y después cuatro a la derecha (el segundo bloque no se llegó a hacer).
- Giros a la izquierda: 85.9, 94.4 y 91.6 grados (642, 706 y 674 ms), todos OK. Giro 4: GIRO_TIMEOUT a 1850 ms con solo 24.3 grados medidos de 90: el carro no completó el giro. Causa más probable: el cable USB se atoró o se tensó (el carro se movió más lejos o se enredó), o una rueda quedó trabada. Se confirmaría revisando cómo quedó el cable y repitiendo con más holgura. Se abortó por la regla de 25 grados: PARO y am force-stop. Los motores estuvieron como máximo 1850 ms atascados por el límite del firmware.
- LOOP tras 3 giros OK y 1 giro atascado, con la app conectada: LOOP:6775,3 (máximo 6.775 ms, tres excesos de 5 ms) en unos 40 s con la app conectada y motores encendidos unos 8 s. Con el carro en el aire: 3.251 ms y cero excesos; en reposo con la app conectada: 8.431 ms y dos excesos. Con tan pocos datos no se puede atribuir los excesos a los motores, a la app o al cable; el límite de 5 ms NO pasa en esta prueba.
- ANT sin cambios (126,189,20,20) tras los tres giros OK; IMU:3635,-47,2,104,0 (el ángulo acumulado del giroscopio, sin importancia). Las consultas ANT? e IMU? de una pasada no recibieron respuesta y a la siguiente sí; ya había pasado antes, causa no determinada.
- Cierre: app cerrada con force-stop, stay_on_while_plugged_in=2, sin cambios en firmware ni NVS. No se repitió el giro 4 ni se hizo el bloque de la derecha. Pendiente: que el dueño revise la posición del carro y del cable.

Segundo intento en el piso con el cable USB, 21 de octubre de 2026, 20:57 a 21:00 (sustituye la causa probable del giro atascado de arriba). El dueño había acomodado el cable y confirma que durante el bloque de la derecha agarraba el carro con la mano.
- Bloque a la izquierda, con LOOP_CERO antes: 90.3, 88.0, 91.3 y 86.5 grados (661, 631, 673 y 695 ms), todos OK; suma 356.1. LOOP tras ese bloque: LOOP:6783,2 (máximo 6.783 ms, dos excesos de 5 ms, unos 35 s con la app conectada y motores encendidos unos 3 s).
- Bloque a la derecha: giro 5 OK con 86.8 grados pero en 1196 ms (lo normal es unos 800 ms) y giro 6 GIRO_TIMEOUT con 79.1 grados: ambos NO son válidos como medida del giro porque el carro estaba sujeto con la mano. Se abortó por la regla de estado distinto de OK. El LOOP no cambió después de la izquierda (6783,2).
- Efecto en la anticipación: el giro 5 terminó con GIRO_OK y corrigió ANT con un dato falso: ANT pasó de 126,189,20,20 a 126,144,20,20 (la derecha AUTO bajó 45 ms). La izquierda quedó igual tras sus cuatro giros válidos. Esa anticipación derecha de 144 ms es un valor contaminado, menor que los 189 ms aprendidos con giros válidos; los siguientes giros a la derecha se pasarán más hasta que se reaprenda. No se tocó (ANT_BORRAR escribiría en NVS y no se autorizó). Se corregiría con dos o tres bloques de cuatro giros válidos a la derecha, sin tocar el carro.
- Con esta explicación, el atasco del primer intento (giro 4, 24.3 grados) también pudo ser por manipular el carro o el cable; no se confirmó cuál.
- LOOP en el piso, resumen de las tres mediciones con la app conectada: carro en el aire 3.251 ms y cero excesos; reposo 8.431 ms y dos excesos; piso 6.783 ms y dos excesos. Siguen siendo pocos datos: el límite de 5 ms NO pasa y la causa se mantiene como el tráfico de la app (sin demostrar).
- Cierre: app cerrada con force-stop, stay_on_while_plugged_in=2. Sin cambios en firmware; la NVS cambió solo por el aprendizaje normal de ANT.

27 oct 2026 — Auditoría J14: base 96aede7 y comprobación de código y commits de A1-A8; A3 requiere fijar altura y el servidor falso quedó atrasado respecto al protocolo. Sin hardware conectado. Registros CTest anteriores guardados en rama local j14-wip-20261027.

27 oct 2026 — A3: altura del resultado de Sensores fijada a cuatro líneas; compilación Android correcta, revisión visual pendiente en el teléfono.

27 oct 2026 — Integración J14: servidor falso adaptado a los campos de giro y consultas ANT; 46 casos sin fallos. No simula aprendizaje ni timeout.

27 oct 2026 — A6: el hilo captura fallos al construir el detector, además de al abrirlo; compilación Android correcta. El respaldo necesita prueba en el teléfono.

27 oct 2026 — A4: los límites distinguen las mediciones del loop, la hipótesis de tráfico y el impacto observado en J13.

27 oct 2026 — A5: se aclara el riesgo de una caja ancha lejana que haya sido aprendida como piso; la prueba física sigue pendiente.

27 oct 2026 — A2: la app consulta y registra las anticipaciones y registra los avisos de aprendizaje ignorado; compilación correcta.

27 oct 2026 — Pruebas sin hardware: núcleo 1577, firmware 447, servidor falso 46 y lector de versiones 7; cero fallos, estrés de 100000 sin STOP perdido. El nombre de red ya aparece en el historial y la búsqueda literal de la clave tiene dos coincidencias incidentales dentro de alfabetos hexadecimales; no se hace push ni se reescribe historial.

27 oct 2026 — A1: la distancia máxima de la secuencia en bloques se señala como estimación, pendiente de medida física.

27 oct 2026 — A1: no se encontró el cálculo previo para los ángulos reales de calibración; el máximo de desplazamiento queda sin verificar hasta una medición o cálculo reproducible.

27 oct 2026 — Etapa 3: guía de conexión y parada preparada para ambas configuraciones; pendiente la confirmación indicada por el dueño antes de cargar o instalar.

27 oct 2026 — Etapa 4 sin movimiento: DevKit conocido COM6, FW y APK de 453ed20 cargados e instalados; verify-flash y verificar_version.py pasan. ANT 126,144,20,20 antes/después; ambos sensores funcionan, autoridad láser apagada. App cerrada, stay-on 2 conservado; teléfono al 7 % cargando por USB. Detalle en progreso_J14.md.

27 oct 2026 — B0 sin movimiento: placa sin USB, teléfono reconectado a red del carro, placa y cámara responden; versiones 453ed20, sensores bien, ANT 126,144,20,20 y autoridad apagada. Teléfono 9 %, cargando por USB. Falta LISTO y reposo antes de B1.

27 oct 2026 — B1: doce giros derechos de 90°, 12/12 dentro de ±3°; sumas de bloques 360.7°, 360.8° y 356.6°. ANT AUTO derecha 144→142 ms; resto sin cambios. Carro quieto; pendiente confirmación visual del frente respecto a la cinta.

27 oct 2026 — Tras B1 el dueño observa el frente casi idéntico a la posición inicial, sin ángulo numérico. B2 pausada antes de empezar: la app instalada no expone cada ángulo antes del siguiente giro, por lo que no permite verificar oportunamente el límite de ±25°; app cerrada y carro quieto.

27 oct 2026 — B2: la protección experimental no pasó tres comprobaciones (un caso de inconsistencia seguía fallando); se restauró el último commit bueno y se guardó el parche fuera del repositorio. No se instaló; B2 sigue sin medir.

27 oct 2026 — B3: 8/8 giros izquierdos y 8/8 derechos dentro de ±3°, usando la calibración previa porque B2 quedó sin medir. Carro quieto al terminar.

27 oct 2026 - J14 B4: cuatro corridas de 150 cm. Autoridad apagada: desvíos de ~15 y ~20 cm; encendida: ~5.5 y ~18 cm. 4/4 rutas terminadas, 0 esquivas y 0 falsos paros. La cámara dejó de responder en el puerto HTTP 80 en dos preparaciones; se recuperó apagando y encendiendo la cámara.

27 oct 2026 - J14 B5: tres corridas válidas en L (dos con giroscopio y una por tiempo), 7 a 8 s, 0 esquivas, giros de ~90 a 93 grados. Posiciones finales estimadas x=1406/1389/1394 mm, y=209/203/244 mm, rumbo 91/90/93 grados. Error lateral estimado de ~20 a 24 cm; el dueño no dio una cifra y dijo «relativamente bien». (Corrección J16: el último tramo de la L está en y = 200 mm, no en y = 0; respecto de esa línea el error ESTIMADO fue de 9, 3 y 44 mm. Los «20 a 24 cm» no son una medición y el error físico de la L sigue NO MEDIDO.)

27 oct 2026 - J14 B6: cuatro corridas con caja a ~100 cm. Autoridad apagada: corrida 1 sin tocar pero con reincorporación sucia; corrida 2 con 3 esquivas, probable toque y «Necesito ayuda» en 3/10. Autoridad encendida: corridas 3 y 4 sin tocar; la 3 terminó con rumbo 119 grados y la 4 unos 40 cm a la derecha de la recta. El intento a 40 cm no arrancó por la protección de aprendizaje del piso. La vuelta a la ruta después de esquivar sigue fallando.

27 oct 2026 - J14 cierre por decisión del dueño: B7 no se repitió porque B6 ya estaba a ~100 cm; B8 y B9 se cancelaron; B2 queda NO MEDIDA. B10: la Autoridad del láser queda siempre encendida por decisión del dueño, no por comparación pareada. Se cambió el valor por defecto de la app a true; el C conserva 0. El texto de Sensores se corrigió para no decir «apagado por defecto».

27 oct 2026 - J14 cambios de producto: ConfigVision usa REF_ANCHO_MIL_APP=600 y GRUPOS_PISO_APP=3; el C conserva 800 y 4. puente.c limpia la configuración con memset. build.gradle.kts añade el arnés de instrumentación por resource-id y comprime las bibliotecas nativas para que el APK quede bajo 15 MB. J10c se corrigió solo en simulación (commit bce7b37).

27 oct 2026 - J14 pruebas finales: núcleo 20 programas / 1577 casos / 0 fallos; firmware 152 + 246 + 15 + 34 = 447 / 0; estrés de 100000 comandos sin STOP perdido; servidor falso 46 / 0; verificador de versiones 10 / 0; hash de página correcto. APK final APP:0.4-699fcc5, 14,500,144 bytes, SHA-256 C50A9757DE59B1B604680BE9731D8C610F9EC4A66780EB18ECEB558E6E00312A; instalada y extraída con el mismo hash. Sensores muestra App 0.4 (699fcc5) y la Autoridad encendida.

27 oct 2026 - J14 entrega: la copia local de dist/ contiene el binario del firmware FW:453ed20-20261027 (1,031,712 bytes, SHA-256 9FD1BB5103D1AD66652ADEA68B009D54D30B5C5B6F07F8CA7488A4FBF274048E), el APK APP:0.4-699fcc5, SHA256SUMS.txt, LEEME.txt y FIRMWARE_LOCAL.txt. El APK de dist/ se versiona con una excepción en .gitignore. El binario del firmware NO se publica porque contiene la contraseña del WiFi como texto; se retiró del commit de entrega antes del push y queda solo en la copia local. SHA256SUMS.txt cubre solo la APK. La verificación final de FW por Sensores quedó pendiente porque el punto de acceso CarroFSI no estaba visible y no había puerto COM; no se inventa ese resultado.

27 oct 2026 - J14 seguridad: firmware_carro/secretos.h y original_backup/ no están versionados ni aparecen en el historial; no hay archivos >15 MB en el árbol ni en los blobs; todos los commits usan identidad noreply. La búsqueda literal de la clave actual encontró dos coincidencias incidentales dentro de un alfabeto hexadecimal de validación; no se publica la contraseña, pero es corta y debe cambiarse antes de la demo. No se reescribió el historial.

27 oct 2026 - J14 publicación: main se publicó en origin/main (c593910) y GitHub Actions «sanitizadores» ejecución 11 terminó en success. El tag v1.0 se crea sobre el commit de cierre documental posterior.

27 oct 2026 - J14 transparencia: dos capturas de la pantalla de rutas incluyeron por error la vista en vivo de la cámara y se borraron inmediatamente; no se guardaron ni publicaron imágenes reales. El teléfono quedó con la app cerrada por force-stop, stay_on=2, pantalla encendida, WiFi habilitado y batería al 82 % cargando por USB. El carro quedó quieto y apagado. No se escribió ningún PIN ni contraseña.

27 oct 2026 — Cierre documental J15 a petición del dueño: etapas 1–4 completas, APK APP:0.4-074c9fd instalada y verificada por bytes; firmware conservado FW:453ed20-20261027, pendiente de lectura actual en Sensores. Corrección de pose por rumbo SENS durante avances, sin cambiar firmware ni el valor por defecto de Autoridad del láser. Simulación B6: media/p50/p95 de 13.2/13.5/21.9 cm a 1.9/1.7/4.6 cm; 400/400 corregidas sin contacto y a menos de 20 cm. La simulación no reproduce exactamente los 40 cm ni las esquivas múltiples de J14. Cero corridas físicas J15; criterio 5/6 NO MEDIDO, el dueño continuará con otro modelo. Se entrega reporte_J15.md y se actualiza documentación, sin nuevas pruebas ni operaciones del teléfono en este cierre. Últimos resultados conservados: núcleo 1598, firmware 447, servidor falso 46, verificador 13, cero fallos; estrés sin STOP perdido; CI del código 074c9fd en success. v1.0 intacta, no se crea v1.1.

31 oct 2026 — J16 (solo software, rama j16-precision, sin carro ni teléfono): revisión de navegación con dos revisiones paralelas (firmware y app/JNI) verificadas en el código. Nuevo RUMBO en el firmware (control PI del rumbo al avanzar con el giroscopio; apagado por defecto; CAPS RUMBO=1) y objetivos de rumbo en el núcleo; arreglos: largo fijo de la «Recta 150 cm» que la app perdía (hacía 160 cm), fin prematuro de esa recta al volver de esquivar, dt de un giro que cae a tiempo entre ticks, filtro giro_largo de la anticipación, holgura de 150 mm al pasar el obstáculo, pose con décimas, rutas predefinidas por celdas. Simulador calibrado con B4/B6 (percentiles 9/57/73/82 y 99). Monte Carlo de 1000 corridas por escenario: rectas de 150 cm de 8.0 a 1.3 cm de media con RUMBO; esquive de 3.7 a 2.1 cm y de 9 toques a 0. Todo SIMULADO; plan físico en docs/precision/plan_pruebas.md. Corrección documental: los «20 a 24 cm» de la L de J14 no eran una medición. APK APP:0.4-d823a63 en dist/ (no instalada); FW:d823a63-20261031 compilado y NO cargado. Reporte: docs/reporte_J16.md.

31 oct 2026 — J16, segunda ronda (solo software, misma rama, sin carro ni teléfono): rumbo con décimas entre comandos cuando RUMBO está activo; aviso WD:<n> del watchdog en el firmware; la app deja de repetir el FORWARD tras TOF_PARO y detiene la ruta con 1.5 s sin SENS, con WD o con un TOF_PARO que el navegador no atendió; RUMBO? al terminar cada ruta para el registro; candado en puente.c para la rejilla y la máscara de visión; aviso de calibración rechazada; arreglo del arnés de la prueba de estrés de 2 hilos (fallaba de vez en cuando, también con el código original). Simulación de 1000 corridas: con RUMBO, recta de 150 cm 13/34/50 a 10/26/35 mm y esquive 21/56/84 a 17/40/63 mm (media/p95/máximo); el resto, idéntico. Suites: núcleo 1633, firmware 515, servidor falso 48, verificador 18, sin fallos. APK APP:0.4-097008d sin instalar; firmware FW:097008d-20261031 compilado sin cargar. Todo NO MEDIDO en el carro.

31 oct 2026 — J16, tercera ronda (solo software): corrección de escala del giroscopio. El firmware multiplica la velocidad medida por IMU_ESCALA (ppm, guardada en su memoria; CAPS la anuncia como IMUS) y la pantalla Sensores la mide con dos vueltas completas alineadas con una línea (cálculo en nucleo_c/calgiro.c). Simulación con un residuo supuesto de ±0.3 %: giro de 180° de 41/88/139 a 35/68/100 mm y cuadrado de 26/59/78 a 21/43/69 mm (media/p95/máximo); rectas y esquives igual. Suites: núcleo 1655, firmware 540, servidor falso 54, verificador 18, sin fallos. APK APP:0.4-873bfb9 sin instalar; firmware FW:873bfb9-20261031 compilado sin cargar. NO MEDIDO en el carro.
