fernandosegrr/fsi_proyect/docs/figuras/v2/percepcion.pdf

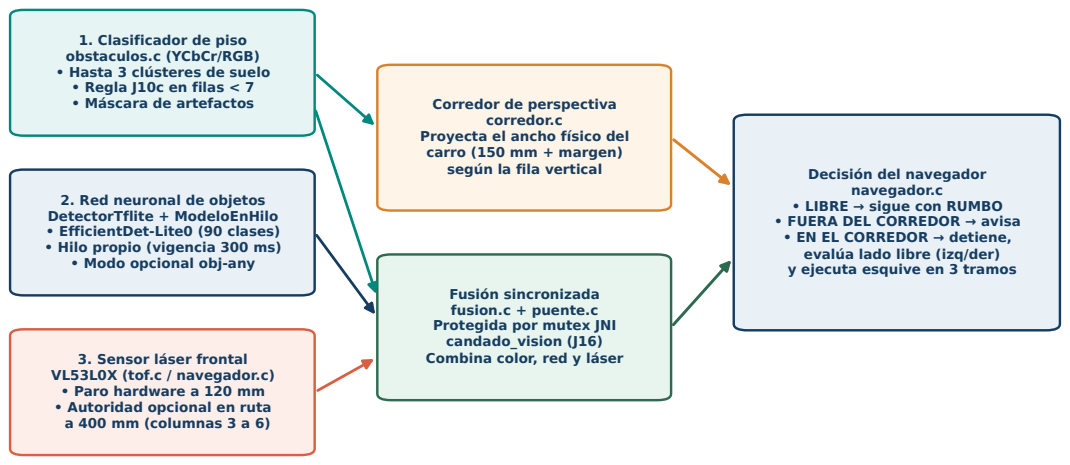
[picture p30: page 1]
corredor.c

1. Clasificador de piso
obstaculos.c (YCbCr/RGB)
• Hasta 3 clústeres de suelo
• Regla J10c en filas < 7
• Máscara de artefactos

Corredor de perspectiva

Proyecta el ancho físico del
carro (150 mm + margen)
según la fila vertical

Decisión del navegador
navegador.c

2. Red neuronal de objetos
DetectorTflite + ModeloEnHilo
• EfficientDet-Lite0 (90 clases)
• Hilo propio (vigencia 300 ms)
• Modo opcional obj-any

• LIBRE → sigue con RUMBO
• FUERA DEL CORREDOR → avisa
• EN EL CORREDOR → detiene,
evalúa lado libre (izq/der)
y ejecuta esquive en 3 tramos

Fusión sincronizada
fusion.c + puente.c
Protegida por mutex JNI
candado_vision (J16)
Combina color, red y láser

3. Sensor láser frontal
VL53L0X (tof.c / navegador.c)
• Paro hardware a 120 mm
• Autoridad opcional en ruta
a 400 mm (columnas 3 a 6)
