fernandosegrr/fsi_proyect/firmware_carro/carro.c

/*
 * carro.c — Lógica del carro en C estándar (sin Arduino, sin String, sin malloc).
 *
 * CÓMO SE CONECTAN LAS FUNCIONES PÚBLICAS
 *   setup()  → carro_iniciar()                (motores a 0, estado "STOP")
 *   mensaje WebSocket → carro_recibir_comando(texto)
 *                         ├─ guarda la hora del comando (salvo PING)
 *                         └─ ejecutar_comando(texto)
 *                              ├─ MODO_MANUAL / MODO_AUTO → cambiar_perfil() (STOP primero si se mueve)
 *                              ├─ FORWARD/REVERSE/LEFT/RIGHT → avanzar(),
 *                              │   retroceder(), girar_...() → poner_motores()
 *                              │   → hw_motor_pwm() por cada pin
 *                              └─ STOP/EBRAKE → carro_detener()
 *   conectar/desconectar cliente → carro_detener()
 *   loop()   → carro_vigilar_comunicacion()   (freno si no llegan comandos)
 *            → carro_actualizar_keepalive()   (pulso para la powerbank)
 *
 * Todo el contacto con el ESP32 pasa por hw_motor_pwm, hw_millis,
 * hw_keepalive y hw_registrar (declaradas en carro.h).
 */

#include <stdio.h>
#include <string.h>
#include "carro.h"
#include "config.h"
#include "sensores.h"
#include "giro.h"
#include "imu.h"
#include "rumbo.h"

/* ── Estado del carro ──────────────────────────────────────────────────── */

static int      motores_en_marcha   = 0;   /* 1 si algún pin de motor tiene PWM > 0 */
static int      ya_se_movio         = 0;   /* 1 si los motores han estado encendidos alguna vez desde el arranque */
static uint32_t motores_apagados_desde_ms = 0;   /* hora en que los motores se apagaron por última vez (para saber cuánto lleva quieto el carro) */
static char     comando_actual[LARGO_MAX_COMANDO] = "STOP";
static uint32_t ultimo_comando_ms   = 0;   /* hora del último comando real (no PING) */
static uint32_t ultimo_keepalive_ms = 0;   /* hora del último pulso keep-alive */
static int      keepalive_alto      = 0;   /* 1 mientras el pulso está en alto */
static int      pleno_modo          = 0;   /* 1 = avanzando y 2 = retrocediendo con el arranque a plena potencia; 0 = no */
static uint32_t pleno_hasta_ms      = 0;   /* hora en que termina el arranque a plena potencia */
static int      perfil_actual       = PERFIL_AUTO;   /* PERFIL_MANUAL o PERFIL_AUTO; siempre arranca en AUTO */
static int      escalon_modo        = 0;   /* arranque escalonado: 1 = avanzando y 2 = retrocediendo con el 2.º motor todavía sin arrancar; 0 = no */
static uint32_t escalon_hasta_ms    = 0;   /* hora en que arranca el 2.º motor */
static volatile int      balance_mil[2]      = { PERFIL_MANUAL_BALANCE_DEFECTO, PERFIL_AUTO_BALANCE_DEFECTO };   /* factor del lado izquierdo de cada perfil, en milésimas (índice = perfil) */
static char              respuesta_balance[LARGO_MAX_COMANDO];   /* el texto de la respuesta a un mensaje de balance */
static char              cola_comandos[COLA_COMANDOS_MAX][LARGO_MAX_COMANDO];
static volatile int      cola_inicio         = 0;
static volatile int      cola_fin            = 0;
static volatile int      cola_cantidad       = 0;
static volatile int      en_vigilancia       = 0;
static volatile int      procesando_cola     = 0;
static volatile int      hay_cliente_activo  = 0;
static volatile uint32_t cliente_activo_id   = 0;
static carro_bloqueo_fn  fn_bloquear         = hw_bloquear;
static carro_bloqueo_fn  fn_desbloquear      = hw_desbloquear;
static int      pwm_actual[4]       = { 0, 0, 0, 0 };   /* lo último escrito en IZQ_A, IZQ_B, DER_A y DER_B */
static Rumbo    rumbo;                                /* J16: sostener el rumbo al avanzar (rumbo.h) */
static uint32_t rumbo_muestra       = 0;              /* la muestra del giroscopio con la que se corrigió por última vez */
static char     respuesta_rumbo[48];                  /* el texto de la respuesta a RUMBO:ON, RUMBO:OFF y RUMBO? */
static volatile int rumbo_apagar_al_conectar = 0;    /* 1 = el siguiente __STOP_AUTO viene de una conexión o desconexión y apaga RUMBO */
static uint32_t frenos_watchdog     = 0;              /* J16: cuántas veces frenó el watchdog desde el encendido (sensores.c lo avisa a la app: WD:<n>) */
static uint32_t n_avances           = 0;              /* SEG=2: avances (FORWARD que energizó los motores) desde el encendido */
static uint32_t n_desconocidos      = 0;              /* SEG=2: textos desconocidos recibidos (no mueven nada ni renuevan el watchdog) */

void carro_poner_bloqueo(carro_bloqueo_fn bloquear, carro_bloqueo_fn desbloquear)
{
    fn_bloquear = (bloquear != NULL) ? bloquear : hw_bloquear;
    fn_desbloquear = (desbloquear != NULL) ? desbloquear : hw_desbloquear;
}

void carro_bloquear(void)
{
    if (fn_bloquear != NULL) {
        fn_bloquear();
    }
}

void carro_desbloquear(void)
{
    if (fn_desbloquear != NULL) {
        fn_desbloquear();
    }
}

/* Lo propio de cada perfil de velocidad (ver config.h). Índice = PERFIL_MANUAL o PERFIL_AUTO. */
typedef struct {
    int      velocidad_der;      /* potencia del lado derecho al avanzar/retroceder después del arranque: es el TOPE del perfil (el izquierdo nunca pasa de aquí) */
    uint32_t arranque_pleno_ms;  /* cuánto dura el arranque a plena potencia */
    const char *nombre;
} PerfilVelocidad;

static const PerfilVelocidad PERFILES[2] = {
    { PERFIL_MANUAL_VELOCIDAD_DER, PERFIL_MANUAL_ARRANQUE_PLENO_MS, "MANUAL" },
    { PERFIL_AUTO_VELOCIDAD_DER,   PERFIL_AUTO_ARRANQUE_PLENO_MS,   "AUTO" }
};

/* Potencia del lado izquierdo del perfil: el tope por el factor de balance (redondeado). Como el factor es de 1000 o menos, nunca pasa del tope. */
static int velocidad_izquierda(int perfil)
{
    return (PERFILES[perfil].velocidad_der * balance_mil[perfil] + 500) / 1000;
}

/* ── Motores ───────────────────────────────────────────────────────────── */

/* Escribe el PWM de los 4 pines y recuerda si algún motor quedó en marcha
 * (el watchdog solo actúa cuando hay motores en marcha). */
static void poner_motores(int izq_a, int izq_b, int der_a, int der_b)
{
    hw_motor_pwm(PIN_MOTOR_IZQ_A, izq_a);
    hw_motor_pwm(PIN_MOTOR_IZQ_B, izq_b);
    hw_motor_pwm(PIN_MOTOR_DER_A, der_a);
    hw_motor_pwm(PIN_MOTOR_DER_B, der_b);
    pwm_actual[0] = izq_a;
    pwm_actual[1] = izq_b;
    pwm_actual[2] = der_a;
    pwm_actual[3] = der_b;
    if (motores_en_marcha && !(izq_a > 0 || izq_b > 0 || der_a > 0 || der_b > 0)) {
        motores_apagados_desde_ms = hw_millis();
    }
    motores_en_marcha = (izq_a > 0 || izq_b > 0 || der_a > 0 || der_b > 0);
    if (motores_en_marcha) {
        ya_se_movio = 1;
    }
}

/* Ambos motores hacia adelante. El izquierdo avanza por su pin B y el
 * derecho por su pin A (cableado probado en hardware; ver config.h). */
static void avanzar(void)
{
    n_avances++;
    if (ARRANQUE_ESCALONADO_MS > 0u) {
        poner_motores(0, VELOCIDAD, 0, 0);       /* escalonado: primero solo el motor izquierdo; el derecho entra después (carro_vigilar_comunicacion) */
        escalon_modo = 1;
        escalon_hasta_ms = hw_millis() + ARRANQUE_ESCALONADO_MS;
    } else {
        poner_motores(0, VELOCIDAD, VELOCIDAD, 0);   /* plena potencia al arrancar; luego el ajuste por lado (carro_vigilar_comunicacion) */
        escalon_modo = 0;
    }
    pleno_modo = 1;
    pleno_hasta_ms = hw_millis() + PERFILES[perfil_actual].arranque_pleno_ms;
    rumbo_terminar(&rumbo);   /* (no debería haber uno en curso: el FORWARD repetido se ignora antes de llegar aquí) */
    if (rumbo.encendido && imu_estado() == IMU_ESTADO_LISTA) {
        rumbo_empezar(&rumbo, imu_angulo_x10(), hw_millis());   /* J16: el objetivo es el rumbo de ahora */
        rumbo_muestra = imu_muestras();
    }
}

/* Ambos motores hacia atrás (los pines contrarios a avanzar). */
static void retroceder(void)
{
    rumbo_terminar(&rumbo);
    if (ARRANQUE_ESCALONADO_MS > 0u) {
        poner_motores(VELOCIDAD, 0, 0, 0);       /* escalonado: primero el motor izquierdo */
        escalon_modo = 2;
        escalon_hasta_ms = hw_millis() + ARRANQUE_ESCALONADO_MS;
    } else {
        poner_motores(VELOCIDAD, 0, 0, VELOCIDAD);
        escalon_modo = 0;
    }
    pleno_modo = 2;
    pleno_hasta_ms = hw_millis() + PERFILES[perfil_actual].arranque_pleno_ms;
}

/* Pivote a la izquierda: solo el motor derecho empuja; el izquierdo queda
 * suelto (PWM 0). */
static void girar_izquierda(void)
{
    rumbo_terminar(&rumbo);
    poner_motores(0, 0, VELOCIDAD_GIRO, 0);
    pleno_modo = 0;
    escalon_modo = 0;
}

/* Pivote a la derecha: solo el motor izquierdo empuja; el derecho queda
 * suelto (PWM 0). */
static void girar_derecha(void)
{
    rumbo_terminar(&rumbo);
    poner_motores(0, VELOCIDAD_GIRO, 0, 0);
    pleno_modo = 0;
    escalon_modo = 0;
}

/* Pivote pedido por el giro por ángulo (giro.c): +1 a la izquierda, -1 a la derecha, 0 apaga todo. Parar NO avisa al giro (él mismo es quien para). */
static void guardar_comando_actual(const char *texto);

void carro_pivote(int sentido)
{
    if (sentido > 0) {
        girar_izquierda();
    } else if (sentido < 0) {
        girar_derecha();
    } else {
        rumbo_terminar(&rumbo);
        poner_motores(0, 0, 0, 0);
        pleno_modo = 0;
        escalon_modo = 0;
        guardar_comando_actual("STOP");
        return;
    }
    guardar_comando_actual("GIRAR");
}

/* 1 si el carro va AVANZANDO (comando FORWARD con los motores en marcha). */
int carro_avanzando(void)
{
    return motores_en_marcha && strcmp(comando_actual, "FORWARD") == 0;
}

int carro_motores_en_marcha(void)
{
    return motores_en_marcha;
}

uint32_t carro_frenos_watchdog(void)
{
    return frenos_watchdog;
}

uint32_t carro_avances(void)
{
    return n_avances;
}

uint32_t carro_desconocidos(void)
{
    return n_desconocidos;
}

static int leer_mensaje_balance(const char *texto, int *perfil, int *valor, int *valido);

/* SEG=2: ¿este texto es una orden que el carro entiende y que debe mantenerlo en marcha? Los movimientos, STOP/EBRAKE, los cambios de perfil, los mensajes de balance
 * (como hasta ahora) y GIRAR. Un texto DESCONOCIDO (un comando de una app más nueva, basura, una cadena vacía) no: antes renovaba el reloj del watchdog y además
 * quedaba como «comando actual», con lo que el carro seguía avanzando sin latido, el freno láser dejaba de verlo «avanzando» y el control de rumbo se soltaba. */
static int renueva_watchdog(const char *texto)
{
    int perfil_balance, valor_balance, balance_valido;

    if (strcmp(texto, "FORWARD") == 0 || strcmp(texto, "REVERSE") == 0 || strcmp(texto, "LEFT") == 0 || strcmp(texto, "RIGHT") == 0 ||
        strcmp(texto, "STOP") == 0 || strcmp(texto, "EBRAKE") == 0 || strcmp(texto, "MODO_MANUAL") == 0 || strcmp(texto, "MODO_AUTO") == 0 ||
        strcmp(texto, "BAL?") == 0 || strncmp(texto, "GIRAR:", 6) == 0) {
        return 1;
    }
    return leer_mensaje_balance(texto, &perfil_balance, &valor_balance, &balance_valido);
}

/* Cuántos ms lleva el carro con los motores apagados (0 si se mueve; un número enorme si no se ha movido desde el arranque). */
uint32_t carro_quieto_ms(void)
{
    if (motores_en_marcha) {
        return 0u;
    }
    if (!ya_se_movio) {
        return 0x7FFFFFFFu;
    }
    return (uint32_t)(hw_millis() - motores_apagados_desde_ms);
}

/* ── Comandos ──────────────────────────────────────────────────────────── */

/* Copia el comando al buffer de estado, truncándolo si es muy largo, y
 * siempre terminándolo con '\0'. */
static void guardar_comando_actual(const char *texto)
{
    strncpy(comando_actual, texto, LARGO_MAX_COMANDO - 1);
    comando_actual[LARGO_MAX_COMANDO - 1] = '\0';
}

/* Un comando repetido (el mismo que ya está activo) se ignora, para que el
 * heartbeat de 250 ms de la página no reinicie nada. STOP y EBRAKE son la
 * excepción: SIEMPRE se ejecutan, aunque se repitan. */
static int es_comando_repetido(const char *texto)
{
    if (strcmp(texto, "STOP") == 0 || strcmp(texto, "EBRAKE") == 0) {
        return 0;
    }
    return strcmp(texto, comando_actual) == 0;
}

/* Cambia el perfil de velocidad. Si ya es ese, no hace nada (la app lo repite de vez en cuando y no debe frenar al carro). Si el
 * carro se está moviendo, PRIMERO se detiene: nunca se cambia de velocidad en movimiento. */
static void cambiar_perfil(int nuevo)
{
    if (nuevo == perfil_actual) {
        return;
    }
    if (motores_en_marcha) {
        carro_detener();
    }
    perfil_actual = nuevo;
    hw_registrar(nuevo == PERFIL_MANUAL ? "Perfil: MANUAL (velocidad maxima)" : "Perfil: AUTO (velocidad limitada)");
}

/* ── Mensajes de balance ───────────────────────────────────────────────── */

/* Si el texto es "BAL_AUTO:..." o "BAL_MANUAL:..." devuelve 1 y deja en *perfil el perfil y en *valor el número; *valido dice si el número sirve (solo cifras, 3 o 4, entre
 * BALANCE_MIN_MIL y BALANCE_MAX_MIL). Cualquier otro texto devuelve 0. */
static int leer_mensaje_balance(const char *texto, int *perfil, int *valor, int *valido)
{
    const char *numero;
    int cifras = 0, acumulado = 0;

    if (strncmp(texto, "BAL_AUTO:", 9) == 0) {
        *perfil = PERFIL_AUTO;
        numero = texto + 9;
    } else if (strncmp(texto, "BAL_MANUAL:", 11) == 0) {
        *perfil = PERFIL_MANUAL;
        numero = texto + 11;
    } else {
        return 0;
    }
    while (numero[cifras] >= '0' && numero[cifras] <= '9' && cifras < 6) {
        acumulado = acumulado * 10 + (numero[cifras] - '0');
        cifras++;
    }
    *valor = acumulado;
    *valido = (numero[cifras] == '\0') && numero[0] != '0' && (cifras == 3 || cifras == 4) && acumulado >= BALANCE_MIN_MIL && acumulado <= BALANCE_MAX_MIL;
    return 1;
}

int carro_balance(int perfil)
{
    return (perfil == PERFIL_MANUAL || perfil == PERFIL_AUTO) ? balance_mil[perfil] : 0;
}

/* ── Rumbo al avanzar (J16, rumbo.h) ───────────────────────────────────── */

/* 1 si el texto es RUMBO:... o RUMBO? (válido o no: un RUMBO mal escrito tampoco es un movimiento). */
static int es_mensaje_rumbo(const char *texto)
{
    return strncmp(texto, "RUMBO:", 6) == 0 || strcmp(texto, "RUMBO?") == 0;
}

/* Las potencias de avanzar sin corrección en este momento: plena potencia durante el arranque; después, el tope del perfil y su balance. */
static void potencias_de_avance(int *izq, int *der)
{
    *izq = (pleno_modo != 0) ? VELOCIDAD : velocidad_izquierda(perfil_actual);
    *der = (pleno_modo != 0) ? VELOCIDAD : PERFILES[perfil_actual].velocidad_der;
}

static void atender_rumbo(const char *texto)
{
    int32_t objetivo;

    if (strcmp(texto, "RUMBO:ON") == 0) {
        rumbo.encendido = 1;   /* vale desde el siguiente FORWARD */
    } else if (strcmp(texto, "RUMBO:OFF") == 0) {
        int estaba = rumbo.en_marcha;

        rumbo_terminar(&rumbo);
        rumbo.encendido = 0;
        if (estaba && motores_en_marcha && strcmp(comando_actual, "FORWARD") == 0 && escalon_modo == 0) {
            int izq, der;

            potencias_de_avance(&izq, &der);
            poner_motores(0, izq, der, 0);   /* vuelve a las potencias fijas de siempre */
        }
    } else if (strncmp(texto, "RUMBO:", 6) == 0 && rumbo_leer_numero(texto + 6, &objetivo)) {
        rumbo_poner_objetivo(&rumbo, objetivo);   /* sin avance en curso no hace nada */
    }
}

/* Cada muestra nueva del giroscopio, mientras avanza con RUMBO: reparte la corrección entre los lados. Con el giroscopio caído vuelve a las potencias fijas. */
static void corregir_rumbo(uint32_t ahora)
{
    int base_izq, base_der, izq, der;

    if (!rumbo.en_marcha || !motores_en_marcha || escalon_modo != 0 || strcmp(comando_actual, "FORWARD") != 0) {
        return;
    }
    potencias_de_avance(&base_izq, &base_der);
    izq = base_izq;
    der = base_der;
    if (imu_estado() == IMU_ESTADO_LISTA) {
        if (imu_muestras() != rumbo_muestra) {   /* la corrección se calcula una vez por muestra (100 Hz); se reparte en cada vuelta porque la base cambia al terminar el arranque */
            rumbo_muestra = imu_muestras();
            rumbo_corregir(&rumbo, imu_angulo_x10(), ahora);
        }
        rumbo_repartir(rumbo.corr_mil, base_izq, base_der, VELOCIDAD, &izq, &der);
    }
    if (pwm_actual[0] != 0 || pwm_actual[1] != izq || pwm_actual[2] != der || pwm_actual[3] != 0) {
        poner_motores(0, izq, der, 0);
    }
}

/* Interpreta el texto y actúa. No toca el reloj del watchdog (eso lo hace
 * carro_recibir_comando). */
static void ejecutar_comando(const char *texto)
{
    int perfil_balance, valor_balance, balance_valido;

    if (strcmp(texto, "__STOP_AUTO") == 0) {
        carro_detener();
        carro_poner_perfil_auto();
        if (rumbo_apagar_al_conectar) {   /* J16: solo el de una conexión o desconexión; el del láser (TOF_PARO) no apaga RUMBO */
            rumbo_apagar_al_conectar = 0;
            rumbo.encendido = 0;
        }
        return;
    }
    /* Los cambios de perfil no son un movimiento: no se guardan como comando actual (así un FORWARD que ya estaba activo no se ignora). */
    if (strcmp(texto, "MODO_MANUAL") == 0) {
        cambiar_perfil(PERFIL_MANUAL);
        return;
    }
    if (strcmp(texto, "MODO_AUTO") == 0) {
        cambiar_perfil(PERFIL_AUTO);
        return;
    }
    /* Los mensajes de balance tampoco son un movimiento: se aplican al siguiente arranque y no se guardan como comando actual. */
    if (leer_mensaje_balance(texto, &perfil_balance, &valor_balance, &balance_valido)) {
        if (balance_valido) {
            balance_mil[perfil_balance] = valor_balance;
            hw_balance_guardar(perfil_balance, valor_balance);
            hw_registrar(perfil_balance == PERFIL_AUTO ? "Balance AUTO cambiado" : "Balance MANUAL cambiado");
        }
        return;
    }
    if (strcmp(texto, "BAL?") == 0) {
        return;
    }
    /* J16: RUMBO:ON / RUMBO:OFF / RUMBO:<n> / RUMBO? (rumbo.h). Tampoco son un movimiento. */
    if (es_mensaje_rumbo(texto)) {
        atender_rumbo(texto);
        return;
    }
    /* Los mensajes de sensores (CAPS?, IMU?, TOF?, GIRAR:, IMU_CAL...) los entiende sensores.c; los de consulta no son movimiento. */
    if (sensores_es_comando(texto)) {
        sensores_comando(texto);
        return;
    }
    if (es_comando_repetido(texto)) {
        return;
    }
    /* Cualquier otro movimiento corta un giro por ángulo que esté en curso. */
    if (strcmp(texto, "FORWARD") == 0 || strcmp(texto, "REVERSE") == 0 || strcmp(texto, "LEFT") == 0 || strcmp(texto, "RIGHT") == 0) {
        giro_abortar();
    }

    if (strcmp(texto, "FORWARD") == 0) {
        if (sensores_frente_bloqueado() > 0) {
            /* SEG=2: el láser tiene algo confirmado a menos de TOF_BLOQUEO_MM: el avance no arranca (ya se avisó TOF_PARO). Tampoco queda como comando actual,
             * así el siguiente FORWARD se vuelve a evaluar. Los motores quedan como estaban (parados, o girando si venía de un pivote que giro_abortar ya cortó). */
            if (motores_en_marcha) {
                carro_detener();
            }
            return;
        }
        avanzar();
    } else if (strcmp(texto, "REVERSE") == 0) {
        retroceder();
    } else if (strcmp(texto, "LEFT") == 0) {
        girar_izquierda();
    } else if (strcmp(texto, "RIGHT") == 0) {
        girar_derecha();
    } else if (strcmp(texto, "STOP") == 0 || strcmp(texto, "EBRAKE") == 0) {
        carro_detener();   /* STOP y EBRAKE hacen lo mismo */
        return;
    } else if (strcmp(texto, "PING") == 0) {
        return;            /* solo mantiene viva la conexión; no cambia nada */
    } else {
        /* SEG=2: un texto desconocido no mueve los motores, NO se guarda como comando actual y NO renovó el watchdog (carro_recibir_comando). Antes sí: un cliente
         * que probara un comando nuevo contra este firmware dejaba el carro avanzando sin latido y sin freno láser. Se cuenta para el diagnóstico. */
        if (n_desconocidos < 0xFFFFFFFFu) {
            n_desconocidos++;
        }
        return;
    }
    guardar_comando_actual(texto);
}

/* ── Funciones públicas ────────────────────────────────────────────────── */

/* Estado de arranque: motores parados, comando "STOP", relojes en cero. */
void carro_iniciar(void)
{
    poner_motores(0, 0, 0, 0);
    pleno_modo = 0;
    perfil_actual = PERFIL_AUTO;   /* al arrancar siempre AUTO: la app pide MODO_MANUAL cuando lo necesita */
    escalon_modo = 0;
    giro_reiniciar();
    cola_inicio = 0;
    cola_fin = 0;
    cola_cantidad = 0;
    en_vigilancia = 0;
    procesando_cola = 0;
    hay_cliente_activo = 0;
    cliente_activo_id = 0;
    rumbo_iniciar(&rumbo);         /* J16: apagado hasta que la app mande RUMBO:ON */
    rumbo_apagar_al_conectar = 0;
    rumbo_muestra = 0;
    frenos_watchdog = 0;
    n_avances = 0;
    n_desconocidos = 0;
    balance_mil[PERFIL_MANUAL] = PERFIL_MANUAL_BALANCE_DEFECTO;   /* el balance guardado en la memoria no volátil, si es válido; si no, el de siempre */
    balance_mil[PERFIL_AUTO] = PERFIL_AUTO_BALANCE_DEFECTO;
    for (int p = 0; p < 2; p++) {
        int guardado = hw_balance_leer(p);

        if (guardado >= BALANCE_MIN_MIL && guardado <= BALANCE_MAX_MIL) {
            balance_mil[p] = guardado;
        }
    }
    guardar_comando_actual("STOP");
    ultimo_comando_ms   = 0;
    ultimo_keepalive_ms = 0;
    keepalive_alto      = 0;
}

static int es_stop_prioritario(const char *texto)
{
    return strcmp(texto, "STOP") == 0 || strcmp(texto, "EBRAKE") == 0 || strcmp(texto, "__STOP_AUTO") == 0;
}

static void descartar_ranura_cola(int desplazamiento)
{
    int i;

    for (i = desplazamiento; i < cola_cantidad - 1; i++) {
        int dst = (cola_inicio + i) % COLA_COMANDOS_MAX;
        int src = (cola_inicio + i + 1) % COLA_COMANDOS_MAX;

        memcpy(cola_comandos[dst], cola_comandos[src], LARGO_MAX_COMANDO);
    }
    cola_fin = (cola_fin + COLA_COMANDOS_MAX - 1) % COLA_COMANDOS_MAX;
    cola_cantidad--;
}

void carro_encolar_comando(const char *texto)
{
    int perfil_balance, valor_balance, balance_valido;

    if (texto == NULL) {
        return;
    }
    if (leer_mensaje_balance(texto, &perfil_balance, &valor_balance, &balance_valido) && balance_valido) {
        balance_mil[perfil_balance] = valor_balance;
    }
    if (cola_cantidad >= COLA_COMANDOS_MAX) {
        int i, victima = -1;

        /* Si la cola está llena, PING no desplaza ningún comando real. */
        if (strcmp(texto, "PING") == 0) {
            return;
        }
        /* Primero se descarta un PING viejo; si no hay, el comando más viejo que NO sea STOP, para no perder nunca un STOP. */
        for (i = 0; i < cola_cantidad; i++) {
            int idx = (cola_inicio + i) % COLA_COMANDOS_MAX;

            if (strcmp(cola_comandos[idx], "PING") == 0) {
                victima = i;
                break;
            }
        }
        if (victima < 0) {
            for (i = 0; i < cola_cantidad; i++) {
                int idx = (cola_inicio + i) % COLA_COMANDOS_MAX;

                if (!es_stop_prioritario(cola_comandos[idx])) {
                    victima = i;
                    break;
                }
            }
        }
        if (victima < 0) {
            victima = 0;
        }
        descartar_ranura_cola(victima);
    }
    strncpy(cola_comandos[cola_fin], texto, LARGO_MAX_COMANDO - 1);
    cola_comandos[cola_fin][LARGO_MAX_COMANDO - 1] = '\0';
    cola_fin = (cola_fin + 1) % COLA_COMANDOS_MAX;
    cola_cantidad++;
}

int carro_extraer_comando_cola(char *destino)
{
    if (cola_cantidad <= 0 || destino == NULL) {
        return 0;
    }
    strncpy(destino, cola_comandos[cola_inicio], LARGO_MAX_COMANDO - 1);
    destino[LARGO_MAX_COMANDO - 1] = '\0';
    cola_inicio = (cola_inicio + 1) % COLA_COMANDOS_MAX;
    cola_cantidad--;
    return 1;
}

int carro_cola_cantidad(void)
{
    return cola_cantidad;
}

/* Único punto de extracción de la cola: loop() vacía la cola bajo el bloqueo
 * antes de llamar a carro_vigilar_comunicacion(). */
void carro_procesar_cola(void)
{
    char cmd[LARGO_MAX_COMANDO];

    if (procesando_cola || en_vigilancia) {
        return;
    }
    procesando_cola = 1;
    for (;;) {
        int hay;

        carro_bloquear();
        hay = carro_extraer_comando_cola(cmd);
        carro_desbloquear();
        if (!hay) {
            break;
        }
        carro_recibir_comando(cmd);
    }
    procesando_cola = 0;
}

void carro_conectar_cliente(uint32_t id)
{
    hay_cliente_activo = 1;
    cliente_activo_id = id;
    cola_inicio = 0;
    cola_fin = 0;
    cola_cantidad = 0;
    rumbo_apagar_al_conectar = 1;   /* J16: el __STOP_AUTO de esta conexión apaga RUMBO: cada cliente lo pide con RUMBO:ON si lo sabe usar */
    carro_encolar_comando("__STOP_AUTO");
}

int carro_desconectar_cliente(uint32_t id)
{
    if (!hay_cliente_activo || id != cliente_activo_id) {
        return 0;
    }
    hay_cliente_activo = 0;
    cliente_activo_id = 0;
    cola_inicio = 0;
    cola_fin = 0;
    cola_cantidad = 0;
    rumbo_apagar_al_conectar = 1;
    carro_encolar_comando("__STOP_AUTO");
    return 1;
}

uint32_t carro_cliente_activo(void)
{
    return hay_cliente_activo ? cliente_activo_id : 0u;
}

/* Cada mensaje recibido pasa por aquí. PING NO renueva el reloj: si lo
 * hiciera, el carro seguiría moviéndose con el botón suelto, porque la
 * página envía PING cada 800 ms (más rápido que el watchdog de 1000 ms). */
void carro_recibir_comando(const char *texto)
{
    if (texto == NULL) {
        return;
    }
    if (en_vigilancia) {
        carro_bloquear();
        carro_encolar_comando(texto);
        carro_desbloquear();
        return;
    }
    /* Las consultas de sensores (CAPS?, IMU?...) no cuentan como orden de movimiento: no renuevan el watchdog. GIRAR sí. SEG=2: un texto desconocido tampoco. */
    if (strcmp(texto, "PING") != 0 && strcmp(texto, "__STOP_AUTO") != 0 && !es_mensaje_rumbo(texto) &&
        (!sensores_es_comando(texto) || strncmp(texto, "GIRAR:", 6) == 0) && renueva_watchdog(texto)) {
        ultimo_comando_ms = hw_millis();
    }
    ejecutar_comando(texto);
}

const char *carro_respuesta(const char *texto)
{
    if (texto == NULL) {
        return NULL;
    }
    if (strcmp(texto, "PING") == 0) {
        return "PONG";
    }
    if (strcmp(texto, "MODO_MANUAL") == 0) {
        return "ACK_MANUAL";
    }
    if (strcmp(texto, "MODO_AUTO") == 0) {
        return "ACK_AUTO";
    }
    {
        int perfil, valor, valido;

        if (leer_mensaje_balance(texto, &perfil, &valor, &valido)) {
            if (!valido) {
                return "NAK_BAL";
            }
            snprintf(respuesta_balance, sizeof respuesta_balance, "ACK_BAL_%s:%d", PERFILES[perfil].nombre, valor);
            return respuesta_balance;
        }
    }
    if (strcmp(texto, "BAL?") == 0) {
        snprintf(respuesta_balance, sizeof respuesta_balance, "BAL:%d:%d", balance_mil[PERFIL_AUTO], balance_mil[PERFIL_MANUAL]);
        return respuesta_balance;
    }
    /* J16: la respuesta dice el estado que quedará al ejecutarse el mensaje (se encola antes de contestar). RUMBO:<n> no se contesta. */
    if (strcmp(texto, "RUMBO:ON") == 0) {
        return "ACK_RUMBO:1";
    }
    if (strcmp(texto, "RUMBO:OFF") == 0) {
        return "ACK_RUMBO:0";
    }
    if (strcmp(texto, "RUMBO?") == 0) {
        snprintf(respuesta_rumbo, sizeof respuesta_rumbo, "RUMBO:%d,%d,%ld,%d,%ld", rumbo.encendido, rumbo.en_marcha, (long)rumbo.objetivo_x10,
                 rumbo.corr_mil, (long)rumbo.aprendido_mil);
        return respuesta_rumbo;
    }
    return NULL;
}

int carro_perfil(void)
{
    return perfil_actual;
}

void carro_poner_perfil_auto(void)
{
    perfil_actual = PERFIL_AUTO;   /* sin detener: quien lo llama ya detiene (conexión, desconexión) */
}

/* Freno inmediato (el antiguo hardStop). Lo usan STOP, EBRAKE, el watchdog
 * y los eventos de conexión/desconexión del WebSocket. */
void carro_detener(void)
{
    if (en_vigilancia) {
        carro_bloquear();
        carro_encolar_comando("STOP");
        carro_desbloquear();
        return;
    }
    giro_abortar();   /* un giro por ángulo en curso se corta (informa GIRO_ERROR:abortado cuando se asiente) */
    rumbo_terminar(&rumbo);
    poner_motores(0, 0, 0, 0);
    pleno_modo = 0;
    escalon_modo = 0;
    guardar_comando_actual("STOP");
}

/* Watchdog de software. La resta sin signo en uint32_t funciona bien aunque
 * el reloj dé la vuelta (desbordamiento). No extrae nada de la cola: eso lo
 * hace únicamente carro_procesar_cola() en loop() bajo el mutex. */
void carro_vigilar_comunicacion(void)
{
    uint32_t ahora;

    en_vigilancia = 1;
    ahora = hw_millis();

    /* Arranque escalonado: ya pasó el tiempo del primer motor, entra el segundo (a plena potencia si todavía dura el arranque a plena potencia; si no, con el ajuste por lado). */
    if (escalon_modo != 0 && (int32_t)(ahora - escalon_hasta_ms) >= 0) {
        int izq = (pleno_modo != 0) ? VELOCIDAD : velocidad_izquierda(perfil_actual);
        int der = (pleno_modo != 0) ? VELOCIDAD : PERFILES[perfil_actual].velocidad_der;

        if (escalon_modo == 1) {
            poner_motores(0, izq, der, 0);
        } else {
            poner_motores(izq, 0, 0, der);
        }
        escalon_modo = 0;
    }

    /* Terminó el arranque a plena potencia: se aplica el ajuste por lado (el tope del perfil a la derecha y el tope por el balance a la izquierda). */
    if (pleno_modo != 0 && (int32_t)(ahora - pleno_hasta_ms) >= 0) {
        if (pleno_modo == 1 && rumbo.en_marcha && escalon_modo == 0) {
            pleno_modo = 0;   /* J16: las potencias de después del arranque (con la corrección) las pone corregir_rumbo, abajo */
        } else if (pleno_modo == 1) {
            poner_motores(0, velocidad_izquierda(perfil_actual), PERFILES[perfil_actual].velocidad_der, 0);
        } else {
            poner_motores(velocidad_izquierda(perfil_actual), 0, 0, PERFILES[perfil_actual].velocidad_der);
        }
        pleno_modo = 0;
    }

    corregir_rumbo(ahora);   /* J16: solo con RUMBO encendido y avanzando; si no, no hace nada */

    /* Mientras corre un giro por ángulo el watchdog de 1 s no actúa (un giro largo dura más); el giro tiene su propio tiempo máximo. */
    if (motores_en_marcha && !giro_activo() && (uint32_t)(ahora - ultimo_comando_ms) > TIEMPO_WATCHDOG_MS) {
        rumbo_terminar(&rumbo);
        poner_motores(0, 0, 0, 0);
        pleno_modo = 0;
        escalon_modo = 0;
        guardar_comando_actual("STOP");
        perfil_actual = PERFIL_AUTO;   /* tras perder la señal vuelve al perfil seguro; la app lo repone con MODO_MANUAL */
        frenos_watchdog++;
        hw_registrar("Watchdog: Freno activado.");
    }
    en_vigilancia = 0;
}

/* Keep-alive: sube el pin cada KEEPALIVE_PERIODO_MS y lo baja tras
 * KEEPALIVE_PULSO_MS. Se usa una variable (keepalive_alto) en lugar de leer
 * el pin con digitalRead, que en C no tenemos. */
void carro_actualizar_keepalive(void)
{
    uint32_t ahora = hw_millis();

    if ((uint32_t)(ahora - ultimo_keepalive_ms) >= KEEPALIVE_PERIODO_MS) {
        hw_keepalive(1);
        keepalive_alto = 1;
        ultimo_keepalive_ms = ahora;
    } else if (keepalive_alto && (uint32_t)(ahora - ultimo_keepalive_ms) >= KEEPALIVE_PULSO_MS) {
        hw_keepalive(0);
        keepalive_alto = 0;
    }
}
