fernandosegrr/fsi_proyect/nucleo_c/navegador.c

/*
 * navegador.c — Máquina de estados del modo semiautónomo (ver navegador.h y docs/navegador.md).
 *
 * GUÍA DE LECTURA
 *  1. Lo que se ve primero son las ayudas de posición: el carro no tiene sensores de
 *     posición, así que se calcula por TIEMPO (calcular_pose): cuánto tiempo estuvo
 *     avanzando o girando, convertido con la calibración del carro (calibracion.c: arranque,
 *     ms por cm, frenado y ms por grado de cada lado).
 *  2. planificar() usa trayectoria.c para sacar los pasos (AVANZAR/GIRAR con su tiempo) desde
 *     la posición y el rumbo actuales hasta el siguiente punto de la ruta.
 *  3. EL TEMPORIZADOR DE TRAMOS está en contar_tiempo_ejecutado() y en tick_siguiendo() /
 *     tick_esquivando(): un paso termina cuando su tiempo ya se ejecutó. Todo lo que dependa
 *     de "cuánto dura cada tramo" está aquí; si algún día el firmware acepta comandos con
 *     duración (por ejemplo MOVE:FWD:2000), solo hay que cambiar esa parte.
 *  4. navegador_tick() es la función que se llama cada ~50 ms: actualiza la posición, mira el
 *     último cuadro de obstáculos y llama a la función del estado actual.
 *  4b. GIRO CON LA CÁMARA: si la app avisa lo que la cámara vio girar (navegador_aporte_visual), un giro se corta cuando la cámara
 *     ve el ángulo pedido (giro_terminado), con el tiempo planeado como respaldo; si la cámara no tiene confianza, el giro sigue
 *     por tiempo y la posición estimada también.
 *  5. Estados: tick_siguiendo, tick_detenido, tick_esquivando y tick_reincorporando (los
 *     demás estados siempre devuelven STOP).
 *  Solo enteros, arreglos de tamaño fijo, sin malloc y sin recursión.
 */

#include <stddef.h>
#include <stdio.h>
#include <stdarg.h>
#include <string.h>
#include "navegador.h"
#include "calibracion.h"
#include "mascara_vision.h"

#define MM_POR_CELDA   (CELDA_CM * 10)
#define LIMITE_CONTADOR 1000
#define NAV_ESCANEO_SALTO_MM    250    /* V2: entre dos lecturas seguidas del barrido (unos 13 grados) la cara de un mismo objeto no se aleja de lado más que esto */
#define TOF_ALCANCE_ESCANEO_MM 1100   /* V2: lecturas más lejanas que esto no se usan para medir el rodeo (cerca del alcance el dato es poco fiable) */
#define NAV_VENTANA_TRAMOS 12   /* ubicar_en_linea mira desde un tramo antes del actual hasta este número de tramos adelante (el carro pasa el obstáculo y queda más adelante) */   /* los contadores de cuadros no crecen más que esto */

/* Seno de 0 a 90 grados, de grado en grado, en milésimas (1000 = 1.0). Con él se mueve la posición estimada en CUALQUIER rumbo (no solo en múltiplos de 45):
 * así un avance en diagonal suave (por ejemplo al volver a la línea) cambia la x y la y como debe. Los valores de 45 grados (707) son los de siempre. */
static const int SENO_MIL[91] = {
       0,   17,   35,   52,   70,   87,  105,  122,  139,  156,  174,  191,  208,  225,  242,
     259,  276,  292,  309,  326,  342,  358,  375,  391,  407,  423,  438,  454,  469,  485,
     500,  515,  530,  545,  559,  574,  588,  602,  616,  629,  643,  656,  669,  682,  695,
     707,  719,  731,  743,  755,  766,  777,  788,  799,  809,  819,  829,  839,  848,  857,
     866,  875,  883,  891,  899,  906,  914,  921,  927,  934,  940,  946,  951,  956,  961,
     966,  970,  974,  978,  982,  985,  988,  990,  993,  995,  996,  998,  999,  999, 1000,
    1000
};

/* Seno de cualquier ángulo entero en grados (milésimas). */
static int seno_mil(int grados)
{
    int g = ((grados % 360) + 360) % 360;

    if (g <= 90) {
        return SENO_MIL[g];
    }
    if (g <= 180) {
        return SENO_MIL[180 - g];
    }
    if (g <= 270) {
        return -SENO_MIL[g - 180];
    }
    return -SENO_MIL[360 - g];
}

/* Componentes (en milésimas) del vector unitario que apunta hacia el rumbo: 0 = arriba (y decrece), 90 = derecha (x crece). */
static int dir_x_mil(int rumbo_grados)
{
    return seno_mil(rumbo_grados);
}

static int dir_y_mil(int rumbo_grados)
{
    return -seno_mil(rumbo_grados + 90);
}

/* J16: seno de un ángulo en DÉCIMAS de grado, interpolando la tabla entre dos grados enteros. Con grados enteros un rumbo medido de 0.4° no movía la x
 * (y uno de 0.6° la movía como 1°): en 150 cm son hasta ~1 cm de error lateral que la pose no veía. */
static int seno_mil_x10(int x10)
{
    int g = ((x10 % 3600) + 3600) % 3600;
    int s0 = seno_mil(g / 10), s1 = seno_mil(g / 10 + 1);

    return s0 + (s1 - s0) * (g % 10) / 10;
}

static int dir_x_mil_x10(int rumbo_x10)
{
    return seno_mil_x10(rumbo_x10);
}

static int dir_y_mil_x10(int rumbo_x10)
{
    return -seno_mil_x10(rumbo_x10 + 900);
}

/* ── Ayudas numéricas ──────────────────────────────────────────────────── */

/* División entera redondeada hacia abajo (también con numeradores negativos); b > 0. */
static int division_piso(int a, int b)
{
    int q = a / b;

    if ((a % b != 0) && (a < 0)) {
        q--;
    }
    return q;
}

static int normalizar_grados(int grados)
{
    return ((grados % 360) + 360) % 360;
}

/* Índice de dirección (0 a 7) más cercano a un rumbo en grados. */
static int indice_direccion(int rumbo_grados)
{
    return ((normalizar_grados(rumbo_grados) + 22) / 45) % 8;
}

static int signo(int x)
{
    return (x > 0) - (x < 0);
}

static long valor_absoluto_largo(long x)
{
    return (x < 0) ? -x : x;
}

/* Celda más cercana a una coordenada en milímetros. */
static int celda_mas_cercana(int mm)
{
    return division_piso(mm + MM_POR_CELDA / 2, MM_POR_CELDA);
}

static void limitar_contador(int *contador)
{
    if (*contador > LIMITE_CONTADOR) {
        *contador = LIMITE_CONTADOR;
    }
}


/* ── Geometría con enteros (sin math.h) ────────────────────────────────── */

/* Tangente de 0 a 45 grados, de grado en grado, por 1000. Sirve para sacar el ángulo de un vector sin usar atan. */
static const int TANGENTE_MIL[46] = {
       0,   17,   35,   52,   70,   87,  105,  123,  141,  158,  176,  194,  213,  231,  249,  268,
     287,  306,  325,  344,  364,  384,  404,  424,  445,  466,  488,  510,  532,  554,  577,  601,
     625,  649,  675,  700,  727,  754,  781,  810,  839,  869,  900,  933,  966, 1000
};

/* Raíz cuadrada entera (redondeada hacia abajo). */
static long raiz_entera(long valor)
{
    long x = 0, paso = 1L << 30;

    if (valor <= 0) {
        return 0;
    }
    while (paso > valor) {
        paso >>= 2;
    }
    while (paso != 0) {
        if (valor >= x + paso) {
            valor -= x + paso;
            x = (x >> 1) + paso;
        } else {
            x >>= 1;
        }
        paso >>= 2;
    }
    return x;
}

/* Ángulo (0 a 45 grados) cuya tangente es numerador/denominador, con numerador <= denominador. */
static int grados_de_cociente(long numerador, long denominador)
{
    long mil;
    int k, mejor = 0;

    if (denominador <= 0 || numerador <= 0) {
        return 0;
    }
    mil = numerador * 1000 / denominador;
    for (k = 1; k <= 45; k++) {
        if (valor_absoluto_largo(mil - TANGENTE_MIL[k]) < valor_absoluto_largo(mil - TANGENTE_MIL[mejor])) {
            mejor = k;
        }
    }
    return mejor;
}

/* Rumbo (0 = arriba, 90 = derecha, 0 a 359) del vector (dx, dy) de la cuadrícula (y crece hacia abajo). Con el vector en cero devuelve `por_defecto`. */
static int rumbo_del_vector(long dx, long dy, int por_defecto)
{
    long ax = (dx < 0) ? -dx : dx;
    long ay = (dy < 0) ? -dy : dy;
    int desde_vertical;

    if (ax == 0 && ay == 0) {
        return por_defecto;
    }
    desde_vertical = (ax <= ay) ? grados_de_cociente(ax, ay) : 90 - grados_de_cociente(ay, ax);   /* ángulo medido desde la vertical, 0 a 90 */
    if (dx >= 0 && dy < 0) {
        return desde_vertical;                 /* arriba-derecha */
    }
    if (dx >= 0) {
        return 180 - desde_vertical;           /* abajo-derecha */
    }
    if (dy >= 0) {
        return 180 + desde_vertical;           /* abajo-izquierda */
    }
    return normalizar_grados(360 - desde_vertical);   /* arriba-izquierda */
}

/* J16: como grados_de_cociente pero en décimas de grado (0 a 450), interpolando la tabla de tangentes entre dos grados enteros. */
static int grados_de_cociente_x10(long numerador, long denominador)
{
    long mil;
    int k;

    if (denominador <= 0 || numerador <= 0) {
        return 0;
    }
    mil = numerador * 1000 / denominador;
    for (k = 1; k <= 45 && mil > TANGENTE_MIL[k]; k++) {
    }
    if (k > 45) {
        return 450;
    }
    return (k - 1) * 10 + (int)((mil - TANGENTE_MIL[k - 1]) * 10 / (TANGENTE_MIL[k] - TANGENTE_MIL[k - 1]));
}

/* J16: rumbo del vector (dx, dy) en décimas de grado (0 a 3599); con el vector en cero, `por_defecto_x10`. */
static int rumbo_del_vector_x10(long dx, long dy, int por_defecto_x10)
{
    long ax = (dx < 0) ? -dx : dx;
    long ay = (dy < 0) ? -dy : dy;
    int desde_vertical;

    if (ax == 0 && ay == 0) {
        return por_defecto_x10;
    }
    desde_vertical = (ax <= ay) ? grados_de_cociente_x10(ax, ay) : 900 - grados_de_cociente_x10(ay, ax);
    if (dx >= 0 && dy < 0) {
        return desde_vertical;
    }
    if (dx >= 0) {
        return 1800 - desde_vertical;
    }
    if (dy >= 0) {
        return 1800 + desde_vertical;
    }
    return (3600 - desde_vertical) % 3600;
}

/* Giro más corto (con signo, + derecha) para pasar del rumbo `desde` al rumbo `hasta`: de -179 a 180. */
static int giro_minimo(int desde, int hasta)
{
    int d = normalizar_grados(hasta - desde);

    return (d > 180) ? d - 360 : d;
}

/* J15: ¿la pose de los avances se orienta con el giroscopio? */
static int rumbo_medido_activo(const Navegador *nav)
{
    return nav->usa_giroscopio && !nav->giro_fw_caido && !nav->sin_rumbo_medido;
}

/* J16: ¿el firmware sostiene el rumbo al avanzar? Solo con RUMBO pedido y el rumbo medido de J15 (sin él no se sabe a qué ángulo apuntar). */
static int rumbo_fw_activo(const Navegador *nav)
{
    return nav->rumbo_fw && rumbo_medido_activo(nav);
}

/* ── Giro medido con la cámara ─────────────────────────────────────────── */

/* Tiempo que el carro lleva MOVIÉNDOSE bajo el comando actual (sin el retardo de arranque). */
static int ms_de_movimiento(const Navegador *nav)
{
    int ms = nav->seg_ms - nav->cal.arranque_ms;

    return (ms > 0) ? ms : 0;
}

static int ms_por_grado_x10_de(const Navegador *nav, int lado)
{
    return (lado < 0) ? nav->cal.ms_por_grado_izq_x10 : nav->cal.ms_por_grado_der_x10;
}

/* ¿La cámara midió suficiente del giro actual como para fiarse de ella? */
static int giro_visual_confiable(const Navegador *nav)
{
    int movimiento = ms_de_movimiento(nav);

    return movimiento >= NAV_MIN_MS_VISUAL && nav->visual_cubierto_ms * 100 >= movimiento * NAV_COBERTURA_VISUAL_PCT;
}

/* Grados por 10 girados hasta ahora en la dirección del comando de giro actual: lo que vio la cámara más, por tiempo, el pedazo
 * del giro que la cámara no cubrió. */
static int giro_estimado_x10(const Navegador *nav, int lado)
{
    int movimiento = ms_de_movimiento(nav);
    int cubierto = (nav->visual_cubierto_ms < movimiento) ? nav->visual_cubierto_ms : movimiento;

    return nav->giro_visual_x10 + (int)((long)(movimiento - cubierto) * 100 / ms_por_grado_x10_de(nav, lado));
}

/* Grados enteros girados en este comando: con la cámara si es confiable, si no por tiempo (como siempre). */
static int grados_girados(const Navegador *nav, int lado)
{
    if (nav->giro_fw && nav->giro_fw_estado == 1) {   /* el giroscopio del firmware ya midió el ángulo REAL */
        return (nav->giro_fw_real_x10 + (nav->giro_fw_real_x10 >= 0 ? 5 : -5)) / 10;
    }
    if (nav->giro_fw) {   /* esperando la respuesta del firmware: mientras tanto la pose avanza por tiempo pero nunca más allá del ángulo pedido (así no salta de ida y vuelta cuando llega el real) */
        int por_tiempo = cal_ms_a_grados(&nav->cal, lado, nav->seg_ms);

        return (por_tiempo > nav->cmd_pedido) ? nav->cmd_pedido : por_tiempo;
    }
    if (giro_visual_confiable(nav)) {
        return giro_estimado_x10(nav, lado) / 10;
    }
    return cal_ms_a_grados(&nav->cal, lado, nav->seg_ms);
}

int navegador_poner_latencia_visual(Navegador *nav, int ms)
{
    if (nav == NULL || ms < 0 || ms > 1000) {
        return NAV_ERR_ARGUMENTO;
    }
    nav->latencia_visual_ms = ms;
    return NAV_OK;
}

int navegador_poner_frenar_lejos_centro(Navegador *nav, int activo)
{
    if (nav == NULL || (activo != 0 && activo != 1)) {
        return NAV_ERR_ARGUMENTO;
    }
    nav->frenar_lejos_centro = activo;
    return NAV_OK;
}

void navegador_aporte_visual(Navegador *nav, int giro_grados_x10, int dt_ms, int confiable)
{
    if (nav == NULL || !confiable || dt_ms <= 0) {
        return;
    }
    if (nav->cmd_actual != NAV_CMD_LEFT && nav->cmd_actual != NAV_CMD_RIGHT) {
        return;   /* solo cuenta mientras gira */
    }
    if (nav->estado != NAV_SIGUIENDO && nav->estado != NAV_ESQUIVANDO && nav->estado != NAV_REINCORPORANDO) {
        return;
    }
    if (nav->seg_ms <= nav->cal.arranque_ms + nav->latencia_visual_ms) {
        return;   /* el carro todavía no arranca (o el cuadro que llega es de antes de arrancar, por el retraso de la cámara) */
    }
    nav->giro_visual_x10 += (nav->cmd_actual == NAV_CMD_RIGHT) ? giro_grados_x10 : -giro_grados_x10;
    nav->visual_cubierto_ms += (dt_ms > NAV_DT_MAX_MS) ? NAV_DT_MAX_MS : dt_ms;
}

/* ¿Ya terminó este giro (de `grados` grados, con `tiempo_ms` planeado y `ms` ejecutados)?
 *  - Con la cámara confiable: sí cuando lo girado más lo que el carro seguirá girando al frenar llega al ángulo pedido (pero no
 *    antes de NAV_GIRO_MIN_PCT del tiempo planeado), o si ya pasó el tiempo de respaldo (NAV_GIRO_MAX_PCT del planeado).
 *  - Sin cámara confiable: por tiempo, como siempre. */
static int giro_terminado(const Navegador *nav, int grados, int tiempo_ms, int ms)
{
    int lado = (nav->cmd_actual == NAV_CMD_LEFT) ? CAL_LADO_IZQUIERDA : CAL_LADO_DERECHA;

    if (nav->giro_fw) {
        return nav->giro_fw_estado == 1;   /* lo mide y lo frena el firmware: se termina cuando llega su respuesta (giro_fw_vigilar cubre la espera máxima) */
    }

    if (giro_visual_confiable(nav)) {
        int objetivo_x10 = grados * 10 - ((lado < 0) ? nav->cal.frenado_grados_izq_x10 : nav->cal.frenado_grados_der_x10);

        if (giro_estimado_x10(nav, lado) >= objetivo_x10 && ms * 100 >= tiempo_ms * NAV_GIRO_MIN_PCT) {
            return 1;
        }
        return ms + NAV_TICK_MS / 2 >= tiempo_ms * NAV_GIRO_MAX_PCT / 100;
    }
    return ms + NAV_TICK_MS / 2 >= tiempo_ms;
}

/* ── Posición estimada por tiempo ──────────────────────────────────────── */

/* Calcula la pose actual a partir de la pose al empezar el comando y del tiempo que lleva.
 * Se calcula desde el TOTAL de tiempo del comando (no sumando pedacitos) para no acumular
 * errores de redondeo. */
/* Mueve la pose el desplazamiento del CENTRO durante un giro de `grados` hacia `lado` que empezó con el rumbo `rumbo_inicial` (ver cal_desplazamiento_giro): con ruedas mecanum
 * el carro no gira sobre un punto fijo. Con la calibración sin desplazamiento (ceros) no hace nada. */
static void sumar_desplazamiento_giro(Navegador *nav, int lado, int grados, int rumbo_inicial)
{
    int dx = 0, dy = 0;

    cal_desplazamiento_giro(&nav->cal, lado, grados, rumbo_inicial, &dx, &dy, NULL, NULL);
    nav->x_mm += dx;
    nav->y_mm += dy;
}

/* Diferencia angular en décimas, con vuelta de 360 grados y signo. */
static int diferencia_x10(int desde, int hasta)
{
    int d = (hasta % 3600 - desde % 3600) % 3600;
    if (d > 1800) d -= 3600;
    if (d < -1800) d += 3600;
    return d;
}

static int grados_de_x10(int x10)
{
    return normalizar_grados(((x10 % 3600 + 3600) % 3600 + 5) / 10);
}

/* El giroscopio no mide distancia: solo orienta cada incremento obtenido por
 * tiempo. No se proyecta TODO el avance con el último ángulo (eso inventaría
 * un desplazamiento al cambiar el rumbo); se integra el arco por incrementos. */
static void calcular_avance_medido(Navegador *nav, int distancia)
{
    int rumbo = nav->avance_rumbo_x10;
    int incremento = distancia - nav->avance_mm_previo;
    int fresco = nav->sens_angulo_ok &&
        (uint32_t)(nav->t_ultimo_ms - nav->sens_angulo_t_ms) <= NAV_TOF_FRESCO_MS;
    if (fresco) {
        if (!nav->avance_imu_ref_ok) {
            nav->avance_imu_ref_x10 = nav->sens_angulo_x10;
            nav->avance_rumbo_ref_x10 = rumbo;
            nav->avance_imu_ref_ok = 1;
        }
        rumbo = nav->avance_rumbo_ref_x10 - diferencia_x10(nav->avance_imu_ref_x10, nav->sens_angulo_x10);
        /* Un salto de IMU_CERO o una medida corrupta no debe rotar la pose.
         * Se recupera la referencia conservando el último rumbo conocido. */
        if (diferencia_x10(nav->avance_rumbo_x10, rumbo) > 250 ||
            diferencia_x10(nav->avance_rumbo_x10, rumbo) < -250) {
            nav->avance_imu_ref_ok = 0;
            rumbo = nav->avance_rumbo_x10;
        }
    }
    {
        int medio_x10 = nav->avance_rumbo_x10 + diferencia_x10(nav->avance_rumbo_x10, rumbo) / 2;
        int ux, uy;

        if (nav->sin_trig_fino) {   /* lo de J15: el rumbo medio redondeado a grados enteros */
            ux = dir_x_mil(grados_de_x10(medio_x10));
            uy = dir_y_mil(grados_de_x10(medio_x10));
        } else {
            ux = dir_x_mil_x10(medio_x10);
            uy = dir_y_mil_x10(medio_x10);
        }
        nav->avance_x_mil += (long)ux * incremento;
        nav->avance_y_mil += (long)uy * incremento;
    }
    nav->avance_mm_previo = distancia;
    nav->avance_rumbo_x10 = rumbo;
    nav->x_mm = nav->base_x_mm + (int)(nav->avance_x_mil / 1000);
    nav->y_mm = nav->base_y_mm + (int)(nav->avance_y_mil / 1000);
    nav->rumbo_grados = grados_de_x10(rumbo);
    nav->rumbo_x10 = ((rumbo % 3600) + 3600) % 3600;
}

/* J16: si alguien cambió los grados enteros sin las décimas (una prueba, o un plan que fija el rumbo), mandan los grados. */
static void respetar_grados(int *x10, int grados)
{
    if (grados_de_x10(*x10) != normalizar_grados(grados)) {
        *x10 = normalizar_grados(grados) * 10;
    }
}

/* J16: deja rumbo_x10 y rumbo_grados de acuerdo. Con RUMBO (el firmware sostiene el objetivo que se le pide) rumbo_grados es el redondeo de rumbo_x10 y la fracción se
 * conserva de un comando al siguiente. Sin RUMBO, o con sin_trig_fino, mandan los grados enteros, como antes: en la simulación, sin RUMBO conservar la fracción retrasaba
 * las correcciones de rumbo de más de 4° (el redondeo las adelantaba) y las rectas empeoraban un poco. */
static void sincronizar_rumbo(Navegador *nav)
{
    if (nav->sin_trig_fino || !rumbo_fw_activo(nav)) {
        nav->rumbo_x10 = nav->rumbo_grados * 10;
    } else {
        nav->rumbo_x10 = ((nav->rumbo_x10 % 3600) + 3600) % 3600;
        nav->rumbo_grados = grados_de_x10(nav->rumbo_x10);
    }
}

/* El rumbo con décimas después de girar `grados` hacia `lado` desde el rumbo del inicio del comando: con el ángulo REAL del giroscopio si ya llegó (en décimas), si no con
 * los grados enteros que se estimaron. */
static int rumbo_tras_giro_x10(const Navegador *nav, int lado, int grados)
{
    int girado_x10 = (nav->giro_fw && nav->giro_fw_estado == 1) ? nav->giro_fw_real_x10 : grados * 10;

    return nav->base_rumbo_x10 + lado * girado_x10;
}

static void calcular_pose(Navegador *nav)
{
    int distancia, grados;

    respetar_grados(&nav->base_rumbo_x10, nav->base_rumbo_grados);
    nav->x_mm = nav->base_x_mm;
    nav->y_mm = nav->base_y_mm;
    nav->rumbo_grados = nav->base_rumbo_grados;
    nav->rumbo_x10 = nav->base_rumbo_x10;

    switch (nav->cmd_actual) {
    case NAV_CMD_FORWARD:
    case NAV_CMD_REVERSE:
        if (nav->cmd_actual == NAV_CMD_REVERSE) {
            distancia = -cal_ms_a_mm_atras(&nav->cal, nav->seg_ms);   /* milímetros hacia atrás (con la calibración del retroceso) */
        } else {
            distancia = cal_ms_a_mm(&nav->cal, nav->seg_ms);          /* milímetros recorridos */
        }
        nav->x_mm = nav->base_x_mm + dir_x_mil(nav->base_rumbo_grados) * distancia / 1000;
        nav->y_mm = nav->base_y_mm + dir_y_mil(nav->base_rumbo_grados) * distancia / 1000;
        if (nav->usa_giroscopio && !nav->giro_fw_caido && !nav->sin_rumbo_medido) {
            calcular_avance_medido(nav, distancia);
        }
        break;
    case NAV_CMD_LEFT:
        grados = grados_girados(nav, CAL_LADO_IZQUIERDA);
        nav->rumbo_grados = normalizar_grados(nav->base_rumbo_grados - grados);
        nav->rumbo_x10 = rumbo_tras_giro_x10(nav, CAL_LADO_IZQUIERDA, grados);
        sumar_desplazamiento_giro(nav, CAL_LADO_IZQUIERDA, grados, nav->base_rumbo_grados);
        break;
    case NAV_CMD_RIGHT:
        grados = grados_girados(nav, CAL_LADO_DERECHA);
        nav->rumbo_grados = normalizar_grados(nav->base_rumbo_grados + grados);
        nav->rumbo_x10 = rumbo_tras_giro_x10(nav, CAL_LADO_DERECHA, grados);
        sumar_desplazamiento_giro(nav, CAL_LADO_DERECHA, grados, nav->base_rumbo_grados);
        break;
    default:
        /* V2: parado después de un avance, el rumbo sigue al giroscopio. Antes el rumbo se quedaba con la última lectura recibida AVANZANDO (hasta 150 ms vieja) y lo
         * que el carro giraba al frenar se perdía: si se detenía mientras el firmware corregía el rumbo (o en pleno vistazo) el error pasaba de 5 grados y se
         * arrastraba al resto de la ruta. La referencia es la misma pareja (lectura del giroscopio, rumbo) con la que cerró el avance. */
        if (nav->cmd_actual == NAV_CMD_STOP && (nav->cmd_previo == NAV_CMD_FORWARD || nav->cmd_previo == NAV_CMD_REVERSE) && rumbo_medido_activo(nav) &&
            nav->avance_imu_ref_ok && nav->sens_angulo_ok && (uint32_t)(nav->t_ultimo_ms - nav->sens_angulo_t_ms) <= NAV_TOF_FRESCO_MS) {
            int girado = diferencia_x10(nav->avance_imu_ref_x10, nav->sens_angulo_x10);   /* + izquierda, como el firmware */

            if (girado >= -300 && girado <= 300) {
                int rumbo = nav->base_rumbo_x10 - girado;

                nav->rumbo_x10 = ((rumbo % 3600) + 3600) % 3600;
                nav->rumbo_grados = grados_de_x10(nav->rumbo_x10);
            }
        }
        break;
    }
    sincronizar_rumbo(nav);
}

/* Toma la pose actual como punto de partida del siguiente comando. */
static void fijar_pose(Navegador *nav)
{
    nav->base_x_mm = nav->x_mm;
    nav->base_y_mm = nav->y_mm;
    respetar_grados(&nav->rumbo_x10, nav->rumbo_grados);
    nav->base_rumbo_grados = nav->rumbo_grados;
    nav->base_rumbo_x10 = nav->rumbo_x10;
    nav->seg_ms = 0;
    nav->avance_mm_previo = 0;
    nav->avance_x_mil = nav->avance_y_mil = 0;
    nav->avance_rumbo_x10 = nav->avance_rumbo_ref_x10 = nav->rumbo_x10;   /* J16: con décimas (antes rumbo_grados x 10: hasta 0.5° de error en cada plan nuevo) */
    nav->avance_imu_ref_x10 = nav->sens_angulo_x10;
    nav->avance_imu_ref_ok = nav->sens_angulo_ok &&
        (uint32_t)(nav->t_ultimo_ms - nav->sens_angulo_t_ms) <= NAV_TOF_FRESCO_MS;
}

/* Al soltar un comando de movimiento el carro NO se detiene al instante: sigue avanzando (o
 * girando) el frenado medido. Se suma a la pose para que la posición estimada lo incluya. */
static void sumar_frenado(Navegador *nav)
{
    int mm, grados;

    if ((nav->cmd_actual == NAV_CMD_LEFT || nav->cmd_actual == NAV_CMD_RIGHT) && nav->giro_fw && nav->giro_fw_estado == 1) {
        return;   /* el ángulo que midió el giroscopio ya incluye lo que el carro siguió girando al frenar */
    }
    respetar_grados(&nav->rumbo_x10, nav->rumbo_grados);

    switch (nav->cmd_actual) {
    case NAV_CMD_FORWARD:
    case NAV_CMD_REVERSE:
        mm = nav->cal.frenado_mm;
        if (nav->cmd_actual == NAV_CMD_REVERSE) {
            mm = -mm;
        }
        if (nav->sin_trig_fino) {
            nav->x_mm += dir_x_mil(nav->rumbo_grados) * mm / 1000;
            nav->y_mm += dir_y_mil(nav->rumbo_grados) * mm / 1000;
        } else {
            nav->x_mm += dir_x_mil_x10(nav->rumbo_x10) * mm / 1000;
            nav->y_mm += dir_y_mil_x10(nav->rumbo_x10) * mm / 1000;
        }
        break;
    case NAV_CMD_LEFT:
        grados = cal_frenado_grados(&nav->cal, CAL_LADO_IZQUIERDA);   /* lo que sigue girando al frenar... */
        sumar_desplazamiento_giro(nav, CAL_LADO_IZQUIERDA, grados, nav->rumbo_grados);   /* ...y el centro también se sigue moviendo */
        nav->rumbo_grados = normalizar_grados(nav->rumbo_grados - grados);
        nav->rumbo_x10 -= grados * 10;
        break;
    case NAV_CMD_RIGHT:
        grados = cal_frenado_grados(&nav->cal, CAL_LADO_DERECHA);
        sumar_desplazamiento_giro(nav, CAL_LADO_DERECHA, grados, nav->rumbo_grados);
        nav->rumbo_grados = normalizar_grados(nav->rumbo_grados + grados);
        nav->rumbo_x10 += grados * 10;
        break;
    default:
        break;
    }
    sincronizar_rumbo(nav);
}

static void registrar_fin_comando(Navegador *nav);                      /* se definen más abajo, junto a la cola de diagnóstico */
static void registrar_inicio_comando(Navegador *nav, ComandoNav nuevo);
static void giro_fw_empezar(Navegador *nav, ComandoNav nuevo);

/* Ajusta el tiempo ya ejecutado del paso cuando el carro frena de FORWARD a STOP y luego reanuda: el frenado cuenta una sola vez y ms_paso nunca queda negativo. */
static void ajustar_paso_tras_parar(Navegador *nav)
{
    if (!nav->frenado_pendiente) {
        return;
    }
    nav->frenado_pendiente = 0;
    nav->ms_paso += (int)((long)nav->cal.frenado_mm * nav->cal.ms_por_cm_x10 / 100) - nav->cal.arranque_ms;
    if (nav->ms_paso < 0) {
        nav->ms_paso = 0;
    }
}

/* Cambia el comando actual (si es distinto) cerrando el tramo anterior. */
static void cambiar_comando(Navegador *nav, ComandoNav nuevo)
{
    if (nuevo != nav->cmd_actual) {
        if (nav->cmd_actual == NAV_CMD_LEFT || nav->cmd_actual == NAV_CMD_RIGHT) {
            nav->atras_conocido_mm = 0; /* el espacio recorrido ya no queda detras */
        }
        if (nav->cmd_actual == NAV_CMD_FORWARD && nuevo == NAV_CMD_STOP &&
            (nav->estado == NAV_SIGUIENDO || nav->estado == NAV_DETENIDO_OBSTACULO)) {
            nav->frenado_pendiente = 1;
        }
        sumar_frenado(nav);
        registrar_fin_comando(nav);   /* antes de fijar_pose: necesita la pose de antes y de después del comando */
        fijar_pose(nav);
        nav->giro_fw = 0;                /* el giro por ángulo (si había) ya se cerró en registrar_fin_comando */
        nav->giro_fw_estado = 0;
        nav->giro_fw_pedir = 0;
        nav->giro_fw_consultando = 0;
        nav->giro_fw_consulta_pedir = 0;
        nav->giro_visual_x10 = 0;        /* un comando nuevo empieza a medir desde cero */
        nav->visual_cubierto_ms = 0;
        nav->rumbo_fw_hay_enviado = 0;   /* J16: cada FORWARD nuevo el firmware empieza sosteniendo el rumbo de ese momento */
        nav->rumbo_fw_pedir = 0;
        nav->cmd_previo = (int)nav->cmd_actual;
        nav->cmd_actual = nuevo;
        registrar_inicio_comando(nav, nuevo);
        giro_fw_empezar(nav, nuevo);
    }
}

/* ── Pasos, esquivar y errores ─────────────────────────────────────────── */

/* Comando que corresponde a un paso: AVANZAR = FORWARD; GIRAR + = RIGHT, GIRAR - = LEFT. */
static ComandoNav comando_de_paso(const Paso *paso)
{
    if (paso->tipo == PASO_AVANZAR) {
        return NAV_CMD_FORWARD;
    }
    return (paso->valor > 0) ? NAV_CMD_RIGHT : NAV_CMD_LEFT;
}

/* Para deshacer el giro de la esquivada (angulo_total grados hacia `lado`) se gira SIEMPRE hacia el lado CONTRARIO esos mismos grados, aunque sean 225
 * (tras dos reintentos). Seguir hacia el mismo lado los 360 - total que faltan es más corto, pero entonces el carro da una vuelta entera en un solo sentido y
 * el error de la calibración del giro (que es por tiempo) se SUMA en vez de cancelarse: con un 10 % de error son 36 grados de rumbo equivocado. */
static int lado_de_vuelta(const Navegador *nav)
{
    return -nav->lado;
}

static int grados_de_vuelta(const Navegador *nav)
{
    return nav->angulo_total - nav->giro_extra_grados;   /* V2: lo que el primer giro llevó de más para deshacer un vistazo no se devuelve */
}

/* Comando de la fase de esquivar actual (ver NAV_FASE_*). Mirar y asentar son STOP. */
static ComandoNav comando_de_fase(const Navegador *nav)
{
    switch (nav->fase) {
    case NAV_FASE_AVANZAR:    return NAV_CMD_FORWARD;
    case NAV_FASE_PARALELO:   return NAV_CMD_FORWARD;
    case NAV_FASE_GIRAR:      return (nav->lado < 0) ? NAV_CMD_LEFT : NAV_CMD_RIGHT;
    case NAV_FASE_VOLVER:     return (lado_de_vuelta(nav) < 0) ? NAV_CMD_LEFT : NAV_CMD_RIGHT;
    case NAV_FASE_RETROCEDER: return NAV_CMD_REVERSE;
    default:                  return NAV_CMD_STOP;   /* MIRAR y ASENTAR */
    }
}

/* Tiempo de retroceso: NAV_RETROCESO_CM cm con la calibración del retroceso, sin pasar nunca de NAV_RETROCESO_MAX_MS. */
static int ms_de_retroceso(const Navegador *nav)
{
    int ms = cal_cm_a_ms_atras(&nav->cal, NAV_RETROCESO_CM);

    return (ms > NAV_RETROCESO_MAX_MS) ? NAV_RETROCESO_MAX_MS : ms;
}

/* Cuánto debe durar cada fase de esquivar, en ms (las de STOP las controla la hora, no esta duración). */
static int duracion_fase(const Navegador *nav, int fase)
{
    if (fase == NAV_FASE_AVANZAR) {
        return cal_cm_a_ms(&nav->cal, (nav->tramo_mm + 5) / 10);   /* el tramo de lado planeado con el desplazamiento de los giros (esq_calcular_tramo) */
    }
    /* Girar va hacia el lado elegido y volver hacia el otro (o el mismo, ver lado_de_vuelta): cada lado tiene su tiempo. */
    if (fase == NAV_FASE_GIRAR) {
        return cal_grados_a_ms(&nav->cal, (nav->lado < 0) ? -nav->angulo_giro : nav->angulo_giro);
    }
    if (fase == NAV_FASE_VOLVER) {
        return cal_grados_a_ms(&nav->cal, (lado_de_vuelta(nav) < 0) ? -grados_de_vuelta(nav) : grados_de_vuelta(nav));
    }
    if (fase == NAV_FASE_RETROCEDER) {
        return ms_de_retroceso(nav);
    }
    if (fase == NAV_FASE_PARALELO) {
        return cal_cm_a_ms(&nav->cal, (nav->paralelo_mm + 5) / 10);
    }
    return 0;
}

static void diag_escribir(Navegador *nav, const char *formato, ...);   /* se define más abajo */

/* Pasa a ERROR. `causa` dice qué pasó en concreto (NAV_CAUSA_*; ver navegador_texto_error). */
static void ir_a_error_causa(Navegador *nav, MotivoErrorNav motivo, int causa)
{
    /* Con «pedir ayuda» activo, no poder esquivar no es un ERROR: se queda quieto y pide que el usuario tome el control. */
    if (nav->pedir_ayuda && (motivo == NAV_MOTIVO_LADOS_BLOQUEADOS || motivo == NAV_MOTIVO_MAX_ESQUIVADAS || motivo == NAV_MOTIVO_ESQUIVANDO)) {
        nav->estado = NAV_AYUDA;
        nav->ayuda_motivo = motivo;
        nav->ayuda_cmd = NAV_CMD_STOP;
        nav->ayuda_t_ini_ms = nav->t_ultimo_ms;
        nav->ayudas++;
        nav->error_causa = causa;          /* navegador_texto_error dice por qué pide ayuda */
        diag_escribir(nav, "AYUDA_DIAG pide ayuda motivo=%d causa=%d pose=(%d,%d,%d) esquivadas=%d del_obstaculo=%d ayudas=%d laser_mm=%d laser_valido=%d", (int)motivo, causa, nav->x_mm,
                      nav->y_mm, nav->rumbo_grados, nav->esquivadas, nav->esquivadas_obstaculo, nav->ayudas, nav->tof_mm, nav->tof_valida);
        return;
    }
    nav->estado = NAV_ERROR;
    nav->motivo_error = motivo;
    nav->error_causa = causa;
}

static void ir_a_error(Navegador *nav, MotivoErrorNav motivo)
{
    int causa = NAV_CAUSA_NINGUNA;

    switch (motivo) {
    case NAV_MOTIVO_LADOS_BLOQUEADOS: causa = NAV_CAUSA_LADOS; break;
    case NAV_MOTIVO_MAX_ESQUIVADAS:   causa = NAV_CAUSA_MAX_ESQUIVADAS; break;
    case NAV_MOTIVO_ESQUIVANDO:       causa = NAV_CAUSA_REINTENTOS; break;
    case NAV_MOTIVO_PLAN:             causa = NAV_CAUSA_PLAN; break;
    case NAV_MOTIVO_SIN_VIDEO:        causa = NAV_CAUSA_SIN_VIDEO; break;
    default: break;
    }
    ir_a_error_causa(nav, motivo, causa);
}

/* Comando de la fase de REINCORPORANDO (ver NAV_RF_*). Las fases de pausa y PLAN son STOP. */
static ComandoNav comando_de_reinc(const Navegador *nav)
{
    switch (nav->reinc_fase) {
    case NAV_RF_GIRO1:   return (nav->reinc_giro1 < 0) ? NAV_CMD_LEFT : NAV_CMD_RIGHT;
    case NAV_RF_AVANZAR: return NAV_CMD_FORWARD;
    case NAV_RF_GIRO2:   return (nav->reinc_giro2 < 0) ? NAV_CMD_LEFT : NAV_CMD_RIGHT;
    case NAV_RF_DESHACER: return NAV_CMD_REVERSE;
    default:             return NAV_CMD_STOP;
    }
}

/* El carro ejecutó `dt` ms del comando anterior: si era el del paso (o fase) actual, se
 * suma al tiempo ya ejecutado de ese paso. Así se cuenta el tiempo REAL, no el planeado. */
static void contar_tiempo_ejecutado(Navegador *nav, int dt)
{
    if (nav->sondeo_fase == 1 && nav->cmd_actual == NAV_CMD_FORWARD) {
        nav->ms_sondeo += dt;   /* el sondeo del arranque avanza NAV_SONDEO_CM cm */
    }
    if (nav->estado == NAV_SIGUIENDO && nav->indice_paso < nav->n_pasos &&
        nav->cmd_actual == comando_de_paso(&nav->pasos[nav->indice_paso])) {
        nav->ms_paso += dt;
    } else if (nav->estado == NAV_ESQUIVANDO && nav->cmd_actual == comando_de_fase(nav)) {
        nav->ms_fase += dt;
    } else if (nav->estado == NAV_REINCORPORANDO && nav->cmd_actual == comando_de_reinc(nav)) {
        nav->ms_fase += dt;
    }
}

/* ── Diagnóstico (cola de líneas de texto) ─────────────────────────────── */

/* Escribe una línea en la cola (como printf). La app las saca con navegador_diag_siguiente(). Si la cola se llena, la línea más vieja se pierde. */
static void diag_escribir(Navegador *nav, const char *formato, ...)
{
    va_list args;
    int pos = nav->diag_escritas % NAV_DIAG_LINEAS;

    va_start(args, formato);
    vsnprintf(nav->diag[pos], NAV_DIAG_LARGO, formato, args);
    va_end(args);
    nav->diag_escritas++;
    if (nav->diag_escritas - nav->diag_leidas > NAV_DIAG_LINEAS) {
        nav->diag_leidas = nav->diag_escritas - NAV_DIAG_LINEAS;
    }
}

int navegador_diag_siguiente(Navegador *nav, char *texto, int capacidad)
{
    int i = 0;
    const char *linea;

    if (nav == NULL || texto == NULL || capacidad < 2 || nav->diag_leidas >= nav->diag_escritas) {
        return 0;
    }
    linea = nav->diag[nav->diag_leidas % NAV_DIAG_LINEAS];
    while (linea[i] != '\0' && i < capacidad - 1) {
        texto[i] = linea[i];
        i++;
    }
    texto[i] = '\0';
    nav->diag_leidas++;
    return 1;
}

/* ── Registro de los comandos de movimiento (RUTA_DIAG y TURN_DIAG) ─────── */

static const char *nombre_origen(int estado)
{
    switch (estado) {
    case NAV_SIGUIENDO:      return "ruta";
    case NAV_ESQUIVANDO:     return "esquive";
    case NAV_REINCORPORANDO: return "vuelta";
    case NAV_AYUDA:          return "ayuda";
    default:                 return "otro";
    }
}

/* Qué pidió el programa y cuánto debe durar el comando `cmd` que empieza ahora, según lo que está haciendo el navegador: grados (giros) o mm (avance y retroceso), y ms.
 * A mano (AYUDA) no se pidió nada: los dos quedan en 0. */
static void plan_del_comando(const Navegador *nav, ComandoNav cmd, int *pedido, int *ms)
{
    *pedido = 0;
    *ms = 0;
    if (nav->estado == NAV_SIGUIENDO && nav->indice_paso < nav->n_pasos && cmd == comando_de_paso(&nav->pasos[nav->indice_paso])) {
        const Paso *paso = &nav->pasos[nav->indice_paso];

        *pedido = (paso->tipo == PASO_AVANZAR) ? paso->valor * 10 : ((paso->valor < 0) ? -paso->valor : paso->valor);
        *ms = paso->tiempo_ms;
    } else if (nav->estado == NAV_ESQUIVANDO && cmd == comando_de_fase(nav)) {
        switch (nav->fase) {
        case NAV_FASE_GIRAR:      *pedido = nav->angulo_giro; break;
        case NAV_FASE_VOLVER:     *pedido = grados_de_vuelta(nav); break;
        case NAV_FASE_AVANZAR:    *pedido = nav->tramo_mm; break;
        case NAV_FASE_RETROCEDER: *pedido = NAV_RETROCESO_CM * 10; break;
        case NAV_FASE_PARALELO:   *pedido = nav->paralelo_mm; break;
        default: break;
        }
        *ms = duracion_fase(nav, nav->fase);
    } else if (nav->estado == NAV_REINCORPORANDO && cmd == comando_de_reinc(nav)) {
        if (nav->reinc_fase == NAV_RF_AVANZAR) {
            *pedido = nav->reinc_dist_mm;
            *ms = cal_cm_a_ms(&nav->cal, (nav->reinc_dist_mm + 5) / 10);
        } else if (nav->reinc_fase == NAV_RF_DESHACER) {
            *pedido = nav->reinc_deshacer_mm;
            *ms = cal_cm_a_ms_atras(&nav->cal, (nav->reinc_deshacer_mm + 5) / 10);
        } else {
            int giro = (nav->reinc_fase == NAV_RF_GIRO1) ? nav->reinc_giro1 : nav->reinc_giro2;

            *pedido = (giro < 0) ? -giro : giro;
            *ms = cal_grados_a_ms(&nav->cal, giro);
        }
    }
}

/* Empieza un comando de movimiento: se anota qué se pidió y cuánto debe durar, y se escribe RUTA_DIAG envia. Los STOP no se anotan (son el fin de un movimiento). */
static void registrar_inicio_comando(Navegador *nav, ComandoNav nuevo)
{
    nav->cmd_pedido = 0;
    nav->cmd_plan_ms = 0;
    nav->cmd_origen = (int)nav->estado;
    if (nuevo == NAV_CMD_STOP) {
        return;
    }
    plan_del_comando(nav, nuevo, &nav->cmd_pedido, &nav->cmd_plan_ms);
    diag_escribir(nav, "RUTA_DIAG envia cmd=%s origen=%s pedido=%d plan_ms=%d t_ms=%lu", navegador_texto_comando(nuevo), nombre_origen(nav->cmd_origen),
                  nav->cmd_pedido, nav->cmd_plan_ms, (unsigned long)nav->t_ultimo_ms);
}

/* Termina un comando de movimiento (la pose ya incluye el frenado): se escribe RUTA_DIAG fin con la duración real y lo hecho (estimado) y, si fue un giro, TURN_DIAG con el
 * desplazamiento del centro que se aplicó, y el giro queda anotado para la pantalla de resultado. */
static void registrar_fin_comando(Navegador *nav)
{
    ComandoNav cmd = nav->cmd_actual;
    int dx = nav->x_mm - nav->base_x_mm, dy = nav->y_mm - nav->base_y_mm;
    int hecho;

    if (cmd == NAV_CMD_STOP || nav->cmd_plan_ms < 0) {
        return;   /* un STOP no se anota; y un registro ya cerrado (cmd_plan_ms = -1) no se cierra dos veces */
    }
    if (cmd == NAV_CMD_FORWARD || cmd == NAV_CMD_REVERSE) {
        diag_escribir(nav, "POSE_DIAG avance origen=%s pose=(%d,%d,%d) rumbo_inicio=%d imu_lista=%d imu_edad_ms=%lu por=%s",
                      nombre_origen(nav->cmd_origen), nav->x_mm, nav->y_mm, nav->rumbo_grados, nav->base_rumbo_grados,
                      nav->sens_angulo_ok, (unsigned long)(nav->t_ultimo_ms - nav->sens_angulo_t_ms),
                      nav->usa_giroscopio && !nav->giro_fw_caido && !nav->sin_rumbo_medido ? "rumbo_medido" : "tiempo");
    }
    if (cmd == NAV_CMD_LEFT || cmd == NAV_CMD_RIGHT) {
        int lado = (cmd == NAV_CMD_LEFT) ? CAL_LADO_IZQUIERDA : CAL_LADO_DERECHA;
        int um_adelante, um_derecha;
        int h0 = nav->base_rumbo_grados;
        int por_fw = (nav->giro_fw && nav->giro_fw_estado == 1);
        NavGiro giro;

        hecho = por_fw ? grados_girados(nav, lado) : grados_girados(nav, lado) + cal_frenado_grados(&nav->cal, lado);
        cal_leer_desplazamiento(&nav->cal, lado, &um_adelante, &um_derecha);
        giro.lado = lado;
        giro.origen = nav->cmd_origen;
        giro.pedido_grados = nav->cmd_pedido;
        giro.hecho_grados = hecho;
        giro.plan_ms = nav->cmd_plan_ms;
        giro.real_ms = nav->seg_ms;
        giro.desp_adelante_mm = (dx * seno_mil(h0) - dy * seno_mil(h0 + 90)) / 1000;    /* el desplazamiento del mapa, en el marco del carro al empezar el giro */
        giro.desp_derecha_mm = (dx * seno_mil(h0 + 90) + dy * seno_mil(h0)) / 1000;
        giro.por_angulo = por_fw;
        diag_escribir(nav, "TURN_DIAG lado=%s origen=%s pedido=%d hecho=%d plan_ms=%d real_ms=%d um_grado=(%d,%d) mm=(%d,%d) carro_mm=(%d,%d) rumbo=%d>%d%s por=%s fw_real_x10=%d fw_ms=%d ant=%d",
                      (lado < 0) ? "IZQ" : "DER", nombre_origen(giro.origen), giro.pedido_grados, hecho, giro.plan_ms, giro.real_ms, um_adelante, um_derecha,
                      dx, dy, giro.desp_adelante_mm, giro.desp_derecha_mm, h0, nav->rumbo_grados,
                      cal_desplazamiento_es_espejo(&nav->cal, lado) ? " aviso=espejo_estimado" : "", por_fw ? "angulo" : "tiempo", por_fw ? nav->giro_fw_real_x10 : 0, por_fw ? nav->giro_fw_ms : 0, por_fw ? nav->giro_fw_ant : 0);
        if (nav->cmd_pedido > 0) {
            if (por_fw) {
                nav->n_giros_angulo++;
                diag_escribir(nav, "SENS_DIAG giro por=angulo objetivo=%d real_x10=%d error_x10=%d fw_ms=%d origen=%s", nav->cmd_pedido, nav->giro_fw_real_x10,
                              nav->giro_fw_real_x10 - nav->cmd_pedido * 10, nav->giro_fw_ms, nombre_origen(giro.origen));
            } else {
                nav->n_giros_tiempo++;
            }
        }
        if (nav->n_giros < NAV_MAX_GIROS) {
            nav->giros[nav->n_giros++] = giro;
        } else {
            nav->giros_perdidos++;
        }
    } else {
        hecho = (int)raiz_entera((long)dx * dx + (long)dy * dy);   /* mm que se movió (con el frenado) */
    }
    diag_escribir(nav, "RUTA_DIAG fin cmd=%s origen=%s pedido=%d plan_ms=%d real_ms=%d hecho=%d", navegador_texto_comando(cmd), nombre_origen(nav->cmd_origen),
                  nav->cmd_pedido, nav->cmd_plan_ms, nav->seg_ms, hecho);
}

int navegador_cuantos_giros(const Navegador *nav)
{
    return (nav == NULL) ? 0 : nav->n_giros;
}

int navegador_giro_datos(const Navegador *nav, int indice, NavGiro *giro)
{
    if (nav == NULL || giro == NULL || indice < 0 || indice >= nav->n_giros) {
        return NAV_ERR_ARGUMENTO;
    }
    *giro = nav->giros[indice];
    return NAV_OK;
}

int navegador_texto_giros(const Navegador *nav, char *texto, int capacidad)
{
    int i, largo = 0;

    if (nav == NULL || texto == NULL || capacidad < 2) {
        return 0;
    }
    texto[0] = '\0';
    for (i = 0; i < nav->n_giros && largo < capacidad - 1; i++) {
        const NavGiro *g = &nav->giros[i];
        int n;

        if (g->origen == NAV_SIGUIENDO) {
            n = snprintf(texto + largo, (size_t)(capacidad - largo), "%sGiro %s: pedido %d°, hecho ~%d°", (i > 0) ? "\n" : "", (g->lado < 0) ? "izquierda" : "derecha",
                         g->pedido_grados, g->hecho_grados);
        } else {
            n = snprintf(texto + largo, (size_t)(capacidad - largo), "%sGiro %s (%s): pedido %d°, hecho ~%d°", (i > 0) ? "\n" : "", (g->lado < 0) ? "izquierda" : "derecha",
                         nombre_origen(g->origen), g->pedido_grados, g->hecho_grados);
        }
        if (n < 0 || n >= capacidad - largo) {
            largo = capacidad - 1;
            break;
        }
        largo += n;
    }
    if (nav->usa_giroscopio && largo < capacidad - 1) {   /* resumen final: cuántos giros midió el giroscopio y cuántos fueron por tiempo */
        int n = snprintf(texto + largo, (size_t)(capacidad - largo), "%sGiros por ángulo (giroscopio): %d, por tiempo: %d", (largo > 0) ? "\n" : "", nav->n_giros_angulo, nav->n_giros_tiempo);

        if (n > 0 && n < capacidad - largo) {
            largo += n;
        } else {
            largo = capacidad - 1;
        }
    }
    texto[largo] = '\0';
    return largo;
}

/* ── Giro por ángulo y láser (J11) ─────────────────────────────────────── */
/* Pide al firmware el giro que acaba de empezar, si corresponde: solo con el giroscopio encendido y sano, y con un ángulo que el firmware acepta. La app lo manda al ver navegador_tomar_giro_fw. */
static void giro_fw_empezar(Navegador *nav, ComandoNav nuevo)
{
    if (nuevo != NAV_CMD_LEFT && nuevo != NAV_CMD_RIGHT) {
        return;
    }
    if (nav->usa_giroscopio && nav->giro_fw_caido && nav->giro_fw_fallos < NAV_GIRO_FW_FALLOS_MAX && nav->sens_angulo_ok &&
        (uint32_t)(nav->t_ultimo_ms - nav->sens_angulo_t_ms) <= (uint32_t)NAV_TOF_FRESCO_MS) {
        /* V2: un giro por ángulo falló antes, pero SENS dice que el giroscopio está listo ahora: se vuelve a intentar (un giro por tiempo es mucho peor que uno medido). */
        nav->giro_fw_caido = 0;
        diag_escribir(nav, "SENS_DIAG giro reintenta_por_angulo fallos=%d: el giroscopio informa listo", nav->giro_fw_fallos);
    }
    if (!nav->usa_giroscopio || nav->giro_fw_caido) {
        return;
    }
    if (nav->cmd_pedido < nav->giro_fw_min || nav->cmd_pedido > NAV_GIRO_FW_MAX_GRADOS) {
        return;   /* uno menor que el mínimo del firmware no se planea (giro_ejecutable); uno de más de 200 se hace por tiempo */
    }
    nav->giro_fw = 1;
    nav->giro_fw_estado = 0;
    nav->giro_fw_pedir = 1;
    nav->giro_fw_grados = (nuevo == NAV_CMD_RIGHT) ? nav->cmd_pedido : -nav->cmd_pedido;
    nav->giro_fw_real_x10 = 0;
    nav->giro_fw_ms = 0;
    nav->giro_fw_t_ms = nav->t_ultimo_ms;
    nav->giro_fw_consultando = 0;
    nav->giro_fw_consulta_pedir = 0;
    nav->giro_fw_ang_ini_ok = nav->sens_angulo_ok && (uint32_t)(nav->t_ultimo_ms - nav->sens_angulo_t_ms) <= (uint32_t)NAV_TOF_FRESCO_MS;   /* el ángulo del giroscopio justo antes del giro */
    nav->giro_fw_ang_ini_x10 = nav->sens_angulo_x10;
    diag_escribir(nav, "SENS_DIAG giro pide=GIRAR objetivo=%d origen=%s t_ms=%lu", nav->giro_fw_grados, nombre_origen(nav->cmd_origen), (unsigned long)nav->t_ultimo_ms);
}

/* El giro por ángulo no se pudo (no hubo respuesta o el firmware ni lo empezó): este giro se hace por tiempo y los siguientes de la ruta también. El carro no giró (o no se sabe cuánto): se
 * vuelve a partir de la pose de antes del giro. */
static void giro_fw_pasar_a_tiempo(Navegador *nav, const char *motivo)
{
    nav->giro_fw = 0;
    nav->giro_fw_pedir = 0;
    nav->giro_fw_estado = 0;
    nav->giro_fw_caido = 1;
    nav->giro_fw_fallos++;
    nav->x_mm = nav->base_x_mm;
    nav->y_mm = nav->base_y_mm;
    nav->rumbo_grados = nav->base_rumbo_grados;
    nav->rumbo_x10 = nav->base_rumbo_x10;
    fijar_pose(nav);
    if (nav->estado == NAV_SIGUIENDO) {
        nav->ms_paso = 0;   /* solo el contador del movimiento en curso: en ESQUIVANDO o REINCORPORANDO ms_paso es del paso de la ruta que quedó interrumpido y no se toca */
    } else {
        nav->ms_fase = 0;
    }
    nav->giro_fw_consultando = 0;
    nav->giro_visual_x10 = 0;
    nav->visual_cubierto_ms = 0;
    diag_escribir(nav, "SENS_DIAG giro_a_tiempo motivo=%s: este giro y los que siguen de la ruta van por tiempo", motivo);
}

/* El mensaje del giro se perdió: con el ángulo actual del giroscopio se sabe cuánto giró de verdad (en la dirección del comando). Si ya giró al menos NAV_GIRO_FW_YA_GIRO_PCT % de lo pedido, ese es el
 * ángulo real y NO se repite nada; si no, la pose parte de lo que giró y se repite por tiempo SOLO lo que falta. */
static void giro_fw_resolver(Navegador *nav, int angulo_ahora_x10, const char *fuente)
{
    int hecho_x10 = (nav->cmd_actual == NAV_CMD_LEFT) ? angulo_ahora_x10 - nav->giro_fw_ang_ini_x10 : nav->giro_fw_ang_ini_x10 - angulo_ahora_x10;
    int pedido_x10 = nav->cmd_pedido * 10;

    nav->giro_fw_consultando = 0;
    nav->giro_fw_consulta_pedir = 0;
    if (hecho_x10 * 100 >= pedido_x10 * NAV_GIRO_FW_YA_GIRO_PCT) {
        nav->giro_fw_real_x10 = hecho_x10;      /* ya giró: lo medido es el ángulo real */
        nav->giro_fw_ms = 0;
        nav->giro_fw_estado = 1;
        diag_escribir(nav, "SENS_DIAG giro mensaje_perdido fuente=%s real_x10=%d pedido_x10=%d: ya giro al menos el %d %%, NO se repite", fuente, hecho_x10, pedido_x10, NAV_GIRO_FW_YA_GIRO_PCT);
        return;
    }
    {   /* giró solo una parte: la pose parte de ahí y por tiempo se hace lo que falta */
        int lado = (nav->cmd_actual == NAV_CMD_LEFT) ? -1 : 1;
        int total_ms = cal_grados_a_ms(&nav->cal, lado * nav->cmd_pedido);
        int falta_ms;
        int parcial = (hecho_x10 > 0) ? hecho_x10 : 0;

        nav->giro_fw_real_x10 = parcial;
        nav->giro_fw_estado = 1;
        calcular_pose(nav);                      /* la pose después de lo que ya giró */
        fijar_pose(nav);
        nav->giro_fw = 0;
        nav->giro_fw_estado = 0;
        nav->giro_fw_pedir = 0;
        nav->giro_fw_caido = 1;                  /* lo que falta de este giro va por tiempo (el siguiente se reintenta si SENS dice que el giroscopio está listo) */
        nav->giro_fw_fallos++;
        falta_ms = cal_grados_a_ms(&nav->cal, lado * ((pedido_x10 - parcial) / 10));
        {
            int hecho_ms = total_ms - falta_ms;

            if (hecho_ms < 0) {
                hecho_ms = 0;
            }
            if (nav->estado == NAV_SIGUIENDO) {
                nav->ms_paso = hecho_ms;         /* el paso termina cuando se cumple su tiempo total: queda solo lo que falta */
            } else {
                nav->ms_fase = hecho_ms;
            }
        }
        nav->giro_visual_x10 = 0;
        nav->visual_cubierto_ms = 0;
        diag_escribir(nav, "SENS_DIAG giro mensaje_perdido fuente=%s real_x10=%d pedido_x10=%d: giro menos del %d %%, se repite por tiempo SOLO lo que falta (%d ms)", fuente, hecho_x10, pedido_x10,
                      NAV_GIRO_FW_YA_GIRO_PCT, falta_ms);
    }
}

/* Si el firmware no contesta en su tiempo máximo más el margen, antes de repetir el giro por tiempo se pregunta cuánto giró (IMU?). */
static void giro_fw_vigilar(Navegador *nav, uint32_t ahora_ms)
{
    int grados = (nav->giro_fw_grados < 0) ? -nav->giro_fw_grados : nav->giro_fw_grados;
    uint32_t espera_max = (uint32_t)(NAV_GIRO_FW_BASE_MS + NAV_GIRO_FW_POR_GRADO_MS * grados + NAV_GIRO_FW_ESPERA_EXTRA_MS);

    if (!nav->giro_fw || nav->giro_fw_estado != 0) {
        return;
    }
    if (!nav->giro_fw_consultando) {
        if ((uint32_t)(ahora_ms - nav->giro_fw_t_ms) > espera_max) {
            if (!nav->giro_fw_ang_ini_ok) {   /* sin el ángulo del inicio no hay con qué comparar: se repite por tiempo como antes */
                giro_fw_pasar_a_tiempo(nav, "sin_respuesta_ni_angulo_inicial");
                return;
            }
            nav->giro_fw_consultando = 1;
            nav->giro_fw_consulta_pedir = 1;
            nav->giro_fw_consulta_t_ms = ahora_ms;
            diag_escribir(nav, "SENS_DIAG giro sin_GIRO_OK: se pregunta IMU? antes de repetirlo (angulo al inicio=%d)", nav->giro_fw_ang_ini_x10);
        }
        return;
    }
    if ((uint32_t)(ahora_ms - nav->giro_fw_consulta_t_ms) > (uint32_t)NAV_GIRO_FW_CONSULTA_MS) {
        if (nav->sens_angulo_ok && (uint32_t)(ahora_ms - nav->sens_angulo_t_ms) <= (uint32_t)NAV_TOF_FRESCO_MS) {
            giro_fw_resolver(nav, nav->sens_angulo_x10, "ultimo_SENS");
        } else {
            giro_fw_pasar_a_tiempo(nav, "sin_respuesta_ni_IMU");
        }
    }
}

/* El láser dice «libre» (varias lecturas seguidas y recientes) o «cerca» (una medida real menor de NAV_TOF_CONFIRMA_MM varias veces seguidas). */
static int tof_fresco(const Navegador *nav, uint32_t ahora_ms)
{
    return nav->usa_tof && nav->tof_vivo && (uint32_t)(ahora_ms - nav->tof_t_ms) <= (uint32_t)NAV_TOF_FRESCO_MS;
}

static int tof_dice_libre(const Navegador *nav, uint32_t ahora_ms)
{
    return tof_fresco(nav, ahora_ms) && nav->tof_libre_lecturas >= NAV_TOF_LIBRE_LECTURAS;
}

static int tof_dice_cerca(const Navegador *nav, uint32_t ahora_ms)
{
    return tof_fresco(nav, ahora_ms) && nav->tof_valida && nav->tof_mm > 0 &&
           nav->tof_mm <= NAV_REACCION_MAX_MM && nav->tof_cerca_lecturas >= NAV_TOF_LIBRE_LECTURAS;
}

static void extender_rebase(Navegador *nav, uint32_t ahora_ms);
static void entrar_detenido(Navegador *nav, uint32_t ahora_ms);

/* ── V2: rodeo medido con el láser ─────────────────────────────────────── */

static int valor_absoluto_int_v2(int x)
{
    return (x < 0) ? -x : x;
}

/* El rumbo del carro AHORA en décimas: durante un giro por ángulo el navegador solo conoce el final, pero SENS trae el ángulo del giroscopio cada 100 ms. */
static int rumbo_instantaneo_x10(const Navegador *nav, uint32_t ahora_ms)
{
    if (nav->giro_fw && nav->giro_fw_estado == 0 && nav->giro_fw_ang_ini_ok && nav->sens_angulo_ok &&
        (uint32_t)(ahora_ms - nav->sens_angulo_t_ms) <= (uint32_t)NAV_TOF_FRESCO_MS) {
        int girado = diferencia_x10(nav->giro_fw_ang_ini_x10, nav->sens_angulo_x10);   /* + izquierda, como el firmware */

        /* La distancia de SENS es la mediana de las 3 últimas lecturas del láser (una cada 33 ms): es unos 50 ms más vieja que el ángulo del mismo mensaje. Se usa el
         * ángulo de hace medio periodo de SENS (a 130 grados por segundo son ~6 grados). */
        girado -= diferencia_x10(nav->sens_angulo_previo_x10, nav->sens_angulo_x10) / 2;
        return nav->base_rumbo_x10 - girado;   /* el navegador cuenta + a la derecha */
    }
    return nav->rumbo_x10;
}

/* Dónde pega el láser (a `mm` del sensor) respecto de la línea de la ruta en el punto de salida del rodeo: `s` a lo largo de la ruta desde la salida y `lado` hacia el
 * lado por el que se rodea (negativo = del otro lado de la línea). */
static void laser_punto(const Navegador *nav, uint32_t ahora_ms, int mm, long *s, long *lado)
{
    int rumbo = rumbo_instantaneo_x10(nav, ahora_ms);
    long alcance = (long)NAV_SENSOR_FRENTE_MM + mm;
    long hx = nav->x_mm + dir_x_mil_x10(rumbo) * alcance / 1000 - nav->salida_x_mm;
    long hy = nav->y_mm + dir_y_mil_x10(rumbo) * alcance / 1000 - nav->salida_y_mm;
    int costado = nav->salida_rumbo + nav->lado * (nav->scan_signo < 0 ? -90 : 90);

    *s = (hx * dir_x_mil(nav->salida_rumbo) + hy * dir_y_mil(nav->salida_rumbo)) / 1000;
    *lado = (hx * dir_x_mil(costado) + hy * dir_y_mil(costado)) / 1000;
}

/* Distancia (mm, desde el centro del carro en la salida) a la cara del obstáculo que detuvo al carro. */
static int cara_desde_salida_mm(const Navegador *nav)
{
    int cara = nav->tof_dist_mm > 0 ? nav->tof_dist_mm : (nav->salida_cercania >= 3 ? NAV_CARA_CERCANIA_3_MM : NAV_CARA_CERCANIA_2_MM);

    return NAV_SENSOR_FRENTE_MM + cara;
}

/* Una lectura válida del láser durante el PRIMER giro del rodeo: si pega en la zona de la cara del obstáculo, dice hasta dónde llega hacia el lado del rodeo; si pega
 * antes de esa zona y bien de lado, hay algo (una pared) de ese lado. */
static void escaneo_muestra(Navegador *nav, uint32_t ahora_ms, int mm, int eco)
{
    long s = 0, lado = 0;
    int rumbo = rumbo_instantaneo_x10(nav, ahora_ms);
    int k = nav->scan_n;

    if (k >= NAV_ESCANEO_MAX) {
        return;
    }
    if (eco) {
        laser_punto(nav, ahora_ms, mm, &s, &lado);
        nav->scan_muestras++;
    }
    nav->scan_s[k] = (int)s;
    nav->scan_lado[k] = (int)lado;
    nav->scan_eco[k] = eco;
    nav->scan_grados[k] = valor_absoluto_int_v2(diferencia_x10(nav->salida_rumbo * 10, rumbo)) / 10;   /* cuánto se apartó el láser del frente */
    nav->scan_sensor_s[k] = (int)((((long)(nav->x_mm - nav->salida_x_mm) * dir_x_mil(nav->salida_rumbo) + (long)(nav->y_mm - nav->salida_y_mm) * dir_y_mil(nav->salida_rumbo)) +
                                   (long)NAV_SENSOR_FRENTE_MM * seno_mil_x10(rumbo - nav->salida_rumbo * 10 + 900)) / 1000);
    nav->scan_n++;
}

/* Al terminar el giro: de las lecturas, desde el frente hacia el costado, saca hasta dónde llega la cara del obstáculo (scan_ext_mm), si hay otra cosa de ese lado
 * (scan_pared_mm) y si el final de la cara NO se pudo comprobar (scan_corte). La cara es lo que se ve SEGUIDO desde el frente: sin huecos ni saltos de lado de más de
 * NAV_ESCANEO_SALTO_MM. Su final solo es de fiar si en la lectura siguiente el láser todavía habría alcanzado a verla (una pared se sale del alcance viéndose). */
static void escaneo_analizar(Navegador *nav, int desde_el_costado)
{
    int cara = cara_desde_salida_mm(nav);
    int i, vista = 0, terminada = 0, ultimo_grados = 0;

    nav->scan_ext_mm = nav->scan_pared_mm = nav->scan_corte = 0;
    for (i = 0; i < nav->scan_n; i++) {
        int k = desde_el_costado ? nav->scan_n - 1 - i : i;
        int en_cara = nav->scan_eco[k] && nav->scan_s[k] >= cara - 150 && nav->scan_s[k] <= cara + 400 && nav->scan_lado[k] <= nav->scan_ext_mm + NAV_ESCANEO_SALTO_MM;

        if (!terminada && en_cara) {
            vista = 1;
            ultimo_grados = nav->scan_grados[k];
            if (nav->scan_lado[k] > nav->scan_ext_mm) {
                nav->scan_ext_mm = nav->scan_lado[k];
            }
            continue;
        }
        if (vista && !terminada) {
            /* Primera lectura que ya no es de la cara: ¿el láser la habría visto si siguiera? Distancia a su plano con este ángulo MÁS una holgura (el ángulo de la
             * lectura tiene unos grados de error y un plano visto muy de lado devuelve poca señal: una pared deja de dar eco bastante antes del alcance nominal). */
            int g = nav->scan_grados[k] + NAV_ESCANEO_HOLGURA_GRADOS > 85 ? 85 : nav->scan_grados[k] + NAV_ESCANEO_HOLGURA_GRADOS;
            long esperado = (long)(cara - nav->scan_sensor_s[k]) * 1000 / (seno_mil(90 - g) > 50 ? seno_mil(90 - g) : 50);

            terminada = 1;
            if (esperado > NAV_ESCANEO_ALCANCE_UTIL_MM) {
                nav->scan_corte = 1;
            }
        }
        /* Otra cosa de ese lado (una pared): un eco bien de lado (más de 250 mm), o (revisión) uno antes de la zona de la cara, a más de medio carro de lado y AL LADO
         * del carro (en la banda por la que saldría): eso no es el obstáculo, es algo junto al carril (una pared a 23 cm se tomaba por lado «abierto» y el carro
         * avanzaba hacia ella). La pata de un mueble más adelante no cuenta aquí: el rodeo pasa a su lado. */
        if (nav->scan_eco[k] && (nav->scan_lado[k] > 250 || (nav->scan_lado[k] > NAV_ESCANEO_PARED_MIN_MM && nav->scan_s[k] < cara - 150 && nav->scan_s[k] < NAV_ESCANEO_AL_LADO_S_MM)) &&
            (nav->scan_pared_mm == 0 || nav->scan_lado[k] < nav->scan_pared_mm)) {
            nav->scan_pared_mm = nav->scan_lado[k];
        }
    }
    if (vista && !terminada && ultimo_grados < 80) {
        nav->scan_corte = 1;   /* el giro terminó viendo todavía la cara */
    }
    {   /* Las lecturas del barrido al registro (y a la caja negra): grados del frente, si hubo eco, y dónde pegó (a lo largo, de lado). */
        char texto[NAV_DIAG_LARGO - 40];
        int largo = 0;

        texto[0] = '\0';
        for (i = 0; i < nav->scan_n && largo < (int)sizeof texto - 24; i++) {
            int n = nav->scan_eco[i] ? snprintf(texto + largo, sizeof texto - (size_t)largo, " %d:%d,%d", nav->scan_grados[i], nav->scan_s[i], nav->scan_lado[i])
                                      : snprintf(texto + largo, sizeof texto - (size_t)largo, " %d:-", nav->scan_grados[i]);

            if (n < 0) {
                break;
            }
            largo += n;
        }
        diag_escribir(nav, "BARRIDO_DIAG cara=%d lecturas(grados:s,lado)=%s", cara, texto);
    }
}

/* Cuánto hay que avanzar en paralelo, desde un punto donde el costado del objeto todavía podía estar a la vista, para que el giro de regreso ya no lo alcance: a `c` mm
 * de lado la cámara solo ve el piso desde c / tan(FOV / 2) adelante de la lente. */
static int pista_tras_la_vista_mm(const Navegador *nav)
{
    int c = nav->lateral_objetivo_mm - nav->ancho_rodeo_mm;
    long tangente = (long)seno_mil(NAV_CAMARA_FOV_GRADOS / 2) * 1000 / seno_mil(NAV_CAMARA_FOV_GRADOS / 2 + 90);

    if (c < 150) {
        c = 150;
    }
    return (int)((long)c * 1000 / tangente) + NAV_CAMARA_ADELANTE_MM + NAV_PASO_VISTA_MARGEN_MM;
}

/* Una lectura sin eco no demuestra espacio libre. Esperar parado y con el
 * rumbo final evita reutilizar el haz que miraba al costado durante el giro. */
static int verificar_frente(Navegador *nav, uint32_t ahora_ms, int causa)
{
    if (!nav->verificando_frente) {
        nav->verificando_frente = 1;
        nav->verificar_frente_ms = ahora_ms;
        nav->tof_libre_lecturas = 0;
        nav->tof_despejado_lecturas = 0;
        nav->tof_cerca_lecturas = 0;
        nav->vision_sin_coincidencia = 0;
    }
    if (ahora_ms - nav->verificar_frente_ms < NAV_PAUSA_ASENTAR_MS) {
        nav->tof_libre_lecturas = 0;
        nav->tof_despejado_lecturas = 0;
        nav->vision_sin_coincidencia = 0;
        return 0;
    }
    /* V2: para cerrar un rodeo basta que el láser mida, con tres lecturas nuevas, que no hay nada a NAV_FIN_HOLGURA_MM o menos (antes exigía más de 800 mm: una pared o
     * un segundo obstáculo a 60 cm hacían «esquivar» algo que no estorba). Sin eco sigue sin contar como libre: ahí deciden cinco cuadros nuevos sin coincidencia. */
    if ((tof_fresco(nav, ahora_ms) && nav->tof_despejado_lecturas >= NAV_TOF_LIBRE_LECTURAS && (!nav->usa_camara || nav->vision_sin_coincidencia > 0)) ||
        ((!nav->usa_tof || (tof_fresco(nav, ahora_ms) && (!nav->tof_valida || nav->tof_mm <= 0))) &&
         nav->usa_camara && ahora_ms - nav->t_ultimo_cuadro_ms <= NAV_MAX_HUECO_VIDEO_MS &&
         nav->vision_sin_coincidencia >= NAV_VISION_LIBRE_CUADROS)) {
        nav->verificando_frente = 0;
        return 1;
    }
    /* V2: tres lecturas nuevas con algo CERCA y delante, ya sobre la línea y con el avance del rodeo cumplido: no es el objeto que se rodeó (ese quedó atrás por la
     * cuenta de distancia) sino otro. El rodeo se cierra y la ruta lo trata como obstáculo nuevo al retomarla (frena de inmediato: sigue confirmado por el láser). */
    if (causa == NAV_CAUSA_OBSTACULO_NO_PASADO && tof_dice_cerca(nav, ahora_ms)) {
        nav->verificando_frente = 0;
        diag_escribir(nav, "BORDE_DIAG obstaculo_nuevo_delante laser_mm=%d: se cierra el rodeo anterior", nav->tof_mm);
        return 1;
    }
    if (ahora_ms - nav->verificar_frente_ms >= NAV_VERIFICAR_FIN_MS) {
        nav->verificando_frente = nav->fin_pendiente = 0;
        if (nav->esquivadas_obstaculo >= NAV_MAX_ESQUIVADAS || nav->esquivadas >= NAV_MAX_ESQUIVADAS_RUTA) {
            ir_a_error_causa(nav, NAV_MOTIVO_MAX_ESQUIVADAS, NAV_CAUSA_MAX_ESQUIVADAS);
        } else if (nav->obstaculo_pendiente && causa == NAV_CAUSA_OBSTACULO_NO_PASADO) {
            extender_rebase(nav, ahora_ms);
        } else {
            nav->cierre_reintento = 1;
            entrar_detenido(nav, ahora_ms);
        }
    }
    return 0;
}

/* TOF_PARO: el obstáculo está al frente a `mm` mm, de cercanía 3, y no se sabe nada de los lados. */
static void tof_marcar(Navegador *nav, int mm)
{
    nav->tof_paro_activo = 1;
    nav->tof_dist_mm = mm;
    nav->zona_hay[ZONA_CENTRO] = 1;
    nav->zona_frena[ZONA_CENTRO] = 1;
    nav->zona_cerc_frena[ZONA_CENTRO] = 3;
    nav->zona_cercania[ZONA_CENTRO] = 3;
}
/* ── La línea de la ruta (para volver a ella) ──────────────────────────── */

/* La ruta como línea quebrada: el tramo k va del punto k al punto k+1 (en mm). */
static long punto_ruta_x(const Navegador *nav, int i)
{
    return (long)nav->ruta[i].columna * MM_POR_CELDA;
}

static long punto_ruta_y(const Navegador *nav, int i)
{
    return (long)nav->ruta[i].fila * MM_POR_CELDA;
}

static long largo_tramo(const Navegador *nav, int k)
{
    long dx = punto_ruta_x(nav, k + 1) - punto_ruta_x(nav, k);
    long dy = punto_ruta_y(nav, k + 1) - punto_ruta_y(nav, k);

    return raiz_entera(dx * dx + dy * dy);
}

/* Rumbo de la línea en el tramo k (0, 45, 90... según la ruta). */
static int rumbo_del_tramo(const Navegador *nav, int k)
{
    return rumbo_del_vector(punto_ruta_x(nav, k + 1) - punto_ruta_x(nav, k), punto_ruta_y(nav, k + 1) - punto_ruta_y(nav, k), 0);
}

/* Distancia recorrida a lo largo de la ruta hasta el comienzo del tramo k. */
static long distancia_hasta_tramo(const Navegador *nav, int k)
{
    long total = 0;
    int i;

    for (i = 0; i < k; i++) {
        total += largo_tramo(nav, i);
    }
    return total;
}

/* Dónde cae el punto (x, y) sobre la ruta: el tramo más cercano de los vecinos al tramo actual (el carro va del punto indice_objetivo-1 al
 * indice_objetivo), cuánto se ha avanzado a lo largo de la ruta (`s_mm`) y a cuánto está de la línea (`desvio_mm`). Con un solo punto no hay línea. */
static void ubicar_en_linea(const Navegador *nav, long x, long y, int *tramo, long *s_mm, long *desvio_mm)
{
    int k0 = (nav->tramo_base > nav->indice_objetivo - 1) ? nav->tramo_base : nav->indice_objetivo - 1;
    int desde = k0 - 1, hasta = k0 + NAV_VENTANA_TRAMOS, k;
    long mejor_desvio = -1;

    if (desde < 0) {
        desde = 0;
    }
    if (hasta > nav->n_puntos - 2) {
        hasta = nav->n_puntos - 2;
    }
    if (desde > hasta) {
        desde = hasta;
    }
    *tramo = (hasta < 0) ? 0 : desde;
    *s_mm = 0;
    *desvio_mm = 0;
    for (k = desde; k <= hasta; k++) {
        long ax = punto_ruta_x(nav, k), ay = punto_ruta_y(nav, k);
        long vx = punto_ruta_x(nav, k + 1) - ax, vy = punto_ruta_y(nav, k + 1) - ay;
        long largo = raiz_entera(vx * vx + vy * vy);
        long t, cx, cy, dx, dy, desvio;

        if (largo <= 0) {
            continue;
        }
        t = ((x - ax) * vx + (y - ay) * vy) / largo;     /* cuánto a lo largo del tramo cae el punto */
        t = (t < 0) ? 0 : ((t > largo) ? largo : t);
        cx = ax + vx * t / largo;
        cy = ay + vy * t / largo;
        dx = x - cx;
        dy = y - cy;
        desvio = raiz_entera(dx * dx + dy * dy);
        if (mejor_desvio < 0 || desvio < mejor_desvio) {
            mejor_desvio = desvio;
            *tramo = k;
            *s_mm = distancia_hasta_tramo(nav, k) + t;
            *desvio_mm = desvio;
        }
    }
}

/* El punto de la ruta a `s_mm` de distancia desde su inicio (si se pasa del final, el último punto). Devuelve en *tramo el tramo donde cae. */
static void punto_en_linea(const Navegador *nav, long s_mm, long *x, long *y, int *tramo)
{
    int k;
    long resto = s_mm;

    for (k = 0; k < nav->n_puntos - 1; k++) {
        long largo = largo_tramo(nav, k);

        if (resto <= largo || k == nav->n_puntos - 2) {
            long ax = punto_ruta_x(nav, k), ay = punto_ruta_y(nav, k);

            if (resto > largo) {
                resto = largo;
            }
            *x = (largo > 0) ? ax + (punto_ruta_x(nav, k + 1) - ax) * resto / largo : ax;
            *y = (largo > 0) ? ay + (punto_ruta_y(nav, k + 1) - ay) * resto / largo : ay;
            *tramo = k;
            return;
        }
        resto -= largo;
    }
    *x = punto_ruta_x(nav, 0);
    *y = punto_ruta_y(nav, 0);
    *tramo = 0;
}

/* ── Planificación ─────────────────────────────────────────────────────── */

/* El navegador planifica de un punto de la ruta al siguiente. Si el carro YA va avanzando y el tramo
 * nuevo sigue en línea recta, no hay que esperar otro arranque; y si el tramo siguiente también sigue
 * recto, el carro no frena aquí (no se descuenta el frenado). Esta función corrige los tiempos de los
 * pasos AVANZAR de ese tramo con cal_cm_a_ms_tramo. `camino` son las celdas del tramo. */
static void ajustar_tramos_continuos(Navegador *nav, const Punto *camino, int n)
{
    int continua = (nav->cmd_actual == NAV_CMD_FORWARD && nav->n_pasos > 0 && nav->pasos[0].tipo == PASO_AVANZAR);
    int sigue_recto = 0;
    int i, ultimo = nav->n_pasos - 1;

    if (n >= 2 && nav->indice_objetivo + 1 < nav->n_puntos) {
        const Punto *a = &nav->ruta[nav->indice_objetivo];
        const Punto *b = &nav->ruta[nav->indice_objetivo + 1];

        sigue_recto = (signo(camino[n - 1].columna - camino[n - 2].columna) == signo(b->columna - a->columna) &&
                       signo(camino[n - 1].fila - camino[n - 2].fila) == signo(b->fila - a->fila));
    }
    for (i = 0; i < nav->n_pasos; i++) {
        if (nav->pasos[i].tipo == PASO_AVANZAR) {
            nav->pasos[i].tiempo_ms = cal_cm_a_ms_tramo(&nav->cal, nav->pasos[i].valor,
                                                        !(i == 0 && continua), !(i == ultimo && sigue_recto));
        }
    }
    if (continua) {
        nav->seg_ms = nav->cal.arranque_ms;   /* el arranque ya pasó: el tiempo cuenta como movimiento */
    }
}

#define NAV_LAT_TOL_MM              25   /* si tras el giro paralelo al tramo el carro queda a menos de esto de la recta, se usa ese giro de siempre */
#define NAV_LAT_PLAN_MAX_MM        (2 * MM_POR_CELDA)   /* distancia máxima a la recta con la que todavía se planea apuntando (un giro de 180° con pivote de 20 cm desplaza hasta 40 cm) */
#define NAV_MAX_CORR_RUMBO_VERTICE   2   /* tope de giros de corrección de rumbo (más de 4°) por vértice de la ruta */
#define NAV_TRAMO_APUNTAR_CELDAS     3   /* solo los tramos rectos de al menos 3 celdas (60 cm) se planean apuntando: en uno más corto un giro de pivote no se puede compensar de lado */

/* Con el giro `giro` (grados, con signo; de 4° o menos no se gira) desde la pose estimada: a cuántos mm del punto (tx, ty) pasaría el carro si luego avanza recto. *ok = 1 si el punto
 * queda por delante. */
static long lateral_apuntando(const Navegador *nav, int giro, long tx, long ty, int *ok)
{
    PoseCarro p;
    long ux, uy, a_lo_largo, lateral;

    p.x_mm = nav->x_mm;
    p.y_mm = nav->y_mm;
    p.rumbo_grados = nav->rumbo_grados;
    if (giro < -4 || giro > 4) {
        cal_pose_tras_giro(&nav->cal, &p, (giro < 0) ? CAL_LADO_IZQUIERDA : CAL_LADO_DERECHA, (giro < 0) ? -giro : giro, &p);
    }
    ux = dir_x_mil(p.rumbo_grados);
    uy = dir_y_mil(p.rumbo_grados);
    a_lo_largo = ((tx - p.x_mm) * ux + (ty - p.y_mm) * uy) / 1000;
    lateral = valor_absoluto_largo(((tx - p.x_mm) * (-uy) + (ty - p.y_mm) * ux) / 1000);
    *ok = (a_lo_largo > 0);
    return lateral;
}

/* Calcula los pasos hacia el punto de la ruta al que se dirige (indice_objetivo), sin sobrescribir el rumbo real (si difiere más de 4° del tramo, lo corrige con un giro)
 * y compensando el desplazamiento del giro de pivote en los tramos de toda la ruta. */
static int planificar(Navegador *nav)
{
    Punto camino[MAX_PUNTOS];
    const Punto *meta = &nav->ruta[nav->indice_objetivo];
    int orientacion, columna, fila, n, indice_error;
    int k = nav->indice_objetivo;

    if (nav->cmd_actual != NAV_CMD_STOP) {
        registrar_fin_comando(nav);   /* el comando sigue (avanzar al siguiente punto sin parar), pero se cierra el registro del tramo que terminó */
    }
    fijar_pose(nav);
    nav->frenado_pendiente = 0;

    nav->paso_en_linea = 0;
    if (nav->override_largo_mm > 0 && nav->indice_objetivo > 1) {
        /* Recta con largo fijo (J14). J16: antes se terminaba en CUALQUIER plan con índice mayor que 1, también al volver de esquivar a mitad de la recta (terminaba
         * sin haber llegado). Ahora solo si ya está a NAV_OVERRIDE_TOL_MM o menos del largo pedido, medido a lo largo de la ruta; si no, sigue (el avance se recorta
         * más abajo para no pasarse). */
        int tramo_ov;
        long s_ov, desvio_ov;

        ubicar_en_linea(nav, nav->x_mm, nav->y_mm, &tramo_ov, &s_ov, &desvio_ov);
        if (nav->cmd_actual == NAV_CMD_FORWARD) {
            s_ov += nav->cal.frenado_mm;   /* el avance todavía no frenó: lo que siga al soltarlo ya cuenta */
        }
        if (s_ov + NAV_OVERRIDE_TOL_MM >= nav->override_largo_mm) {
            nav->n_pasos = 0;
            nav->indice_objetivo = nav->n_puntos;
            nav->estado = NAV_TERMINADO;
            return NAV_OK;
        }
        while (nav->indice_objetivo < nav->n_puntos - 1 && distancia_hasta_tramo(nav, nav->indice_objetivo) <= s_ov) {
            nav->indice_objetivo++;   /* nunca se planea hacia un punto de la recta que ya quedó atrás */
        }
        k = nav->indice_objetivo;
        meta = &nav->ruta[k];
    }

    if (!nav->sin_compensar_giro && k >= 1 && k < nav->n_puntos) {
        int rumbo_tramo = rumbo_del_tramo(nav, k - 1);
        int u1x = dir_x_mil(rumbo_tramo), u1y = dir_y_mil(rumbo_tramo);
        long kx = punto_ruta_x(nav, k), ky = punto_ruta_y(nav, k);
        long dist_actual = ((kx - nav->x_mm) * (long)u1x + (ky - nav->y_mm) * (long)u1y) / 1000;
        long lat_actual = valor_absoluto_largo(((kx - nav->x_mm) * (long)(-u1y) + (ky - nav->y_mm) * (long)u1x) / 1000);
        int celdas_del_tramo = 1, j_tramo;   /* celdas del tramo recto completo que contiene este paso */
        int limite_lateral;

        for (j_tramo = k - 1; j_tramo >= 1 && rumbo_del_tramo(nav, j_tramo - 1) == rumbo_tramo; j_tramo--) {
            celdas_del_tramo++;
        }
        for (j_tramo = k; j_tramo + 1 < nav->n_puntos && rumbo_del_tramo(nav, j_tramo) == rumbo_tramo; j_tramo++) {
            celdas_del_tramo++;
        }
        limite_lateral = (celdas_del_tramo >= NAV_TRAMO_APUNTAR_CELDAS) ? NAV_LAT_PLAN_MAX_MM : MM_POR_CELDA;   /* los tramos cortos siguen con el límite de siempre */

        if (dist_actual >= -MM_POR_CELDA / 2 && lat_actual <= limite_lateral) {
            int k_esq = k;
            long d_antes = 0;
            int giro = giro_minimo(nav->rumbo_grados, rumbo_tramo);
            int apunta = 0, uhx = u1x, uhy = u1y;
            PoseCarro p_ini;
            long ex, ey, dist_esq, dist_k, avance_mm, tx, ty;
            int cm, continua, sigue_recto, hasta_el_largo = 0;

            while (k_esq + 1 < nav->n_puntos && rumbo_del_tramo(nav, k_esq) == rumbo_tramo) {
                k_esq++;
            }
            if (k_esq + 1 < nav->n_puntos) {
                int rumbo_sig = rumbo_del_tramo(nav, k_esq);
                int u2x = dir_x_mil(rumbo_sig), u2y = dir_y_mil(rumbo_sig);
                int giro_esq = giro_minimo(rumbo_tramo, rumbo_sig);
                int lado_esq = (giro_esq < 0) ? CAL_LADO_IZQUIERDA : CAL_LADO_DERECHA;
                int grados_esq = (giro_esq < 0) ? -giro_esq : giro_esq;
                int dx_esq = 0, dy_esq = 0;
                long det = (long)u1x * u2y - (long)u1y * u2x;

                cal_desplazamiento_giro(&nav->cal, lado_esq, grados_esq, rumbo_tramo, &dx_esq, &dy_esq, NULL, NULL);
                if (det != 0) {
                    d_antes = ((long)dx_esq * u2y - (long)dy_esq * u2x) * 1000 / det;
                }
            }
            ex = punto_ruta_x(nav, k_esq);
            ey = punto_ruta_y(nav, k_esq);
            tx = ex - d_antes * (long)u1x / 1000;   /* el punto de la recta donde hay que parar para que el giro de la esquina deje al carro en el vértice */
            ty = ey - d_antes * (long)u1y / 1000;
            /* Un giro de pivote desplaza el centro del carro hacia un lado (hasta 2 x el radio en un giro de 180°). Si tras el giro "paralelo al tramo" el carro queda fuera de la recta, avanzar en paralelo
             * nunca lo corrige: se elige el giro que deja al carro APUNTANDO al punto de parada (entre 6 y 20 cm de radio, esto era el peor error de las rutas en L). Con el carro sobre la recta
             * (lo de siempre: rectas y esquives) el giro es el de antes, sin cambios. */
            {
                int lat_ok = 0;
                long lat_nominal = lateral_apuntando(nav, giro, tx, ty, &lat_ok);

                /* Solo se apunta tras un giro grande de verdad (45° o más: ahí el desplazamiento de pivote es de decenas de cm) o mientras se sigue en el tramo que ya se venía apuntando. Un empujón o
                 * una vuelta de esquive con el rumbo casi igual al del tramo no entran aquí: se planean como siempre. */
                int giro_grande = (giro >= 45 || giro <= -45);

                if (celdas_del_tramo >= NAV_TRAMO_APUNTAR_CELDAS && (giro_grande || nav->apunte_k_esq == k_esq) && (!lat_ok || lat_nominal > NAV_LAT_TOL_MM)) {   /* en un tramo corto no hay espacio para corregir de lado: se queda como antes */
                    int g, mejor_g = giro, hay = 0;
                    long mejor_cubo = 0;

                    for (g = -180; g <= 180; g++) {
                        int ok = 0;
                        long lat = lateral_apuntando(nav, g, tx, ty, &ok);
                        long cubo = lat / 10;
                        int ag = (g < 0) ? -g : g;

                        if (!ok) {
                            continue;
                        }
                        if (!hay || cubo < mejor_cubo || (cubo == mejor_cubo && ag < ((mejor_g < 0) ? -mejor_g : mejor_g))) {
                            hay = 1;
                            mejor_cubo = cubo;
                            mejor_g = g;
                        }
                    }
                    if (hay && lat_nominal / 10 > mejor_cubo) {
                        giro = mejor_g;
                        apunta = 1;
                        nav->apunte_k_esq = k_esq;
                    }
                }
            }
            /* J16: con el firmware sosteniendo el rumbo (RUMBO), un error de rumbo de hasta NAV_RUMBO_FW_SIN_GIRO grados se corrige AVANZANDO (rumbo_fw_actualizar):
             * no hace falta el giro parado, que además mueve el centro por el pivote. Los giros de la ruta (45° o más) no cambian. */
            {
                /* V2: en pleno vistazo (o recién terminado) el carro va torcido a propósito: eso lo deshace el mismo control de rumbo, no un giro parado. */
                int sin_giro = NAV_RUMBO_FW_SIN_GIRO;

                if (nav->vistazo_lado != 0 || (nav->vistazo_alguno && (uint32_t)(nav->t_ultimo_ms - nav->vistazo_fin_ms) < (uint32_t)NAV_VISTAZO_VUELTA_MS)) {
                    sin_giro = NAV_VISTAZO_GRADOS_MAX + 8;
                }
                if (rumbo_fw_activo(nav) && !apunta && giro >= -sin_giro && giro <= sin_giro) {
                    giro = 0;
                }
            }
            /* Tope de NAV_MAX_CORR_RUMBO_VERTICE giros de corrección (más de 4°) por vértice: la corrección no puede entrar en bucle aunque se vuelva a planear el mismo vértice. */
            if (giro < -4 || giro > 4) {
                if (nav->corr_rumbo_vertice != k) {
                    nav->corr_rumbo_vertice = k;
                    nav->corr_rumbo_cuenta = 0;
                }
                if (nav->corr_rumbo_cuenta >= NAV_MAX_CORR_RUMBO_VERTICE) {
                    giro = 0;
                    apunta = 0;
                } else {
                    nav->corr_rumbo_cuenta++;
                }
            }
            p_ini.x_mm = nav->x_mm;
            p_ini.y_mm = nav->y_mm;
            p_ini.rumbo_grados = nav->rumbo_grados;
            nav->n_pasos = 0;
            nav->indice_paso = 0;
            nav->ms_paso = 0;
            nav->codigo_trayectoria = TRAY_OK;
            if ((giro < -4 || giro > 4)) {
                int lado_g = (giro < 0) ? CAL_LADO_IZQUIERDA : CAL_LADO_DERECHA;
                int grados_g = (giro < 0) ? -giro : giro;

                nav->pasos[nav->n_pasos].tipo = PASO_GIRAR;
                nav->pasos[nav->n_pasos].valor = giro;
                nav->pasos[nav->n_pasos].tiempo_ms = cal_grados_a_ms(&nav->cal, giro);
                nav->n_pasos++;
                cal_pose_tras_giro(&nav->cal, &p_ini, lado_g, grados_g, &p_ini);
            }
            if (apunta) {
                uhx = dir_x_mil(p_ini.rumbo_grados);
                uhy = dir_y_mil(p_ini.rumbo_grados);
                dist_esq = ((tx - p_ini.x_mm) * (long)uhx + (ty - p_ini.y_mm) * (long)uhy) / 1000;
            } else {
                dist_esq = ((ex - p_ini.x_mm) * (long)u1x + (ey - p_ini.y_mm) * (long)u1y) / 1000 - d_antes;
            }
            dist_k = ((kx - p_ini.x_mm) * (long)uhx + (ky - p_ini.y_mm) * (long)uhy) / 1000;
            avance_mm = (k == k_esq || dist_k > dist_esq) ? dist_esq : dist_k;
            continua = (nav->cmd_actual == NAV_CMD_FORWARD && nav->n_pasos == 0);
            if (nav->override_largo_mm > 0 && nav->indice_objetivo == 1 && !continua && !rumbo_medido_activo(nav)) {
                avance_mm = nav->override_largo_mm;   /* sin rumbo medido, un solo avance (J14); con él se planea por celdas como cualquier recta, así se corrige el rumbo en cada una */
            }
            if (nav->override_largo_mm > 0) {   /* J16: nunca más allá del largo fijo de la recta (también al volver de esquivar a mitad de camino) */
                int tramo_ov;
                long s_ov, desvio_ov;

                ubicar_en_linea(nav, p_ini.x_mm, p_ini.y_mm, &tramo_ov, &s_ov, &desvio_ov);
                if (avance_mm + 5 >= nav->override_largo_mm - s_ov) {
                    avance_mm = nav->override_largo_mm - s_ov;
                    hasta_el_largo = 1;   /* este avance termina la recta: frena ahí */
                }
            }
            {   /* J16: la línea que sigue este avance, para que rumbo_fw_actualizar sepa a dónde volver mientras avanza. El final que cuenta es el de la RECTA (el punto
                 * de parada antes de la esquina, o el largo fijo), no el de este paso: en una recta de varias celdas el carro sigue de largo de una celda a otra. */
                long fin_x = p_ini.x_mm + avance_mm * uhx / 1000, fin_y = p_ini.y_mm + avance_mm * uhy / 1000;
                long fin_recta;

                nav->paso_en_linea = 1;
                nav->paso_apunta = apunta;
                nav->paso_fin_x_mm = (int)fin_x;
                nav->paso_fin_y_mm = (int)fin_y;
                nav->linea_ax_mm = (int)punto_ruta_x(nav, k - 1);
                nav->linea_ay_mm = (int)punto_ruta_y(nav, k - 1);
                nav->linea_rumbo = rumbo_tramo;
                fin_recta = ((tx - nav->linea_ax_mm) * (long)u1x + (ty - nav->linea_ay_mm) * (long)u1y) / 1000;
                if (nav->override_largo_mm > 0 && fin_recta > nav->override_largo_mm - distancia_hasta_tramo(nav, k - 1)) {
                    fin_recta = nav->override_largo_mm - distancia_hasta_tramo(nav, k - 1);
                }
                nav->linea_fin_s_mm = (int)fin_recta;
            }
            cm = (int)((avance_mm + 5) / 10);
            sigue_recto = (k < k_esq && dist_esq - avance_mm >= 10 && !hasta_el_largo);
            if (cm > 0) {
                nav->pasos[nav->n_pasos].tipo = PASO_AVANZAR;
                nav->pasos[nav->n_pasos].valor = cm;
                nav->pasos[nav->n_pasos].tiempo_ms = cal_cm_a_ms_tramo(&nav->cal, cm, !continua, !sigue_recto);
                nav->n_pasos++;
            }
            if (continua && nav->n_pasos > 0) {
                nav->seg_ms = nav->cal.arranque_ms;
            }
            if (nav->cmd_actual != NAV_CMD_STOP) {
                if (nav->n_pasos > 0 && nav->cmd_actual == comando_de_paso(&nav->pasos[0])) {
                    registrar_inicio_comando(nav, nav->cmd_actual);
                } else {
                    nav->cmd_plan_ms = -1;
                }
            }
            return NAV_OK;
        }
    }

    orientacion = indice_direccion(nav->rumbo_grados);
    if (nav->sin_compensar_giro) {
        nav->rumbo_grados = orientacion * 45;
        nav->base_rumbo_grados = nav->rumbo_grados;
        nav->rumbo_x10 = nav->base_rumbo_x10 = nav->rumbo_grados * 10;
    }

    columna = celda_mas_cercana(nav->x_mm);
    fila = celda_mas_cercana(nav->y_mm);
    camino[0].columna = columna;
    camino[0].fila = fila;
    n = 1;
    while (columna != meta->columna || fila != meta->fila) {
        if (n >= MAX_PUNTOS) {
            nav->n_pasos = 0;
            return NAV_ERR_RUTA;
        }
        columna += signo(meta->columna - columna);
        fila += signo(meta->fila - fila);
        camino[n].columna = columna;
        camino[n].fila = fila;
        n++;
    }

    nav->codigo_trayectoria = trayectoria_calcular_desde_cal(&nav->cal, orientacion, camino, n,
                                                              nav->pasos, MAX_PASOS, &nav->n_pasos, &indice_error);
    nav->indice_paso = 0;
    nav->ms_paso = 0;
    if (nav->codigo_trayectoria != TRAY_OK) {
        nav->n_pasos = 0;
        return NAV_ERR_RUTA;
    }
    ajustar_tramos_continuos(nav, camino, n);
    if (nav->cmd_actual != NAV_CMD_STOP) {
        if (nav->n_pasos > 0 && nav->cmd_actual == comando_de_paso(&nav->pasos[0])) {
            registrar_inicio_comando(nav, nav->cmd_actual);   /* el comando sigue: empieza el registro del tramo nuevo */
        } else {
            nav->cmd_plan_ms = -1;                            /* el comando se va a soltar: su registro ya se cerró arriba */
        }
    }
    return NAV_OK;
}

/* ── Registro OBS_DIAG y frenos anti-locura (J9) ──────────────────────────────────────────────────────────────────────────────────────────── */

/* Una línea OBS_DIAG en cada decisión de obstáculo y al arrancar: la máscara de 10 x 10 (hexadecimal) de lo que se ve en cada zona, la cercanía y las celdas de cada zona, y si la franja
 * de referencia está tapada (y en qué % de los últimos cuadros). Solo números. `ignorado` dice qué zonas se ignoran como «sospechoso fijo» (izquierda, centro, derecha). */
static void diag_obs(Navegador *nav, const char *evento)
{
    diag_escribir(nav, "OBS_DIAG evento=%s mascara_izq=%s mascara_cen=%s mascara_der=%s cercania=(%d,%d,%d) celdas=(%d,%d,%d) franja_tapada=%d franja_pct=%d ignorado=%d%d%d iguales=%d",
                  evento, nav->obs_hex[ZONA_IZQUIERDA], nav->obs_hex[ZONA_CENTRO], nav->obs_hex[ZONA_DERECHA],
                  nav->zona_cercania[ZONA_IZQUIERDA], nav->zona_cercania[ZONA_CENTRO], nav->zona_cercania[ZONA_DERECHA],
                  nav->zona_celdas[ZONA_IZQUIERDA], nav->zona_celdas[ZONA_CENTRO], nav->zona_celdas[ZONA_DERECHA],
                  nav->obs_franja_tapada, nav->obs_franja_pct, nav->fijo_ignorar[ZONA_IZQUIERDA], nav->fijo_ignorar[ZONA_CENTRO], nav->fijo_ignorar[ZONA_DERECHA], nav->arranque_iguales);
}

/* Freno anti-locura: para y pide AYUDA (o ERROR si no se pidió) con la causa. */
static void frenar_por_locura(Navegador *nav, int causa, const char *que)
{
    diag_escribir(nav, "AYUDA_DIAG freno_anti_locura causa=%d %s pose=(%d,%d,%d) recorrido_mm=%ld ruta_mm=%ld indice=%d esquivadas=%d", causa, que, nav->x_mm, nav->y_mm, nav->rumbo_grados,
                  nav->recorrido_mm, nav->ruta_largo_mm, nav->indice_objetivo, nav->esquivadas);
    ir_a_error_causa(nav, NAV_MOTIVO_ESQUIVANDO, causa);
}

/* El mayor giro (grados) de los pasos planeados que NO está en la ruta: pasa del límite NAV_LOCURA_GIRO_MAX (o del mayor giro que pide la propia ruta). 0 si no hay. */
static int giro_fuera_de_ruta(const Navegador *nav)
{
    int i, limite = (nav->max_giro_ruta > NAV_LOCURA_GIRO_MAX) ? nav->max_giro_ruta : NAV_LOCURA_GIRO_MAX;

    for (i = 0; i < nav->n_pasos; i++) {
        if (nav->pasos[i].tipo == PASO_GIRAR) {
            int g = (nav->pasos[i].valor < 0) ? -nav->pasos[i].valor : nav->pasos[i].valor;

            if (g > limite) {
                return g;
            }
        }
    }
    return 0;
}

/* Cada tick: ¿el carro se está volviendo loco? Índice de la ruta que retrocede, distancia recorrida de más de 2.5 veces la de la ruta o pose a más de 1 m de la ruta. (Los giros planeados de
 * más de 150 grados se revisan donde se planean: la vuelta a la línea y la ruta que se retoma después; y las esquivadas de más de NAV_MAX_ESQUIVADAS, donde ya se contaban.) */
static void revisar_frenos(Navegador *nav)
{
    long limite, s, desvio;
    int tramo;

    if (nav->estado != NAV_SIGUIENDO && nav->estado != NAV_DETENIDO_OBSTACULO && nav->estado != NAV_ESQUIVANDO && nav->estado != NAV_REINCORPORANDO) {
        return;
    }
    if (nav->indice_objetivo > nav->indice_max) {
        nav->indice_max = nav->indice_objetivo;
    } else if (nav->indice_objetivo < nav->indice_max) {
        frenar_por_locura(nav, NAV_CAUSA_INDICE, "indice_retrocede");
        return;
    }
    limite = ((nav->ruta_largo_mm > NAV_LOCURA_RECORRIDO_MIN_MM) ? nav->ruta_largo_mm : NAV_LOCURA_RECORRIDO_MIN_MM) * NAV_LOCURA_RECORRIDO_X10 / 10;
    if (nav->recorrido_mm > limite) {
        frenar_por_locura(nav, NAV_CAUSA_RECORRIDO, "recorrido_de_mas");
        return;
    }
    if (nav->n_puntos >= 2) {
        ubicar_en_linea(nav, nav->x_mm, nav->y_mm, &tramo, &s, &desvio);
        if (desvio > NAV_LOCURA_DESVIO_MM) {
            frenar_por_locura(nav, NAV_CAUSA_LEJOS, "lejos_de_la_ruta");
        }
    }
}

/* ── Configuración ─────────────────────────────────────────────────────── */

void navegador_iniciar(Navegador *nav)
{
    int z;

    if (nav == NULL) {
        return;
    }
    cal_defecto(&nav->cal);
    nav->latencia_visual_ms = 0;
    nav->frenar_lejos_centro = 0;
    nav->autoridad_laser = 0;
    nav->contradiccion_laser = 0;
    nav->solo_lejos_centro = 0;
    nav->n_puntos = 0;
    nav->indice_objetivo = 0;
    nav->n_pasos = 0;
    nav->indice_paso = 0;
    nav->ms_paso = 0;
    nav->estado = NAV_ESPERANDO;
    nav->motivo_error = NAV_MOTIVO_NINGUNO;
    nav->codigo_trayectoria = TRAY_OK;
    nav->cmd_actual = NAV_CMD_STOP;
    nav->t_ultimo_ms = 0;
    nav->t_detenido_ms = 0;
    nav->asentando = 0;
    nav->asentar_hasta_ms = 0;
    nav->usa_camara = 0;
    nav->t_ultimo_cuadro_ms = 0;
    nav->x_mm = nav->y_mm = nav->rumbo_grados = 0;
    nav->base_x_mm = nav->base_y_mm = nav->base_rumbo_grados = 0;
    nav->rumbo_x10 = nav->base_rumbo_x10 = 0;
    nav->sin_rumbo_medido = 0;
    nav->avance_imu_ref_ok = nav->avance_imu_ref_x10 = nav->avance_rumbo_ref_x10 = 0;
    nav->avance_rumbo_x10 = nav->avance_mm_previo = 0;
    nav->avance_x_mil = nav->avance_y_mil = 0;
    nav->seg_ms = 0;
    nav->giro_visual_x10 = 0;
    nav->visual_cubierto_ms = 0;
    for (z = 0; z < OBS_ZONAS; z++) {
        nav->zona_hay[z] = 0;
        nav->zona_cercania[z] = 0;
    }
    nav->frames_bloqueado = 0;
    nav->frames_libre = 0;
    nav->frames_recibidos = 0;
    nav->t_bloqueo_ms = 0;
    nav->t_libre_ms = 0;
    nav->bloqueo_inmediato = 0;
    nav->bloqueo_cerc3 = 0;
    for (z = 0; z < OBS_ZONAS; z++) {
        nav->zona_celdas[z] = 0;
        nav->zona_frena[z] = 0;
        nav->zona_cerc_frena[z] = 0;
        nav->zona_en_corredor[z] = 0;
    }
    nav->esquivadas = 0;
    nav->lado = -1;
    nav->fase = NAV_FASE_GIRAR;
    nav->ms_fase = 0;
    nav->reintentos = 0;
    nav->angulo_giro = NAV_ANGULO_ESQUIVAR;
    nav->angulo_total = 0;
    nav->t_mirar_ms = 0;
    nav->error_causa = NAV_CAUSA_NINGUNA;
    nav->esq_en_giro = 0;
    nav->esq_t_giro_ini_ms = nav->esq_t_giro_fin_ms = 0;
    nav->esq_cuadros_tras_giro = NAV_ESQ_CUADROS_ESTABLES;
    nav->centro_frames = 0;
    nav->centro_t_ms = 0;
    for (z = 0; z < OBS_ZONAS; z++) {
        nav->zona_fila_min[z] = nav->zona_fila_max[z] = nav->zona_col_min[z] = nav->zona_col_max[z] = -1;
    }
    nav->pedir_ayuda = 0;
    nav->ayuda_cmd = NAV_CMD_STOP;
    nav->ayuda_t_ini_ms = 0;
    nav->ayuda_motivo = NAV_MOTIVO_NINGUNO;
    nav->ayudas = 0;
    nav->desde_ayuda = 0;
    nav->salida_x_mm = nav->salida_y_mm = nav->salida_rumbo = 0;
    nav->salida_cercania = 0;
    nav->cerc_detenido_max = 0;
    nav->fin_obstaculo_mm = -1;
    nav->obstaculo_pendiente = nav->verificando_frente = nav->fin_pendiente = nav->fin_verificado = 0;
    memset(nav->fuentes_vision, 0, sizeof nav->fuentes_vision);
    nav->vision_sin_coincidencia = nav->precaucion = 0;
    nav->borde_reintentos = nav->fondo_observado_mm = nav->cara_obstaculo_s_mm = 0;
    nav->lateral_objetivo_mm = NAV_ESQ_MARGEN_LATERAL_MM;
    nav->lateral_tope_mm = NAV_BORDEAR_LATERAL_MAX;
    nav->mirada_fallida = nav->mirada_previa_fallida = 0;
    nav->cmd_previo = (int)NAV_CMD_STOP;
    nav->modelo_visto = nav->modelo_vigente = 0;
    nav->modelo_t_ok_ms = 0;
    nav->reinc_deshacer_mm = 0;
    nav->vistazo_retrocedio = nav->rodeo_por_vistazo = 0;
    nav->salida_linea_rumbo = nav->salida_linea_ok = 0;
    nav->vistazo_lado = nav->vistazo_ecos = nav->vistazo_mm = nav->vistazo_confirmado = nav->vistazos = nav->vistazos_con_eco = nav->giro_extra_grados = 0;
    memset(nav->coinc_seguidas, 0, sizeof nav->coinc_seguidas);
    nav->coinc_detenido = 0;
    nav->vistazo_cuadros[0] = nav->vistazo_cuadros[1] = nav->vistazo_hecho[0] = nav->vistazo_hecho[1] = 0;
    nav->vistazo_cerc[0] = nav->vistazo_cerc[1] = nav->vistazo_n[0] = nav->vistazo_n[1] = 0;
    nav->vistazo_fase = nav->vistazo_lateral_mm[0] = nav->vistazo_lateral_mm[1] = nav->vistazo_vacio[0] = nav->vistazo_vacio[1] = 0;
    nav->vistazo_solo_red[0] = nav->vistazo_solo_red[1] = nav->vistazo_red_hecho[0] = nav->vistazo_red_hecho[1] = 0;
    nav->vistazo_fase_ms = 0;
    nav->vistazo_grados_lado[0] = nav->vistazo_grados_lado[1] = nav->vistazo_grados = NAV_VISTAZO_GRADOS;
    nav->vistazo_t_ms = nav->vistazo_ultimo_ms[0] = nav->vistazo_ultimo_ms[1] = nav->vistazo_fin_ms = 0;
    nav->vistazo_alguno = 0;
    nav->extension_ruta_mm = nav->cierre_reintento = 0;
    nav->atras_conocido_mm = nav->escape_atras = 0;
    nav->precaucion_pausa_ms = 0;
    nav->verificar_frente_ms = 0;
    nav->requiere_camara = 0;
    nav->paralelo_mm = 0;
    nav->reinc_pasar_primero = 0;
    nav->reinc_plan_x_mm[0] = nav->reinc_plan_x_mm[1] = nav->reinc_plan_x_mm[2] = 0;
    nav->reinc_plan_y_mm[0] = nav->reinc_plan_y_mm[1] = nav->reinc_plan_y_mm[2] = 0;
    nav->reinc_correcciones = 0;
    nav->corr_rumbo_vertice = -1;
    nav->corr_rumbo_cuenta = 0;
    nav->apunte_k_esq = -1;
    nav->reinc_rumbo_importa = 1;
    nav->tramo_mm = NAV_TRAMO_ESQUIVAR_CM * 10;
    nav->sin_red_seguridad = 0;
    nav->sin_arreglo_indice = 0;
    nav->reinc_rumbo_tol = NAV_REINC_GIRO_MIN_GRADOS - 1;
    nav->usa_giroscopio = 0;                 /* J11: por defecto todo como antes (giros por tiempo, sin láser) */
    nav->usa_tof = 0;
    nav->giro_fw_caido = nav->giro_fw = nav->giro_fw_estado = nav->giro_fw_pedir = 0;
    nav->giro_fw_min = NAV_GIRO_FW_MIN_GRADOS;
    nav->giro_fw_fallos = 0;
    nav->scan_ext_mm = nav->scan_pared_mm = nav->scan_muestras = nav->scan_corte = nav->scan_n = nav->ancho_rodeo_mm = 0;
    nav->lados_probados = nav->cambio_lado = 0;
    nav->deshacer_giro = 0;
    nav->otro_lado_libre = nav->atras_al_salir_mm = 0;
    nav->pasar_s_mm = -1;
    nav->pasar_sin_avance = 0;
    nav->precaucion_modo = NAV_PRECAUCION_NUNCA;   /* (revisión) explícitos: antes dependían de que la estructura llegara en ceros */
    nav->vistazo_modo_mas1 = 0;                    /* 0 = sin fijar: vale NAV_VISTAZO_POR_DEFECTO */
    nav->scan_signo = 1;
    nav->tramo_base = 0;
    nav->retroceso_mm = NAV_RETROCESO_CM * 10;
    nav->borde_lejos[0] = nav->borde_lejos[1] = 0;
    nav->flanco_s_mm = 0;
    nav->flanco_vistas = 0;
    nav->flanco_otro = 0;
    nav->esquive_decidido = 0;
    nav->coinc_esquivar_min = 0;
    nav->esquivadas_obstaculo = 0;
    nav->tof_despejado_lecturas = 0;
    nav->fin_delante_mm = 0;
    nav->giro_fw_grados = nav->giro_fw_real_x10 = nav->giro_fw_ms = nav->giro_fw_ant = 0;
    nav->giro_fw_t_ms = 0;
    nav->n_giros_angulo = nav->n_giros_tiempo = 0;
    nav->giro_fw_ang_ini_x10 = nav->giro_fw_ang_ini_ok = nav->giro_fw_consultando = nav->giro_fw_consulta_pedir = 0;
    nav->giro_fw_consulta_t_ms = 0;
    nav->sens_angulo_x10 = nav->sens_angulo_ok = 0;
    nav->sens_angulo_t_ms = 0;
    nav->tof_vivo = nav->tof_mm = nav->tof_valida = nav->tof_libre_lecturas = nav->tof_cerca_lecturas = 0;
    nav->tof_t_ms = 0;
    nav->tof_paro_activo = nav->tof_pendiente = nav->tof_paros = nav->tof_dist_mm = 0;
    nav->racha_solo_centro2 = nav->tof_racha_nota = 0;
    nav->arranque_ok = 1;
    nav->arranque_iguales = nav->arranque_firma = 0;
    nav->arranque_t0_ms = 0;
    nav->bloqueo_cerc3 = 0;
    nav->sondeo_hecho = 1;
    nav->sondeo_fase = nav->sondeo_ms = nav->ms_sondeo = nav->sondeo_zonas = nav->sondeo_ref = nav->sondeo_n = 0;
    nav->sondeo_suma = 0;
    nav->sondeo_listo_ms = 0;
    for (z = 0; z < OBS_ZONAS; z++) {
        nav->fijo_ignorar[z] = 0;
        nav->fijo_celdas[z] = 0;
        memset(nav->fijo_hex[z], '0', MASC_HEX_LARGO);
        nav->fijo_hex[z][MASC_HEX_LARGO] = '\0';
        memset(nav->obs_hex[z], '0', MASC_HEX_LARGO);
        nav->obs_hex[z][MASC_HEX_LARGO] = '\0';
    }
    nav->frenado_pendiente = 0;
    nav->sin_compensar_giro = 0;
    nav->indice_max = 0;
    nav->recorrido_mm = 0;
    nav->prev_x_mm = nav->prev_y_mm = 0;
    nav->ruta_largo_mm = 0;
    nav->max_giro_ruta = 0;
    nav->obs_franja_tapada = nav->obs_franja_pct = 0;
    nav->arco_adelante_mm = nav->arco_libre_mm = 0;
    nav->reinc_fase = NAV_RF_PLAN;
    nav->reinc_t_fase_ms = 0;
    nav->reinc_solo_rumbo = 0;
    nav->reinc_obj_x_mm = nav->reinc_obj_y_mm = 0;
    nav->reinc_rumbo_final = 0;
    nav->reinc_giro1 = nav->reinc_giro2 = 0;
    nav->reinc_dist_mm = 0;
    nav->reinc_indice_obj = 0;
    nav->reinc_desvio_mm = 0;
    nav->reinc_antes_x_mm = nav->reinc_antes_y_mm = nav->reinc_antes_rumbo = 0;
    nav->volver_a_reinc = 0;
    nav->cmd_pedido = 0;
    nav->cmd_plan_ms = 0;
    nav->cmd_origen = NAV_ESPERANDO;
    nav->n_giros = 0;
    nav->giros_perdidos = 0;
    nav->diag_escritas = 0;
    nav->diag_leidas = 0;
    nav->diag_firma = -1;
    nav->diag_t_ms = 0;
    nav->diag[0][0] = '\0';
    nav->override_largo_mm = 0;
    nav->rumbo_fw = 0;
    nav->rumbo_fw_pedir = 0;
    nav->rumbo_fw_objetivo_x10 = nav->rumbo_fw_enviado_x10 = 0;
    nav->rumbo_fw_hay_enviado = 0;
    nav->rumbo_fw_t_ms = 0;
    nav->paso_en_linea = 0;
    nav->paso_apunta = nav->paso_fin_x_mm = nav->paso_fin_y_mm = 0;
    nav->linea_ax_mm = nav->linea_ay_mm = nav->linea_rumbo = nav->linea_fin_s_mm = 0;
    nav->sin_volver_a_linea = 0;
    nav->rumbo_en_vuelta = 0;
    nav->sin_margen_paso_j16 = 0;
    nav->sin_trig_fino = 0;
    nav->sin_arreglo_dt_giro = 0;
    nav->descartar_dt = 0;
}

int navegador_retroceso_calibrado(const Navegador *nav)
{
    return nav != NULL && cal_retroceso_medido(&nav->cal);
}

int navegador_poner_calibracion(Navegador *nav, const CalibracionCarro *cal)
{
    if (nav == NULL || cal == NULL || !cal_es_valida(cal)) {
        return NAV_ERR_ARGUMENTO;
    }
    if (nav->estado != NAV_ESPERANDO && nav->estado != NAV_TERMINADO && nav->estado != NAV_ERROR) {
        return NAV_ERR_ESTADO;
    }
    nav->cal = *cal;
    return NAV_OK;
}

int navegador_cargar_ruta(Navegador *nav, const Punto *puntos, int n_puntos)
{
    int i, indice_error;

    if (nav == NULL || puntos == NULL || n_puntos < 1 || n_puntos > MAX_PUNTOS) {
        return NAV_ERR_ARGUMENTO;
    }
    /* Se valida la ruta completa con trayectoria.c (saltos, puntos repetidos...). */
    nav->codigo_trayectoria = trayectoria_calcular(puntos, n_puntos, nav->pasos, MAX_PASOS,
                                                    &nav->n_pasos, &indice_error);
    nav->n_pasos = 0;
    if (nav->codigo_trayectoria != TRAY_OK) {
        nav->n_puntos = 0;
        return NAV_ERR_RUTA;
    }

    for (i = 0; i < n_puntos; i++) {
        nav->ruta[i] = puntos[i];
    }
    nav->n_puntos = n_puntos;
    nav->indice_objetivo = 1;
    nav->corr_rumbo_vertice = -1;
    nav->corr_rumbo_cuenta = 0;
    nav->apunte_k_esq = -1;
    nav->indice_paso = 0;
    nav->ms_paso = 0;
    nav->estado = NAV_ESPERANDO;
    nav->motivo_error = NAV_MOTIVO_NINGUNO;
    nav->error_causa = NAV_CAUSA_NINGUNA;
    nav->esquivadas = 0;
    nav->volver_a_reinc = 0;
    nav->frames_bloqueado = 0;
    nav->bloqueo_inmediato = 0;
    nav->bloqueo_cerc3 = 0;
    nav->frames_libre = 0;
    nav->frames_recibidos = 0;
    nav->cmd_actual = NAV_CMD_STOP;
    nav->n_giros = 0;                  /* los giros de la ruta anterior ya no cuentan */
    nav->giros_perdidos = 0;
    /* El carro se supone en el primer punto, mirando hacia ORIENTACION_INICIAL. */
    nav->x_mm = puntos[0].columna * MM_POR_CELDA;
    nav->y_mm = puntos[0].fila * MM_POR_CELDA;
    nav->rumbo_grados = ORIENTACION_INICIAL * 45;
    nav->base_x_mm = nav->x_mm;
    nav->base_y_mm = nav->y_mm;
    nav->base_rumbo_grados = nav->rumbo_grados;
    nav->rumbo_x10 = nav->base_rumbo_x10 = nav->rumbo_grados * 10;
    nav->seg_ms = 0;
    return NAV_OK;
}

int navegador_comenzar(Navegador *nav, uint32_t ahora_ms)
{
    if (nav == NULL) {
        return NAV_ERR_ARGUMENTO;
    }
    if (nav->estado != NAV_ESPERANDO || nav->n_puntos < 1) {
        return NAV_ERR_ESTADO;
    }
    nav->t_ultimo_ms = ahora_ms;
    nav->usa_camara = 0;               /* se activa con el primer cuadro de obstáculos de esta ruta */
    nav->t_ultimo_cuadro_ms = ahora_ms;
    nav->cmd_actual = NAV_CMD_STOP;
    nav->seg_ms = 0;
    nav->frames_bloqueado = 0;
    nav->bloqueo_inmediato = 0;
    nav->bloqueo_cerc3 = 0;
    nav->frames_libre = 0;
    nav->frames_recibidos = 0;
    nav->cerc_detenido_max = 0;
    nav->fin_obstaculo_mm = -1;
    nav->obstaculo_pendiente = nav->verificando_frente = nav->fin_pendiente = nav->fin_verificado = 0;
    memset(nav->fuentes_vision, 0, sizeof nav->fuentes_vision);
    nav->vision_sin_coincidencia = nav->precaucion = 0;
    nav->borde_reintentos = nav->fondo_observado_mm = nav->cara_obstaculo_s_mm = 0;
    nav->lateral_objetivo_mm = NAV_ESQ_MARGEN_LATERAL_MM;
    nav->lateral_tope_mm = NAV_BORDEAR_LATERAL_MAX;
    nav->mirada_fallida = nav->mirada_previa_fallida = 0;
    nav->cmd_previo = (int)NAV_CMD_STOP;
    nav->modelo_visto = nav->modelo_vigente = 0;
    nav->modelo_t_ok_ms = 0;
    nav->reinc_deshacer_mm = 0;
    nav->vistazo_retrocedio = nav->rodeo_por_vistazo = 0;
    nav->salida_linea_rumbo = nav->salida_linea_ok = 0;
    nav->vistazo_lado = nav->vistazo_ecos = nav->vistazo_mm = nav->vistazo_confirmado = nav->vistazos = nav->vistazos_con_eco = nav->giro_extra_grados = 0;
    memset(nav->coinc_seguidas, 0, sizeof nav->coinc_seguidas);
    nav->coinc_detenido = 0;
    nav->vistazo_cuadros[0] = nav->vistazo_cuadros[1] = nav->vistazo_hecho[0] = nav->vistazo_hecho[1] = 0;
    nav->vistazo_cerc[0] = nav->vistazo_cerc[1] = nav->vistazo_n[0] = nav->vistazo_n[1] = 0;
    nav->vistazo_fase = nav->vistazo_lateral_mm[0] = nav->vistazo_lateral_mm[1] = nav->vistazo_vacio[0] = nav->vistazo_vacio[1] = 0;
    nav->vistazo_solo_red[0] = nav->vistazo_solo_red[1] = nav->vistazo_red_hecho[0] = nav->vistazo_red_hecho[1] = 0;
    nav->vistazo_fase_ms = 0;
    nav->vistazo_grados_lado[0] = nav->vistazo_grados_lado[1] = nav->vistazo_grados = NAV_VISTAZO_GRADOS;
    nav->vistazo_t_ms = nav->vistazo_ultimo_ms[0] = nav->vistazo_ultimo_ms[1] = nav->vistazo_fin_ms = 0;
    nav->vistazo_alguno = 0;
    nav->extension_ruta_mm = nav->cierre_reintento = 0;
    nav->atras_conocido_mm = nav->escape_atras = 0;
    nav->precaucion_pausa_ms = 0;
    nav->tof_libre_lecturas = nav->tof_cerca_lecturas = 0;
    nav->reinc_pasar_primero = 0;
    nav->tramo_base = 0;               /* (revisión) por ruta: una ruta que empieza no hereda el tramo adelantado de la anterior */
    nav->pasar_s_mm = -1;
    nav->pasar_sin_avance = 0;
    nav->otro_lado_libre = nav->atras_al_salir_mm = 0;
    nav->esquive_decidido = 0;
    nav->coinc_esquivar_min = 0;
    nav->flanco_otro = 0;
    nav->deshacer_giro = 0;
    {   /* Por ruta: el arranque espera cuadros iguales, el sondeo se puede hacer una vez y los frenos anti-locura parten de cero. */
        int k, previo = nav->rumbo_grados, z;

        nav->giro_fw_caido = nav->giro_fw = nav->giro_fw_estado = nav->giro_fw_pedir = 0;   /* por ruta: el giroscopio vuelve a intentarse y los contadores parten de cero */
        nav->giro_fw_fallos = 0;
        nav->esquivadas_obstaculo = 0;
        nav->fin_delante_mm = 0;
        nav->n_giros_angulo = nav->n_giros_tiempo = 0;
        nav->giro_fw_consultando = nav->giro_fw_consulta_pedir = nav->giro_fw_ang_ini_ok = 0;
        nav->tof_paro_activo = nav->tof_pendiente = nav->tof_paros = nav->tof_dist_mm = 0;
        nav->rumbo_fw_pedir = nav->rumbo_fw_hay_enviado = 0;   /* J16 */
        nav->paso_en_linea = 0;
        nav->descartar_dt = 0;
        nav->racha_solo_centro2 = nav->tof_racha_nota = 0;
        diag_escribir(nav, "SENS_DIAG config giroscopio=%d sensor_distancia=%d rumbo_fw=%d", nav->usa_giroscopio, nav->usa_tof, nav->rumbo_fw);
        nav->arranque_ok = 0;
        nav->arranque_iguales = 0;
        nav->arranque_firma = 0;
        nav->arranque_t0_ms = ahora_ms;
        nav->bloqueo_cerc3 = 0;
        nav->sondeo_hecho = 0;
        nav->sondeo_fase = 0;
        nav->frenado_pendiente = 0;
        for (z = 0; z < OBS_ZONAS; z++) {
            nav->fijo_ignorar[z] = 0;
            nav->fijo_celdas[z] = 0;
            memset(nav->fijo_hex[z], '0', MASC_HEX_LARGO);
            nav->fijo_hex[z][MASC_HEX_LARGO] = '\0';
        }
        nav->indice_max = nav->indice_objetivo;
        nav->recorrido_mm = 0;
        nav->prev_x_mm = nav->x_mm;
        nav->prev_y_mm = nav->y_mm;
        if (nav->override_largo_mm > 0) {
            nav->ruta_largo_mm = nav->override_largo_mm;
        } else {
            nav->ruta_largo_mm = (nav->n_puntos >= 2) ? distancia_hasta_tramo(nav, nav->n_puntos - 1) : 0;
        }
        nav->ruta_largo_original_mm = nav->ruta_largo_mm;
        nav->max_giro_ruta = 0;
        for (k = 0; k + 1 < nav->n_puntos; k++) {
            int rumbo = rumbo_del_tramo(nav, k);
            int g = giro_minimo(previo, rumbo);

            if (g < 0) {
                g = -g;
            }
            if (g > nav->max_giro_ruta) {
                nav->max_giro_ruta = g;
            }
            previo = rumbo;
        }
    }
    if (cal_desplazamiento_es_espejo(&nav->cal, CAL_LADO_IZQUIERDA) || cal_desplazamiento_es_espejo(&nav->cal, CAL_LADO_DERECHA)) {
        diag_escribir(nav, "TURN_DIAG aviso=%s_estimada_como_espejo_de_la_%s: no tiene medida propia, midela en Calibracion",
                      cal_desplazamiento_es_espejo(&nav->cal, CAL_LADO_IZQUIERDA) ? "izquierda" : "derecha", cal_desplazamiento_es_espejo(&nav->cal, CAL_LADO_IZQUIERDA) ? "derecha" : "izquierda");
    }

    if (nav->indice_objetivo >= nav->n_puntos) {
        nav->estado = NAV_TERMINADO;   /* ruta de un solo punto: ya está en el destino */
        return NAV_OK;
    }
    if (planificar(nav) != NAV_OK) {
        ir_a_error(nav, NAV_MOTIVO_PLAN);
        return NAV_ERR_RUTA;
    }
    nav->estado = NAV_SIGUIENDO;
    return NAV_OK;
}

void navegador_cancelar(Navegador *nav)
{
    if (nav == NULL) {
        return;
    }
    nav->estado = NAV_ESPERANDO;
    cambiar_comando(nav, NAV_CMD_STOP);
}

/* ── Cuadros de obstáculos ─────────────────────────────────────────────── */

/* ¿Este cuadro, por sí solo, ya justifica detenerse? Sí si el obstáculo está muy cerca (3) con al menos
 * NAV_CERC3_AREA_INMEDIATA celdas; cercanía 2 en el centro exige 2 cuadros seguidos. */
static int cuadro_es_inmediato(int zona, int cercania, int celdas)
{
    (void)zona;
    return cercania >= 3 && celdas >= NAV_CERC3_AREA_INMEDIATA;
}

/* Una zona lateral solo contiene el carril del láser si TODAS sus celdas
 * aceptadas están en columnas 3..6 (proyectadas a 10 columnas). Sin rejilla
 * fiable no se suprimen obstáculos laterales. Los datos de lado no se cambian. */
static int solo_carril_central(const ResultadoObstaculos *obs, int zona)
{
    int f, c, dentro = 0;
    if (obs->filas < 1 || obs->filas > OBS_MAX_FILAS || obs->columnas < 1 || obs->columnas > OBS_MAX_COLUMNAS ||
        obs->fila_minima_usada < 0 || obs->fila_minima_usada >= obs->filas) return 0;
    for (f = obs->fila_minima_usada; f < obs->filas; f++) {
        for (c = 0; c < obs->columnas; c++) {
            int col = c * 10 / obs->columnas;
            if (!obs->no_piso[f][c] || c * OBS_ZONAS / obs->columnas != zona) continue;
            if (col < 3 || col > 6) return 0;
            dentro = 1;
        }
    }
    return dentro;
}

/* Guarda lo que se vio en el último cuadro y lleva la cuenta de la RACHA actual: cuántos cuadros
 * seguidos (y desde qué hora, en ms) el frente está bloqueado o libre. Un cuadro de ruido suelto
 * no cambia nada: ver bloqueo_confirmado() y libre_confirmado(). */
/* V2: cuánto falta (mm) para el final de la ruta si el carro va SIGUIENDO por la recta final (todos los tramos que quedan tienen el mismo rumbo); -1 si quedan giros
 * o no está siguiendo la ruta. Sirve para saber si lo que mide el láser está antes o después del destino. */
static long resto_de_recta_final(const Navegador *nav)
{
    int tramo, k;
    long s, desvio, largo;

    if (nav->estado != NAV_SIGUIENDO || nav->n_puntos < 2 || nav->obstaculo_pendiente) {
        return -1;
    }
    ubicar_en_linea(nav, nav->x_mm, nav->y_mm, &tramo, &s, &desvio);
    for (k = tramo; k + 1 <= nav->n_puntos - 2; k++) {
        if (rumbo_del_tramo(nav, k + 1) != rumbo_del_tramo(nav, tramo)) {
            return -1;
        }
    }
    if (valor_absoluto_largo(giro_minimo(nav->rumbo_grados, rumbo_del_tramo(nav, tramo))) > 20) {
        return -1;   /* el carro no mira a lo largo de la recta: el láser no apunta al destino */
    }
    largo = (nav->override_largo_mm > 0) ? nav->override_largo_mm : distancia_hasta_tramo(nav, nav->n_puntos - 1);
    return (largo > s) ? largo - s : 0;
}

/* V2: ¿lo que el láser mide a `mm` del frente queda MÁS ALLÁ del destino con holgura (NAV_FIN_HOLGURA_MM entre el frente del carro ya detenido y el objeto)? */
static int laser_tras_el_destino(const Navegador *nav, int mm)
{
    long resto = resto_de_recta_final(nav);

    return resto >= 0 && (long)mm - resto >= NAV_FIN_HOLGURA_MM;
}
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
