fernandosegrr/fsi_proyect/nucleo_c/navegador.h

/*
 * navegador.h — El "cerebro" del modo semiautónomo: sigue una ruta y esquiva obstáculos.
 *
 * GUÍA DE LECTURA
 *  1. Une dos módulos: trayectoria.c (de una ruta de celdas saca pasos AVANZAR/GIRAR con
 *     tiempos) y obstaculos.c (dice si hay algo adelante). El resultado es UN comando.
 *  2. Se usa así: navegador_iniciar() → navegador_cargar_ruta() → navegador_comenzar() y
 *     después se llama navegador_tick() cada ~50 ms; devuelve el comando que el carro debe
 *     MANTENER (los mismos 5 del protocolo real, sin parámetros).
 *  3. Estados (ver el diagrama en docs/navegador.md):
 *       ESPERANDO → SIGUIENDO → DETENIDO_OBSTACULO → ESQUIVANDO → REINCORPORANDO → SIGUIENDO
 *       ... → TERMINADO (llegó) o ERROR (no pudo seguir).
 *  4. El navegador NO tiene sensores de posición: lleva la cuenta por TIEMPO (cuánto tiempo
 *     estuvo avanzando o girando), con la calibración del carro (calibracion.h). J15: con
 *     giroscopio activo, SENS orienta cada incremento de avance; la distancia sigue estimada.
 *  5. Solo enteros, sin malloc, sin recursión; los errores son códigos de retorno.
 *  6. Regla de seguridad: en los estados ESPERANDO, TERMINADO y ERROR el comando es SIEMPRE STOP.
 *  7. PEDIR AYUDA (opcional, navegador_poner_pedir_ayuda): cuando el carro no puede esquivar (los dos lados ocupados, esquivadas o reintentos agotados) en vez de ERROR pasa a AYUDA:
 *     queda quieto y «pide que tomes el control». Mientras está en AYUDA el comando es el que la app le pone con navegador_ayuda_comando (los botones de la cruceta, soltar = STOP) y
 *     sigue calculando su posición por tiempo; no mira obstáculos (el responsable es quien maneja). Con navegador_ayuda_continuar vuelve solo a la línea de la ruta (como después de
 *     esquivar) y sigue. Apagado por defecto: sin él esos casos terminan en ERROR como siempre.
 */
#ifndef NAVEGADOR_H
#define NAVEGADOR_H

#include <stdint.h>
#include "trayectoria.h"
#include "obstaculos.h"
#include "calibracion.h"

#ifdef __cplusplus
extern "C" {   /* permite usarlo desde C++ / JNI */
#endif

/* ── Parámetros a calibrar ─────────────────────────────────────────────── */

#define NAV_TICK_MS                50    /* cada cuánto se llama navegador_tick (nominal) */
#define NAV_DT_MAX_MS            1000    /* tope del tiempo entre ticks (el firmware frena a los 1000 ms) */

/* Antirrebote EN MILISEGUNDOS (no en cuadros): así el retraso es el mismo con 8, 12 o 30 cuadros
 * por segundo. Un obstáculo en CUALQUIER zona frena el carro si su cercanía (0 a 3) es al menos
 * NAV_CERCANIA_MIN_DETENER (2): un obstáculo realmente lejano (cercanía 1, por ejemplo una escalera al fondo)
 * solo se informa, no frena. Después hay dos casos:
 *   - INMEDIATO (con UN solo cuadro): cercanía 3 en cualquier zona, o cercanía 2 en la zona central
 *     (el obstáculo ya está cerca y de frente: no hay tiempo que perder).
 *   - A CONFIRMAR (cercanía 2 en una zona de los lados): hay que verlo MS_CONFIRMAR_LEJOS milisegundos
 *     seguidos (y en al menos 2 cuadros) antes de detenerse; así un cuadro de ruido no frena el carro.
 * Para volver a avanzar, el frente debe verse libre MS_CONFIRMAR_LIBRE milisegundos seguidos. */
#define MS_CONFIRMAR_LEJOS         150
#define MS_CONFIRMAR_LIBRE         250
#define NAV_CERCANIA_MIN_DETENER     2   /* desde esta cercanía (en cualquier zona) se frena; 1 = lejos, solo se informa */
/* FRENAR DESDE LEJOS (opcional, navegador_poner_frenar_lejos_centro): con el carro a ~38 cm/s y ~0.4 s de retraso del video, el STOP llega
 * cuando ya avanzó unos 17 a 19 cm. Si el detector solo marca la cercanía 2 a ~20 cm del objeto, choca. Con esta opción un obstáculo
 * LEJANO (cercanía 1) en la zona CENTRAL también frena, pero tras 2 cuadros seguidos y NAV_MS_CONFIRMAR_CENTRO_LEJOS ms, para que un
 * cuadro de ruido no pare el carro. Los lados siguen igual (cercanía 1 a los lados solo se informa). */
#define NAV_MS_CONFIRMAR_CENTRO_LEJOS 60
#define NAV_CERCANIA_INMEDIATA       2   /* en el centro: desde esta cercanía se confirma con un cuadro */

/* Giro medido con la cámara (ver navegador_aporte_visual): el giro por tiempo se corrige con lo que la cámara ve girar.
 *   - NAV_COBERTURA_VISUAL_PCT: la cámara debe haber medido al menos este % del tiempo de giro (y NAV_MIN_MS_VISUAL ms)
 *     para fiarse de ella; si no, el giro sigue por tiempo.
 *   - NAV_GIRO_MIN_PCT: aunque la cámara diga que ya se llegó al ángulo, no se corta antes de este % del tiempo planeado
 *     (por si la cámara se equivoca).
 *   - NAV_GIRO_MAX_PCT: tiempo de RESPALDO: aunque la cámara diga que falta, el giro se corta a este % del tiempo planeado. */
#define NAV_COBERTURA_VISUAL_PCT   50
#define NAV_MIN_MS_VISUAL         200
#define NAV_GIRO_MIN_PCT           50
#define NAV_GIRO_MAX_PCT          150

#define NAV_PAUSA_MS              500    /* pausa con el carro detenido antes de decidir qué hacer */
#define NAV_MAX_HUECO_VIDEO_MS    700    /* si la cámara de obstáculos pasa más de esto sin mandar un cuadro: STOP y ERROR (no reanuda sola). Eran 500: en la prueba real del 16 oct un hueco de 503 ms (con 11 a 12 cuadros por segundo y huecos normales de 250 a 330 ms) detuvo la ruta */
#define NAV_PRIMER_CUADRO_MAX_MS 1500    /* con requiere_camara: tiempo máximo (quieto) para que llegue el primer cuadro de la ruta */
#define NAV_PAUSA_ASENTAR_MS      300    /* STOP entre avanzar y girar (y al revés): el carro termina de moverse y el giro/avance siguiente
                                          * arranca desde cero, como en la calibración. Sin esto, el giro dependía de la inercia del avance. */
#define NAV_TIMEOUT_ESQUIVAR_MS  4000    /* si en este tiempo no se puede esquivar: ERROR */

/* REINTENTOS DE ESQUIVE (ver docs/navegador.md, "Objetos grandes"). Después del giro de apartarse, el carro se queda quieto un momento y MIRA:
 * si el obstáculo SIGUE MUY CERCA al frente (cercanía NAV_CERCANIA_MUY_CERCA en la zona central), no avanza hacia él: RETROCEDE un poco
 * (por tiempo), gira del MISMO lado un ángulo extra (el 1.er reintento NAV_ANGULO_REINTENTO_1 grados, el 2.º NAV_ANGULO_REINTENTO_2) y vuelve
 * a mirar. Con NAV_MAX_REINTENTOS reintentos agotados y el frente todavía bloqueado: STOP y ERROR (NAV_MOTIVO_ESQUIVANDO, como antes). */
#define NAV_MAX_REINTENTOS          2
#define NAV_ANGULO_REINTENTO_1     45    /* grados EXTRA del primer reintento (se suman a los 90 del giro de apartarse) */
#define NAV_ANGULO_REINTENTO_2     90    /* grados EXTRA del segundo reintento */
#define NAV_CERCANIA_MUY_CERCA      3    /* con esta cercanía en el centro, "sigue muy cerca" (la misma que ya hacía ERROR al esquivar) */
#define NAV_MIRAR_MAX_ESPERA_MS   500    /* si tras la espera de arriba no llega ningún cuadro nuevo, se decide sin él (libre) */
/* RETROCESO CIEGO: el carro NO tiene cámara ni sensor atrás. Para ir hacia atrás solo sabe cuánto tiempo mandó REVERSE; si hay algo detrás
 * (una persona, una pared, un escalón) lo golpea o se cae sin enterarse. Por eso la distancia está LIMITADA a NAV_RETROCESO_CM (contando lo que
 * el carro sigue de frenado) y además a NAV_RETROCESO_MAX_MS aunque la calibración pida más. Úsalo solo con el espacio de atrás libre.
 *
 * V2, las tres reversas que hay y su tope (ninguna tiene sensor que la cuide; todas suponen que nadie entró detrás del carro en esos segundos):
 *  - reintento del esquive (la de siempre): NAV_RETROCESO_CM, a ciegas;
 *  - escape (intentar_escape_atras): de NAV_RETROCESO_CM a NAV_RETROCESO_MAX_MM, y nunca más que `atras_conocido_mm` menos 50: lo que el carro ACABA de avanzar en
 *    línea recta con ese mismo rumbo (se pone en 0 con cualquier giro). No se le suma espacio «deducido» que el chasis no haya pisado;
 *  - deshacer la diagonal de entrada (reinc_abortar_entrada): lo avanzado en esa diagonal, hasta NAV_DESHACER_MAX_MM. */
#define NAV_RETROCESO_CM           15    /* cm que retrocede en cada reintento: NO subir sin tener sensor o cámara trasera */
#define NAV_RETROCESO_MAX_MS     2000    /* tope absoluto del tiempo de retroceso, pase lo que pase con la calibración */
#define NAV_ANGULO_ESQUIVAR        90    /* grados que gira para apartarse (múltiplo de 45) */
#define NAV_TRAMO_ESQUIVAR_CM      40    /* cuánto avanza de lado, en cm */
#define NAV_MAX_ESQUIVADAS          6    /* maniobras y extensiones del rodeo antes de pedir ayuda */

/* REINCORPORACION A LA LINEA (ver docs/navegador.md, "Volver a la línea"). Al terminar de esquivar, el carro lleva su pose estimada (x, y, rumbo) y:
 *   1. busca el punto de la línea original NAV_REINC_ADELANTE_CM cm por delante del punto donde salió de ella;
 *   2. gira hacia ese punto con el giro mínimo, avanza la distancia estimada y, al llegar, gira al rumbo original de la línea;
 *   3. si estaba a menos de NAV_REINC_DESVIO_MIN_MM de la línea, solo corrige el rumbo y sigue (no se mueve de lado).
 * Nunca avanza recto sin haberse reorientado. Entre cada movimiento hay la pausa de siempre (NAV_PAUSA_ASENTAR_MS). */
#define NAV_REINC_ADELANTE_CM      30    /* a cuántos cm por delante del punto de salida (donde ya pasó el obstáculo) está el punto de la línea al que vuelve */
#define NAV_REINC_DESVIO_MIN_MM    80    /* menos de esta desviación (8 cm) a la línea: solo corrige el rumbo */
#define NAV_REINC_GIRO_MIN_GRADOS   4    /* un giro de menos de esto no se hace (el error de la estimación es mayor) */
#define NAV_REINC_PASADO_MAX_MM   400    /* ...pero solo si no se pasó de aquí (40 cm) ni quedó a más de NAV_REINC_PASADO_LADO_MM (60 cm) de lado: una ruta que da la vuelta y termina donde empezó no cuenta */
#define NAV_REINC_PASADO_LADO_MM  600
#define NAV_REINC_PASADO_MM        30    /* si al empezar a volver el carro ya está más allá del punto final de la ruta por esto (3 cm) o más, la ruta se da por terminada:
                                          * no vuelve hacia atrás al punto final (pasa, por ejemplo, cuando el obstáculo estaba justo en el destino y se rodeó con «toma el control») */

/* DETECCION DURANTE LA ESQUIVADA (ver docs/navegador.md, "Falso obstáculo al esquivar"). Mientras el carro gira, la cámara barre la escena: lo que se ve en esos cuadros
 * (el mismo obstáculo en el borde, patas o sombras lejanas, juntas de loseta) no cuenta. Después del giro se ignoran los cuadros que todavía muestran el giro
 * (los que llegan antes de latencia_visual_ms) y luego hasta que hayan llegado NAV_ESQ_CUADROS_ESTABLES cuadros o pasado NAV_ESQ_MS_ESTABLE ms (lo que ocurra
 * primero). Bloquea un obstáculo en la zona CENTRAL con cercanía de al menos NAV_ESQ_CERCANIA_BLOQUEA y, solo mientras vuelve en diagonal a la línea y con el
 * corredor activo, también uno de un LADO con cercanía NAV_ESQ_CERCANIA_LADO que el corredor ubica en el camino (la esquina de lo que acaba de pasar), visto MS_CONFIRMAR_LEJOS ms seguidos (y en 2 cuadros). Al avanzar de lado o
 * en paralelo uno lateral no aborta (es el obstáculo que se está pasando). */
#define NAV_AYUDA_MAX_MS        180000   /* si nadie toma el control ni continúa en este tiempo (3 min): ERROR con el motivo de siempre */

#define NAV_ESQ_CUADROS_ESTABLES    2
#define NAV_ESQ_MS_ESTABLE        150
#define NAV_ESQ_CERCANIA_BLOQUEA    2
#define NAV_ESQ_CERCANIA_LADO       3

/* PASAR EL OBSTACULO ANTES DE VOLVER. Después de apartarse y enderezarse (VOLVER), el carro sigue PARALELO a la línea, a la distancia lateral a la que quedó, hasta
 * haber pasado el obstáculo. Usa distancia laser o banda visual coincidente, sensor-centro y margen.
 * Explora por tramos NAV_BORDEAR_TRAMO_MM y amplia la ultima recta cuando hace falta: nunca recorta el rebase.
 * La vuelta pendiente de comprobar apunta casi transversalmente a la línea (50 mm hacia delante), vigila el costado
 * y exige evidencia frontal nueva al recuperar el rumbo. Las bandas visuales no miden profundidad. */
#define NAV_CARA_CERCANIA_3_MM    300    /* con cercanía 3 el obstáculo estaba a menos de esto */
#define NAV_CARA_CERCANIA_2_MM    500
#define NAV_CARA_CERCANIA_1_MM    800
#define NAV_PASO_MARGEN_MM        150    /* holgura al terminar de pasarlo. J16: eran 100; en la simulación calibrada la cola del carro (24 cm de largo) barría la cara de la caja al
                                          * pivotar en el giro final de la vuelta (0.9 % de los esquives con J15, 4.9 % con J14; ver B6-2, «probablemente tocó la caja»). Con 150, 0 de 1000 */
#define NAV_PASO_MARGEN_J15_MM    100    /* la de antes (sin_margen_paso_j16) */
#define NAV_PARALELO_FIN_MM        50    /* el tramo paralelo termina al menos esto antes del final de la ruta */
#define NAV_PARALELO_MIN_MM        50    /* un tramo paralelo más corto que esto no se hace */

/* PLAN CON PIVOTE (J8, ver docs/navegador.md, «Plan con pivote»). El carro gira de pivote: el centro se desplaza al girar (modelo de calibracion.h). Todos los giros del esquive y de la
 * vuelta a la línea se PLANEAN con ese desplazamiento, no como giros en el sitio:
 *   - giro hacia el objetivo: el ángulo α tal que, después de girar α y moverse por el pivote, el rumbo apunta al punto objetivo desde la posición nueva (iteración de punto fijo de
 *     NAV_PLAN_ITERACIONES pasos y, si no converge, barrido de 1 grado); la distancia de avance se cuenta desde la posición posterior al giro;
 *   - giro final al rumbo de la línea: el avance termina en el punto previo desde el que, tras ese giro con su desplazamiento, el centro cae sobre la línea (la inversa del modelo);
 *   - tramo de lado del esquive: el margen lateral NAV_ESQ_MARGEN_LATERAL_MM del centro a la línea cuenta lo que se mueve el centro al girar para apartarse y al enderezarse;
 *   - si no cabe (el giro de salida mueve el centro hacia adelante más de lo que hay libre, o la vuelta no tiene solución) elige el otro lado o pide ayuda;
 *   - RED DE SEGURIDAD: tras cada tramo de la vuelta compara la pose estimada con la planeada y, si pasa de NAV_PLAN_ERROR_MM, vuelve a planear desde donde está (máximo
 *     NAV_PLAN_CORRECCIONES veces; si se agotan, para y pide ayuda). */
#define NAV_PLAN_ITERACIONES        5    /* pasos máximos de la iteración de punto fijo */
#define NAV_PLAN_ERROR_MM          80    /* error de la pose estimada respecto del punto planeado a partir del cual se vuelve a planear (8 cm) */
#define NAV_PLAN_CORRECCIONES       4    /* máximo de correcciones (nuevos planes) en una vuelta a la línea */
#define NAV_PLAN_MAS_MM           200    /* si el punto de la línea no sirve, prueba NAV_PLAN_INTENTOS veces con un punto este tanto más adelante (una celda) */
#define NAV_REINC_PUNTO_PASADO_MM 100    /* al terminar la vuelta, un punto de la ruta que el carro ya dejó atrás por esto (medio cuadro) o más se salta: no se vuelve a él */
#define NAV_REINC_VERTICE_MIN_MM  150    /* el punto al que se vuelve (un centro de celda de la ruta) queda al menos esto por delante del carro */
#define NAV_PLAN_INTENTOS           5
#define NAV_ARCO_MARGEN_MM        100    /* colchón entre el desplazamiento hacia adelante del giro de salida y la cara del obstáculo */
#define NAV_ESQ_MARGEN_LATERAL_MM (NAV_TRAMO_ESQUIVAR_CM * 10)   /* distancia lateral del centro a la línea al pasar el obstáculo (la de siempre: el tramo de lado de 40 cm) */
#define NAV_ESQ_TRAMO_MIN_MM      100    /* el tramo de lado nunca es más corto que esto */

/* ARRANQUE, SONDEO Y FRENOS ANTI-LOCURA (J9, ver docs/navegador.md). El obstáculo fantasma de la prueba real (zona izquierda con 25 a 57 celdas en cercanía 3 desde el primer cuadro, con el piso despejado)
 * hacía frenar y esquivar sin motivo; y un índice de la ruta vencido hizo dar media vuelta al final. Por eso:
 *   - al arrancar NO se decide con el primer cuadro: hacen falta NAV_ARRANQUE_CUADROS cuadros seguidos iguales (o NAV_ARRANQUE_MAX_MS ms);
 *   - si el obstáculo ya estaba en esos cuadros, el carro no se ha movido y el centro está libre (cercanía NAV_SONDEO_CERC_MAX o menos, o solo en los lados), avanza NAV_SONDEO_CM cm y compara: si las celdas
 *     no crecen (NAV_SONDEO_CRECE_PCT %, al menos NAV_SONDEO_CRECE_MIN) es un «sospechoso fijo»: se ignora en esa corrida; si crecen es real y se esquiva como siempre;
 *   - la cercanía 3 frena con 2 cuadros seguidos, o con 1 si el área es de NAV_CERC3_AREA_INMEDIATA celdas o más;
 *   - frenos: un giro planeado de más de NAV_LOCURA_GIRO_MAX grados que no está en la ruta, el índice de la ruta que retrocede, una distancia recorrida de más de NAV_LOCURA_RECORRIDO_X10 / 10 veces la de la
 *     ruta, la pose a más de NAV_LOCURA_DESVIO_MM de la ruta, o más de NAV_MAX_ESQUIVADAS esquivadas: para y pide AYUDA;
 *   - el final de la ruta no deja el carro girado más de NAV_RUMBO_FINAL_TOL grados del último tramo. */
#define NAV_ARRANQUE_CUADROS        4    /* cuadros seguidos iguales antes de decidir al arrancar */
#define NAV_ARRANQUE_MAX_MS      1500    /* ...o este tiempo, lo que ocurra primero */
#define NAV_CERC3_AREA_INMEDIATA    6    /* con cercanía 3 y al menos tantas celdas, un solo cuadro frena; con menos hacen falta 2 cuadros seguidos */
#define NAV_SONDEO_CM               4    /* cuánto avanza el sondeo */
#define NAV_SONDEO_CERC_MAX         2    /* el sondeo se hace si el obstáculo es de esta cercanía o menos (o está solo en los lados, con el centro libre) */
#define NAV_SONDEO_QUIETO_MM       30    /* «el carro no se ha movido»: ha recorrido menos de esto */
#define NAV_SONDEO_CRECE_PCT       15    /* las celdas crecieron si pasaron de las de antes + este % (y al menos NAV_SONDEO_CRECE_MIN celdas) */
#define NAV_SONDEO_CRECE_MIN        3
#define NAV_SONDEO_TOPE_CELDAS     12    /* tope de celdas por zona para ignorar como sospechoso fijo */
#define NAV_SONDEO_IGNORAR_PCT    130    /* un sospechoso fijo se ignora mientras no crezca más del 30 % y su firma de celdas siga igual */
#define NAV_SONDEO_IGNORAR_MAS      0
#define NAV_SONDEO_MIRAR_MS       250    /* cuánto se miran los cuadros después de asentarse, antes de comparar */
#define NAV_SONDEO_MAX_ESPERA_MS 1500    /* espera máxima de al menos 2 cuadros tras el sondeo; si no llegan, repite sin declarar nada */
#define NAV_LOCURA_GIRO_MAX       150    /* un giro planeado de más de estos grados que no está en la ruta frena */
#define NAV_LOCURA_RECORRIDO_X10   25    /* distancia recorrida máxima: 2.5 veces la de la ruta... */
#define NAV_LOCURA_RECORRIDO_MIN_MM 600  /* ...tomando la ruta como de al menos 60 cm (con una ruta de 20 cm una sola esquivada ya pasa 2.5 veces) */
#define NAV_LOCURA_DESVIO_MM     1000    /* la pose a más de esto (1 m) de la ruta frena */
#define NAV_RUMBO_FINAL_TOL        20    /* al terminar la ruta el rumbo queda a lo más a esto del último tramo */

/* GIROSCOPIO Y SENSOR LÁSER (J11, ver docs/sensores.md). Con el giroscopio encendido (navegador_poner_giroscopio) cada giro de entre NAV_GIRO_FW_MIN_GRADOS y NAV_GIRO_FW_MAX_GRADOS se le pide al
 * firmware como GIRAR:<grados> (la app lo manda al ver navegador_tomar_giro_fw); el firmware gira hasta el ángulo MEDIDO y contesta con el ángulo REAL (navegador_aporte_giro): la pose usa ese
 * ángulo (con el desplazamiento del pivote calculado con él). Si el giro termina mal (GIRO_TIMEOUT / GIRO_ERROR) se usa el ángulo real que informó, si lo hay, y los giros siguientes de la ruta
 * vuelven al método por tiempo (con aviso SENS_DIAG). Un giro sin respuesta en la espera máxima también cae al tiempo.
 * El laser fresco cercano confirma; si esta libre descarta una fuente visual aislada.
 * Color y red coincidentes permiten esquivar por banda visual aun sin eco; siempre STOP antes de planear.
 * El cierre exige tres lecturas >800 mm o, sin eco, cinco cuadros nuevos sin coincidencia y rebase cumplido.
 * Sin eco no se contabiliza nunca como una lectura laser libre. */
#define NAV_GIRO_FW_MIN_GRADOS       5    /* un giro de menos de esto no se pide al firmware (no se hace) */
#define NAV_GIRO_FW_MAX_GRADOS     200    /* el firmware no gira más de esto de una vez; uno mayor se hace por tiempo */
#define NAV_GIRO_FW_BASE_MS        500    /* tiempo máximo propio del firmware: base + por grado (igual que GIRO_TIEMPO_BASE_MS y GIRO_TIEMPO_POR_GRADO_MS de config.h) */
#define NAV_GIRO_FW_POR_GRADO_MS    15
#define NAV_GIRO_FW_ESPERA_EXTRA_MS 1500  /* margen sobre ese máximo para que llegue la respuesta; si no llega, el giro cae al método por tiempo */
#define NAV_GIRO_FW_CONSULTA_MS   1000    /* si no llega GIRO_OK ni GIRO_TIMEOUT se pregunta IMU? y se espera tanto la respuesta (si no llega se usa el último SENS fresco) */
#define NAV_GIRO_FW_YA_GIRO_PCT     80    /* con el mensaje perdido, si el giroscopio dice que ya giró al menos este % de lo pedido NO se repite el giro */
#define NAV_TOF_ESPERA_LADO_MS     700    /* tras TOF_PARO se espera tanto (como máximo) a que la cámara dé el lado libre */
#define NAV_TOF_LIBRE_MM           800    /* libre solo con una medida válida mayor que esto */
#define NAV_TOF_LIBRE_LECTURAS       3
#define NAV_TOF_CONFIRMA_MM        500    /* referencia histórica; reacción actual limitada por NAV_REACCION_MAX_MM */
#define NAV_TOF_FRESCO_MS          400    /* una lectura del láser más vieja que esto ya no sirve */
#define OBSTACULO_LASER_MM         400    /* laser fresco cercano confirma el centro */
#define NAV_REACCION_MAX_MM       500    /* distancia frontal maxima para planear un esquive automatico */
#define NAV_SENSOR_FRENTE_MM     120    /* centro a sensor frontal: SUPUESTO de chasis de 240 mm; pendiente medir */
#define NAV_VERIFICAR_FIN_MS     1000    /* espera lecturas nuevas con el carro parado y alineado */
#define NAV_VISION_LIBRE_CUADROS    5    /* cierre sin eco: cuadros nuevos sin coincidencia */
#define NAV_BORDEAR_TRAMO_MM      200    /* intervalo de exploración, NO profundidad supuesta */
#define NAV_BORDEAR_EXTRA_MM      100    /* ensanchar el rodeo en cada reintento */
#define NAV_BORDEAR_LATERAL_MAX   800
#define NAV_EXTENSION_RUTA_MM   2000    /* máximo añadido a la recta final al rodear su obstáculo */
#define NAV_PRECAUCION_AVANCE_MS  700    /* avance calibrado por tandas; sin cambiar PWM del firmware */
#define NAV_PRECAUCION_PAUSA_MS   300

/* AUTÓNOMO V2 (ver docs/autonomo_v2_diseno.md). Todo SIMULADO / NO MEDIDO en el carro.
 *  - NAV_FIN_HOLGURA_MM: un obstáculo que el láser confirma pero que, al llegar al final de la recta final, quedaría a esto o más del frente del carro NO estorba
 *    el destino: la ruta termina delante de él (una pared 45 cm más allá del final no se «esquiva»). Es también lo que debe medir el láser para cerrar un rodeo.
 *  - NAV_MAX_ESQUIVADAS vale ahora POR OBSTÁCULO (se repone al dejarlo atrás); NAV_MAX_ESQUIVADAS_RUTA es el tope de toda la ruta. */
#define NAV_V2                      1
#define NAV_FIN_HOLGURA_MM        400
#define NAV_MAX_ESQUIVADAS_RUTA    18
#define NAV_GIRO_FW_FALLOS_MAX      3    /* giros por ángulo fallidos en una ruta antes de dejar de pedirlos (antes: uno solo) */
/* RODEO MEDIDO (V2). El carro pivota sobre un costado (el pivote derecho medido, 150 mm adelante y 165 a la derecha en 90 grados, es girar sobre un punto 157 mm a la
 * derecha del centro): al girar barre el chasis hacia un lado. Por eso:
 *  - ESCANEO: mientras hace el primer giro del rodeo, cada SENS trae ángulo y distancia del láser a la vez: con ellos se mide hasta dónde llega el obstáculo hacia el
 *    lado del rodeo (su ancho) y si hay una pared de ese lado. El desvío lateral es el ancho medido más NAV_ESQ_HOLGURA_VOLVER_MM (lo que barre el giro de
 *    enderezarse), nunca menos que el de siempre ni más que NAV_BORDEAR_LATERAL_MAX; si no cabe, no se avanza hacia allí (causa NAV_CAUSA_FRENTE_ANCHO).
 *  - PASO EN PARALELO: el costado del objeto queda fuera del láser y casi fuera de la cámara (a `c` mm de lado solo se ve el piso desde 1.88 c mm adelante, con 56 grados
 *    de campo). Se avanza hasta NAV_PASO_VISTA_MARGEN_MM más allá del punto donde el costado ya no puede estar a la vista; mientras la cámara lo siga viendo (celdas
 *    en el borde lejano de ese lado, o la red) esa cuenta vuelve a empezar. Tope NAV_PASO_PARALELO_MAX_MM.
 *  - REGRESO: un eco del láser al girar hacia la línea solo cuenta como «costado todavía presente» si el punto medido NO queda delante del carro; algo delante es un
 *    obstáculo nuevo y lo atiende la ruta al retomarla. */
#define NAV_ESQ_HOLGURA_VOLVER_MM   200
#define NAV_ESCANEO_RELLENO_MM       40    /* el ancho medido se redondea hacia arriba: entre dos SENS el carro gira ~13 grados */
#define NAV_ESCANEO_MAX              32    /* lecturas que se guardan de un barrido (un giro de 90 grados da de 7 a 12) */
#define NAV_ESCANEO_ALCANCE_UTIL_MM 700    /* si para seguir viendo la cara habría que medir más que esto, el final de la cara no se puede comprobar */
#define NAV_ESCANEO_HOLGURA_GRADOS    8    /* esa cuenta se hace con el ángulo de la lectura más esto (error del ángulo y poca señal de un plano visto de lado) */
#define NAV_ESCANEO_PARED_HOLGURA_MM 260   /* de una pared lateral medida al centro del carro: 130 que barre el giro + medio carro + 30 */
#define NAV_ESCANEO_PARED_MIN_MM    100    /* (revisión) un eco antes de la cara, AL LADO del carro y a más de medio carro de la línea es algo junto al carril (una pared pegada), no el obstáculo */
#define NAV_ESCANEO_AL_LADO_S_MM    300    /* (revisión) «al lado del carro»: a menos de esto a lo largo de la ruta desde donde se detuvo (la banda por la que saldría de lado) */
/* CAMBIO DE LADO y GUARDIA DEL GIRO (V2, tras la revisión independiente). Medir el otro lado es dar la vuelta completa sobre la misma rueda, y eso barre un disco
 * alrededor de ella: el brazo del pivote más NAV_BARRIDO_DER_MM o NAV_BARRIDO_IZQ_MM (unos 44 cm de la línea a la derecha, 32 a la izquierda, y otro tanto hacia
 * atrás). Por eso solo se da la vuelta si (1) lo que el láser midió de ese lado queda fuera del disco, (2) la cámara veía libre el otro lado cuando el carro se detuvo
 * y (3) el carro venía de avanzar en recta al menos el radio del disco (lo de atrás, sobre la línea, lo acaba de pisar). Si no, pide ayuda sin girar más.
 * Además, durante el primer giro del rodeo y durante esa vuelta, una lectura válida del láser más corta que la «guardia» dice que hay algo DENTRO del disco (el haz va
 * unos 30 grados por delante de la esquina que barre): el carro deja de girar y pide ayuda (NAV_CAUSA_GIRO_BLOQUEADO). No lo evita todo: con ~0.3 s de ventaja el
 * chasis puede alcanzar a tocar, pero deja de empujar. Lo que queda más bajo que el haz no se ve. */
#define NAV_PARED_PEGADA_TOL_MM       50    /* dos lecturas seguidas del barrido «a la misma distancia lateral»: a menos de esto una de otra */
#define NAV_PARED_PEGADA_TRAMO_MM     60    /* ...y separadas al menos esto a lo largo de la ruta: una pared paralela a la ruta, no un objeto suelto */
#define NAV_PARED_PATAS_MM           250    /* una «pared» a menos de esto de la línea también pueden ser dos patas de un mueble: se exige que llegue hasta el costado del carro */
#define NAV_DESHACER_GIRO_MAX          0    /* APAGADO (0): deshacer el giro y rodear por el otro lado empeoro «caja y pared al lado» en el banco (534 ok, 7 contactos; sin ello 615 y 2). Con 50 se activa. */
#define NAV_GUARDIA_BRAZO_MIN_MM      30    /* con un brazo de pivote menor que esto en la calibración (sin medir) la guardia del giro no se aplica */
#define NAV_PASAR_SIN_AVANCE_MAX      3    /* (revisión) planes seguidos de «pasar primero» sin que avance la cuenta a lo largo de la ruta: se pide ayuda en vez de repetir */
#define NAV_CAMARA_FOV_GRADOS        56    /* campo horizontal de la cámara (SUPUESTO del manual; pendiente de medir) */
#define NAV_CAMARA_ADELANTE_MM      100    /* del centro del carro a la lente (SUPUESTO) */
#define NAV_PASO_VISTA_MARGEN_MM    230    /* 10 a 50 que necesita el giro de regreso + ~100 porque las ultimas celdas del costado dejan de contarse antes de salir del cuadro + 80 de error de distancia por tiempo */
#define NAV_PASO_PARALELO_MAX_MM   2500
#define NAV_FLANCO_CELDAS_MIN         2    /* celdas en el borde lejano del lado del objeto para decir que el costado sigue a la vista */
#define NAV_FLANCO_OTRO_MM          250    /* si el paso llevaba esto sin ver nada de ese lado, lo que asoma es OTRO objeto (el que se rodea ya quedó al lado o atrás) */
#define NAV_PASO_FONDO_OTRO_MM      200    /* fondo SUPUESTO de ese otro objeto (una caja de 20 cm): de él se deja de ver la cara de adelante, no la de atrás */
#define NAV_PASO_INICIO_MM          220    /* el paso en paralelo empieza unos 22 cm antes de la cara del objeto (lo que deja el frenado más los dos giros) */
#define NAV_RETROCESO_MAX_MM        250    /* el retroceso de escape nunca pasa de esto (NAV_RETROCESO_CM, 15 cm, es el de siempre) */
#define NAV_ENTRADA_CELDAS_MIN        6    /* MIRADA ANTES DE ENTRAR: celdas de color, cerca (cercanía 2 o 3), en una zona para decir que la entrada a la línea está ocupada */
#define NAV_MIRADA_MAX_MS           600    /* tras la latencia del video, lo más que se espera por los cuadros de la mirada */
#define NAV_MIRADA_PASO_MM          400    /* si la mirada ve ocupada la entrada: avanza esto más por el carril y vuelve a mirar */
#define NAV_MIRADA_PASO_LEJOS_MM    750    /* lo mismo cuando lo visto está más adelante sobre la línea (cercanía 1 del lado hacia donde sigue la ruta): hay que pasarlo entero */
#define NAV_MIRADA_PASO_CONFIRMA_MM 200    /* PUNTO CIEGO: girado hacia la línea, la cámara no ve lo que queda pegado al costado del carro (a menos de ~19 cm de la lente y a
                                            * más de 28 grados del eje). Si la mirada anterior vio algo y esta ya no, el final de ese algo puede estar justo ahí, donde va a
                                            * pasar la cola: se avanza este paso mínimo y se mira otra vez; solo la segunda mirada despejada seguida deja entrar. */
#define NAV_VUELTA_GIRO_MAX          95    /* un regreso a la línea que pida un primer giro mayor que esto se descarta si hay otro punto más adelante */
/* VISTAZO CON EL LÁSER (V2). El láser mira al frente con un cono de unos 25 grados: una caja corrida de lado que todavía estorba al chasis, o las patas de un
 * mueble, quedan en la orilla del cono y no dan eco; el color sí las ve, pero una sola fuente de visión no detiene al carro. Cuando el color (o la red) ve algo
 * a un LADO durante varios cuadros seguidos y el láser no dice nada, el carro —sin frenar— tuerce el rumbo NAV_VISTAZO_GRADOS hacia ese lado con el control de
 * rumbo del firmware, deja que el láser mire ahí y vuelve. Si el láser da eco válido y cercano, eso SÍ confirma (láser cercano y válido confirma): se detiene
 * y lo rodea por el lado contrario. Si no hay eco, sigue su ruta: no se detuvo ni esquivó. Hace falta el rumbo del firmware (RUMBO=1); sin él no hay vistazo. */
#define NAV_VISTAZO_GRADOS           10    /* cuánto tuerce como mínimo; si lo visto está más de lado, hasta NAV_VISTAZO_GRADOS_MAX (apunta el láser a su orilla de adentro) */
#define NAV_VISTAZO_GRADOS_MAX       16    /* el firmware admite hasta 20 grados del rumbo con que empezó el avance, y al llegar se pasa unos 3 */
#define NAV_RUMBO_FW_SALTO_MAX       20    /* el objetivo de rumbo que se manda nunca se aleja más de esto del rumbo ACTUAL: con más de 30 grados de error el
                                            * firmware deja de corregir (lo toma por un choque) y el carro seguiría torcido hasta el final del avance */
#define NAV_VISTAZO_RACHA             3    /* una raya vertical de tantas celdas seguidas (una pata) basta aunque sean pocas celdas */
#define NAV_VISTAZO_CELDAS_RACHA      3
#define NAV_VISTAZO_MS             1000    /* lo más que dura la ida de un vistazo (termina antes, en cuanto el carro llega al ángulo) */
#define NAV_VISTAZO_ESCUCHA_MS      350    /* ya de vuelta, el láser sigue contando ecos este rato (todavía mira hacia ese lado) */
#define NAV_VISTAZO_LATERAL_MAX_MM  190    /* solo se mira lo que queda a esto o menos del eje del carro (medio carro, 100, más margen): lo de más afuera no estorba */
#define NAV_VISTAZO_VACIO_CUADROS     6    /* cuadros seguidos sin nada en ese lado para dar por terminado lo que se estaba mirando */
#define NAV_VISTAZO_GIRO_MIN_MS     250    /* antes de esto el carro apenas ha torcido: un eco todavía no cuenta como «visto de lado» */
#define NAV_VISTAZO_CUADROS           3    /* cuadros seguidos con algo de una sola fuente en ese lado para dar el vistazo */
#define NAV_VISTAZO_CELDAS_MIN        6    /* y al menos tantas celdas */
#define NAV_VISTAZO_REPOSO_MS      2500    /* (ya no se usa: el vistazo se repite una sola vez por cosa vista, cuando está más cerca) */
#define NAV_VISTAZO_ALCANCE_MM      650    /* un eco válido a esta distancia o menos durante el vistazo confirma */
#define NAV_VISTAZO_ECOS              2    /* lecturas así que hacen falta */
#define NAV_VISTAZO_ENTRE_MS       1200    /* entre el final de un vistazo y el comienzo de otro (el carro vuelve antes a su rumbo y a su línea) */
#define NAV_VISTAZO_VUELTA_MS      1500    /* durante el vistazo y este rato después, el rumbo torcido se corrige avanzando (sin el giro parado de las correcciones) */
#define NAV_SALIDA_TORCIDO_MIN        5    /* si al empezar un rodeo el carro está torcido esto o más respecto de la línea (por un vistazo), el primer giro lo compensa */
#define NAV_SALIDA_TORCIDO_MAX       25
/* BARRIDO DEL GIRO DE SALIDA (V2). El giro de salida no solo adelanta el centro: la esquina delantera del lado contrario barre un arco de hasta
 * NAV_BARRIDO_DER_MM (girando a la derecha, sobre las ruedas derechas) o NAV_BARRIDO_IZQ_MM por delante del centro. Si lo confirmado está más cerca que eso
 * y es ancho (o son las patas de un mueble), la esquina lo toca aunque el centro «quepa». Se aplica a lo que confirmó un VISTAZO (algo a un lado del eje):
 * el eco del vistazo dice dónde hay ALGO, pero puede ser la pata de atrás de un mueble cuyas patas de adelante ya están junto al carro. Por eso, tras un
 * vistazo con eco, el carro retrocede primero NAV_RETROCESO_MAX_MM por el camino que acaba de recorrer (si lo tiene) y solo entonces gira. */
#define NAV_BARRIDO_DER_MM          285
#define NAV_BARRIDO_IZQ_MM          225
#define NAV_BARRIDO_HOLGURA_MM       30
#define NAV_FIN_OBSTACULO_TOL_MM     60    /* al terminar el paso, la cuenta de avance puede quedar unos mm corta (el rumbo se desvía): la pista ya lleva 230 de margen */
#define NAV_DIAGONAL_RESTO_MIN_MM   400    /* el regreso en diagonal solo se usa si después quedan al menos esto de ruta para afinar sobre la línea (si no, cruce corto) */
#define NAV_DESHACER_MAX_MM         450    /* lo más que se deshace en reversa de una diagonal de entrada (nunca más de lo que avanzó) */

/* RUMBO DEL FIRMWARE (J16, ver firmware_carro/rumbo.h y navegador_poner_rumbo_fw). Con el firmware sosteniendo el rumbo al avanzar, el navegador le manda el rumbo
 * que quiere mientras avanza: sobre la línea de la ruta apunta a un punto NAV_RUMBO_MIRA_MM más adelante (si el carro quedó de lado, vuelve a ella poco a poco, sin
 * detenerse); al volver a la línea tras esquivar, apunta al punto planeado; al pasar el obstáculo en paralelo, el rumbo de la línea. Las correcciones de rumbo de
 * hasta NAV_RUMBO_FW_SIN_GIRO grados ya no se hacen con un giro parado: las hace el firmware avanzando. La distancia sigue estimada por tiempo. */
#define NAV_RUMBO_MIRA_MM          400    /* a qué distancia por delante está el punto de la línea al que apunta */
#define NAV_RUMBO_MIRA_MIN_MM      150    /* con menos que esto hasta el final del tramo recto ya no se corrige de lado: solo el rumbo del tramo */
#define NAV_RUMBO_CORR_MAX          12    /* la corrección lateral nunca aparta el rumbo más de esto del rumbo del tramo */
#define NAV_RUMBO_FW_SIN_GIRO        8    /* con RUMBO, un error de rumbo de hasta esto se corrige avanzando (sin el giro parado de siempre) */
#define NAV_RUMBO_FW_CAMBIO_X10      3    /* un objetivo que cambia menos que esto (décimas) no se vuelve a mandar */
#define NAV_RUMBO_FW_MIN_MS        100    /* y no se manda más de uno cada tanto */
#define NAV_RUMBO_PUNTO_MIN_MM     150    /* al volver a la línea, con menos que esto hasta el punto planeado ya no se cambia el objetivo */
#define NAV_OVERRIDE_TOL_MM         30    /* recta con largo fijo: a esto (o menos) del final se da por terminada */

/* Resultado de un giro por ángulo (navegador_aporte_giro). */
#define NAV_GIRO_OK                  0
#define NAV_GIRO_TIMEOUT             1    /* GIRO_TIMEOUT: se acabó el tiempo del firmware (informa el ángulo real) */
#define NAV_GIRO_ERROR_CON_DATOS     2    /* GIRO_ERROR:abortado o sin_imu con el ángulo parcial */
#define NAV_GIRO_ERROR_SIN_DATOS     3    /* GIRO_ERROR:sin_imu, ocupado o angulo: el giro no empezó */

/* Diagnóstico: el navegador escribe líneas de texto (REINC_DIAG, ESQUIVE_DIAG, AYUDA_DIAG, TURN_DIAG y RUTA_DIAG) en una cola chica que la app lee con navegador_diag_siguiente()
 * y copia al log. Si la app no las lee, las más viejas se pierden (no pasa nada).
 *  - RUTA_DIAG: una línea al ENVIAR cada comando de movimiento (FORWARD, REVERSE, LEFT o RIGHT) con lo pedido y la duración planeada, y otra al TERMINARLO con la duración real y lo
 *    hecho (estimado). Sirve para separar «el programa mandó mal el comando» de «el comando fue correcto y el carro no lo hizo» (contacto eléctrico, ver docs/bitacora.md).
 *  - TURN_DIAG: una línea al terminar cada GIRO con los grados pedidos y hechos y el desplazamiento del centro que se aplicó (ver cal_desplazamiento_giro). */
#define NAV_DIAG_LINEAS            16
#define NAV_DIAG_LARGO            340
#define NAV_MAX_GIROS              16   /* cuántos giros recuerda el navegador de la ruta en curso (para la pantalla de resultado) */
#define NAV_DIAG_REPETIR_MS       500   /* una línea ESQUIVE_DIAG igual a la anterior se repite como máximo cada tanto */

/* ── Tipos ─────────────────────────────────────────────────────────────── */

typedef enum {
    NAV_ESPERANDO,
    NAV_SIGUIENDO,
    NAV_DETENIDO_OBSTACULO,
    NAV_ESQUIVANDO,
    NAV_REINCORPORANDO,
    NAV_TERMINADO,
    NAV_ERROR,
    NAV_AYUDA       /* no pudo esquivar y pide que tomes el control (solo con navegador_poner_pedir_ayuda) */
} EstadoNav;

/* Los 5 comandos del protocolo real del carro (texto sin parámetros). */
typedef enum {
    NAV_CMD_STOP,
    NAV_CMD_FORWARD,
    NAV_CMD_REVERSE,
    NAV_CMD_LEFT,
    NAV_CMD_RIGHT
} ComandoNav;

/* Por qué terminó en ERROR. */
typedef enum {
    NAV_MOTIVO_NINGUNO,
    NAV_MOTIVO_LADOS_BLOQUEADOS,   /* obstáculo al frente y ningún lado libre tras el tiempo máximo */
    NAV_MOTIVO_MAX_ESQUIVADAS,     /* ya esquivó NAV_MAX_ESQUIVADAS veces y vuelve a haber obstáculo */
    NAV_MOTIVO_ESQUIVANDO,         /* apareció un obstáculo muy cerca mientras esquivaba */
    NAV_MOTIVO_PLAN,               /* no se pudo calcular el camino de regreso a la ruta */
    NAV_MOTIVO_SIN_VIDEO           /* la cámara dejó de mandar cuadros más de NAV_MAX_HUECO_VIDEO_MS: se detuvo y NO reanuda sola */
} MotivoErrorNav;

/* Causa concreta del ERROR (campo `error_causa`; navegador_texto_error la convierte en una frase con los números). */
#define NAV_CAUSA_NINGUNA                0
#define NAV_CAUSA_LADOS                  1   /* los dos lados estaban ocupados durante NAV_TIMEOUT_ESQUIVAR_MS */
#define NAV_CAUSA_MAX_ESQUIVADAS         2   /* ya esquivó NAV_MAX_ESQUIVADAS veces y el obstáculo seguía en el camino */
#define NAV_CAUSA_REINTENTOS             3   /* se agotaron los reintentos de esquive y el obstáculo seguía en el centro */
#define NAV_CAUSA_PLAN                   4   /* no se pudo calcular el camino */
#define NAV_CAUSA_SIN_VIDEO              5   /* la cámara dejó de mandar cuadros */
#define NAV_CAUSA_ARCO                   6   /* el giro de salida mueve el centro más hacia adelante de lo que hay libre hasta el obstáculo (en los dos lados) */
#define NAV_CAUSA_CORRECCIONES           7   /* se agotaron las correcciones de la vuelta a la línea y el carro seguía lejos del punto planeado */
#define NAV_CAUSA_VUELTA                 8   /* la vuelta a la línea no tiene solución con los giros de pivote (el punto de la línea queda detrás o el plan no converge) */
#define NAV_CAUSA_GIRO_LOCO              9   /* freno anti-locura: un giro planeado de más de NAV_LOCURA_GIRO_MAX grados que no está en la ruta */
#define NAV_CAUSA_INDICE                10   /* freno anti-locura: el índice del siguiente punto de la ruta retrocedió */
#define NAV_CAUSA_RECORRIDO             11   /* freno anti-locura: recorrió más de 2.5 veces la distancia de la ruta */
#define NAV_CAUSA_LEJOS                 12   /* freno anti-locura: la pose quedó a más de 1 m de la ruta */
#define NAV_CAUSA_SIN_CONFIRMACION      13   /* reservado, historico: ya no se emite por desacuerdo */
#define NAV_CAUSA_OBSTACULO_NO_PASADO   14   /* la recta no alcanza o la vuelta sigue bloqueada */
#define NAV_CAUSA_FIN_NO_LIBRE          15   /* no se pudo comprobar el frente libre al cerrar */
#define NAV_CAUSA_FRENTE_ANCHO          16   /* V2: pared u objeto más ancho que el rodeo máximo (medido con el láser al girar): no hay por dónde */
#define NAV_CAUSA_SIN_PERCEPCION        17   /* V2: la red neuronal dejó de dar resultados vigentes: no se puede confirmar nada por visión */
#define NAV_CAUSA_GIRO_BLOQUEADO        18   /* V2 (revisión): el láser vio algo DENTRO del arco que barre el chasis al girar para rodear: el carro dejó de girar */
#define NAV_CAUSAS                      19   /* cuántos códigos hay (para tablas) */

/* Fases de la maniobra de esquivar (campo `fase`). El camino normal es GIRAR → MIRAR → AVANZAR → VOLVER; si al mirar el frente sigue muy
 * cerca: MIRAR → RETROCEDER → ASENTAR → GIRAR (con ángulo extra) → MIRAR... hasta NAV_MAX_REINTENTOS. */
#define NAV_FASE_GIRAR        0   /* girar hacia `lado` angulo_giro grados */
#define NAV_FASE_AVANZAR      1   /* avanzar de lado NAV_TRAMO_ESQUIVAR_CM */
#define NAV_FASE_VOLVER       2   /* deshacer el giro (angulo_total) */
#define NAV_FASE_MIRAR        3   /* STOP: espera a que el carro pare y a que llegue un cuadro que lo muestre parado, y decide */
#define NAV_FASE_RETROCEDER   4   /* REVERSE NAV_RETROCESO_CM cm (ciego) */
#define NAV_FASE_ASENTAR      5   /* STOP NAV_PAUSA_ASENTAR_MS antes de girar otra vez */
#define NAV_FASE_PAUSA_PASAR  6   /* STOP NAV_PAUSA_ASENTAR_MS después de enderezarse; al terminar calcula cuánto debe avanzar en paralelo */
#define NAV_FASE_PARALELO     7   /* FORWARD paralelo a la línea hasta pasar el obstáculo (nav->paralelo_mm) */
#define NAV_FASE_PAUSA_VOLVER 8   /* STOP NAV_PAUSA_ASENTAR_MS entre AVANZAR y VOLVER (sin ella el giro hereda la inercia del avance) */
#define NAV_FASE_PAUSA_RETROCEDER 9   /* STOP NAV_PAUSA_ASENTAR_MS antes de RETROCEDER cuando venía avanzando (no pasa de FORWARD a REVERSE de golpe) */

/* Fases de REINCORPORANDO (campo `reinc_fase`): PLAN (STOP, calcula) → GIRO1 → PAUSA → AVANZAR → PAUSA → GIRO2 → PAUSA → SIGUIENDO. Las fases de giro que no hacen
 * falta (ángulo casi cero) se saltan. */
#define NAV_RF_PLAN           0   /* quieto NAV_PAUSA_ASENTAR_MS y calcula el punto de la línea y los ángulos */
#define NAV_RF_GIRO1          1   /* gira hacia el punto de la línea (giro mínimo) */
#define NAV_RF_PAUSA1         2   /* STOP */
#define NAV_RF_AVANZAR        3   /* avanza la distancia estimada hasta el punto de la línea */
#define NAV_RF_PAUSA2         4   /* STOP */
#define NAV_RF_GIRO2          5   /* gira al rumbo original de la línea */
#define NAV_RF_PAUSA3         6   /* STOP; al terminar la pausa vuelve a SIGUIENDO */
#define NAV_RF_VERIFICAR      7   /* STOP; verifica frente libre antes de retomar la ruta */
#define NAV_RF_PAUSA_DESHACER 8   /* V2: STOP antes de deshacer en reversa la diagonal de entrada (la entrada se ocupó a medio camino) */
#define NAV_RF_DESHACER       9   /* V2: REVERSE lo que llevaba de la diagonal (por donde acaba de pasar); después sigue de largo por el carril */

/* Códigos de retorno de las funciones de configuración. */
#define NAV_OK                 0
#define NAV_ERR_ARGUMENTO     -1   /* puntero nulo o ruta vacía */
#define NAV_ERR_RUTA          -2   /* la ruta no es válida (ver codigo_trayectoria) */
#define NAV_ERR_ESTADO        -3   /* esa función no se puede usar en el estado actual */

/* Lo que pasó en un giro (para la pantalla de resultado: «Giro pedido / Giro hecho (estimado)»). */
typedef struct {
    int lado;                  /* CAL_LADO_IZQUIERDA o CAL_LADO_DERECHA */
    int origen;                /* EstadoNav en el que se hizo: SIGUIENDO (la ruta), ESQUIVANDO, REINCORPORANDO (vuelta a la línea) o AYUDA (a mano) */
    int pedido_grados;         /* grados que pidió el programa (0 si fue a mano) */
    int hecho_grados;          /* grados que el navegador estima que giró (con la cámara si era confiable, si no por tiempo; incluye lo que sigue girando al frenar) */
    int plan_ms;               /* duración planeada del comando */
    int real_ms;               /* duración real */
    int desp_adelante_mm;      /* desplazamiento del centro durante el giro, en el marco del carro al empezar el giro */
    int desp_derecha_mm;
    int por_angulo;            /* 1 si el giro lo midió el giroscopio del firmware (hecho_grados es el ángulo REAL medido); 0 si fue por tiempo */
} NavGiro;

typedef struct {
    /* Calibración del carro (arranque, ms por cm, frenado, ms por grado de cada lado). */
    CalibracionCarro cal;

    /* Ruta original (celdas) y camino actual (pasos por tiempo). */
    Punto ruta[MAX_PUNTOS];
    int   n_puntos;
    int   indice_objetivo;       /* punto de la ruta al que se dirige (1 = el segundo) */
    Paso  pasos[MAX_PASOS];
    int   n_pasos;
    int   indice_paso;
    int   ms_paso;               /* tiempo ya ejecutado del paso actual */

    /* Estado general. */
    EstadoNav      estado;
    MotivoErrorNav motivo_error;
    int            codigo_trayectoria;   /* último código de trayectoria.c (si hubo error de ruta) */
    ComandoNav     cmd_actual;           /* el comando que se devolvió en el último tick */
    uint32_t       t_ultimo_ms;          /* hora del último tick */
    uint32_t       t_detenido_ms;        /* hora en que se detuvo por obstáculo */
    int            asentando;            /* 1 mientras espera detenido entre dos movimientos distintos */
    int            usa_camara;           /* 1 desde que llegó el primer cuadro de obstáculos en esta ruta (con la fuente de botones no hay huecos que vigilar) */
    int            requiere_camara;      /* 1 = la ruta usa la cámara: no se mueve hasta el primer cuadro y, si no llega en NAV_PRIMER_CUADRO_MAX_MS, ERROR sin video */
    uint32_t       t_ultimo_cuadro_ms;   /* hora del último cuadro de obstáculos recibido */
    uint32_t       asentar_hasta_ms;     /* hora en que termina esa espera */

    /* Posición estimada: milímetros (x hacia la derecha, y hacia abajo) y rumbo en grados
     * (0 = arriba, positivo = hacia la derecha, 0 a 359). */
    int x_mm, y_mm, rumbo_grados;
    int base_x_mm, base_y_mm, base_rumbo_grados;   /* pose al empezar el comando actual */
    int rumbo_x10, base_rumbo_x10;                 /* J16: el mismo rumbo con décimas (0 a 3599). rumbo_grados es su redondeo; al empezar cada comando ya no se pierde la fracción
                                                    * (con sin_trig_fino = 1 es siempre rumbo_grados x 10, lo de J15) */
    int seg_ms;                                    /* tiempo bajo el comando actual */
    int giro_visual_x10;         /* grados por 10 que la cámara vio girar, en la dirección del comando de giro actual */
    int visual_cubierto_ms;      /* cuánto tiempo del giro actual cubren los cuadros confiables de la cámara */
    int frenar_lejos_centro;     /* 1 = también frena con cercanía 1 en el centro (ver NAV_MS_CONFIRMAR_CENTRO_LEJOS); 0 = como siempre */
    int solo_lejos_centro;       /* 1 mientras la racha de bloqueo actual es SOLO por esa regla (se confirma con menos tiempo que un obstáculo de lado) */
    int latencia_visual_ms;      /* retraso de la cámara: un cuadro que llega ahora muestra lo que pasó hace esto (0 = sin retraso) */

    /* Lo último que se vio del obstáculo. */
    int zona_hay[OBS_ZONAS];     /* hay obstáculo en la zona (cualquiera): lo usa elegir_lado, para no apartarse hacia un obstáculo */
    int zona_cercania[OBS_ZONAS];
    int zona_frena[OBS_ZONAS];       /* hay obstáculo en la zona Y está dentro del corredor (sin corredor = zona_hay): esto es lo que frena */
    int zona_cerc_frena[OBS_ZONAS];  /* cercanía con la que frena (la del corredor si hay; si no, la de siempre); 0 si no frena */
    int zona_en_corredor[OBS_ZONAS]; /* 1 si el corredor (activo) dice que el obstáculo de la zona está en el camino del carro; sin corredor siempre 0 */
    int frames_bloqueado;        /* cuadros seguidos con obstáculo al frente */
    int frames_libre;            /* cuadros seguidos con el frente libre */
    int frames_recibidos;        /* cuadros desde la última detención */
    uint32_t t_bloqueo_ms;       /* hora del primer cuadro de la racha con obstáculo al frente */
    uint32_t t_libre_ms;         /* hora del primer cuadro de la racha con el frente libre */
    int bloqueo_inmediato;       /* 1 si en la racha hubo un cuadro de confirmación inmediata */

    int zona_celdas[OBS_ZONAS];  /* cuántas celdas de obstáculo tenía cada zona en el último cuadro (para elegir el lado con más espacio) */

    /* Esquivar. */
    int esquivadas;              /* maniobras y extensiones de rodeo de toda la ruta (para la pantalla y el tope NAV_MAX_ESQUIVADAS_RUTA) */
    int esquivadas_obstaculo;    /* V2: las del obstáculo actual (tope NAV_MAX_ESQUIVADAS); se repone al dejarlo atrás */
    int lado;                    /* -1 = izquierda, +1 = derecha */
    int fase;                    /* NAV_FASE_*: qué hace ahora la maniobra de esquivar */
    int ms_fase;
    int reintentos;              /* cuántos reintentos (retroceder + girar más) lleva esta esquivada */
    int angulo_giro;             /* grados que debe girar la fase GIRAR actual (90 la primera vez; 45 o 90 en los reintentos) */
    int angulo_total;            /* grados girados hacia `lado` en total desde que empezó la esquivada (para deshacerlos al final) */
    uint32_t t_mirar_ms;         /* hora en que el carro quedó quieto para mirar si el frente está libre */

    /* Detección durante la esquivada: giros, cuadros estables y racha de obstáculo central. */
    int      error_causa;            /* NAV_CAUSA_*: por qué terminó en ERROR (con motivo_error) */
    int      esq_en_giro;            /* 1 mientras la maniobra gira (los cuadros de ese momento se ignoran) */
    uint32_t esq_t_giro_ini_ms;      /* hora en que empezó el último giro de la maniobra */
    uint32_t esq_t_giro_fin_ms;      /* hora en que terminó */
    int      esq_cuadros_tras_giro;  /* cuadros que han llegado desde que terminó el giro */
    int      centro_frames;          /* cuadros seguidos (no ignorados) con obstáculo central de cercanía >= NAV_ESQ_CERCANIA_BLOQUEA */
    uint32_t centro_t_ms;            /* hora del primer cuadro de esa racha */
    int      zona_fila_min[OBS_ZONAS], zona_fila_max[OBS_ZONAS];   /* filas y columnas de las celdas de obstáculo de cada zona en el último cuadro (-1 = no se sabe) */
    int      zona_col_min[OBS_ZONAS], zona_col_max[OBS_ZONAS];
    int      zona_borde_cerca[OBS_ZONAS];                          /* 1 si durante esquive/reincorporación las columnas 0 o 9 tienen obstáculo en filas 7 a 9 */

    /* Pedir ayuda (modo «toma el control»). */
    int            pedir_ayuda;      /* 1 = en vez de ERROR por no poder esquivar, pasa a AYUDA */
    ComandoNav     ayuda_cmd;        /* el comando que el usuario manda ahora con la cruceta */
    uint32_t       ayuda_t_ini_ms;   /* hora en que pidió ayuda */
    MotivoErrorNav ayuda_motivo;     /* por qué la pidió (el motivo con el que habría dado ERROR) */
    int            ayudas;           /* cuántas veces pidió ayuda en esta ruta */
    int            desde_ayuda;      /* 1 mientras vuelve a la línea después de que el usuario tomó el control (ahí sí se da por terminada la ruta si ya pasó el final) */

    /* Dónde salió de la línea (pose estimada al empezar la esquivada). */
    int salida_x_mm, salida_y_mm, salida_rumbo;
    int salida_cercania;         /* cercanía (1 a 3) con la que frenó: dice a qué distancia estaba el obstáculo */
    int cerc_detenido_max;       /* la mayor cercanía (dentro del corredor) vista desde que se detuvo por obstáculo hasta decidir: el último cuadro puede venir vacío */
    int fin_obstaculo_mm;        /* hasta dónde (distancia a lo largo de la ruta) se supone que llega el último obstáculo que lo detuvo; -1 = ninguno */
    int obstaculo_pendiente;     /* exige superar fin_obstaculo y verificar el frente antes de retomar */
    int fuentes_vision[OBS_ZONAS], vision_sin_coincidencia, precaucion;
    int borde_reintentos, fondo_observado_mm, cara_obstaculo_s_mm, lateral_objetivo_mm;
    int extension_ruta_mm, cierre_reintento;
    int atras_conocido_mm, escape_atras;
    uint32_t precaucion_pausa_ms;
    int verificando_frente, fin_pendiente, fin_verificado;
    uint32_t verificar_frente_ms;
    int paralelo_mm;             /* cuánto debe avanzar en paralelo a la línea para pasar el obstáculo (se calcula al terminar de enderezarse) */

    /* Reincorporación a la línea (REINCORPORANDO). Se calcula una vez, en la fase PLAN, y se ejecuta por fases (NAV_RF_*). */
    int      reinc_fase;
    uint32_t reinc_t_fase_ms;        /* hora en que empezó la fase actual (las pausas se miden con la hora, no con ticks) */
    int      reinc_solo_rumbo;       /* 1 = estaba a menos de NAV_REINC_DESVIO_MIN_MM de la línea: solo corrige el rumbo */
    int      reinc_obj_x_mm, reinc_obj_y_mm;   /* punto de la línea al que vuelve */
    int      reinc_rumbo_final;      /* rumbo original de la línea en ese punto */
    int      reinc_giro1, reinc_giro2;         /* grados con signo (+ derecha) del giro hacia el punto y del giro final */
    int      reinc_dist_mm;          /* distancia que avanza entre los dos giros */
    int      reinc_indice_obj;       /* punto de la ruta al que se dirige después de volver */
    int      reinc_desvio_mm;        /* a cuánto estaba de la línea al empezar a volver */
    int      reinc_antes_x_mm, reinc_antes_y_mm, reinc_antes_rumbo;   /* pose estimada al empezar a volver */
    int      volver_a_reinc;         /* 1 si lo que detuvo al carro ocurrió mientras avanzaba hacia la línea: al liberarse el frente vuelve a calcular la vuelta */
    int      reinc_pasar_primero;    /* 1 = esta vuelta solo endereza y avanza en paralelo hasta pasar el obstáculo; al terminar calcula la vuelta de verdad */
    int      reinc_plan_x_mm[3], reinc_plan_y_mm[3];   /* posición PLANEADA al terminar el giro 1, el avance y el giro 2 (la red de seguridad la compara con la estimada) */
    int      reinc_correcciones;     /* cuántas veces se volvió a planear esta vuelta (máximo NAV_PLAN_CORRECCIONES) */
    int      corr_rumbo_vertice;     /* vértice de la ruta (indice_objetivo) al que corresponde corr_rumbo_cuenta; -1 = ninguno */
    int      corr_rumbo_cuenta;      /* giros de corrección de rumbo (más de 4°) ya planeados para ese vértice (tope 2, ver navegador.c) */
    int      apunte_k_esq;           /* vértice de esquina del tramo que se está planeando apuntando al punto de parada (por el desplazamiento de un giro grande); -1 = ninguno */
    int      reinc_rumbo_importa;    /* 1 = al terminar la vuelta el rumbo debe ser el de la línea (0 cuando el punto es el final de la ruta y se llega sin giro final) */
    int      tramo_mm;               /* lo que avanza de lado esta esquivada (planeado al terminar de mirar, con el desplazamiento de los giros) */
    int      sin_red_seguridad;      /* 1 = la red de seguridad de la vuelta está apagada (solo para comparar en las pruebas; por defecto 0 = activa) */
    int      sin_arreglo_indice;     /* 1 = NO se saltan los puntos de la ruta ya pasados al terminar la vuelta (solo para reproducir en las pruebas el bug del índice vencido; por defecto 0) */
    int      reinc_rumbo_tol;        /* el rumbo al terminar la vuelta se corrige si queda a más de esto de la línea (3 por defecto; NAV_RUMBO_FINAL_TOL al final de la ruta) */

    /* Arranque, sondeo del obstáculo fijo y frenos anti-locura (J9). */
    int      arranque_ok;            /* 1 cuando ya se decidió el arranque (4 cuadros iguales o se acabó el tiempo) */
    int      arranque_iguales;       /* cuadros seguidos con la misma firma de zonas */
    int      arranque_firma;         /* firma de zonas de esos cuadros: 2 bits (cercanía con obstáculo) por zona; 0 = sin obstáculo */
    uint32_t arranque_t0_ms;         /* hora en que empezó la ruta */
    int      bloqueo_cerc3;          /* 1 si la racha tiene cercanía 3 con pocas celdas (necesita 2 cuadros seguidos) */
    int      sondeo_hecho;           /* 1 si ya se hizo (o se descartó) el sondeo de esta ruta: solo se hace uno */
    int      sondeo_fase;            /* 0 = ninguno, 1 = avanzando NAV_SONDEO_CM cm, 2 = mirando si las celdas crecen */
    int      sondeo_ms;              /* cuánto debe avanzar el sondeo */
    int      ms_sondeo;              /* cuánto lleva avanzado */
    int      sondeo_zonas;           /* bits de las zonas que tenían el obstáculo */
    int      sondeo_ref;             /* celdas de esas zonas antes de avanzar */
    long     sondeo_suma;            /* suma de las celdas vistas después (para el promedio) */
    int      sondeo_n;
    uint32_t sondeo_listo_ms;        /* desde esta hora cuentan los cuadros de después del sondeo */
    int      fijo_ignorar[OBS_ZONAS];   /* 1 = esa zona tiene un «sospechoso fijo»: se ignora mientras sus celdas no crezcan ni cambie su firma */
    int      fijo_celdas[OBS_ZONAS];
    char     fijo_hex[OBS_ZONAS][26];   /* firma hexadecimal (10 x 10) de las celdas del sospechoso fijo en cada zona */
    int      frenado_pendiente;         /* 1 = el paso actual frenó de FORWARD a STOP y su ajuste aún no se ha aplicado */
    int      sin_compensar_giro;        /* 1 = planificar() no compensa el desplazamiento del giro (solo para medir el antes/después en pruebas) */
    int      indice_max;             /* el mayor índice de punto de la ruta visto (si el índice baja de aquí, frena) */
    long     recorrido_mm;           /* distancia total que el centro ha recorrido en esta ruta (estimada) */
    int      prev_x_mm, prev_y_mm;
    long     ruta_largo_mm;          /* largo de la ruta */
    long     ruta_largo_original_mm; /* V2: el largo de la ruta tal como se dibujó (ruta_largo_mm crece si un rodeo obliga a prolongar la última recta) */
    int      tramo_base;             /* V2: el tramo de la ruta más adelantado por el que ya pasó el carro durante un rodeo (ubicar_en_linea busca desde ahí: una pasada de
                                      * dos obstáculos seguidos se sale de la ventana que parte del punto donde se detuvo) */
    int      retroceso_mm;           /* V2: cuánto retrocede el escape actual (150 de siempre, o lo que falta para que quepa el giro de salida, hasta lo que se sabe libre) */
    int      lateral_tope_mm;        /* V2: lo más que puede apartarse de la línea el rodeo actual (NAV_BORDEAR_LATERAL_MAX o lo que deja la pared que midió el barrido) */
    int      mirada_fallida;         /* V2: la mirada antes de entrar vio ocupada la entrada: el siguiente tramo es un paso y otra mirada (no una pista entera).
                                      * 1 = paso corto; 2 = paso corto y carril más abierto (lo visto está pegado al costado); 3 = paso largo (lo visto está más adelante);
                                      * 4 = paso de confirmación (mirada despejada justo después de una ocupada); 5 = paso corto, lo visto queda solo del lado de atrás */
    int      reinc_deshacer_mm;      /* V2: cuánto de la diagonal de entrada hay que deshacer en reversa */
    int      precaucion_modo;        /* V2: cuándo «avanza a ratos» por una sola fuente de visión sin eco del láser (NAV_PRECAUCION_*); ver navegador_poner_precaucion */
    int      modelo_requerido;       /* V2: 1 si la ruta cuenta con el detector de objetos (navegador_aporte_modelo) */
    int      modelo_vigente;         /* su último resultado sigue vigente */
    int      modelo_visto;           /* 1 desde la primera llamada de esta ruta (ahí empieza a contar el plazo) */
    uint32_t modelo_t_ok_ms;         /* última vez que estuvo vigente (o el comienzo del plazo) */
    int      vistazo_modo_mas1;      /* V2: NAV_VISTAZO_* + 1 (0 = sin fijar: vale el valor por defecto NAV_VISTAZO_POR_DEFECTO); ver navegador_poner_vistazo */
    int      coinc_detenido;         /* V2: cuadros con coincidencia de las dos fuentes desde que el carro se detuvo (para esquivar sin láser hacen falta varios) */
    int      esquive_decidido;       /* (revisión) 1 = el rodeo ya estaba decidido y solo se retrocedió para que cupiera el giro: al terminar de retroceder se rodea */
    int      coinc_esquivar_min;     /* (revisión) cuántos hacen falta en esta parada: NAV_COINCIDENCIA_CUADROS_ESQUIVAR, o uno más si la frenó un solo cuadro */
    int      coinc_seguidas[OBS_ZONAS];   /* V2: cuadros seguidos con las dos fuentes en cada zona */
    int      vistazo_lado;           /* V2, VISTAZO: -1 izquierda, +1 derecha, 0 = no hay vistazo en curso */
    uint32_t vistazo_t_ms;           /* cuándo empezó */
    int      vistazo_ecos;           /* lecturas válidas y cercanas del láser durante el vistazo */
    int      vistazo_mm;             /* la menor de ellas */
    int      vistazo_cuadros[2];     /* cuadros seguidos con algo de una sola fuente en ese lado (0 izquierda, 1 derecha) */
    uint32_t vistazo_ultimo_ms[2];   /* cuándo terminó el último vistazo hacia cada lado */
    int      vistazo_hecho[2];       /* con qué cercanía se dio (0 = todavía ninguno en esta ruta) */
    int      vistazo_cerc[2];        /* lo visto a cada lado en el último cuadro: cercanía (1 a 3, por la fila más baja), */
    int      vistazo_n[2];           /* celdas, */
    int      vistazo_grados_lado[2]; /* y a cuántos grados del eje de la cámara queda su columna media */
    int      vistazo_grados;         /* cuánto tuerce el vistazo en curso */
    int      vistazo_fase;           /* 1 = yendo (el rumbo torcido); 2 = ya de vuelta, el láser sigue escuchando NAV_VISTAZO_ESCUCHA_MS */
    uint32_t vistazo_fase_ms;        /* cuándo empezó la fase 2 */
    int      vistazo_lateral_mm[2];  /* a cuánto del eje del carro queda la orilla de adentro de lo visto a cada lado (estimado con la cámara SUPUESTA) */
    int      vistazo_vacio[2];       /* cuadros seguidos sin nada en ese lado */
    int      vistazo_solo_red[2];    /* 1 si lo de ese lado en el último cuadro es solo una caja de la red (sin celdas de color) */
    int      vistazo_red_hecho[2];   /* 1 si a la caja de la red de ese lado ya se le dio su vistazo (no gasta los del color) */
    int      vistazo_confirmado;     /* lado del objeto que confirmó un vistazo: se rodea por el otro (0 = ninguno) */
    int      vistazo_retrocedio;     /* 1 si ya se retrocedió por lo que confirmó ese vistazo (se hace una sola vez, antes del primer giro) */
    int      rodeo_por_vistazo;      /* 1 si el rodeo en curso empezó por un vistazo: lo confirmado está a un LADO del eje, no de frente */
    uint32_t vistazo_fin_ms;         /* cuándo terminó el último vistazo (hacia cualquier lado) */
    int      vistazo_alguno;         /* 1 si ya hubo alguno en esta ruta (vistazo_fin_ms vale) */
    int      cmd_previo;             /* el comando anterior al actual (para saber si el carro está parado después de un avance) */
    int      vistazos;               /* vistazos dados en la ruta */
    int      vistazos_con_eco;       /* y cuántos confirmaron */
    int      giro_extra_grados;      /* el primer giro del rodeo trae estos grados de más (o de menos) para deshacer lo torcido; la vuelta no los cuenta */
    int      salida_linea_rumbo;     /* V2: rumbo de la LÍNEA de la ruta donde empezó el rodeo (salida_rumbo es el del carro al salir, que puede traer 2 o 3 grados de error) */
    int      salida_linea_ok;        /* 1 si vale */
    int      mirada_previa_fallida;  /* V2: la mirada anterior vio ocupada la entrada: la primera mirada despejada que le siga se confirma con otra un paso más adelante */
    int      max_giro_ruta;          /* el mayor giro que pide la propia ruta (grados) */
    char     obs_hex[OBS_ZONAS][26]; /* de lo último que se vio: la máscara de 10 x 10 en hexadecimal de cada zona (OBS_DIAG) */
    int      obs_franja_tapada, obs_franja_pct;
    int      arco_adelante_mm, arco_libre_mm;   /* para el texto de NAV_CAUSA_ARCO: cuánto mueve el giro de salida el centro hacia adelante y cuánto había libre */

    /* Registro del comando de movimiento en curso (RUTA_DIAG) y de los giros de la ruta. */
    int cmd_pedido;              /* lo que se pidió al empezar el comando: grados (giros) o mm (avance y retroceso); 0 = no se pidió nada (a mano) */
    int cmd_plan_ms;             /* duración planeada */
    int cmd_origen;              /* EstadoNav en el que empezó */
    NavGiro giros[NAV_MAX_GIROS];
    int     n_giros;             /* giros anotados (como máximo NAV_MAX_GIROS) */
    int     giros_perdidos;      /* giros que ya no cupieron */

    /* Giroscopio y láser (J11). */
    int      usa_giroscopio;         /* 1 = los giros se piden al firmware por ángulo (configuración; por defecto 0 = por tiempo como siempre) */
    int      usa_tof;                /* 1 = se hace caso al láser: TOF_PARO y la confirmación de la cámara (configuración; por defecto 0) */
    int      autoridad_laser;        /* apagado por defecto; solo lectura válida y fresca, la cámara elige el lado */
    int      contradiccion_laser;    /* última contradicción anunciada (0 ninguna, 1 láser cerca, 2 cámara cerca) */
    int      giro_fw_caido;          /* 1 = en esta ruta el giro por ángulo falló: el resto de los giros va por tiempo */
    int      giro_fw;                /* 1 mientras el giro actual lo hace el firmware */
    int      giro_fw_estado;         /* 0 = esperando la respuesta, 1 = ya llegó el ángulo real */
    int      giro_fw_pedir;          /* 1 = falta mandar GIRAR (la app lo toma con navegador_tomar_giro_fw) */
    int      giro_fw_grados;         /* grados pedidos con la convención del navegador (+ derecha) */
    int      giro_fw_real_x10;       /* grados por 10 que giró de verdad, en la dirección del comando */
    int      giro_fw_ms;             /* lo que tardó el firmware */
    int      giro_fw_ant;            /* anticipación del firmware en ms */
    uint32_t giro_fw_t_ms;           /* hora en que se pidió */
    int      giro_fw_ang_ini_x10;    /* ángulo del giroscopio (convención del firmware, + izquierda) al empezar el giro por ángulo; solo vale si giro_fw_ang_ini_ok */
    int      giro_fw_ang_ini_ok;
    int      giro_fw_consultando;    /* 1 desde que se acabó la espera sin respuesta hasta que se resuelve con IMU? (o el último SENS) */
    int      giro_fw_consulta_pedir; /* 1 = falta mandar IMU? (la app lo toma con navegador_tomar_consulta_imu) */
    uint32_t giro_fw_consulta_t_ms;
    int      sens_angulo_x10;        /* el último ángulo que dijo SENS (+ izquierda) y la hora en que llegó */
    uint32_t sens_angulo_t_ms;
    int      sens_angulo_ok;
    /* J15: distancia por tiempo, dirección observada con SENS durante avances.
     * Se conserva el residuo en milésimas de mm para no redondear cada tick. */
    int      sin_rumbo_medido;        /* solo comparación de pruebas: comportamiento previo */
    int      avance_imu_ref_ok, avance_imu_ref_x10, avance_rumbo_ref_x10;
    int      avance_rumbo_x10, avance_mm_previo;
    long     avance_x_mil, avance_y_mil;
    int      n_giros_angulo, n_giros_tiempo;   /* cuántos giros de la ruta fueron por ángulo y cuántos por tiempo (para el resumen final) */
    int      tof_vivo;               /* 1 si el láser funciona (según SENS) */
    int      tof_mm;                 /* última lectura (1200 = libre) */
    int      tof_valida;             /* 1 si esa lectura fue una medida real */
    int      tof_libre_lecturas;     /* lecturas válidas seguidas mayores que NAV_TOF_LIBRE_MM */
    int      tof_despejado_lecturas; /* V2: lecturas válidas seguidas mayores que NAV_FIN_HOLGURA_MM (nada confirmado en el frente inmediato) */
    int      fin_delante_mm;         /* V2: al terminar, lo que el láser medía delante (0 = sin eco o sin dato): la app puede decir «hay algo a N cm del destino» */
    int      giro_fw_min;            /* V2: el menor giro que acepta el firmware (5; 2 con el giro fino, CAPS GMIN): con el giroscopio sano uno menor NO se hace por tiempo */
    int      giro_fw_fallos;         /* V2: giros por ángulo fallidos en esta ruta */
    /* V2: rodeo medido (ver NAV_ESQ_HOLGURA_VOLVER_MM). */
    int      scan_ext_mm;            /* hasta dónde (mm desde la línea, hacia el lado del rodeo) midió el láser el obstáculo del frente durante el primer giro; 0 = no lo vio */
    int      scan_pared_mm;          /* distancia lateral (mm) a algo que está del lado del rodeo (una pared); 0 = nada */
    int      scan_muestras;          /* lecturas válidas usadas */
    int      scan_corte;             /* 1 = el barrido no pudo comprobar dónde termina la cara (se salió del alcance del láser viéndola todavía): se toma como cerrado */
    /* Las lecturas del barrido (una por SENS): dónde pega el láser (s a lo largo de la ruta, lado hacia el costado medido), a qué ángulo del frente (grados) y, si no
     * hubo eco, lo que habría que medir para seguir viendo la cara. Se analizan al terminar el giro (escaneo_analizar). */
    int      scan_s[NAV_ESCANEO_MAX], scan_lado[NAV_ESCANEO_MAX], scan_grados[NAV_ESCANEO_MAX], scan_eco[NAV_ESCANEO_MAX], scan_sensor_s[NAV_ESCANEO_MAX];
    int      scan_n;
    int      sens_angulo_previo_x10; /* el ángulo del SENS anterior: la distancia de SENS es la mediana de 3 lecturas (~50 ms más vieja que su ángulo) */
    int      ancho_rodeo_mm;         /* el ancho que se usó para dimensionar el rodeo (medido o supuesto) */
    int      borde_lejos[2];         /* celdas «no piso» en el borde lejano izquierdo [0] y derecho [1] del último cuadro */
    int      color_cercania[OBS_ZONAS];   /* la cercanía (1 a 3) que traía cada zona en el último cuadro, aunque la marcara una sola fuente */
    long     flanco_s_mm;            /* dónde iba el carro (a lo largo de la ruta) la última vez que el costado del objeto estaba a la vista */
    int      flanco_vistas;          /* cuántos cuadros lo vieron durante el paso en paralelo */
    int      flanco_otro;            /* 1 = lo que asoma de ese lado es OTRO objeto más adelante (hubo NAV_FLANCO_OTRO_MM de paso sin ver nada): pista más larga */
    /* V2, CAMBIO DE LADO: si el láser mide que el lado elegido está cerrado (pared u objeto muy ancho, o sin espacio), el carro sigue girando EN EL MISMO SENTIDO
     * (media vuelta y un cuarto más: una vuelta completa sobre la misma rueda, que no lo acerca al obstáculo) y en el último cuarto mide el otro lado. Si está libre
     * rodea por ahí; con los dos cerrados pide ayuda (NAV_CAUSA_FRENTE_ANCHO) mirando otra vez al frente. Volver de frente giraría sobre la rueda del lado del
     * obstáculo y acercaría el chasis 16 a 28 cm. */
    int      lados_probados;         /* 0 = solo el primer lado; 1 = ya se midió (o se está midiendo) el otro */
    int      cambio_lado;            /* 0 = no; 1 = dando la media vuelta; 2 = dando el último cuarto (midiendo el otro lado) */
    int      deshacer_giro;          /* (revisión) 1 = la guardia detuvo el primer giro y se está deshaciendo para rodear por el otro lado */
    int      otro_lado_libre;        /* (revisión) 1 si, al detenerse, la cámara veía libre el lado contrario al del rodeo: sin eso no se da la vuelta para medirlo */
    int      atras_al_salir_mm;      /* (revisión) lo que el carro acababa de avanzar en recta cuando empezó el rodeo (atras_conocido_mm antes del primer giro) */
    long     pasar_s_mm;             /* (revisión) la cuenta a lo largo de la ruta en el último plan de «pasar primero» */
    int      pasar_sin_avance;       /* (revisión) planes seguidos de «pasar primero» en los que esa cuenta no avanzó */
    int      scan_signo;             /* +1 = el escaneo mide hacia `lado`; -1 = hacia el lado contrario (durante el cambio de lado) */
    int      tof_cerca_lecturas;     /* lecturas válidas seguidas de 1 a NAV_REACCION_MAX_MM */
    uint32_t tof_t_ms;               /* hora de la última lectura */
    int      tof_paro_activo;        /* 1 desde TOF_PARO hasta que empieza a esquivar */
    int      tof_pendiente;          /* 1 = TOF_PARO llegó mientras esquivaba o volvía a la línea: lo atiende el siguiente tick */
    int      tof_paros;              /* TOF_PARO recibidos en esta ruta */
    int      tof_dist_mm;            /* distancia al obstáculo que midió el láser al detenerse (0 = no se sabe) */
    int      racha_solo_centro2;     /* 1 si la racha de bloqueo actual es SOLO cercanía 2 en el centro */
    int      tof_racha_nota;         /* 0 nada, 1 veto anotado, 2 confirmación anotada (para escribir SENS_DIAG una vez por racha) */
    int      override_largo_mm;      /* si > 0, largo forzado de la recta en mm (ej. 1500 mm) */

    /* J16: rumbo sostenido por el firmware (RUMBO) y vuelta a la línea mientras avanza (ver navegador_poner_rumbo_fw). */
    int      rumbo_fw;                /* 1 = el firmware sostiene el rumbo al avanzar (la app mandó RUMBO:ON y CAPS dijo RUMBO=1); por defecto 0 */
    int      rumbo_fw_pedir;          /* 1 = hay un objetivo nuevo que mandar (navegador_tomar_rumbo_fw) */
    int      rumbo_fw_objetivo_x10;   /* objetivo en la convención del firmware (+ izquierda, el ángulo de SENS) */
    int      rumbo_fw_enviado_x10;    /* el último que se mandó */
    int      rumbo_fw_hay_enviado;    /* 1 si en este avance ya se mandó uno */
    uint32_t rumbo_fw_t_ms;           /* hora del último envío */
    int      paso_en_linea;           /* 1 si el paso AVANZAR actual se planeó sobre la línea de la ruta (planificar con compensación); 0 = camino de celdas de respaldo */
    int      linea_ax_mm, linea_ay_mm, linea_rumbo;   /* la línea de ese avance: un punto (inicio del tramo) y su rumbo */
    int      linea_fin_s_mm;          /* dónde termina ese avance, medido a lo largo de la línea desde ese punto */
    int      paso_apunta;             /* 1 si ese avance va en diagonal hacia su punto de parada (planificar «apunta» tras un pivote grande) */
    int      paso_fin_x_mm, paso_fin_y_mm;   /* el punto donde termina ese avance */
    int      sin_volver_a_linea;      /* solo comparación de pruebas: el objetivo de RUMBO es el rumbo del tramo, sin la corrección lateral */
    int      rumbo_en_vuelta;         /* 1 = con RUMBO, en el avance de la vuelta a la línea también se apunta al punto planeado; 0 (por defecto) = solo se sostiene el rumbo del giro */
    int      sin_margen_paso_j16;     /* 1 = holgura de 100 mm al pasar el obstáculo (lo de antes); 0 (por defecto) = NAV_PASO_MARGEN_MM */
    int      sin_trig_fino;           /* solo comparación de pruebas: la pose medida usa grados enteros (lo de J15) */
    int      sin_arreglo_dt_giro;     /* solo comparación de pruebas: tras caer a giro por tiempo entre dos ticks, el tick siguiente cuenta su dt entero (lo de antes) */
    int      descartar_dt;            /* 1 = el siguiente tick no suma su dt al comando (el giro cayó a tiempo entre ticks: el carro estaba quieto) */

    /* Cola de líneas de diagnóstico (REINC_DIAG, ESQUIVE_DIAG, TURN_DIAG, RUTA_DIAG): ver navegador_diag_siguiente. */
    char diag[NAV_DIAG_LINEAS][NAV_DIAG_LARGO];
    int  diag_escritas, diag_leidas;
    int  diag_firma;             /* resumen de la última línea ESQUIVE_DIAG (para no repetirla en cada cuadro) */
    uint32_t diag_t_ms;
} Navegador;

/* ── Funciones ─────────────────────────────────────────────────────────── */

/* Deja el navegador en ESPERANDO, sin ruta. */
void navegador_iniciar(Navegador *nav);

/* Cambia la calibración del carro (por defecto se usa la de ejemplo de calibracion.h). Solo con el
 * navegador parado (ESPERANDO, TERMINADO o ERROR). Devuelve NAV_OK, NAV_ERR_ARGUMENTO (nula o no
 * válida) o NAV_ERR_ESTADO. Los pasos de una ruta ya cargada se calculan al comenzar, así que se
 * puede cambiar justo antes de navegador_comenzar. */
int navegador_poner_calibracion(Navegador *nav, const CalibracionCarro *cal);

/* Carga la ruta (lista de celdas contiguas, ver trayectoria.h). El carro se supone en el
 * primer punto mirando hacia ORIENTACION_INICIAL. Devuelve NAV_OK o un código de error. */
int navegador_cargar_ruta(Navegador *nav, const Punto *puntos, int n_puntos);

/* Empieza a seguir la ruta (o la retoma desde la posición estimada si se canceló antes).
 * Solo desde ESPERANDO. Una ruta de un solo punto termina de inmediato. */
int navegador_comenzar(Navegador *nav, uint32_t ahora_ms);

/* Cancela: STOP inmediato y vuelve a ESPERANDO (el siguiente tick devuelve STOP). */
void navegador_cancelar(Navegador *nav);

/* Una vuelta del cerebro. `ahora_ms` es un reloj en milisegundos (puede dar la vuelta a 32 bits).
 * `obs` es el resultado del último cuadro de obstaculos_analizar, o NULL si no hay cuadro
 * nuevo (entonces no cambia nada de lo que se sabe del obstáculo). Devuelve el comando
 * que el carro debe mantener hasta el siguiente tick. */
ComandoNav navegador_tick(Navegador *nav, uint32_t ahora_ms, const ResultadoObstaculos *obs);

/* Dice cuánto se atrasa la cámara (de 0 a 1000 ms): un cuadro que llega ahora muestra lo que pasó hace tanto. Con la cámara del
 * teléfono es ~0; con la cámara del carro por WiFi, ~300 ms. Así los cuadros que todavía muestran el carro sin girar no cuentan como
 * "cubiertos" y el pedazo de giro que la cámara aún no ve se completa por tiempo (el retraso queda compensado). Devuelve NAV_OK o
 * NAV_ERR_ARGUMENTO. */
int navegador_poner_latencia_visual(Navegador *nav, int ms);

/* Activa (1) o desactiva (0) el frenado desde lejos en el centro (ver NAV_MS_CONFIRMAR_CENTRO_LEJOS). Devuelve NAV_OK o NAV_ERR_ARGUMENTO. */
int navegador_poner_frenar_lejos_centro(Navegador *nav, int activo);

/* Le avisa al navegador cuánto vio girar la cámara entre dos cuadros consecutivos (movimiento_visual.c): `giro_grados_x10` es el
 * giro del carro por 10 (POSITIVO a la derecha), `dt_ms` el tiempo entre esos dos cuadros y `confiable` 1 si la cámara estaba segura.
 * Solo cuenta mientras el carro está girando (LEFT o RIGHT) y después del retardo de arranque (los cuadros durante el arranque se
 * ignoran: el carro todavía no se mueve). El giro se corta cuando la cámara ve el ángulo pedido (con el tiempo como respaldo). */
void navegador_aporte_visual(Navegador *nav, int giro_grados_x10, int dt_ms, int confiable);

/* 1 si el retroceso de los reintentos usa una calibración medida de verdad (CAL_MEDIDO_ATRAS); 0 si usa los ms por cm del avance (sin medir). */
int navegador_retroceso_calibrado(const Navegador *nav);

/* 1 = la ruta usa la cámara de obstáculos (la app la tiene abierta): el carro no se mueve hasta el primer cuadro y, si no llega en NAV_PRIMER_CUADRO_MAX_MS,
 * ERROR sin video (antes recorría la ruta entera a ciegas). 0 = sin cámara (fuente de botones y pruebas). Devuelve NAV_OK o NAV_ERR_ARGUMENTO. */
int navegador_poner_requiere_camara(Navegador *nav, int activo);

/* Activa (1) o desactiva (0) pedir ayuda en vez de dar ERROR cuando no puede esquivar (ver arriba, punto 7). Devuelve NAV_OK o NAV_ERR_ARGUMENTO. */
int navegador_poner_pedir_ayuda(Navegador *nav, int activo);

/* Enciende (1, por defecto) o apaga (0) la red de seguridad de la vuelta a la línea: tras cada tramo compara la pose estimada con la planeada y, si pasa de NAV_PLAN_ERROR_MM, vuelve a planear.
 * Apagarla sirve para ver en las pruebas qué aporta. Devuelve NAV_OK o NAV_ERR_ARGUMENTO. */
int navegador_poner_red_seguridad(Navegador *nav, int activo);

/* En AYUDA: el comando que el usuario quiere ahora (STOP, FORWARD, REVERSE, LEFT o RIGHT). Devuelve NAV_OK, NAV_ERR_ARGUMENTO o NAV_ERR_ESTADO (no está en AYUDA). */
int navegador_ayuda_comando(Navegador *nav, ComandoNav comando);

/* En AYUDA: el usuario terminó de maniobrar. El carro se queda quieto un momento, calcula con su posición estimada cómo volver a la línea (igual que tras esquivar) y sigue la ruta
 * (las esquivadas se cuentan de nuevo desde cero). Devuelve NAV_OK o NAV_ERR_ESTADO (no está en AYUDA). */
int navegador_ayuda_continuar(Navegador *nav, uint32_t ahora_ms);

/* GIROSCOPIO (J11). poner_giroscopio / poner_sensor_distancia encienden (1) o apagan (0) cada uno (por defecto apagados; sin láser no se autoriza esquive). Devuelven NAV_OK o NAV_ERR_ARGUMENTO.
 * navegador_tomar_giro_fw: si hay un giro por ángulo que todavía no se pidió al firmware devuelve 1 y deja en *grados_izq_positivo los grados con la convención del firmware (POSITIVO = izquierda)
 * para mandar GIRAR:<grados>; solo devuelve 1 una vez por giro. navegador_giro_fw_en_curso: 1 mientras el firmware hace el giro (la app NO manda LEFT ni RIGHT en ese tiempo).
 * navegador_aporte_giro: llegó la respuesta del firmware: `codigo` es NAV_GIRO_*, `real_x10_fw` los grados por 10 que giró (POSITIVO = izquierda) y `ms` lo que tardó.
 * navegador_aporte_sens: llegó un SENS del firmware (cada ~100 ms): distancia del láser, si el láser funciona y si la medida es válida (no «libre»).
 * navegador_aporte_tof_paro: el firmware frenó por algo muy cerca al frente (TOF_PARO:<mm>). */
int  navegador_poner_giroscopio(Navegador *nav, int activo);
int  navegador_poner_sensor_distancia(Navegador *nav, int activo);
int  navegador_poner_autoridad_laser(Navegador *nav, int activo);
/* V2: el menor giro (grados, de 1 a 10) que el firmware acepta en GIRAR (5 por defecto; el firmware con giro fino anuncia GMIN en CAPS). Con el giroscopio sano
 * un giro menor que esto ya no se hace por tiempo (un micro-giro de 4 grados por tiempo salió de 18 en el carro): lo absorbe RUMBO al avanzar. */
int  navegador_poner_giro_fw_min(Navegador *nav, int grados);

/* V2, PRECAUCIÓN («avanzar a ratos»: 700 ms de avance, 300 de pausa) cuando UNA sola fuente de visión ve algo y el láser no da eco:
 *   NAV_PRECAUCION_NUNCA (por defecto): nunca por una sola fuente. Una sola fuente de visión con el láser libre o sin eco no detiene al carro; lo de los lados lo
 *       resuelve el vistazo sin frenar. En el banco (SIMULADO) quitó de 500 a 1000 paradas por cada 300 corridas con manchas de sol, sombras o reflejos y no cambió
 *       el resultado del objeto bajo que ven las dos fuentes; el objeto bajo que SOLO ve el color (límite conocido) pasó de 273 a 267 de 300.
 *   NAV_PRECAUCION_COLOR_CERCA: solo si es el COLOR, en el centro y cerca (cercanía 2 o 3): ahí el láser ya está mirando y no ve nada, así que puede ser algo bajo.
 *   NAV_PRECAUCION_SIEMPRE: como la rama de partida (cualquier fuente, en cualquier zona).
 * Sin el rumbo del firmware (no hay vistazo) vale siempre NAV_PRECAUCION_SIEMPRE. Es configuración: no cambia al cargar otra ruta. */
/* V2, VISTAZO: cuántos vistazos se le dan a una misma cosa (navegador_poner_vistazo).
 *   NAV_VISTAZO_NO: ninguno (como la rama de partida).   NAV_VISTAZO_LEJOS: uno, al verla por primera vez (lejos).
 *   NAV_VISTAZO_LEJOS_Y_MEDIO: además otro cuando llega a cercanía 2.   NAV_VISTAZO_TODOS: además otro si ya está en cercanía 3. */
#define NAV_VISTAZO_NO             0
#define NAV_VISTAZO_LEJOS          1
#define NAV_VISTAZO_LEJOS_Y_MEDIO  2
#define NAV_VISTAZO_TODOS          3
#define NAV_VISTAZO_POR_DEFECTO    NAV_VISTAZO_LEJOS   /* en el banco (SIMULADO) los vistazos de cerca no confirmaron más y sí acercaron el carro a las patas de una silla */
int navegador_poner_vistazo(Navegador *nav, int modo);
#define NAV_PRECAUCION_NUNCA       0
#define NAV_PRECAUCION_COLOR_CERCA 1
#define NAV_PRECAUCION_SIEMPRE     2
/* COINCIDENCIA DE LAS DOS FUENTES (V2). Color y red en la misma zona confirman un obstáculo. Para que una caja inventada por la red que cae sobre una mancha de
 * color durante UN cuadro no haga esquivar:
 *  - FRENAR: hacen falta NAV_COINCIDENCIA_CUADROS_FRENAR cuadros seguidos, salvo en la zona CENTRAL con cercanía 3 (la banda más cercana), donde basta UNO: ahí
 *    cada cuadro de espera son hasta 6 cm de avance hacia algo que el láser, que mira justo ahí, no ve. (La revisión independiente encontró que el código pedía
 *    dos también en ese caso.) A los lados siguen siendo dos: lo de los lados lo confirma el vistazo con el láser, y una parada de un cuadro lo interrumpía.
 *  - ESQUIVAR sin láser que lo confirme: NAV_COINCIDENCIA_CUADROS_ESQUIVAR cuadros con coincidencia desde que el carro se detuvo; si la parada la provocó un solo
 *    cuadro, uno más y además NAV_COINCIDENCIA_ESQUIVAR_MS detenido (una caja inventada dura unas pocas inferencias; un objeto de verdad sigue ahí).
 *  - Mientras el carro rodea, vuelve a la línea o está detenido, la coincidencia vale desde el primer cuadro. */
#define NAV_COINCIDENCIA_CUADROS_ESQUIVAR 3
#define NAV_COINCIDENCIA_ESQUIVAR_MS    800   /* (revisión) si la parada la provocó un solo cuadro, además debe seguir habiendo coincidencia pasado este tiempo detenido */
#define NAV_COINCIDENCIA_CUADROS_FRENAR   2   /* cuadros SEGUIDOS con las dos fuentes en la misma zona para que cuente como obstáculo (en el centro con cercanía 3, uno) */
int navegador_poner_precaucion(Navegador *nav, int modo);
int  navegador_tomar_giro_fw(Navegador *nav, int *grados_izq_positivo);
int  navegador_giro_fw_en_curso(const Navegador *nav);
void navegador_aporte_giro(Navegador *nav, int codigo, int real_x10_fw, int ms, int ant, uint32_t ahora_ms);
void navegador_aporte_sens(Navegador *nav, int mm, int tof_vivo, int tof_valida, int angulo_x10_fw, uint32_t ahora_ms);
/* Igual, pero con el bit IMU lista de SENS: nunca integra un ángulo de IMU caída/calibrando. */
void navegador_aporte_sens_imu(Navegador *nav, int mm, int tof_vivo, int tof_valida, int angulo_x10_fw, int imu_lista, uint32_t ahora_ms);

/* MENSAJE DE GIRO PERDIDO (J12): si pasa la espera máxima sin GIRO_OK ni GIRO_TIMEOUT, antes de repetir el giro por tiempo el navegador pide IMU? (navegador_tomar_consulta_imu devuelve 1 una vez
 * para que la app lo mande) y compara el ángulo que contesta (navegador_aporte_imu, en grados por 10, + izquierda) con el del inicio del giro: si ya giró al menos NAV_GIRO_FW_YA_GIRO_PCT % de lo pedido NO
 * repite (usa lo medido como ángulo real); si no, repite por tiempo SOLO lo que falta. Sin respuesta del IMU? en NAV_GIRO_FW_CONSULTA_MS se usa el último SENS si es reciente. */
int  navegador_tomar_consulta_imu(Navegador *nav);
void navegador_aporte_imu(Navegador *nav, int angulo_x10_fw, uint32_t ahora_ms);
void navegador_aporte_tof_paro(Navegador *nav, int mm, uint32_t ahora_ms);

/* Saca la siguiente línea de diagnóstico que el navegador escribió y la copia a `texto` (capacidad `capacidad`, termina en '\0'). Devuelve 1 si había una
 * línea nueva y 0 si no. Las líneas empiezan con REINC_DIAG, ESQUIVE_DIAG, AYUDA_DIAG, TURN_DIAG o RUTA_DIAG (solo números y palabras; nada de imágenes). La app las llama después de cada tick
 * y las manda al log; si no se leen, las más viejas se pierden. */
int navegador_diag_siguiente(Navegador *nav, char *texto, int capacidad);

/* V2, CAJA NEGRA. Una línea compacta «CN ...» con el estado del navegador en este instante (solo números): estado, fases, comando, pose, láser, lo que ve cada
 * zona y con qué fuentes, vistazo, esquivadas, causa... La app la escribe en el archivo de la corrida después de cada tick. No cambia nada del navegador.
 * Devuelve el largo escrito (0 si no cupo nada). NAV_CAJA_NEGRA_MAX es la capacidad recomendada. */
#define NAV_CAJA_NEGRA_MAX 320
int navegador_caja_negra(const Navegador *nav, uint32_t ahora_ms, char *texto, int capacidad);

/* V2, SALUD DEL DETECTOR DE OBJETOS. La app dice en cada tick si la ruta CUENTA con la red (`requerido`: su interruptor está encendido) y si su último resultado
 * sigue vigente. Si se cuenta con ella y pasa NAV_MODELO_CAIDO_MS sin un resultado vigente, el carro se detiene y pide ayuda con la causa
 * NAV_CAUSA_SIN_PERCEPCION: antes la ruta seguía (y hasta cerraba «Terminado») con media percepción apagada y sin avisar. Mientras la red no está vigente,
 * los cuadros tampoco cuentan como «sin coincidencia» para dar un rodeo por terminado. Si nunca se llama, nada cambia. */
#define NAV_MODELO_CAIDO_MS 2500
void navegador_aporte_modelo(Navegador *nav, int requerido, int vigente, uint32_t ahora_ms);

/* Cuántos giros recuerda de la ruta en curso (de 0 a NAV_MAX_GIROS) y los datos del giro `indice` (0 = el primero). Devuelve NAV_OK o NAV_ERR_ARGUMENTO. */
int navegador_cuantos_giros(const Navegador *nav);
int navegador_giro_datos(const Navegador *nav, int indice, NavGiro *giro);

/* Fija el largo en mm para una recta predefinida (ej. 1500 mm para 150 cm). 0 = usa el largo de las celdas. */
void navegador_poner_largo_recta_mm(Navegador *nav, int mm);

/* RUMBO DEL FIRMWARE (J16). navegador_poner_rumbo_fw: 1 = el firmware sostiene el rumbo al avanzar (la app ya mandó RUMBO:ON porque CAPS dijo RUMBO=1 y el interruptor
 * está encendido); solo actúa con el giroscopio encendido. Por defecto 0: todo como antes. Devuelve NAV_OK o NAV_ERR_ARGUMENTO.
 * navegador_tomar_rumbo_fw: si hay un objetivo nuevo devuelve 1 una vez y lo deja en *objetivo_x10_fw (décimas de grado, convención del firmware: + izquierda, el mismo
 * ángulo que manda SENS) para que la app mande RUMBO:<n>. Llamarla después de cada tick. */
int  navegador_poner_rumbo_fw(Navegador *nav, int activo);
int  navegador_tomar_rumbo_fw(Navegador *nav, int *objetivo_x10_fw);

/* Texto para la pantalla de resultado: una línea por giro, «derecha: pedido 90°, hecho ~88°», lista para mostrar bajo el título «Giro pedido / Giro hecho (estimado)».
 * Devuelve el largo escrito (0 si no hubo giros). */
int navegador_texto_giros(const Navegador *nav, char *texto, int capacidad);

/* Frase que dice la causa concreta del ERROR, con los números (por ejemplo "se agotaron los 2 reintentos, el obstáculo seguía en el centro"). Sirve para
 * mostrarla en pantalla. Devuelve el largo escrito, o 0 si no hay error. */
int navegador_texto_error(const Navegador *nav, char *texto, int capacidad);

/* Texto del comando tal como lo entiende el firmware ("FORWARD", "STOP"...). */
const char *navegador_texto_comando(ComandoNav comando);

/* Texto del estado (para mostrar en pantalla o en los registros). */
const char *navegador_texto_estado(EstadoNav estado);

#ifdef __cplusplus
}
#endif

#endif /* NAVEGADOR_H */
