fernandosegrr/fsi_proyect/(commit log)

2026-10-10 Firmware del carro en C (carro.c) con .ino delgado, pruebas de PC y documentación
2026-10-10 Documentos de progreso y resumen de sesión
2026-10-10 Módulo de trayectoria en nucleo_c con calibración y pruebas
2026-10-10 README, caso de redondeo diagonal y resumen de sesión
2026-10-10 MAX_PASOS = 2 * MAX_PUNTOS y prueba de zigzag de 64 puntos
2026-10-10 App Android: esqueleto con cuadrícula, JNI en C y módulo de trayectoria; guía para el Huawei
2026-10-10 WiFi fuera de git (secretos.h) y original_backup solo local, antes de publicar
2026-10-10 Documentación del estado de la publicación y de la prueba en el teléfono
2026-10-10 Prueba de la app en el teléfono y estado de la publicación
2026-10-10 Bitácora: identidad de git local y reescritura de autores
2026-10-10 Resumen de sesión actualizado tras la publicación
2026-10-10 Documentación: aclarar que la publicación quedó resuelta y verificada
2026-10-10 Benchmark del detector de objetos en el Huawei (EfficientDet-Lite0 con TensorFlow Lite)
2026-10-10 Pantalla de control (WebSocket con OkHttp) y servidor falso del carro, probados en el Huawei
2026-10-10 Detector de obstáculos por color de piso en C, con puente JNI y benchmark en el Huawei
2026-10-10 Navegador del modo semiautónomo en C (sigue la ruta y esquiva obstáculos), con simulador, JNI y modo semiautónomo en la app
2026-10-10 Cámara del Huawei como fuente de obstáculos, pantalla de visión y umbrales ajustables en vivo (ConfigObstaculos)
2026-10-10 Detector de obstáculos: FILA_MINIMA ignora las filas lejanas (C, JNI, barra en la pantalla de visión)
    - ConfigObstaculos.fila_minima (por defecto 12 = mitad inferior, mismo comportamiento); fuera de 0 a 23 da OBS_ERR_CONFIG. La cercanía sigue saliendo de la fila más baja.
    - 20 pruebas nuevas (71 del detector).
    - JNI con 7 enteros; tercera barra en VisionActivity (SharedPreferences, también la usa el modo semiautónomo); filas ignoradas en gris y línea blanca en el límite.
    - Huawei: 25.0 fps y 6.50 ms por cuadro en 33 s sin errores.
    - Docs: obstaculos.md, vision_huawei.md (paso nuevo de inclinación y fila mínima), progreso, bitácora.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
    [obstaculos.c, obstaculos.h, pruebas_obstaculos.c]
2026-10-13 Cargar firmware por comandos (scripts/cargar.ps1) y guía de conexiones del carrito
    - scripts/cargar.ps1: baseline | nuevo | camara; detecta la placa por PSRAM (sonda mínima la primera vez), reintenta a menor velocidad, oculta contraseñas y escucha el puerto serie.
    - docs/hardware_cargar.md: uso, drivers y qué hacer si no entra en modo de carga.
    - docs/conexiones.md: pines GPIO -> TC1508A, alimentación, límites de corriente según la hoja de datos y orden seguro de conexión.
2026-10-13 Prueba de la cámara Freenove WROVER: mapa de pines, JPEG por software (GC0308), WiFi con IP fija y servidor HTTP
    - camara_prueba/: mapa WROVER_KIT (oficial Freenove) funciona; AI_THINKER falla; el sensor GC0308 no hace JPEG, se comprime por software.
    - docs/camara_prueba.md: mediciones (QVGA y VGA, WiFi, RSSI) y pasos para ver el video en el teléfono.
    - scripts/cargar.ps1: resume líneas repetidas del monitor serie.
2026-10-13 Cámara: tubería en dos núcleos, barrido de ajustes (reloj, formato, tamaño, calidad), /stats y edad del cuadro
    - Captura en el núcleo 0 y compresión+envío en el 1 con casilla única (sin acumular cuadros viejos).
    - QVGA 20 MHz RGB565 calidad 50 por defecto: 8,6 a 9,1 fps (antes 6,7) y edad ~250 ms.
    - /stats (JSON), números sobre el video, log de cada petición HTTP y autoprueba local.
    - docs/camara_prueba.md con el barrido completo y la prueba del cronómetro.
2026-10-13 Parte 1: detector de cualquier tamaño (HQVGA 240x176), antirrebote en milisegundos y latencia
    El detector acepta ancho y alto en cada llamada (30x30 a 640x480), la franja de referencia y la fila mínima son proporciones, el navegador confirma en ms (MS_CONFIRMAR_LEJOS 150), la cámara arranca en HQVGA, VisionActivity usa el tamaño de cada cuadro y se agrega docs/latencia.md.
2026-10-13 Parte 2: calibración del carro (arranque, avance, frenado y giro por lado) y asistente en la app
    calibracion.c con funciones puras probadas con datos simulados con ruido de ±10 %, el navegador usa la calibración medida (tramos continuos, frenado, arranque), asistente CalibracionActivity y docs/calibracion.md.
2026-10-13 Parte 3: piso con varios colores, aprendizaje continuo seguro y cambio de piso
    El detector aprende hasta 4 grupos de color del piso (baldosas, vetas), actualiza el modelo solo con el carro avanzando y sin obstáculos, reaprende si todo queda lejos 1 s y no da error si la franja se tapa; la señal de bordes queda apagada (empeora escenas sin objetos). Se revisa la regla de frenado del navegador. K y velocidad de aprendizaje en ConfigObstaculos y en la app.
    [navegador.c, navegador.h, obstaculos.c]
2026-10-13 Parte 4: fusión del detector de color con el modelo de objetos (modelo en su propio hilo)
    fusion.c: el detector manda en seguridad, el modelo sube lo que el detector duda o frena solo si está muy seguro, un objeto lejano solo avisa, el resultado del modelo caduca a 300 ms. El modelo EfficientDet corre en su propio hilo (máx. 10 por segundo). La pantalla de visión muestra quién decidió y los ms de cada etapa. Apagado por defecto hasta probarlo en el teléfono.
2026-10-14 Parte 5: giro medido con la cámara (movimiento visual) para corregir el giro por tiempo
    movimiento_visual.c estima el corrimiento horizontal entre cuadros con la huella de columnas de la mitad de arriba (subpíxel, sin confianza en escenas lisas o repetidas). El navegador corta el giro cuando la cámara ve el ángulo pedido (tiempo de respaldo, cuadros del arranque ignorados, compensación del retraso de la cámara). El campo de visión se calibra en CalibracionCarro y la app muestra el giro visual y tiene un paso opcional de calibración.
2026-10-14 Firmware nuevo: sin el aviso TWDT already initialized y responde PONG al PING
    El núcleo de Arduino-ESP32 3.x ya inicia el vigilante: se reconfigura en vez de iniciarlo otra vez (y ahora sí se aplican los 5000 ms). carro_respuesta (C puro, con pruebas) contesta PONG a PING sin tocar motores ni watchdog. Solo compilado: falta probarlo en la placa.
2026-10-14 Pantalla de visión: corrige el cierre al abrirla (botones buscados antes de usarse)
2026-10-14 Giro visual: conserva el cuadro de referencia al rechazar y acepta ambiguos por predicción; arregla cuadro plano (tablasListas)
    Con datos reales del Huawei el estimador sumó 36 grados en un giro de ~90 por perder los cuadros rechazados.
    Ahora la referencia se conserva (cuadros), las coincidencias ambiguas se aceptan si caen cerca del movimiento previo,
    y MV_SEGUNDO_MAX_PCT pasa a 88. También: bandera tablasListas (el convertidor sacaba un cuadro plano al no cambiar el tamaño).
    [movimiento_visual.c, movimiento_visual.h, pruebas_movimiento.c]
2026-10-14 Giro visual: campo de visión de la cámara calculado con focal y sensor (79 grados en el Huawei, no 60)
2026-10-14 Bitácora: firmware nuevo cargado en el DevKit (sin TWDT, watchdog 5000 ms)
2026-10-14 Bitácora: firmware de cámara cargado en la Freenove (HQVGA 12.4 fps)
2026-10-14 Bitácora: primera calibración real con el carro
2026-10-14 Firmware: ajuste de potencia por lado para ir recto (VELOCIDAD_IZQ/DER, sin cambio por defecto)
2026-10-14 App: lee el video de la cámara del carro (MJPEG) como fuente de cuadros; botón de fuente; latencia visual 320 ms
2026-10-14 Calibración: atajo para calibrar solo el giro con la cámara; bitácora con el hallazgo del giro rápido
2026-10-14 Navegador: pausa de 300 ms entre avanzar y girar para que cada movimiento arranque desde cero
2026-10-14 Firmware: VELOCIDAD_IZQ=248 para compensar el desvío a la derecha al avanzar
2026-10-14 Firmware: VELOCIDAD_IZQ=252 (interpolado entre +14.5 cm con 255 y -16 cm con 248)
2026-10-14 Firmware: arranque a plena potencia (250 ms) antes del ajuste por lado, para quitar el tirón a la izquierda
2026-10-14 Bitácora: recta de 150 cm con 3 cm de desvío
2026-10-14 Progreso: resumen de las pruebas con el hardware
2026-10-14 Estabilidad del video del carro y prueba de obstáculos con la cámara del carro
    - Firmware: canal WiFi fijo y sin ahorro de energía en las dos placas; /stats de la cámara con reconexiones y señal mínima de 10 s.
    - App: estadística del video (video_stats.c, log VIDEO_STATS, pantalla de visión), video vinculado a la red del carro con aviso si no lo es.
    - Navegador: vigilancia del video (hueco mayor a 500 ms: STOP y ERROR, no reanuda solo).
    - Prueba de obstáculos: log OBST_PRUEBA con tiempos y cm recorridos (prueba_obstaculo.c), ruta de prueba de 1 m, docs/prueba_obstaculos.md.
    - docs/latencia.md recalculado con 38 cm/s y 0.9 cm de frenado.
    - Modelo de objetos: confianza mínima 60 % y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
2026-10-14 Diagnóstico numérico del detector (deteccion| en el log) y bitácora de la prueba de video y falsos obstáculos
2026-10-14 Navegador: frenar desde lejos en el centro con el video del carro; diagnóstico de celdas; bitácora de la prueba con el termo
2026-10-14 Control: recuerda la fuente de obstáculos (cámara) y avisa si está en botones; bitácora de la prueba con la mochila
2026-10-14 Registro MODELO (mejor clase y porcentaje por segundo) y hallazgo: el modelo no reconoce el termo con esta cámara
2026-10-14 Progreso: estado final de la prueba de obstáculos con la cámara del carro y límite aceptado
2026-10-14 Esquivar objetos grandes con reintentos, retroceso calibrado y valores por defecto validados
    - navegador: tras cada giro de esquive MIRA con un cuadro posterior al giro (espera 300 ms + retraso del video); si el frente sigue muy cerca retrocede 15 cm (ciego, con tope de tiempo), gira 45 y luego 90 grados extra del mismo lado y vuelve a mirar; maximo 2 reintentos, luego ERROR y STOP.
    - navegador: elige el lado con menos celdas de obstaculo cuando los dos estan libres (empate: izquierda).
    - calibracion: ms por cm hacia atras opcional (bit 32, clave opcional del texto), paso 6 Retroceso en la app; sin medir usa el del avance y avisa.
    - detector: defectos validados en el carro (fila minima 440,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
    [CalibracionActivity.kt, calibracion.c, calibracion.h, navegador.c]
2026-10-14 Experimento de firmware: velocidad de crucero 210 despues del arranque a plena potencia
    VELOCIDAD_CRUCERO (210) sustituye a los 255 de avanzar y retroceder una vez pasado el arranque a plena potencia de 250 ms; los pivotes siguen a 255. PENDIENTE HARDWARE: comprobar que arranca, va recto y no se detiene; si funciona hay que recalibrar avance y frenado; si no, volver a 255. Incluye la bitacora y el progreso del trabajo de esquive.
2026-10-14 Prueba de obstaculo: la racha tambien cuenta cercania 1 al centro con el video del carro; bitacora del crucero 210
2026-10-14 Calibracion medida a 210: 51.7 ms/cm, frenado 1.4 cm, retroceso 44.4 ms/cm; recalcula los cm hasta frenar en docs/latencia.md
2026-10-14 Trabajo A: perfiles de velocidad MANUAL (255) y AUTO (210) con MODO_MANUAL/MODO_AUTO y sus ACK
    - firmware: PERFIL_MANUAL y PERFIL_AUTO en config.h; STOP primero si el perfil cambia en movimiento; AUTO al arrancar, reconectar y tras el watchdog.
    - app: ControlActivity abre en manual y muestra el perfil; las rutas esperan ACK_AUTO 1 s o no arrancan; calibracion siempre en AUTO.
    - pruebas de PC: firmware 87 casos, servidor falso 14. PENDIENTE HARDWARE: rectas de 150 cm en los dos perfiles.
2026-10-14 Trabajo B: corredor de trayectoria (huella del carro proyectada en la imagen), apagado por defecto
    - corredor.c/.h: perspectiva con enteros, DENTRO/BORDE/FUERA, interfaz comun CajaImagen para el detector, el modelo de objetos y el flujo.
    - navegador: zona_hay (elegir lado) separada de zona_frena (lo que frena); un obstaculo fuera del corredor solo avisa.
    - app: CorredorNativa, configuracion y controles en la pantalla de vision, OBST_PRUEBA ignora lo que queda fuera.
    - pruebas de PC: corredor 59 casos, navegador 143; las demas suites sin fallos. PENDIENTE HARDWARE: medir ancho, altura, inclinacion y campo de vision.
2026-10-14 Trabajo C: revision del esquive de objetos grandes (ya completo); bitacora
2026-10-14 Trabajo E: pisos negros y de 2 colores (brillo oscuro, tira ancha con apoyo minimo, reajuste de brillo, piso fijo), boton Aprender piso y registro PISO_DIAG
    - reproduccion en PC con cuadros sinteticos (pisos_sinteticos.c, pruebas_pisos_dificiles.c); hipotesis confirmadas y descartadas con numeros.
    - el detector nuevo no da falsos obstaculos en las escenas vacias; objetos en 5 pisos (peor caso: mano sobre baldosas beige 22/30).
    - app: Aprender piso en Vision y Control; la ruta lo exige o confirma el ultimo. PENDIENTE HARDWARE: casa y universidad.
2026-10-14 Quita dos ejecutables de prueba del repositorio y los agrega al .gitignore
2026-10-14 Trabajo F: modo cualquier objeto (filtros, persistencia, fusion el color manda), registro OBJ_ANY, benchmark Lite0/1/2 y analisis por umbral
2026-10-14 Trabajo G: flujo del piso (movimiento_piso.c), entrada opcional de la fusion, registro FLUJO_DIAG y pruebas con trazador de rayos
2026-10-14 Trabajos D e I: latencia del video (JPEG_MS, JPEGENC, TCP_NODELAY, cadena de 3 hilos, MODO_STATS) y modos de video raw y celdas por UDP con vuelta a jpeg
2026-10-14 Bitacora y progreso: resultado del trabajo H (rama de investigacion)
2026-10-15 Latencia: medida de compresion frame2jpg en HQVGA con la camara cargada
2026-10-15 Pantalla de control: el panel semiautonomo va dentro de un ScrollView para poder desplazarlo
2026-10-15 Bitacora: la configuracion guardada en el telefono anulaba los valores por defecto validados
2026-10-15 Bitacora: resultado de la prueba del termo y decision de dejar el resto de pruebas para el final
2026-10-15 Rediseno 1.2: quitar el nombre anterior del proyecto y cambiar el SSID por defecto a CarroFSI
    - scripts/buscar_nombre_anterior.py: busqueda sin distinguir mayusculas en todo el repo (excepto original_backup/): 0 referencias.
    - firmware_carro/pagina.h: capa visual nueva (colores de la app); el <script> queda identico. scripts/verificar_pagina.py + pagina.sha256 (se corre con make test en pruebas_firmware).
    - secretos.ejemplo.h de DevKit y camara: SSID CarroFSI (la clave real solo en secretos.h, ignorado por git).
    - Documentos y bitacora sin el nombre anterior.
2026-10-15 Rediseno 1.1: sistema de diseno (tokens con contraste comprobado, Inter, Material Symbols, componentes)
    - docs/diseno.md: colores, tipografia, forma y espacio, componentes, movimiento, iconos y lista de revision.
    - res/values y values-night: tokens de color (tema oscuro por defecto), dimens, estilos y tema Material 3.
    - scripts/contraste.py: todas las parejas texto/fondo pasan 4.5:1 en los dos temas.
    - Diseno.kt (ChipEstado, PuntoConexion, AvisoBanda, Haptica, Dialogos, Movimiento), Ajustes.kt, AppCarro.kt.
    - Dependencias Material Components, AppCompat, Fragment y ConstraintLayout; las pantallas pasan a AppCompatActivity.
    - Inter (OFL 1.1) y Material Symbols (Apache 2.0) con sus licencias en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
2026-10-15 Rediseno 2.4: sesion de video compartida (C con pruebas) y regla de latencia con video
    - nucleo_c/sesion_compartida.c: abrir, compartir, cerrar con gracia de 1.5 s, fallo y reintento (43 casos).
    - nucleo_c/latencia_video.c: si el PONG con video empeora mas de 30 ms, el video de Manual queda apagado por defecto (12 casos).
    - SesionVideo/SesionCarro: un solo VideoCarro y una sola conexion para toda la app; CamaraObstaculos entra a la sesion.
    - docs/manual_video.md: reglas, medida con la camara falsa y pasos PENDIENTE HARDWARE.
2026-10-15 Rediseno 2.1 a 2.3 y 2.5: navegacion con cabecera fija, Inicio, Manual con video y asistente de primera vez
    - MainActivity pasa a ser el armazon: cabecera fija (conexion, velocidad, bateria, PARO cuando una ruta mueve el carro), barra inferior (lateral en horizontal) y una pantalla por Fragment.
    - Inicio: estado en palabras, tarjetas del carro y de la camara, Conectar con mensajes de que paso y que hacer, accesos rapidos.
    - Manual: video con esquinas redondeadas y chips de retraso y fps, cruceta con PARO al centro (horizontal con un grupo de controles a cada lado), Ver deteccion solo con numeros, registro MANUAL_VIDEO.
    - Asistente de 3 pantallas (se puede saltar).
    - Tipografia Inter en archi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
    [textos_app.xml]
2026-10-15 Rediseno 3.1 y 3.2: editor de rutas y simulador de rutas sin el carro (C con pruebas y puente JNI)
    - nucleo_c/ruta_editor.c: agregar, mover, borrar, deshacer y rehacer, 4 plantillas, resumen (largo, tiempo con la calibracion, giros y advertencias) y guardar/abrir como texto (73 casos).
    - nucleo_c/sim_ruta.c: el navegador REAL con un carro virtual, obstaculos virtuales con un modelo aproximado de la camara, ruido de giro y dispersion (40 casos).
    - Puente JNI: RutaEditorNativa y SimRutaNativa.
2026-10-15 Rediseno 3.3: pantalla Rutas (editor, simulador animado, guardar/abrir) y Ejecutar ruta con historial
    - RutasFragment y EditorRutaView: cuadricula con escala en cm, puntos numerados, huella del carro, plantillas, deshacer y rehacer, resumen, obstaculos virtuales y ruido de +-20 grados.
    - AlmacenRutas: rutas con nombre, borrador automatico e historial de ejecuciones.
    - EjecutarRutaFragment: video compartido, estado en palabras, progreso por puntos, PARO, aprender piso, resumen y detalles tecnicos.
    - ruta_editor.c: un arrastre entero es un solo paso de deshacer (77 casos).
    - Se quita ControlActivity (la reemplazan Manual y Ejecutar ruta; la logica de ModoSemiautonomo no cambia). docs/rutas.md.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
2026-10-15 Rediseno 3.4: Mas con Ajustes, Ayuda, Acerca de y Prueba final (con la medida de latencia con y sin video)
    - Ajustes: red, velocidad en Manual, video en Manual, tema (oscuro, claro o sistema) y vibracion.
    - Ayuda: 10 preguntas frecuentes y que hacer si algo falla, con el asistente.
    - Acerca de: version y licencias, sin referencias al proyecto anterior.
    - Prueba final: lista guiada de las pruebas con el carro real y la medida del PONG con y sin video (regla de 30 ms).
2026-10-15 Rediseno 3.4: Vision y diagnostico con ajustes en Avanzado y Calibracion con una prueba por pantalla
    - Vision: video con chip de estado, tarjeta del detector y seccion Avanzado plegable con todos los ajustes finos y Restablecer.
    - Calibracion: Paso X de 9 con barra, ilustraciones dibujadas por codigo, instrucciones cortas y PARO fijo; usa la conexion compartida.
2026-10-15 Rediseno 3.5 y 3.6: mensajes claros, pruebas de pantallas, revision de diseno y documentacion
    - scripts/probar_pantallas.py: cada pantalla abre sin errores (vertical y horizontal) por registro; scripts/qa_captura.py para revisar el diseno.
    - docs/diseno.md con las decisiones de cada pantalla; bitacora y progreso al dia.
2026-10-15 Rediseno: cierre (bitacora y progreso, estado final del telefono y pendientes de hardware)
2026-10-16 Ajustes: guarda los tres trabajos (ajustes_1 a 3) y deja de versionar los .exe de pruebas
2026-10-16 Ajustes 1: volver a la linea despues de esquivar, simulador que llega y falso obstaculo al esquivar
    - Posicion estimada en cualquier rumbo (tabla de senos), no solo en multiplos de 45.
    - REINCORPORANDO nuevo: pasa el obstaculo en paralelo, calcula el punto de la linea 30 cm
    por delante, gira con el giro minimo, avanza, gira al rumbo de la ruta (pausas de 300 ms,
    nunca avanza sin reorientarse; menos de 8 cm de desvio: solo corrige el rumbo). Log REINC_DIAG.
    - Durante la esquivada se ignoran las detecciones al girar y hasta 2 cuadros o 150 ms despues;
    solo bloquea un obstaculo central de cercania 2 o 3 confirmado; reintentos de siempre; el
    error dice la causa concreta. Log ESQUIVE_DIAG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
    [navegador.c, navegador.h, pruebas_navegador.c]
2026-10-16 Ajustes 2: ajuste fino del giro de 90 grados (factor por lado y perfil) y simulador con el equilibrio de lados
    - calibracion.c: cal_factor_giro_nuevo, cal_con_factor_giro, opciones "se paso mucho / un poco /
    justo / se quedo corto"; cal_balance_nuevo (geometria de la recta, lo usa el bloque siguiente).
    - App: paso "Ajuste fino: giro de 90" en Calibracion (una prueba por pantalla), factor por lado y
    por perfil guardado aparte, "Restaurar valor por defecto"; navegador, simulador y la propia
    prueba usan la calibracion con el factor aplicado (CalibracionGuardada.leerAjustada).
    - Simulador: el carro virtual puede empujar mas de un lado (desbalance x balance) y se tuerce.
    - Revision del tiem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
2026-10-16 Ajustes 3 (parte 5): equilibrio de los lados en la recta, balance por perfil en el carro y calibracion "Recta"
    - Firmware: la potencia izquierda es tope x balance/1000 (800 a 1000, por perfil), guardada en la
    memoria no volatil (Preferences). Mensajes nuevos BAL_AUTO:NNN, BAL_MANUAL:NNN (ACK_BAL_*:NNN o
    NAK_BAL) y BAL?; los de siempre no cambian y la pagina web tampoco (su hash sigue igual).
    - ARRANQUE_ESCALONADO_MS en config.h (0 = apagado): primero un motor y el otro despues.
    - App: paso "Ajuste fino: recta" en Calibracion (Avanzar 2 s, hacia donde y cuantos cm, hasta 4 intentos,
    ancho entre ruedas configurable), el balance se manda al conectar y al cambiarlo, "Restaurar valor
    por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
2026-10-16 Ajustes 3 (parte 6): salir en 3 toques, plantillas En L e Ida y vuelta, Repetir la ultima ruta y cierre
    - Inicio: tarjeta "Salir rapido" (ultima ruta y 3 plantillas) -> Iniciar -> Confirmar y salir.
    - "Iniciar ruta" comprueba conexion y video, pide AUTO, aprende el piso (aviso "Despeja el frente
    del carro" si se ve muy variado) y queda en "Listo para salir"; cuenta 3, 2, 1. "Aprender piso"
    a mano pasa a Avanzado.
    - C: plantillas RE_PLANTILLA_L e IDA_VUELTA y re_celdas_de_plantilla con pruebas; la ruta que sale
    se guarda como la ultima. Prueba final con 9 pasos (ajuste fino y 3 toques).
    - Revisadas las pantallas en el Huawei (adb, camara falsa); bitacora, progreso y docs actualizados.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
2026-10-16 Recta: la prueba avanza 4 s (con 2 s el ruido de arranque era mayor que la meta de 1 cm)
2026-10-16 Toma el control: si no puede esquivar el carro pide ayuda (estado AYUDA, cruceta y continuar) en vez de dar ERROR
    [navegador.c, navegador.h, pruebas_navegador.c]
2026-10-16 Toma el control: si el carro ya paso del punto final al continuar, la ruta termina (no regresa hacia atras)
2026-10-16 Corrige caida de la app: el puente JNI no ponia en cero el resultado de obstaculos y el navegador leia filas fuera del arreglo
    [navegador.c, pruebas_navegador.c]
2026-10-16 Auditoria con los logs reales: paralelo, vuelta y arranque sin video corregidos
    - La cercania de salida es la mayor vista desde que se detuvo (antes la del ultimo cuadro: cercania_salida=1 y paralelo de 878 mm en la prueba real)
    - El paralelo no pasa del final del tramo recto (en Ida y vuelta seguia 55 cm fuera de la ruta)
    - Pausa de 300 ms entre avanzar de lado y enderezarse, y antes de retroceder desde el avance
    - Al enderezarse gira siempre hacia el lado contrario (tras dos reintentos los errores de giro se sumaban)
    - Tras toma el control, si no paso el obstaculo primero lo pasa en paralelo (antes volvia contra el: 5 ayudas seguidas)
    - Con camara no se mueve hasta el primer cuadro; sin cu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
    [calibracion.c, navegador.c, navegador.h, pruebas_navegador.c]
2026-10-16 J4: desplazamiento del centro al girar en el nucleo en C (modelo, simulador, TURN_DIAG, RUTA_DIAG)
    El carro (ruedas mecanum, giro con un solo lado) no gira sobre un punto fijo: en un giro el chasis
    se desplaza varios cm y el navegador, que suponia giro en el sitio, metia error de posicion en cada
    giro (un esquive tiene 3 o 4).
    - calibracion.c/.h: por lado de giro, cuatro valores en um por grado (adelante y derecha, en el marco
    del carro a mitad del giro), por defecto 0. Funciones para ponerlos, pasar una medida (marco inicial)
    a um por grado, promediar 2 repeticiones (rechaza si difieren mas de 30 %) y calcular cuanto se mueve
    el centro en un giro. Tambien: calibracion por partes (vel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
    [calibracion.c, calibracion.h, navegador.c, navegador.h, pruebas_calibracion.c]
2026-10-16 J5 (C): RUTA_DIAG por tramo y simulacion de la ruta de 40 cm a la derecha con 1 giro
    En la prueba real esa ruta giro bien 2 de 3 veces; una vez avanzo recto (probable contacto
    electrico intermitente, hardware). No se rediseña el navegador; solo se separa "el programa mando
    mal el comando" de "el comando fue correcto y el carro no lo hizo".
    - navegador.c: cuando la ruta sigue avanzando de un punto al siguiente sin parar, RUTA_DIAG cierra el
    registro del tramo que termino y abre el del tramo nuevo (antes quedaba un solo registro con los
    numeros del ultimo tramo).
    - pruebas_navegador.c: la ruta (2,8) -> (3,8) -> (4,8) manda RIGHT como primer comando en t = 0,
    900 ms (738 ms con 8.2 ms p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
    [navegador.c, navegador.h, pruebas_navegador.c]
2026-10-16 J4 y J5: Calibracion por partes, giro de prueba y prueba guiada del desplazamiento al girar
    Calibracion pasa de un asistente de una sola tirada a una LISTA de partes independientes. Cada tarjeta
    muestra el valor actual, la fecha y hora de la ultima calibracion, si depende de las pilas y el boton
    "Calibrar solo esto": arranque, velocidad de avance, frenado de avance, giro izquierda, giro derecha,
    retroceso, giro con la camara, desplazamiento al girar, ajuste fino del giro de 90 y ajuste fino de la
    recta. Cada prueba es independiente (no exige otra antes, no borra los otros valores y guarda al
    terminar; una prueba cancelada no cambia nada). Opcional: "Calibrar todo, en orden" con "Omitir esta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
2026-10-16 J4 y J5: correcciones de la revision de codigo, prueba del simulador de rutas con desplazamiento y documentacion
    - Calibracion: el resultado tiene "Atras" y salir pide confirmacion; "Borrar el ultimo dato / repetir"
    funciona en el desplazamiento; el giro con la camara se redibuja cuando la camara termina de abrir;
    cambiar el giro de prueba del desplazamiento borra los dos lados; un doble toque en "Listo" no se salta
    la parte siguiente de "Calibrar todo" y "Listo" con una repeticion a medias pregunta; "Restaurar valor
    por defecto" tambien borra la fecha; el aviso de ms por grado fuera de 3 a 20 dice si el valor malo es
    de esta prueba o ya estaba guardado.
    - Lint: un "%" suelto en un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
2026-10-16 Calibracion: correcciones de diseno tras revisarla en el telefono (textos cortados, selectores ocultos, boton tapado)
    Con la app instalada en el Huawei y el carro falso (sin usar el carro ni cargar firmware):
    - "MANUAL (255)", "90 real" y el boton de tres tiempos salian partidos y cortados: textos mas cortos y
    "Giro de 90 real" a todo el ancho con "180" y "Libre" debajo.
    - El perfil, el lado y el giro de prueba quedaban bajo la tarjeta de notas: ahora la tarjeta va debajo.
    - "Paso X de N" se partia en dos lineas junto al chip; la lista tenia un titulo repetido y avisos largos.
    - "Guardar esta repeticion" y el campo del resultado quedaban tapados por el panel de abajo (el
    desplazamiento a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
2026-10-16 Robustez: DHCP del DevKit de .10 a .20 y recuperacion de la camara (WiFi con espera creciente, vigilante, /stats)
2026-10-16 App: La camara no responde con la IP intentada y reintento cada 3 s; bitacora y progreso
    [textos_app.xml]
2026-10-16 Camara: no anotar como caida las desconexiones que pide el propio reintento; bitacora de la carga
2026-10-16 Calibracion: desplazamiento al girar con tolerancia 30 % o 1 cm, cuadro con motivo y tres opciones, marca de poca precision y TURN_DIAG de calibracion
2026-10-16 Giro de pivote: limite del desplazamiento de 2000 a 5000 um/grado (45 cm en 90), aviso de desplazamiento grande con el radio del arco, marco inicial probado y pose/esquive con 15 y 16.5 cm
2026-10-16 Modelo de pivote y plan con pivote: el centro gira alrededor del punto fijo del chasis, el esquive y la vuelta a la linea se planean con el desplazamiento de cada giro y una red de seguridad en lazo 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
    - calibracion: punto fijo sacado de la medida (desplazamiento y grados de la prueba), cuerdas 2R sen(theta/2) a cualquier angulo, modelo lineal en los casos limite, pose tras giro y su inversa, izquierda sin medir = espejo de la derecha
    - navegador y simulador usan el mismo modelo; giro hacia el objetivo por punto fijo o barrido, punto previo por la inversa, tramo de lado con margen lateral, otro lado o AYUDA si no cabe, red de seguridad (error > 8 cm o rumbo, max. 4)
    - app: angulo de la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
    [CalibracionActivity.kt, calibracion.c, calibracion.h, navegador.c, navegador.h, pruebas_calibracion.c]
2026-10-16 Diagnostico de la prueba real del 16 oct: la ruta daba media vuelta al final por un indice de punto vencido; arreglo con prueba que lo reproduce y log guardado
    - navegador: al terminar la vuelta a la linea se saltan los puntos de la ruta que el carro ya paso (reinc_saltar_puntos_pasados) y, si no queda ninguno, TERMINADO; antes la vuelta que solo corrige el rumbo dejaba el indice en el punto de antes del obstaculo y el carro recorria la ruta hacia atras
    - pruebas_final_de_ruta (4 casos nuevos): reproduce el final raro con la derecha sin medir como el telefono; falla sin el arreglo
    - docs/logs/prueba_2026-10-16.txt (148 KB, solo numeros) y diagnostico completo en docs/bitacora.md: falso posit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
    [navegador.c, navegador.h, pruebas_navegador.c]
2026-10-16 J9 (parte 1): mascara de artefactos de la vision, arranque con 4 cuadros y sondeo del obstaculo fijo, frenos anti-locura, cercania 3 con 2 cuadros, hueco de video de 700 ms y registro OBS_DIAG
    - mascara_vision.c/h: calcula la mascara de 10x10 con 3 lugares (artefacto = marcada en 80 % o mas en los tres), limites (20 %, nunca las 2 filas cercanas de las 2 columnas centrales), «depende del lugar», hexadecimal y cuadricula de numeros; el detector ignora las celdas enmascaradas
    - detector: la franja de referencia tapada mas del 30 % ya no reaprende ni agrega colores
    - navegador: al arrancar no decide con el primer cuadro (4 iguales), sondeo de 4 cm (sospechoso fijo o real), cercania 3 frena co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
2026-10-16 J9 (parte 2): Calibrar vision en la app, Restaurar por parte con confirmacion, copias y Deshacer, pruebas de arranque, sondeo y frenos, documentacion
    - app: tarjeta «Visión (artefactos fijos de la imagen)» (3 lugares, 20 cuadros, informe en numeros, fecha, Restaurar), JNI de la mascara y del ultimo cuadro para OBS_DIAG, la mascara guardada se aplica al abrir la camara y en las rutas
    - Restaurar por parte: el desplazamiento se restaura de UN lado, confirmacion que nombra lo que borra, copia de las ultimas 3 y Deshacer de 10 s (tambien para Borrar la calibracion)
    - navegador: arranque con 4 cuadros iguales solo si hay algo a la vista, sondeo de 4 cm, final de ruta con rumbo a 15 grados cuan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
2026-10-17 J10 calibracion: exportar los 6 campos desp_* con compatibilidad y aviso de lado sin medir
2026-10-17 J10 firmware: cola de comandos con portMUX y WS_EVT_DISCONNECT solo del cliente activo
2026-10-18 J11 fase A: giroscopio MPU6050, laser VL53L0X y giro por angulo en el firmware (codigo y pruebas de PC; hardware pendiente de cableado)
2026-10-18 J11 fase A: los dos modulos responden en el DevKit; reintentos del init del laser y diagnostico PINES?/PRUEBAI2C? por USB
2026-10-18 J11 fase B: giros por angulo del giroscopio, TOF_PARO y confirmacion del laser en el navegador, pantalla Sensores en la app, servidor falso con sensores, Monte Carlo con y sin giroscopio y guia de va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
2026-10-18 CI: ThreadSanitizer y AddressSanitizer/UBSan en Linux para el firmware y el navegador
2026-10-18 J11: resultado de los sanitizadores en Linux (sin errores)
2026-10-18 J11: pantalla Sensores revisada en el Huawei con el servidor falso (registro de pantalla abierta, textos que no se cortan)
2026-10-18 J11: primeros giros por angulo con el carro real (polaridad correcta, 6 giros; prueba cortada por un choque)
2026-10-18 J11: polaridad del giroscopio confirmada a ojo con el carro real
2026-10-18 J11: pantalla Sensores: el aviso de 'sin respuesta' ya no marca como fallida la prueba siguiente y el resultado va arriba de los botones
2026-10-18 J11: prueba 5 con el carro real (giros por tiempo y por angulo medidos por el giroscopio y 4 giros a la izquierda comprobados con cinta)
2026-10-18 J11: corregido el resultado con cinta: eran 4.5 cm y 5 cm de posicion, no grados; el angulo queda por medir
2026-10-18 J11: giro suelto a la derecha comprobado con cinta (92.7 contra ~92 grados; desplazamiento del pivote como en la calibracion)
2026-10-18 J12 fase 2: con el mensaje de un giro perdido el navegador pregunta IMU? y compara el angulo antes de repetir (no duplica el giro)
2026-10-18 J12 fase 3: el laser reintenta cada 5 s (solo con el carro quieto), cuenta los reintentos (CAPS TOFR), recuerda los ultimos 5 arranques (ARR?) y la pantalla Sensores avisa si mas de 1 de cada 5 neces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
2026-10-18 J12 fase 4: calibracion del giro con el giroscopio (6 giros que inicia el usuario, ms/grado y frenado con el angulo real, aviso si cambia mas de 10 %, Deshacer); pantalla nueva, nucleo calgiro.c con 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
2026-10-21 docs: resultados fisicos del 20 oct (J12) en validacion_sensores.md
    Firmware del DevKit estaba en J11 fase B y se recargo con el del HEAD (verificado con MD5 en el chip); la app ya era la del HEAD. Resultados medidos por el giroscopio y por la pantalla Sensores: giros por angulo (izq 11 de 12 a +-3, der 9 de 11 y 8 de los primeros 10), giros por tiempo con mucha variacion en los primeros giros tras un reposo, calibracion del giro con error 6 en las 3 corridas (no guardo nada), arranques del laser 0 de 5 y laser que ve el objeto al frente (410 mm) e ignora el lateral. Marca PASA, FALLA y NO MEDIDA, con causas probables y que prueba las confirmaria.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
2026-10-21 docs: el dueño confirma a ojo que el carro gira lo que marca el giroscopio
    Se anota en validacion_sensores.md (sin cuantificar, no se midio con cinta) y se aclara que el sobregiro de ~2 grados por giro a la derecha es real.
2026-10-21 docs: lecturas por USB del 20 oct (deriva, piso vacio, ANT?, LOOP?) en validacion_sensores.md
    Deriva 0.0 grados en 60 s y piso vacio 52 lecturas a 1200 mm sin falsos obstaculos (ambas PASAN). ANT?: 121,150,20,20, con la anticipacion AUTO derecha en el tope de 150 ms. LOOP?: 1797 us en reposo (no incluye movimiento). Se actualizan hallazgos y lo que falta por medir.
2026-10-21 docs: lectura del laser con la caja por USB (371 mm con la caja a ~35 cm estimados)
    Se anota que no es la prueba exacta de 30 cm (distancia estimada a ojo) y que falta medirla con regla desde la ventana del laser, ideal a 20, 30 y 40 cm.
2026-10-21 docs: el laser acierta a 37 cm (371 mm, +1 mm) segun el dueño
    Se corrige la distancia de la caja a 37 cm (la estimacion anterior era a ojo): el laser mide 371 mm en promedio de 152 lecturas. Ya no hace falta suponer un desfase del sensor.
2026-10-21 J13 fase 1: calibracion robusta con calentamiento y pares de diagnostico
2026-10-21 J13 fase 2: anticipacion AUTO de 100 ms, tope 250 y medida completa de inercia
2026-10-21 J13 fase 4: versiones verificables y camara de prueba temporal
2026-10-21 J13 fase 5: autoridad laser opcional en carril central sin cambiar modo apagado
2026-10-21 docs J13: carga verificada, APK pendiente por PIN y cierre con reset sostenido
2026-10-22 docs J13: pruebas fisicas con movimiento (24 giros de 90 grados; calibracion no ejecutada por seguridad)
2026-10-22 docs J13: lectura USB tras los giros (ANT 126,189; pico de LOOP es de arranque)
2026-10-22 docs J13: LOOP con el carro en el aire (pico de 8 ms con app conectada; giro derecho rotó 71 grados y se abortó)
2026-10-22 docs J13: LOOP con el carro en el piso por USB (giro 4 atascado, abortado)
2026-10-22 docs J13: segundo intento en piso; ANT derecha contaminado por sujetar el carro (189 a 144)
2026-10-22 J14 fase A1: calibración de giro en bloques del mismo lado
2026-10-22 J14 fase A2: ANT no aprende de giros inválidos y se registra en TURN_DIAG
2026-10-22 J14 fase A3: pantalla Sensores estable y contentDescription para automatización adb
2026-10-22 J14 fase A4: documentar mediciones de loop del firmware de J13 en limites conocidos
2026-10-22 J14 fase A5: corregir regla J10c de segundo color de piso para obstaculo ancho
2026-10-22 J14 fase A6: encender modelo de objetos por defecto con fallback a detector de color
2026-10-22 A7-A8: rutas de prueba predefinidas y configuracion de autoridad laser
2026-10-22 J14 fase A9: carga de firmware y APK en HEAD y verificacion sin movimiento
2026-10-27 J14 A3: fijar altura del resultado de sensores
2026-10-27 J14 A6: capturar fallo al cargar el modelo
2026-10-27 J14 A5: precisar límite del aprendizaje de piso
2026-10-27 J14 A2: registrar anticipación en la app
2026-10-27 J14 etapa 3: guía de conexión y parada
2026-10-27 J14 B1: registrar bloques de giros derechos
2026-10-27 J14 B2: registrar impedimento de vigilancia de giro
2026-10-27 J14 B3: registrar giros de verificación
2026-10-27 J14: cierre de pruebas fisicas y valores finales
2026-10-27 J14: comprimir bibliotecas nativas para que el APK quede bajo 15 MB
2026-10-27 J14: actualizar texto de la autoridad del laser
2026-10-27 J14: preparar dist y aceptar artefactos de entrega en el verificador
2026-10-27 J14: actualizar estado y entrega en el README
2026-10-28 J15 fase 3: preparar APK y guia para conexion 1B
2026-10-28 docs: agregar referencia tecnica de las ocho areas
2026-10-28 docs: registrar lista de fotos pendientes y catalogo de imagenes
2026-10-28 docs: completar documentacion en el repositorio, tematicos y codigo
2026-10-28 docs: integrar fotos del carro, capturas de la app, licencia MIT y nombres del equipo
2026-10-28 docs: corregir pies de foto, quitar huecos de maquetacion y unificar estado de imagenes
2026-10-28 Documentar el carro y actualizar la titularidad de la licencia
2026-10-28 Hacer reproducible la generación de figuras
2026-10-28 Organizar las tablas de consulta en los anexos
2026-10-28 docs: actualizar PDF con referencia de archivos
2026-10-31 J16: precisión de navegación (RUMBO en firmware, núcleo, app y simulador)
    Firmware:
    - rumbo.c/.h: control PI del rumbo al avanzar con el giroscopio (RUMBO:ON/OFF/<n>/RUMBO?),
    apagado al arrancar y al (re)conectarse; CAPS anuncia RUMBO=1. Sin RUMBO:ON el avance es
    exactamente el de antes. No renueva el watchdog ni cambia el comando actual.
    - giro.c: el filtro giro_largo compara ms por cada 100 grados y solo con giros de 30 o más
    (antes, tras tres giros chicos, la anticipación dejaba de aprender). Bandera GIRO_LARGO_POR_GRADO.
    Núcleo:
    - Objetivos de RUMBO: sobre la línea apunta a un punto 40 cm adelante, al volver tras esquivar
    sostiene el rumbo del giro, en paralelo el de la l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
2026-10-31 J16: entrega del candidato (APK en dist), plan de pruebas y documentación
    - dist/: APK APP:0.4-d823a63 (14,508,012 bytes, SHA-256 76DB8486...484D) compilada con build
    limpio desde d823a63; reemplaza a la de J15 (queda en el historial). El firmware
    FW:d823a63-20261031 se compiló en la PC y NO se publica ni se cargó.
    - docs/reporte_J16.md, docs/precision/plan_pruebas.md, docs/precision/simulador.md, resultados de
    Monte Carlo (1000 corridas) y de la calibración contra B4/B6.
    - Corrección: los «20 a 24 cm» de la ruta en L de J14 no eran una medición (la línea final está en
    y = 200 mm); notas en reporte J14, validación, progreso, bitácora y límites.
    - Límites J16, progreso_J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
2026-10-31 J16: registrar sanitizadores en verde y límite del objetivo de RUMBO
2026-10-31 J16: segunda ronda (rumbo con décimas, aviso WD, enlace mudo, TOF_PARO, candado)
    Núcleo: con RUMBO la pose lleva el rumbo en décimas (rumbo_x10) entre
    comandos; antes cada plan nuevo empezaba con grados enteros. Sin RUMBO
    queda como J15. Banco J16: propiedades B6 a B8. Monte Carlo de 1000
    corridas regenerado (solo cambia la configuración con RUMBO). SIMULADO.
    Firmware: el watchdog cuenta sus frenos y sensores.c avisa WD:<n>.
    Pruebas del aviso (6 casos). Prueba de estrés de 2 hilos arreglada:
    esperaba 500 ms el aviso del último giro (el asentado dura 750) y en
    «paso a paso» el productor colaba varias órdenes en una vuelta y se
    tiraba algún GIRO_OK de la cola de salida.
    App: TOF_PA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
    [carro.c, carro.h]
2026-10-31 J16: entrega de la segunda ronda (APK 097008d en dist, reporte y plan)
    dist/: APK APP:0.4-097008d (build limpio desde 097008d, 14,511,016
    bytes) en lugar de la d823a63 (queda en el historial), SHA256SUMS,
    LEEME, README y FIRMWARE_LOCAL. El firmware FW:097008d-20261031 se
    compiló en la PC y no se publica (contiene la contraseña del WiFi).
    Docs: sección 7 del reporte J16, plan de pruebas con las cifras
    nuevas de la simulación y las pruebas P11/P12, progreso, bitácora y
    README. Todo SIMULADO o revisado en el código: NO MEDIDO en el carro.
2026-10-31 J16: registrar el CI en verde de la segunda ronda
2026-10-31 J16: corrección de escala del giroscopio (IMU_ESCALA)
    Firmware: imu.c multiplica la velocidad medida por la corrección en
    partes por millón (0 = lo de siempre, idéntico); IMU_ESCALA:<ppm> la
    guarda en la memoria no volátil (solo con el carro detenido) e
    IMU_ESCALA? la informa; CAPS la anuncia como IMUS=<ppm>. 25 pruebas.
    Núcleo: calgiro_escala calcula la corrección con vueltas completas
    alineadas con una línea (compuesta con la que ya había). 11 pruebas,
    una propiedad de 20000 casos. Simulador: escala en partes por millón
    (los resultados de siempre salen idénticos) y configuración nueva en
    el banco con un residuo SUPUESTO de ±0.3 %: giro de 180° 41/88/139 a
    35/68/100 mm (media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
2026-10-31 J16: entrega de la tercera ronda (APK 873bfb9 en dist, reporte y plan)
    dist/: APK APP:0.4-873bfb9 (build limpio desde 873bfb9, 14,520,520
    bytes) en lugar de la 097008d (queda en el historial), SHA256SUMS,
    LEEME, README y FIRMWARE_LOCAL. El firmware FW:873bfb9-20261031 se
    Docs: sección 8 del reporte J16 (escala del giroscopio), prueba P6
    del plan con la medición de la escala, progreso, bitácora y README.
    SIMULADO o revisado en el código: NO MEDIDO en el carro.
    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
2026-10-31 J16: registrar el CI en verde de la tercera ronda
2026-11-11 J16: publicar APK 6d1b213 y registrar validacion del esquive B6 en el carro
    [pruebas_fisicas_20261110.csv]
2026-11-11 docs: actualizar README, docs/README, docs/entrega y progreso final para v1.1
2026-11-12 Exigir laser confirmado y verificar rebase antes de terminar rutas
2026-11-13 fix: recuperar autonomia con fusion por zona y rebase iterativo
    [comparar_esquives.py, fusion.c, fusion.h, navegador.c]
2026-11-13 fix: normalizar registros Monte Carlo en Windows
    [comparar_esquives.py]
2026-11-14 banco: mundo sintetico realista y compuertas del modo autonomo v2
    SIMULADO / NO MEDIDO en el carro. Infraestructura de medicion, sin cambios de
    comportamiento en el nucleo, la app ni el firmware.
    - nucleo_c/mundo_v2: mundo geometrico para el banco (prismas, piso de losetas
    con juntas, manchas de sol, sombras, reflejo de ventana, exposicion y balance
    de blancos automaticos, camara de celdas 24x17, laser de cono con senal por
    cobertura y reflectancia, detector neuronal estadistico, contacto del chasis).
    - nucleo_c/pruebas_autonomo_v2: 21 escenarios con el navegador, la fusion y el
    clasificador de color reales; metricas de exito, contactos, AYUDA con causa,
    Terminado falso, paradas,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
2026-11-14 navegador v2: rodeo medido con el laser, mirada antes de entrar y vistazo lateral
    Todo lo que sigue esta medido solo en simulador (SIMULADO / NO MEDIDO en el carro).
    Rodeo
    - El primer giro del rodeo barre con el laser (angulo y distancia de cada SENS): mide el
    ancho del obstaculo, ve una pared lateral y distingue un objeto que termina de una
    pared. Si un lado esta cerrado mide el otro girando en el mismo sentido; si los dos lo
    estan pide ayuda con causa 16 (frente ancho) sin haberse acercado.
    - Paso en paralelo: avanza una pista calculada con el campo de la camara desde el ultimo
    punto en que el costado pudo estar a la vista, sostiene el carril con el rumbo del
    firmware y va paral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
2026-11-14 firmware del carro: SEG=2 (desconocidos sin efecto, FORWARD bloqueado, freno rearmado)
    Solo compilado; no se grabo en la placa. Compatible con la app v1.1.
    - Un texto desconocido (o vacio) ya no renueva el watchdog ni queda como comando actual.
    Antes un cliente que probara un comando nuevo dejaba el carro avanzando sin latido,
    con el freno laser desarmado y sin control de rumbo. Se cuenta (carro_desconocidos).
    - FORWARD en perfil AUTO con el frente confirmado a menos de TOF_BLOQUEO_MM (150 mm) no
    arranca los motores: contesta TOF_PARO:<mm>, igual que el freno. Antes cada reintento
    daba un pulso a plena potencia contra el obstaculo. Retroceder, girar y el perfil
    MANUAL no se bloque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
2026-11-14 caja negra por corrida, telemetria numerica de vision y salud del detector
    Solo compilado (APK de depuracion); no se instalo en el telefono.
    - nucleo_c/vision_tele: resume cada cuadro en numeros, sin guardar ninguna imagen:
    histograma de distancias de color al piso aprendido, media y percentiles, brillo,
    celdas quemadas o negras, celdas no piso por zona, banda y fila, y los grupos de color
    del piso. Con sus pruebas (cuadros sinteticos).
    - navegador_caja_negra: una linea compacta con el estado del navegador en cada tick.
    - navegador_aporte_modelo: si la ruta cuenta con el detector de objetos y pasa 2.5 s sin
    un resultado vigente, el carro se detiene y pide ayuda con la causa 17. Ante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
2026-11-14 firmware de la camara: telemetria fotometrica en /stats y autoprueba apagada
    Solo compilado; no se grabo en la placa. Compatible con la app v1.1 (claves nuevas al
    final del JSON de /stats; nada mas cambia).
    - /stats anuncia "fw":"cam-v2", "caps":["foto"] y "foto":{...}: la media de rojo, verde
    y azul de todo el cuadro y de su mitad de abajo (el piso) y las milesimas de muestras
    quemadas y oscuras. Se mide cada 500 ms saltando de 8 en 8 pixeles; no sale ninguna
    imagen. Sirve para ver, sin fotos, si la camara cambio su exposicion o su balance de
    blancos entre Aprender piso y la ruta.
    - AUTOPRUEBA queda en 0 por defecto: encendida, un minuto despues de cada arranque
    pedia size=qvga y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
2026-11-14 docs: diseno, limites, estado y protocolo de prueba fisica del autonomo v2
    - docs/autonomo_v2_diseno.md: que se hizo, que quedo a medias y que quedo en papel de
    cada idea del encargo, con parametros, banderas, formato de la caja negra, tabla de
    las tres versiones por escenario y las compuertas que no se cumplen.
    - docs/limites_conocidos.md: reescrito para la rama (causas 16 y 17, rodeo medido,
    cierre, lo que el simulador ya dice que no se cumple).
    - docs/estado_20261113.md: commits, verificacion de software y pendientes.
    - docs/protocolo_prueba_fisica_autonomo_v2.md y docs/pruebas_fisicas_plantilla.csv:
    sesion ordenada de menor a mayor riesgo, con criterios de aceptacion y de abortar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
    [pruebas_fisicas_plantilla.csv]
2026-11-14 navegador y firmware: correcciones de la revision independiente (en curso)
    Revision independiente del diff de seguridad (subagente, solo lectura): sin criticos,
    2 altos, 3 medios, 3 bajos. Corregido en este commit:
    - ALTO 1: el cambio de lado (vuelta completa) solo se da si lo medido queda fuera del
    disco que barre el chasis, la camara veia libre el otro lado y hay camino recien
    pisado detras; guardia del laser durante el primer giro y la vuelta (causa 18).
    - ALTO 2: el paso en paralelo y sus alargamientos no pasan del final de la recta;
    tope a los planes de pasar primero que no avanzan; por dentro de una esquina no se
    alarga con la cuenta de otro tramo; el tope del primer giro del r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
2026-11-14 docs: resultados y limites tras la revision independiente (14-nov)
    - docs/precision: Monte Carlo de las tres versiones (v1.1, 6bea71e, actual) repetido
    con el codigo de 3bd9100, 1000 corridas por escenario, 23 escenarios (dos nuevos:
    caja y pared al lado, caja antes de esquina). 16 escenarios en 1000 de 1000 sin
    contactos; 19 compuertas siguen en rojo y se listan sin relajar ninguna.
    - Diseno: seccion 2.9 con los hallazgos de la revision y su correccion; cambio de
    lado con sus condiciones, guardia del giro (causa 18), paso en paralelo que no pasa
    del final de la recta, coincidencia desde el primer cuadro en el centro, rodeo
    decidido tras retroceder; tabla por escenario y compuert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
    [pruebas_fisicas_plantilla.csv]
2026-11-14 manual: PDF regenerado con el contenido de cb360c8
    57 paginas, 3.76 MB. La portada dice feat/autonomo-v2, contenido del commit cb360c8
    (SIMULADO; pendiente de validacion fisica). Las figuras no cambian.
